funkobongrip/sprbms/hardware/can/canSlaveV05b.brd

## EAGLE design hardware/can/canSlaveV05b.brd (2016-02-18)

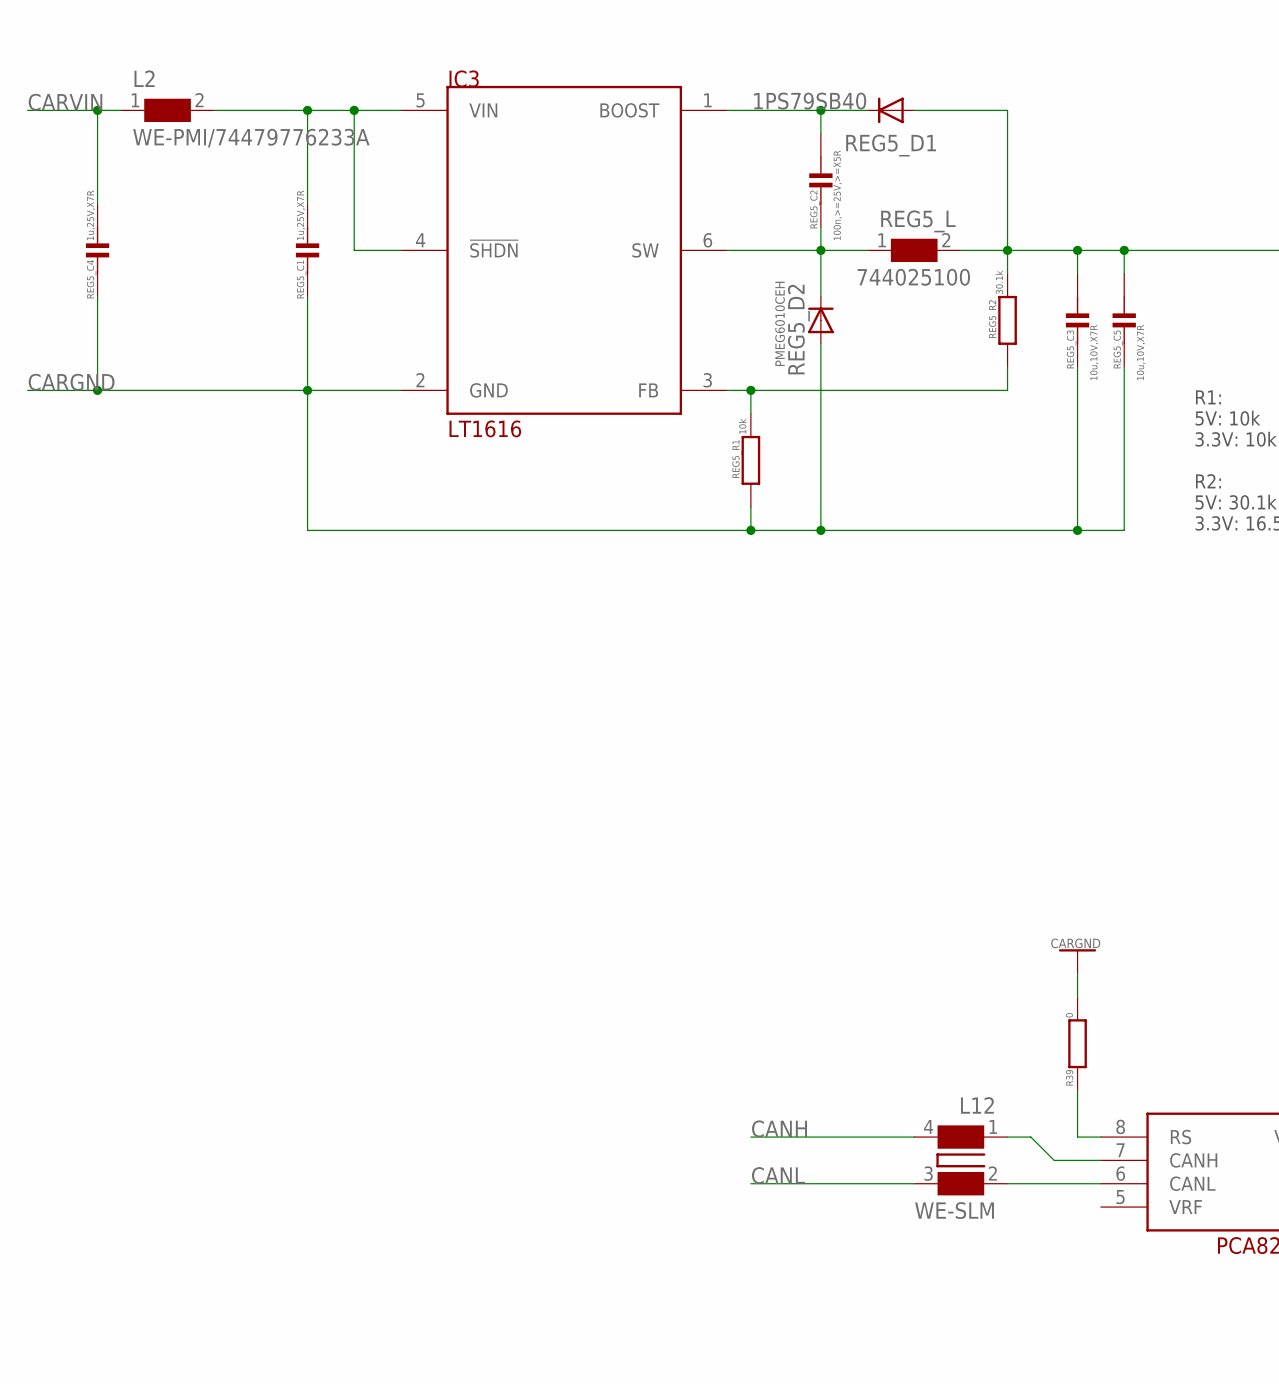
[picture p41: schematic canSlaveV05b.sch, sheet 1, part in row 1, column 1]

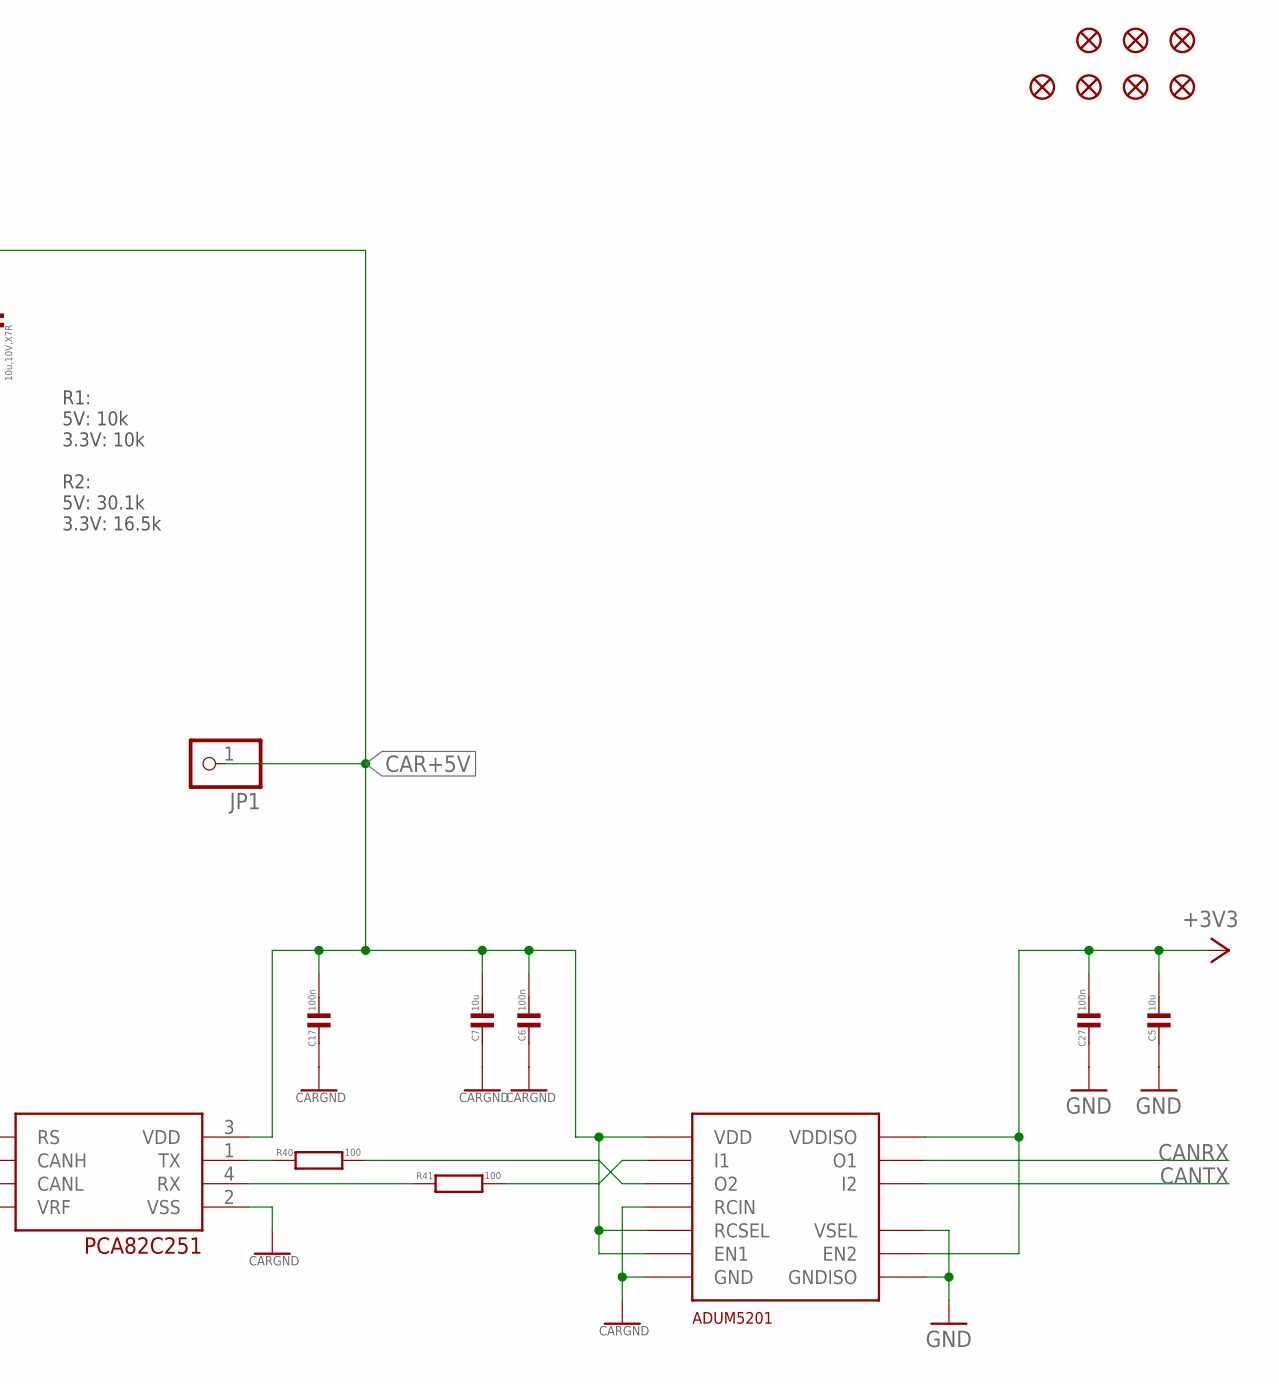
[picture p42: schematic canSlaveV05b.sch, sheet 1, part in row 1, column 2]

Parts:
C5, C7: 10u; C0603
C6, C17, C27: 100n; C0402
FID2, FID3, FID4, FID7, FID8, FID9, FID10: FIDUCIAL""; FIDUCIAL_1MM
IC3: LT1616; SOT23-6
IC5: PCA82C251; SO-8
JP1: PINHD-1X1; 1X01
L2: WE-PMI/74479776233A; WE-PMI_0806
L12: WE-SLM
R39: 0; R0402
R40, R41: 100; R0402
REG5_C1, REG5_C4: 1u,25V,X7R; C0805
REG5_C2: 100n,>=25V,>=X5R; C0402
REG5_C3, REG5_C5: 10u,10V,X7R; C0805
REG5_D1: 1PS79SB40; SOD523
REG5_D2: PMEG6010CEH; SOD123
REG5_L: 744025100; WE-TPC_2828
REG5_R1: 10k; R0402
REG5_R2: 30.1k; R0402
U$2: ADUM5201; SO16WB

Connections:
+3V3: C5.1, C27.1, U$2.P$10 (EN2), U$2.P$16 (VDDISO); also elsewhere on the board
BOOST1: IC3.1 (BOOST), REG5_C2.1, REG5_D1.C
CANH: L12.4; also elsewhere on the board
CANL: L12.3 (2); also elsewhere on the board
CANRX: U$2.P$14 (O1); also elsewhere on the board
CANTX: U$2.P$13 (I2); also elsewhere on the board
CAR+5V: C6.1, C7.1, C17.1, IC5.3 (VDD), JP1.1, REG5_C3.1, REG5_C5.1, REG5_D1.A, REG5_L.2, REG5_R2.2, U$2.P$1 (VDD), U$2.P$6 (RCSEL), U$2.P$7 (EN1)
CARGND: C6.2, C7.2, C17.2, IC3.2 (GND), IC5.2 (VSS), R39.2, REG5_C1.2, REG5_C3.2, REG5_C4.2, REG5_C5.2, REG5_D2.2 (A), REG5_R1.1, U$2.P$2 (GND), U$2.P$5 (RCIN), U$2.P$8 (GND); also elsewhere on the board
CARVIN: L2.1, REG5_C4.1; also elsewhere on the board
CARVINFILT: IC3.4 (!SHDN), IC3.5 (VIN), L2.2, REG5_C1.1
CAR_CANRX: R41.2, U$2.P$3 (I1)
CAR_CANRX_T: IC5.4 (RX), R41.1
CAR_CANTX: R40.2, U$2.P$4 (O2)
CAR_CANTX_T: IC5.1 (TX), R40.1
FB1: IC3.3 (FB), REG5_R1.2, REG5_R2.1
GND: C5.2, C27.2, U$2.P$9 (GNDISO), U$2.P$11 (VSEL), U$2.P$15 (GNDISO); also elsewhere on the board
unnamed: IC5.7 (CANH), L12.1 (3)
unnamed: IC5.6 (CANL), L12.2 (1)
RS1: IC5.8 (RS), R39.1
SW1: IC3.6 (SW), REG5_C2.2, REG5_D2.1 (C), REG5_L.1

Notes on the sheet:
R1: 5V: 10k 3.3V: 10k R2: 5V: 30.1k 3.3V: 16.5k

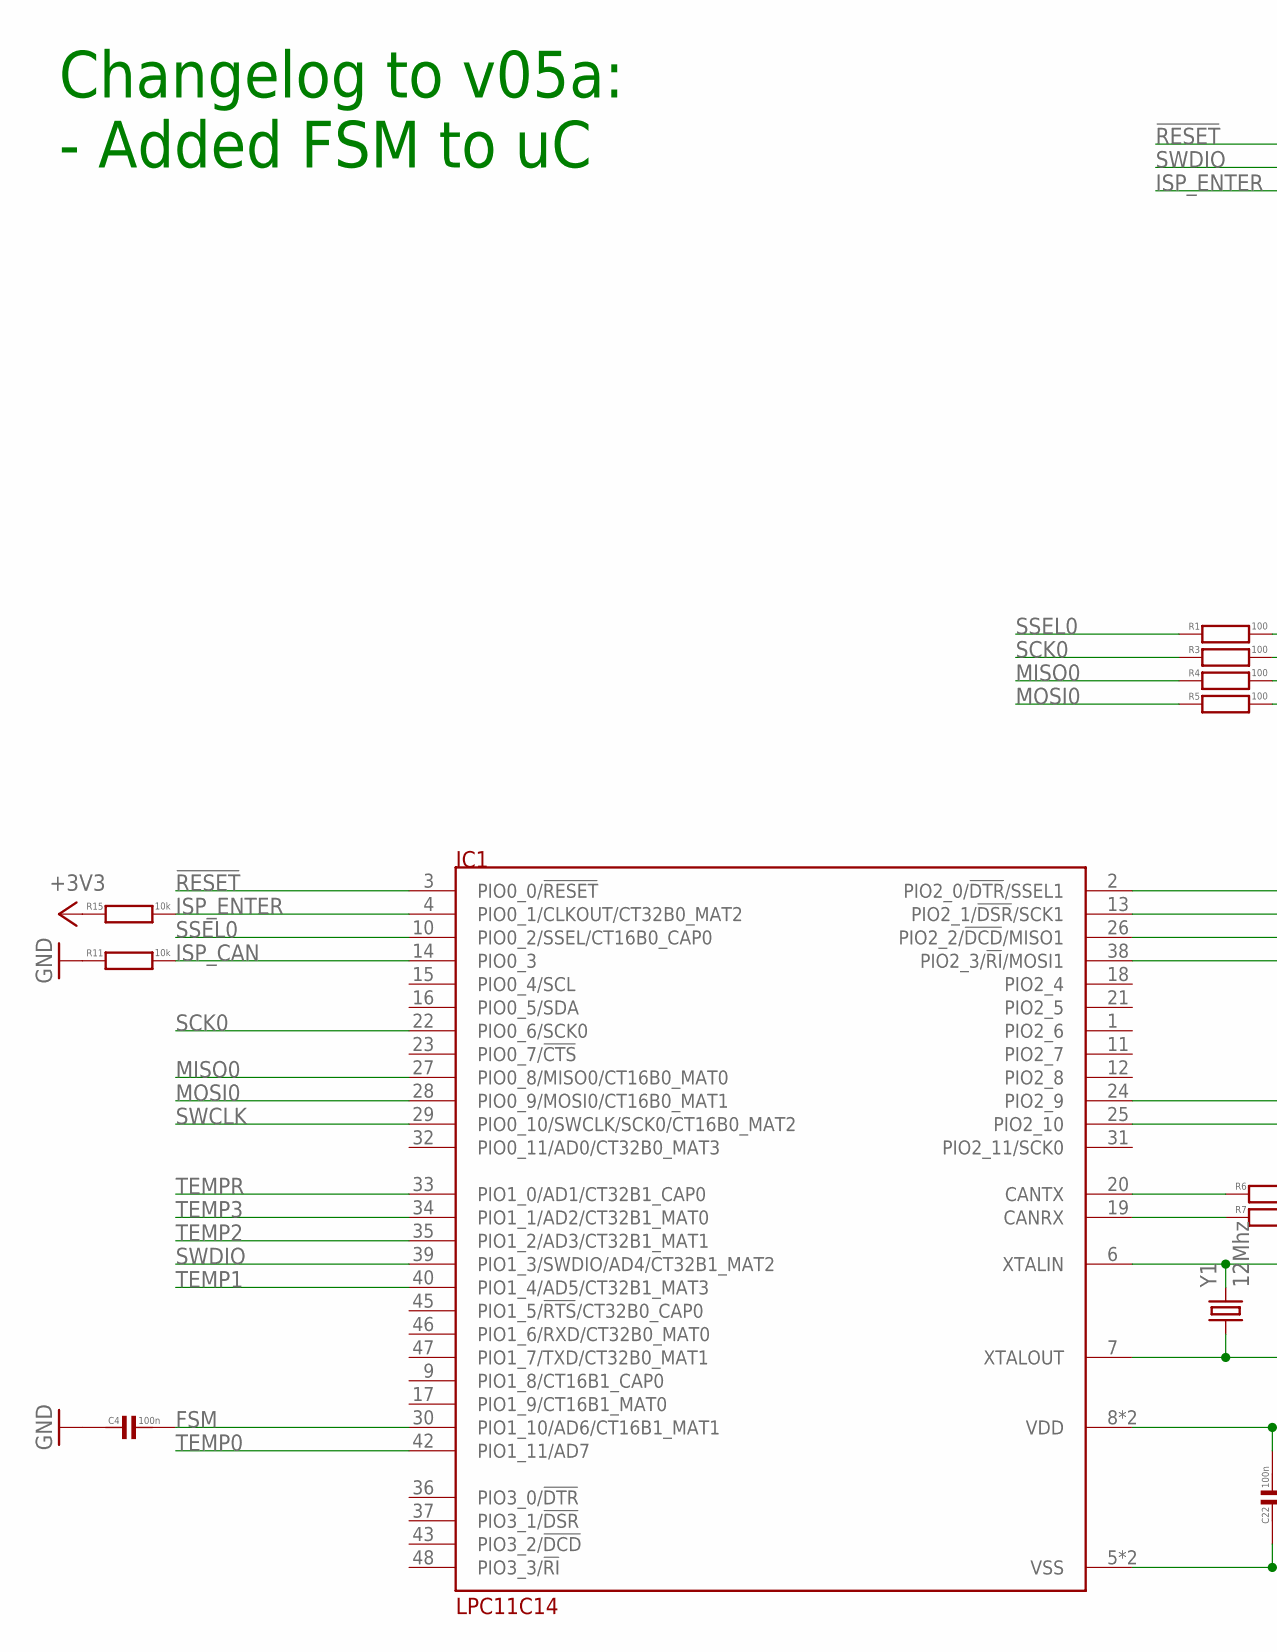
[picture p43: schematic canSlaveV05b.sch, sheet 2, part in row 1, column 1]

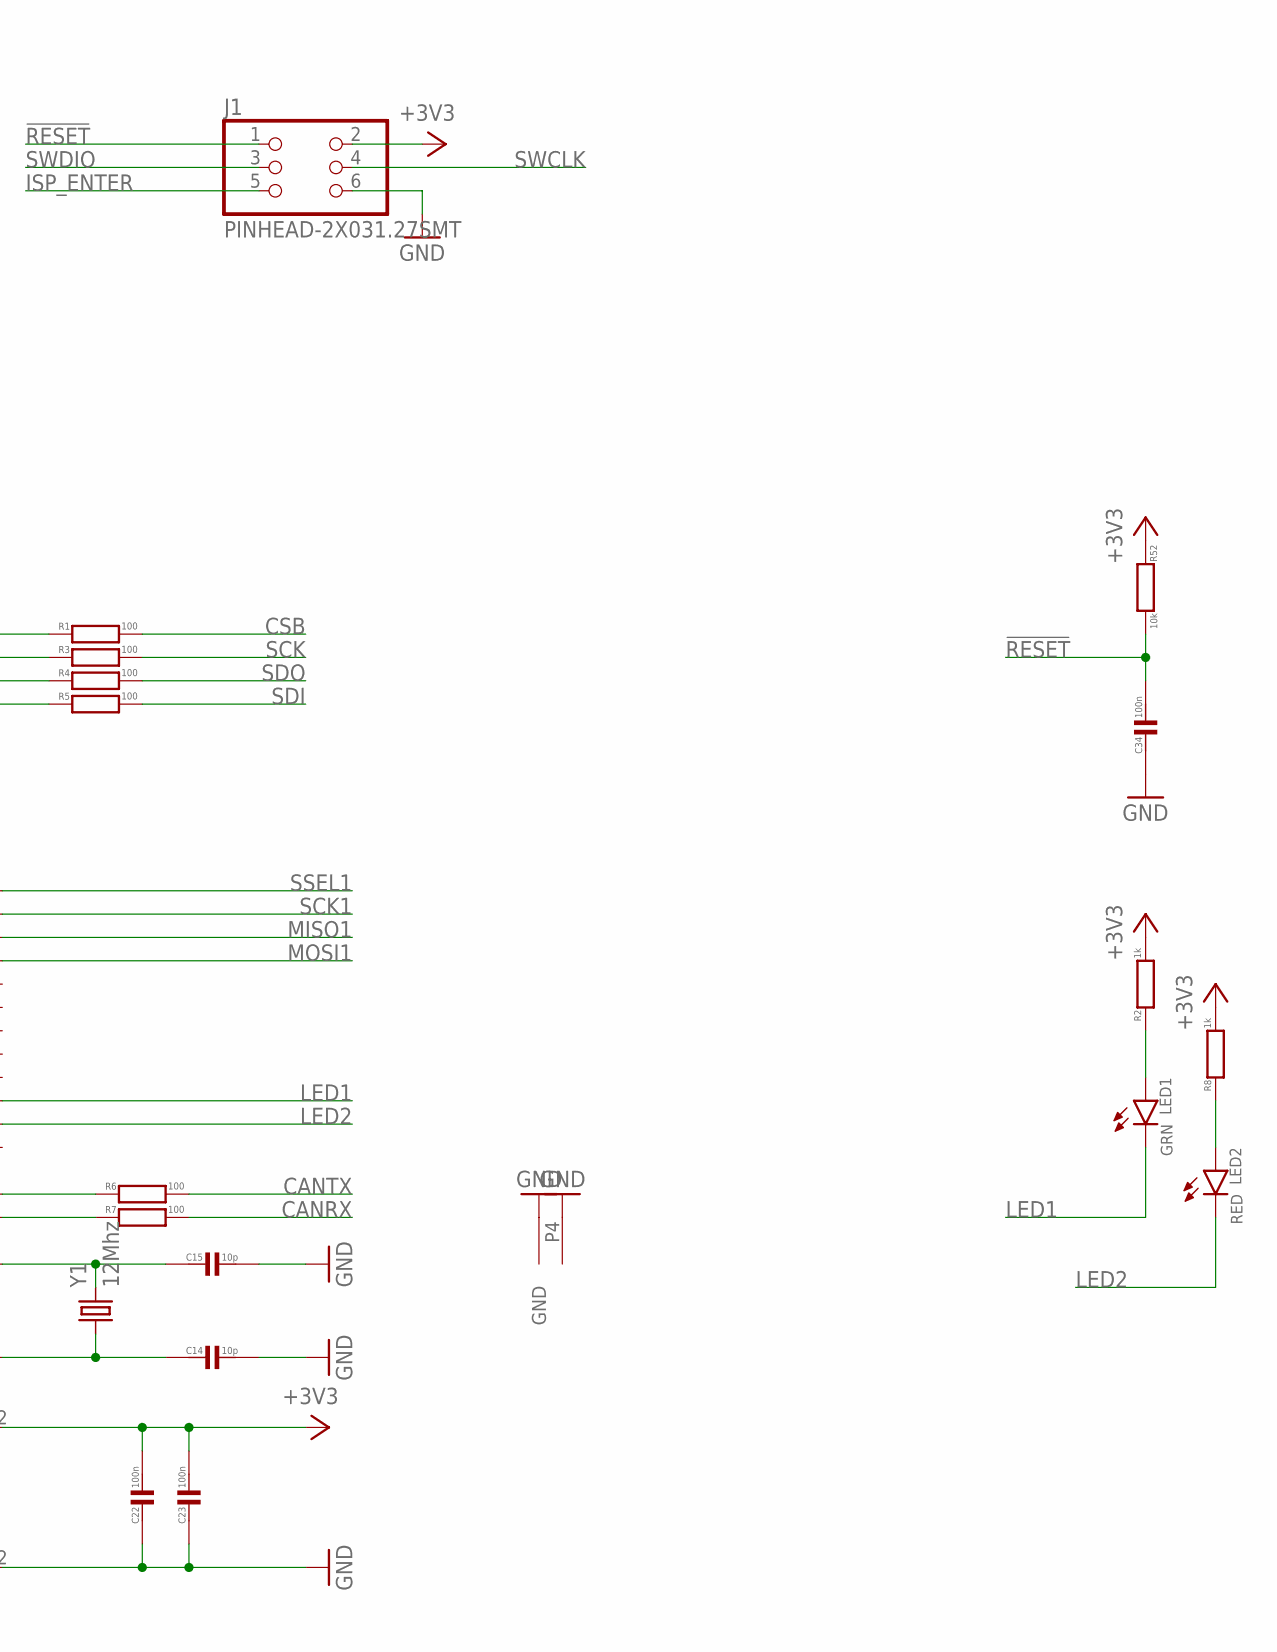
[picture p44: schematic canSlaveV05b.sch, sheet 2, part in row 1, column 2]

Parts:
C4, C22, C23, C34: 100n; C0402
C14, C15: 10p; C0402
IC1: LPC11C14; LQFP48
J1: PINHEAD-2X031.27SMT; 2X03_1.27MM_SMT
LED1: GRN; CHIPLED_0603
LED2: RED; CHIPLED_0603
R1, R3, R4, R5, R6, R7: 100; R0402
R2, R8: 1k; R0402
R11, R15, R52: 10k; R0402
Y1: 12Mhz; MT

Connections:
!RESET: C34.1, IC1.3 (PIO0_0/!RESET), J1.1, R52.2
+3V3: C22.1, C23.1, IC1.8 (VDD), IC1.44 (VDD), J1.2, R2.2, R8.2, R15.1, R52.1; also elsewhere on the board
CANRX: R7.2; also elsewhere on the board
CANRX_U_L: IC1.19 (CANRX), R7.1
CANTX: R6.2; also elsewhere on the board
CANTX_U_L: IC1.20 (CANTX), R6.1
CSB: R1.2; also elsewhere on the board
FSM: C4.1, IC1.30 (PIO1_10/AD6/CT16B1_MAT1); also elsewhere on the board
GND: C4.2, C14.1, C15.1, C22.2, C23.2, C34.2, IC1.5 (VSS), IC1.41 (VSS), J1.6, R11.1, Y1.P2 (GND), Y1.P4 (GND1); also elsewhere on the board
ISP_CAN: IC1.14 (PIO0_3), R11.2
ISP_ENTER: IC1.4 (PIO0_1/CLKOUT/CT32B0_MAT2), J1.5, R15.2
LED1: IC1.24 (PIO2_9), LED1.C
LED2: IC1.25 (PIO2_10), LED2.C
MISO0: IC1.27 (PIO0_8/MISO0/CT16B0_MAT0), R4.1
MISO1: IC1.26 (PIO2_2/!DCD!/MISO1)
MOSI0: IC1.28 (PIO0_9/MOSI0/CT16B0_MAT1), R5.1
MOSI1: IC1.38 (PIO2_3/!RI!/MOSI1)
unnamed: LED2.A, R8.1
unnamed: LED1.A, R2.1
SCK: R3.2; also elsewhere on the board
SCK0: IC1.22 (PIO0_6/SCK0), R3.1
SCK1: IC1.13 (PIO2_1/!DSR!/SCK1)
SDI: R5.2; also elsewhere on the board
SDO: R4.2; also elsewhere on the board
SSEL0: IC1.10 (PIO0_2/SSEL/CT16B0_CAP0), R1.1
SSEL1: IC1.2 (PIO2_0/!DTR!/SSEL1)
SWCLK: IC1.29 (PIO0_10/SWCLK/SCK0/CT16B0_MAT2), J1.4
SWDIO: IC1.39 (PIO1_3/SWDIO/AD4/CT32B1_MAT2), J1.3
TEMP0: IC1.42 (PIO1_11/AD7); also elsewhere on the board
TEMP1: IC1.40 (PIO1_4/AD5/CT32B1_MAT3); also elsewhere on the board
TEMP2: IC1.35 (PIO1_2/AD3/CT32B1_MAT1); also elsewhere on the board
TEMP3: IC1.34 (PIO1_1/AD2/CT32B1_MAT0); also elsewhere on the board
TEMPR: IC1.33 (PIO1_0/AD1/CT32B1_CAP0); also elsewhere on the board
XTALIN: C15.2, IC1.6 (XTALIN), Y1.P3 (2)
XTALOUT: C14.2, IC1.7 (XTALOUT), Y1.P1 (1)

Notes on the sheet:
Changelog to v05a: - Added FSM to uC
