funkobongrip/sprbms/hardware/can/canSlaveV05b.brd

## EAGLE design hardware/can/canSlaveV05b.brd (continued)

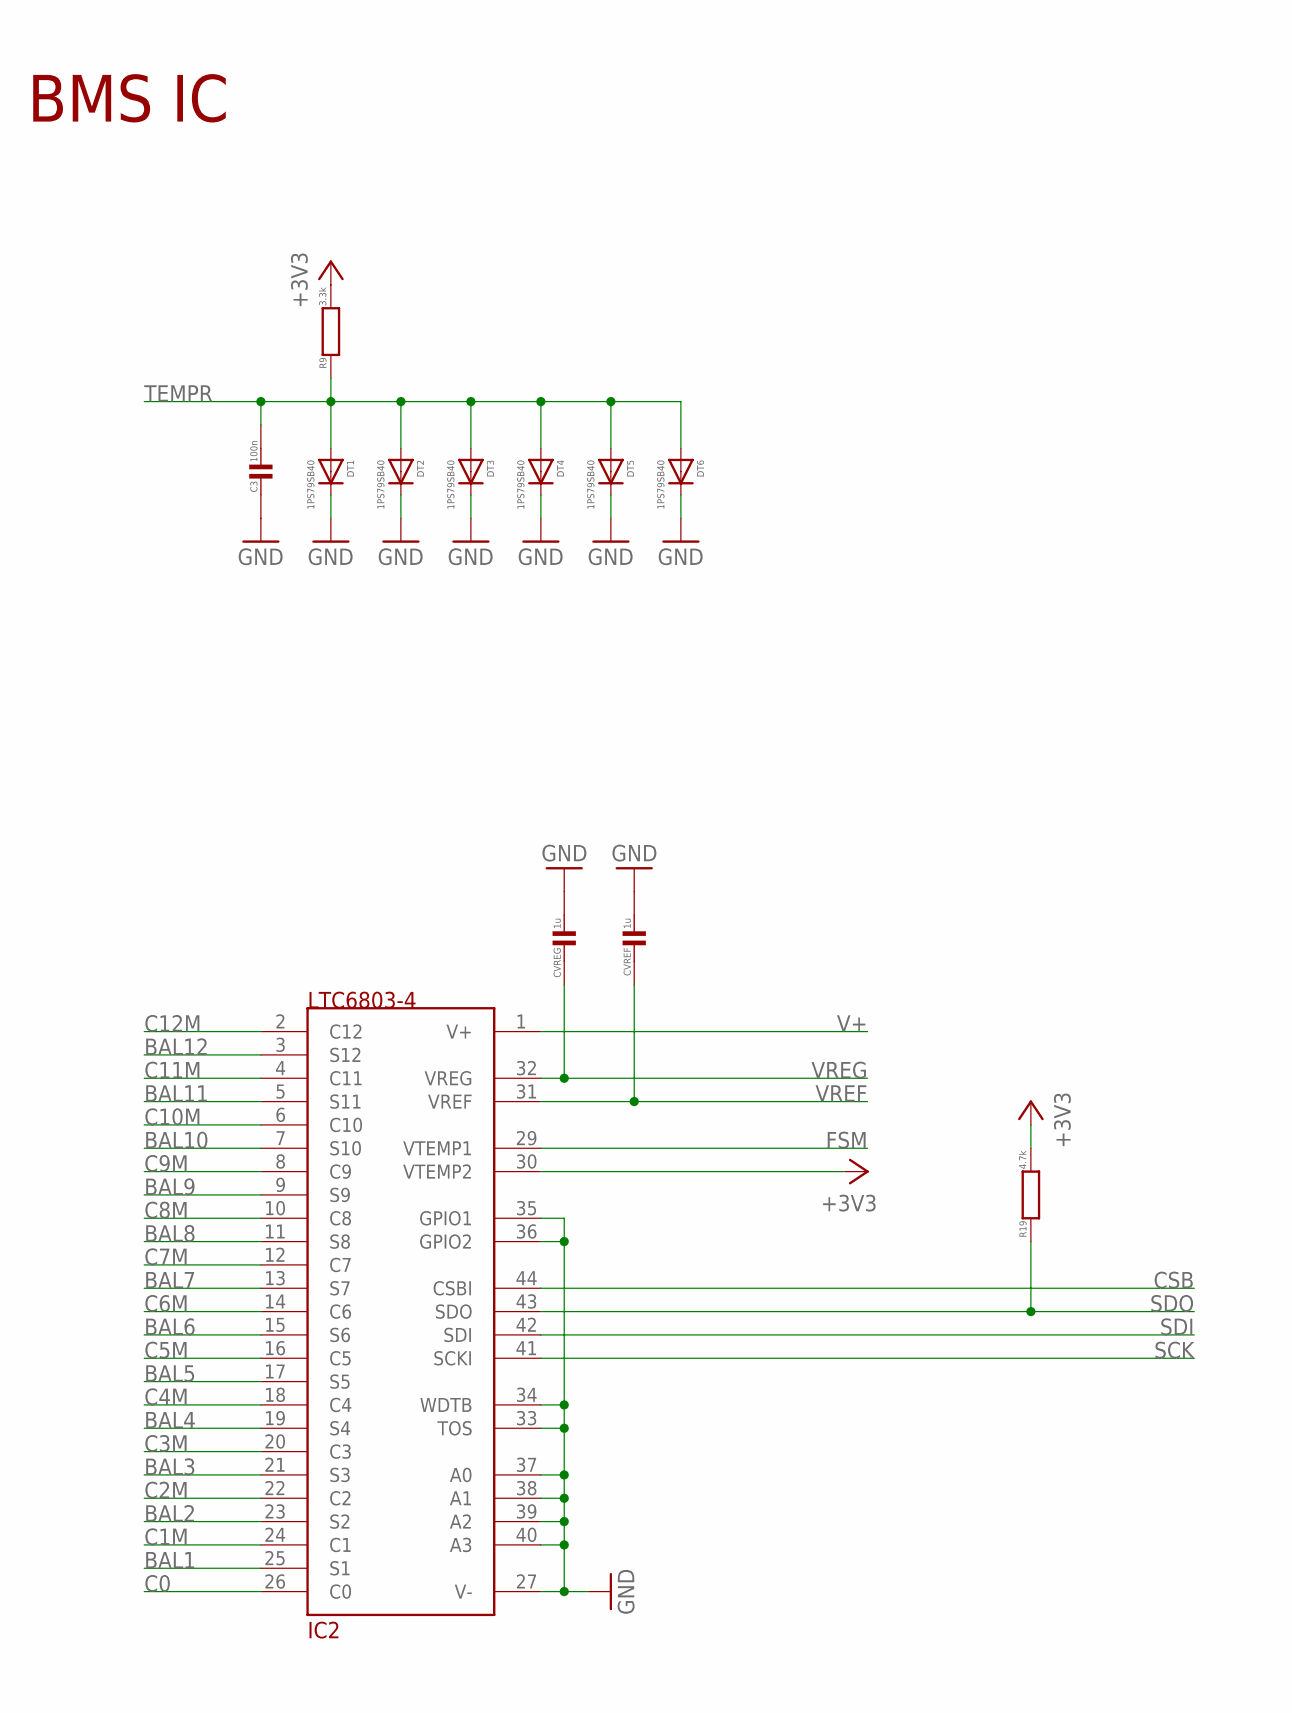
[picture p45: schematic canSlaveV05b.sch, sheet 3, part in row 1, column 1]

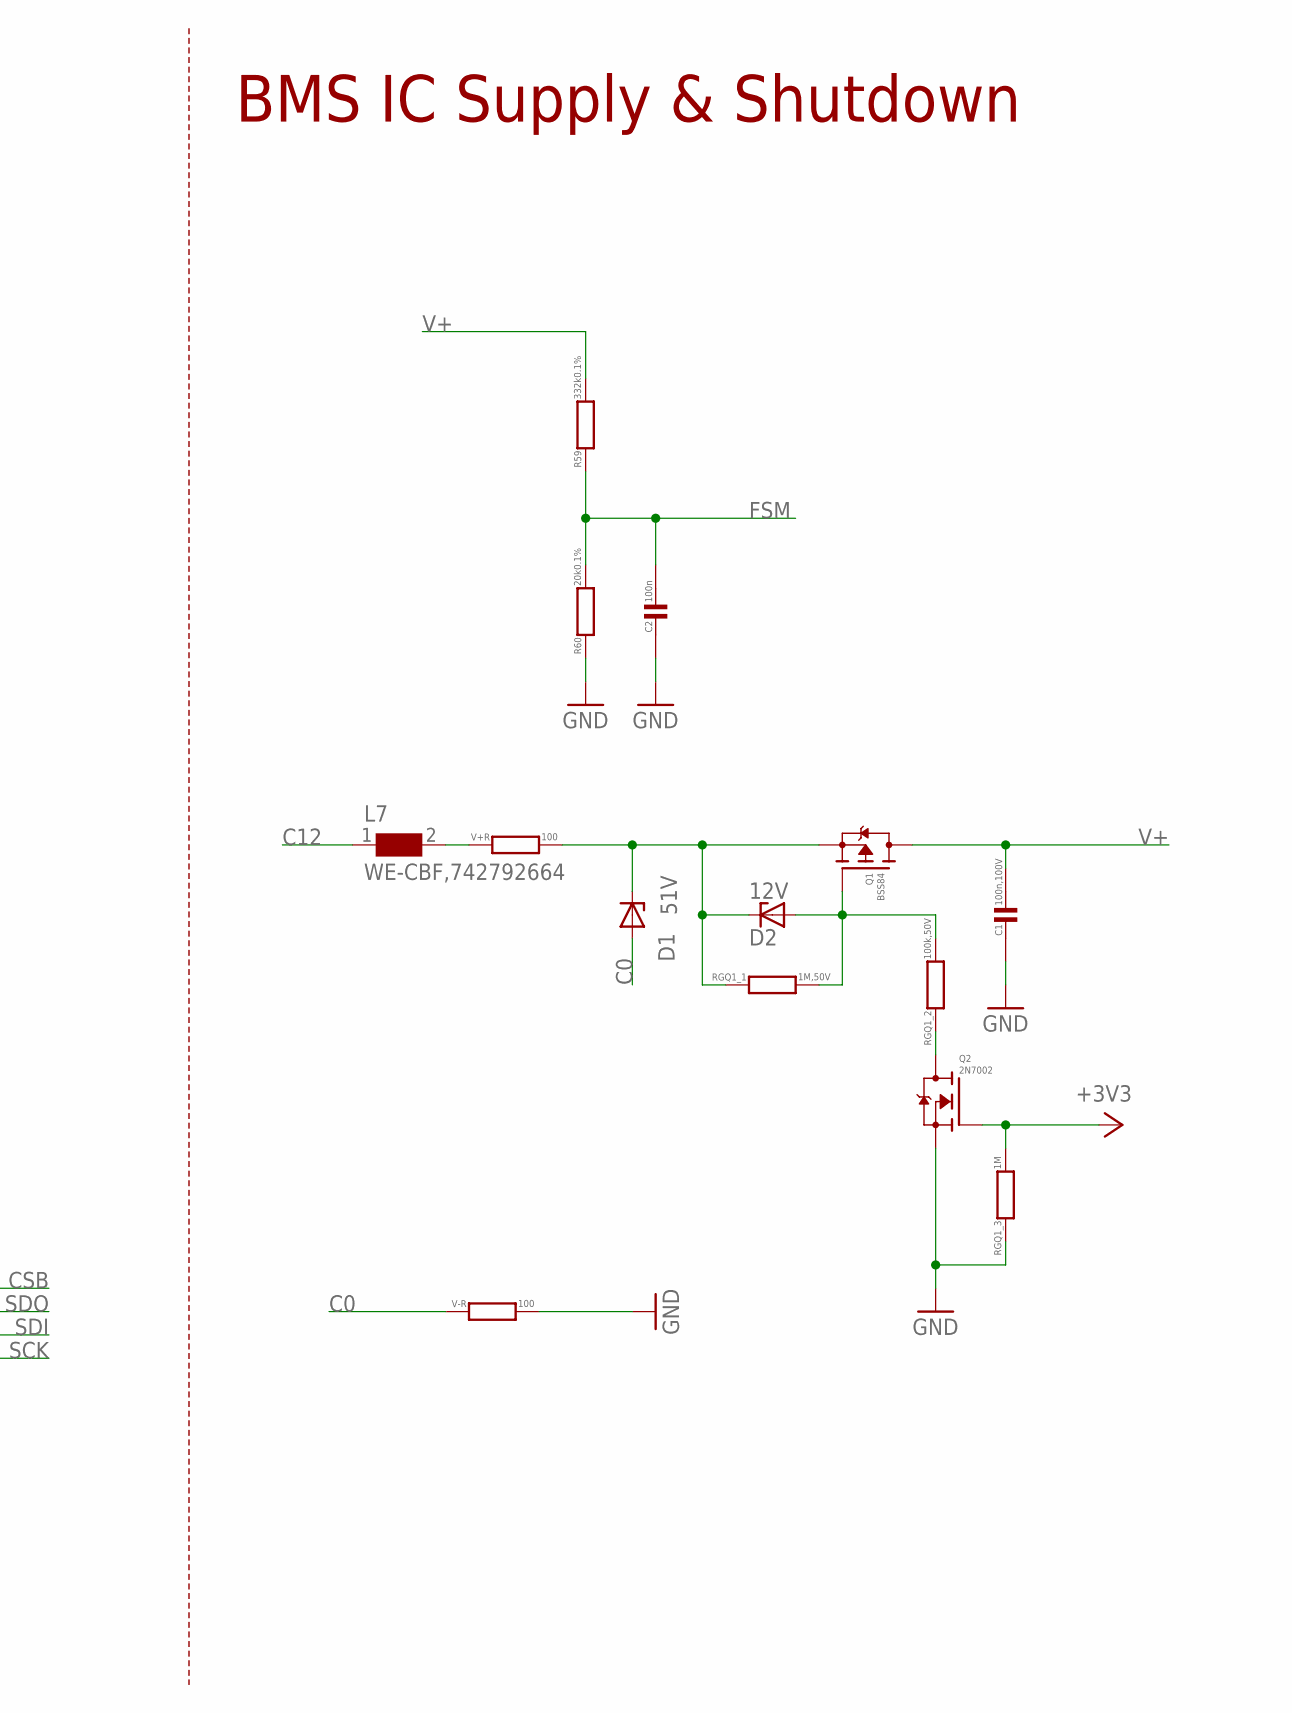
[picture p46: schematic canSlaveV05b.sch, sheet 3, part in row 1, column 2]

Parts:
C1: 100n,100V; C0603
C2, C3: 100n; C0402
CVREF: 1u; C0402
CVREG: 1u; C0402
D1: 51V; SOD323-L
D2: 12V; SOD323-L
DT1, DT2, DT3, DT4, DT5, DT6: 1PS79SB40; SOD523
IC2: LTC6803-4; 44SSOP
L7: WE-CBF,742792664; 0603
Q1: BSS84; SOT23
Q2: 2N7002; SOT23
R9: 3.3k; R0603
R19: 4.7k; R0402
R59: 332k0.1%; R0603
R60: 20k0.1%; R0402
RGQ1_1: 1M,50V; R0603
RGQ1_2: 100k,50V; R0603
RGQ1_3: 1M; R0402
V+R: 100; R0603
V-R: 100; R0603

Connections:
+3V3: IC2.30 (VTEMP2), Q2.1 (G), R9.2, R19.2, RGQ1_3.2; also elsewhere on the board
BAL1: IC2.25 (S1); also elsewhere on the board
BAL2: IC2.23 (S2); also elsewhere on the board
BAL3: IC2.21 (S3); also elsewhere on the board
BAL4: IC2.19 (S4); also elsewhere on the board
BAL5: IC2.17 (S5); also elsewhere on the board
BAL6: IC2.15 (S6); also elsewhere on the board
BAL7: IC2.13 (S7); also elsewhere on the board
BAL8: IC2.11 (S8); also elsewhere on the board
BAL9: IC2.9 (S9); also elsewhere on the board
BAL10: IC2.7 (S10); also elsewhere on the board
BAL11: IC2.5 (S11); also elsewhere on the board
BAL12: IC2.3 (S12); also elsewhere on the board
C0: D1.A, IC2.26 (C0), V-R.1; also elsewhere on the board
C1M: IC2.24 (C1); also elsewhere on the board
C2M: IC2.22 (C2); also elsewhere on the board
C3M: IC2.20 (C3); also elsewhere on the board
C4M: IC2.18 (C4); also elsewhere on the board
C5M: IC2.16 (C5); also elsewhere on the board
C6M: IC2.14 (C6); also elsewhere on the board
C7M: IC2.12 (C7); also elsewhere on the board
C8M: IC2.10 (C8); also elsewhere on the board
C9M: IC2.8 (C9); also elsewhere on the board
C10M: IC2.6 (C10); also elsewhere on the board
C11M: IC2.4 (C11); also elsewhere on the board
C12: L7.1; also elsewhere on the board
C12M: IC2.2 (C12); also elsewhere on the board
CSB: IC2.44 (CSBI); also elsewhere on the board
FSM: C2.1, IC2.29 (VTEMP1), R59.1, R60.2; also elsewhere on the board
GND: C1.2, C2.2, C3.2, CVREF.1, CVREG.1, DT1.C, DT2.C, DT3.C, DT4.C, DT5.C, DT6.C, IC2.27 (V-), IC2.33 (TOS), IC2.34 (WDTB), IC2.35 (GPIO1), IC2.36 (GPIO2), IC2.37 (A0), IC2.38 (A1), IC2.39 (A2), IC2.40 (A3), Q2.2 (S), R60.1, RGQ1_3.1, V-R.2; also elsewhere on the board
unnamed: Q2.3 (D), RGQ1_2.1
unnamed: L7.2, V+R.1
Q1G: D2.A, Q1.1 (G), RGQ1_1.2, RGQ1_2.2
SCK: IC2.41 (SCKI); also elsewhere on the board
SDI: IC2.42 (SDI); also elsewhere on the board
SDO: IC2.43 (SDO), R19.1; also elsewhere on the board
TEMPR: C3.1, DT1.A, DT2.A, DT3.A, DT4.A, DT5.A, DT6.A, R9.1; also elsewhere on the board
V+: C1.1, IC2.1 (V+), Q1.3 (D), R59.2
V+S: D1.C, D2.C, Q1.2 (S), RGQ1_1.1, V+R.2
VREF: CVREF.2, IC2.31 (VREF)
VREG: CVREG.2, IC2.32 (VREG)

Notes on the sheet:
BMS IC
BMS IC Supply & Shutdown

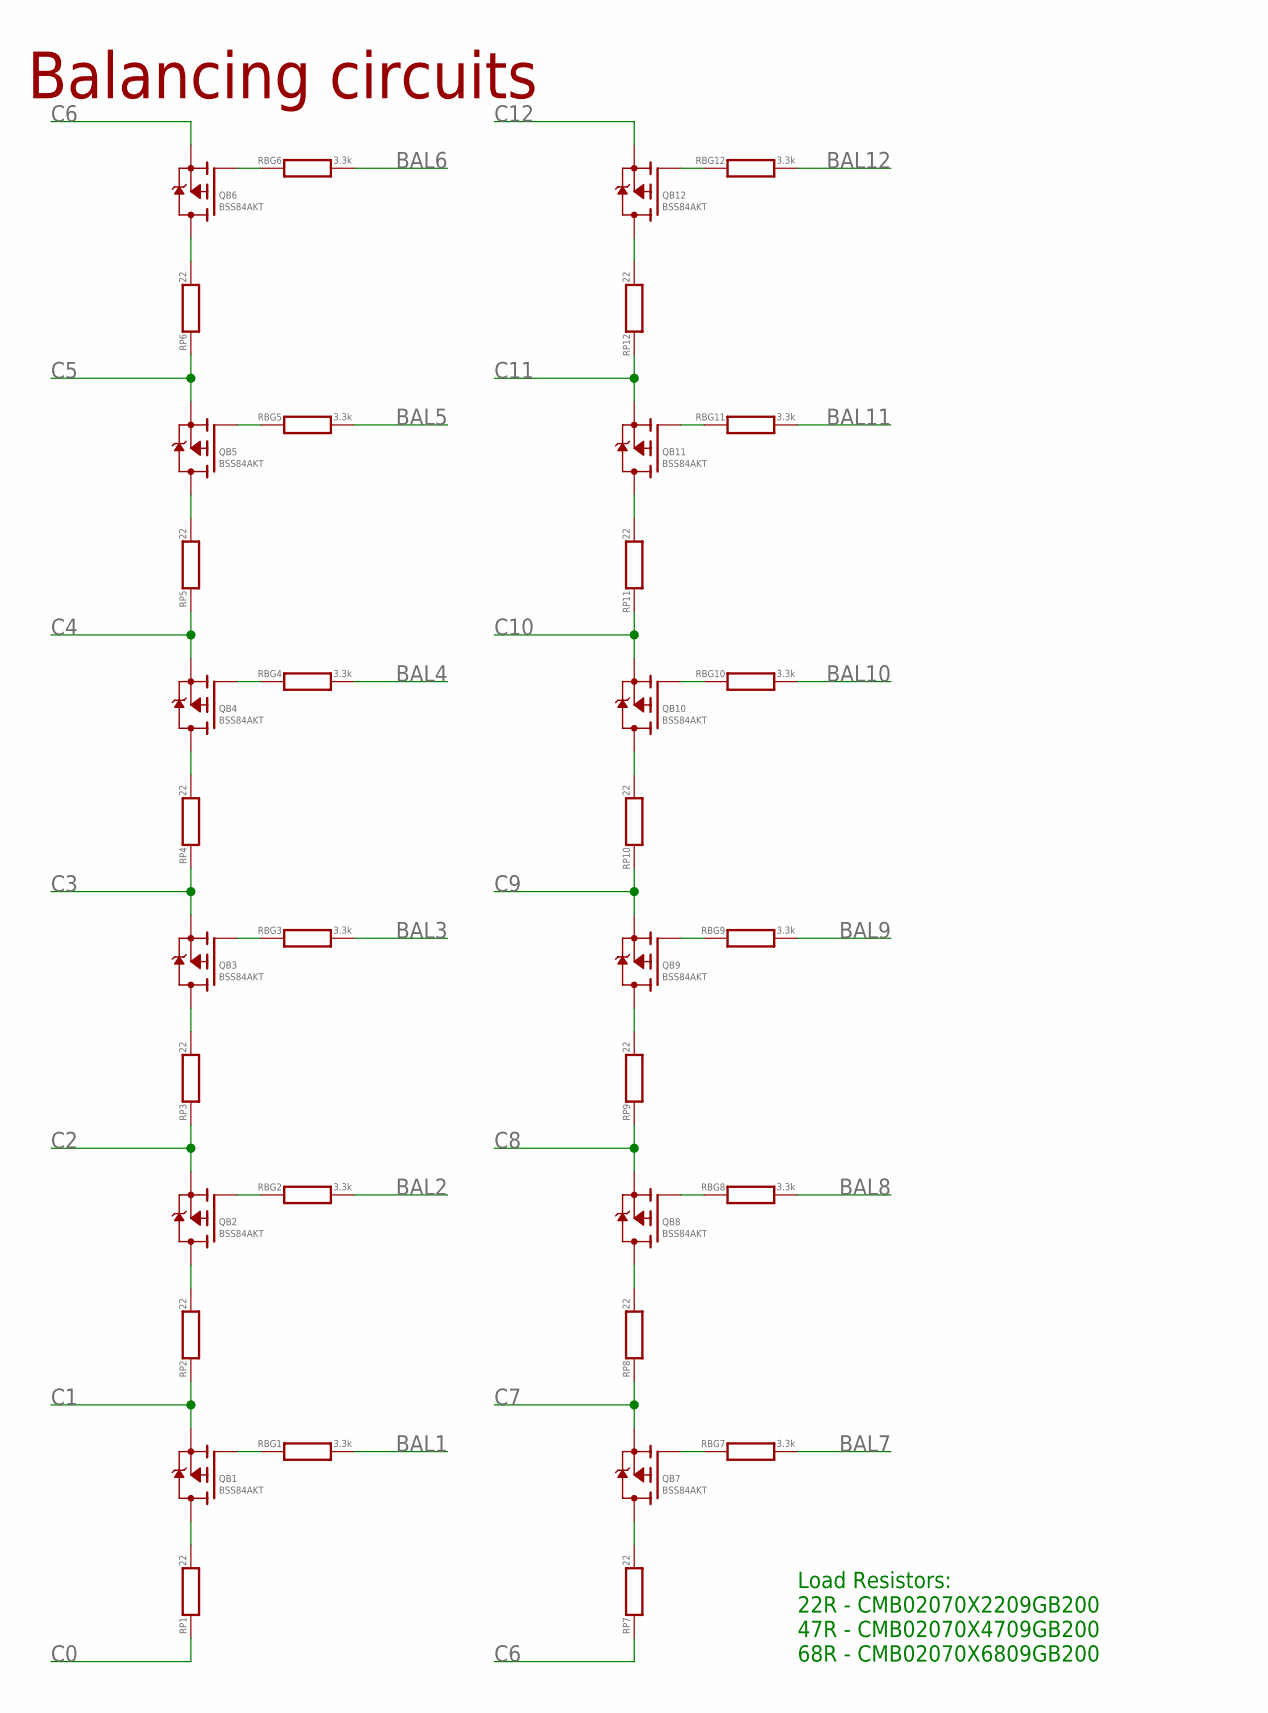
[picture p47: schematic canSlaveV05b.sch, sheet 4, part in row 1, column 1]

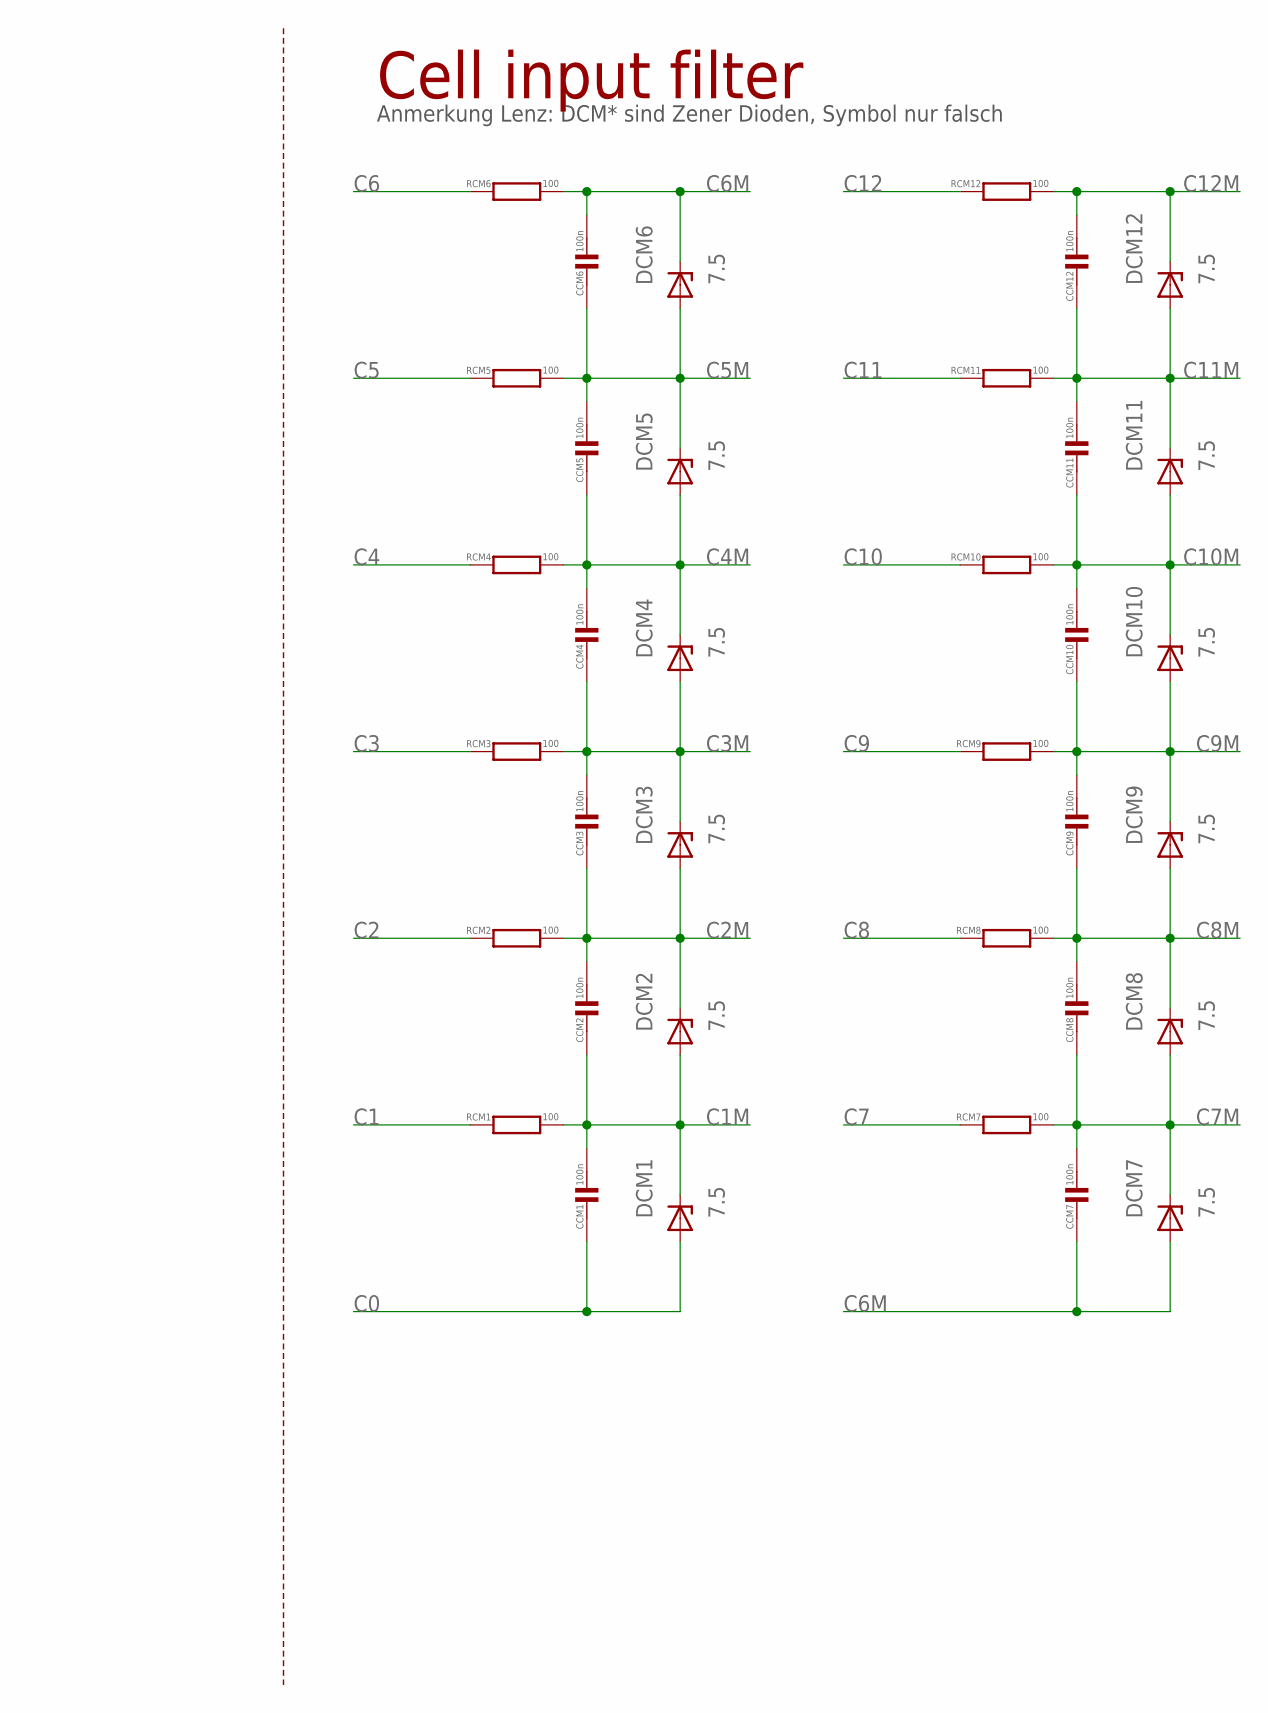
[picture p48: schematic canSlaveV05b.sch, sheet 4, part in row 1, column 2]

Parts:
CCM1, CCM2, CCM3, CCM4, CCM5, CCM6, CCM7, CCM8, CCM9, CCM10, CCM11, CCM12: 100n; C0402
DCM1, DCM2, DCM3, DCM4, DCM5, DCM6, DCM7, DCM8, DCM9, DCM10, DCM11, DCM12: 7.5; SOD523
QB1, QB2, QB3, QB4, QB5, QB6, QB7, QB8, QB9, QB10, QB11, QB12: BSS84AKT; SOT416
RBG1, RBG2, RBG3, RBG4, RBG5, RBG6, RBG7, RBG8, RBG9, RBG10, RBG11, RBG12: 3.3k; R0402
RCM1, RCM2, RCM3, RCM4, RCM5, RCM6, RCM7, RCM8, RCM9, RCM10, RCM11, RCM12: 100; R0402
RP1, RP2, RP3, RP4, RP5, RP6, RP7, RP8, RP9, RP10, RP11, RP12: 22; MINI_MELF-0207R

Connections:
BAL1: RBG1.2; also elsewhere on the board
BAL2: RBG2.2; also elsewhere on the board
BAL3: RBG3.2; also elsewhere on the board
BAL4: RBG4.2; also elsewhere on the board
BAL5: RBG5.2; also elsewhere on the board
BAL6: RBG6.2; also elsewhere on the board
BAL7: RBG7.2; also elsewhere on the board
BAL8: RBG8.2; also elsewhere on the board
BAL9: RBG9.2; also elsewhere on the board
BAL10: RBG10.2; also elsewhere on the board
BAL11: RBG11.2; also elsewhere on the board
BAL12: RBG12.2; also elsewhere on the board
C0: CCM1.2, DCM1.A, RP1.1; also elsewhere on the board
C1: QB1.2 (S), RCM1.1, RP2.1; also elsewhere on the board
C1M: CCM1.1, CCM2.2, DCM1.C, DCM2.A, RCM1.2; also elsewhere on the board
C2: QB2.2 (S), RCM2.1, RP3.1; also elsewhere on the board
C2M: CCM2.1, CCM3.2, DCM2.C, DCM3.A, RCM2.2; also elsewhere on the board
C3: QB3.2 (S), RCM3.1, RP4.1; also elsewhere on the board
C3M: CCM3.1, CCM4.2, DCM3.C, DCM4.A, RCM3.2; also elsewhere on the board
C4: QB4.2 (S), RCM4.1, RP5.1; also elsewhere on the board
C4M: CCM4.1, CCM5.2, DCM4.C, DCM5.A, RCM4.2; also elsewhere on the board
C5: QB5.2 (S), RCM5.1, RP6.1; also elsewhere on the board
C5M: CCM5.1, CCM6.2, DCM5.C, DCM6.A, RCM5.2; also elsewhere on the board
C6: QB6.2 (S), RCM6.1, RP7.1; also elsewhere on the board
C6M: CCM6.1, CCM7.2, DCM6.C, DCM7.A, RCM6.2; also elsewhere on the board
C7: QB7.2 (S), RCM7.1, RP8.1; also elsewhere on the board
C7M: CCM7.1, CCM8.2, DCM7.C, DCM8.A, RCM7.2; also elsewhere on the board
C8: QB8.2 (S), RCM8.1, RP9.1; also elsewhere on the board
C8M: CCM8.1, CCM9.2, DCM8.C, DCM9.A, RCM8.2; also elsewhere on the board
C9: QB9.2 (S), RCM9.1, RP10.1; also elsewhere on the board
C9M: CCM9.1, CCM10.2, DCM9.C, DCM10.A, RCM9.2; also elsewhere on the board
C10: QB10.2 (S), RCM10.1, RP11.1; also elsewhere on the board
C10M: CCM10.1, CCM11.2, DCM10.C, DCM11.A, RCM10.2; also elsewhere on the board
C11: QB11.2 (S), RCM11.1, RP12.1; also elsewhere on the board
C11M: CCM11.1, CCM12.2, DCM11.C, DCM12.A, RCM11.2; also elsewhere on the board
C12: QB12.2 (S), RCM12.1; also elsewhere on the board
C12M: CCM12.1, DCM12.C, RCM12.2; also elsewhere on the board
CR1: QB1.3 (D), RP1.2
CR2: QB2.3 (D), RP2.2
CR3: QB3.3 (D), RP3.2
CR4: QB4.3 (D), RP4.2
CR5: QB5.3 (D), RP5.2
CR6: QB6.3 (D), RP6.2
CR7: QB7.3 (D), RP7.2
CR8: QB8.3 (D), RP8.2
CR9: QB9.3 (D), RP9.2
CR10: QB10.3 (D), RP10.2
CR11: QB11.3 (D), RP11.2
CR12: QB12.3 (D), RP12.2
QBG1: QB1.1 (G), RBG1.1
QBG2: QB2.1 (G), RBG2.1
QBG3: QB3.1 (G), RBG3.1
QBG4: QB4.1 (G), RBG4.1
QBG5: QB5.1 (G), RBG5.1
QBG6: QB6.1 (G), RBG6.1
QBG7: QB7.1 (G), RBG7.1
QBG8: QB8.1 (G), RBG8.1
QBG9: QB9.1 (G), RBG9.1
QBG10: QB10.1 (G), RBG10.1
QBG11: QB11.1 (G), RBG11.1
QBG12: QB12.1 (G), RBG12.1

Notes on the sheet:
Balancing circuits
Cell input filter
Anmerkung Lenz: DCM* sind Zener Dioden, Symbol nur falsch
Load Resistors: 22R - CMB02070X2209GB200 47R - CMB02070X4709GB200 68R - CMB02070X6809GB200

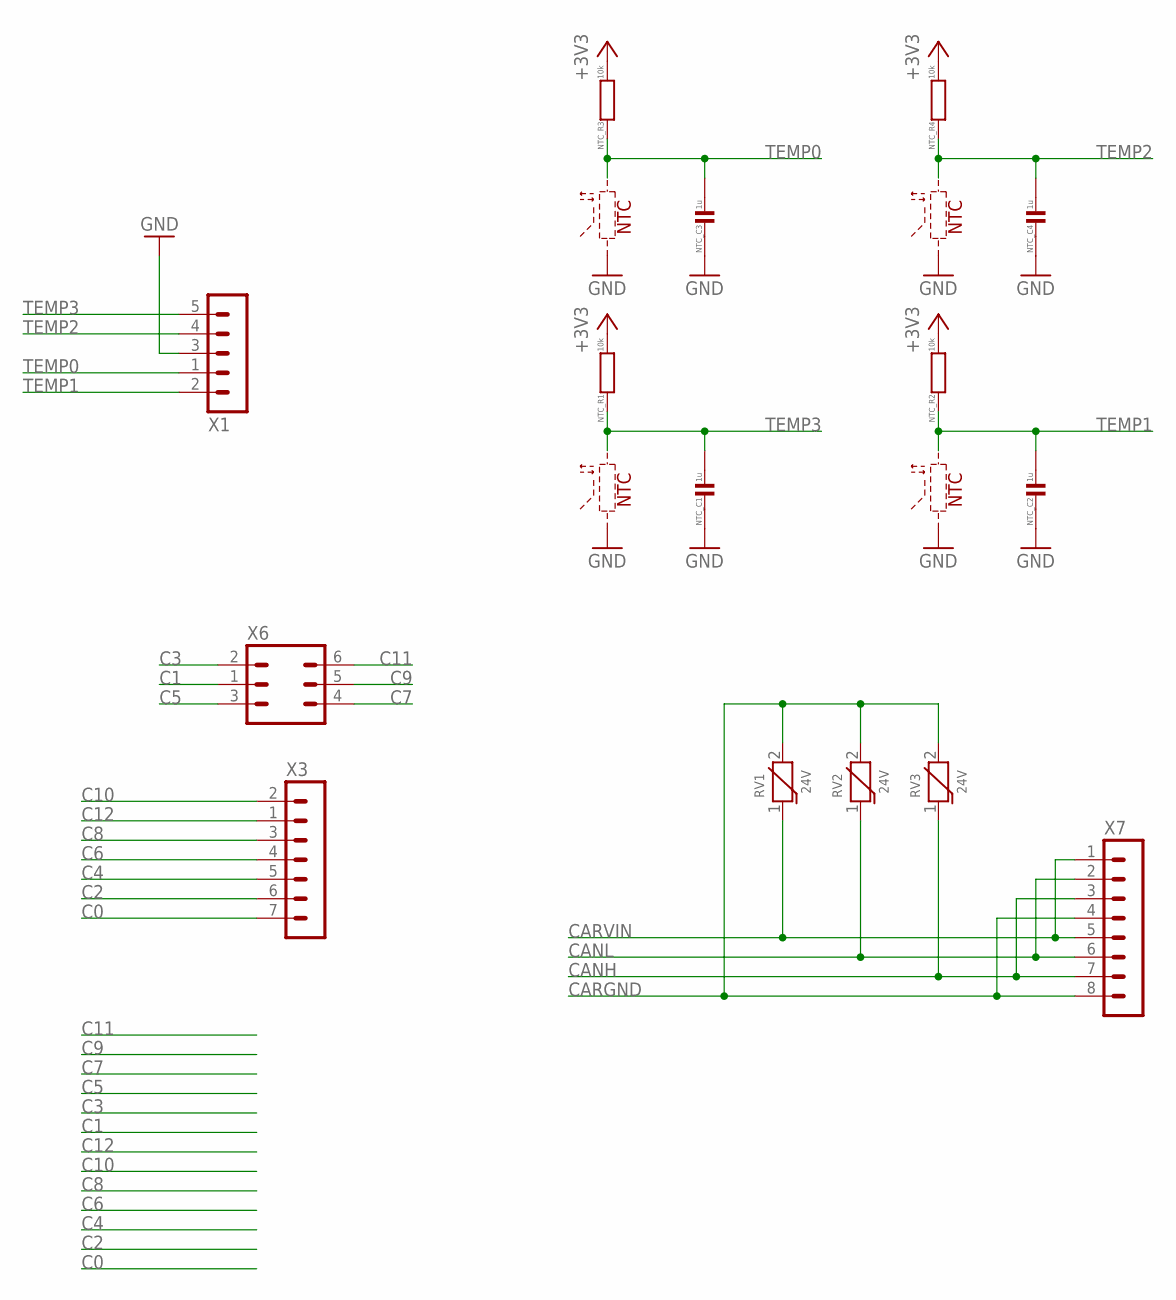
[picture p49: schematic canSlaveV05b.sch, sheet 5]

Parts:
NTC_C1, NTC_C2, NTC_C3, NTC_C4: 1u; C0402
NTC_R1, NTC_R2, NTC_R3, NTC_R4: 10k; R0402
RV1: 24V; R0805
RV2, RV3: 24V; R0603
X1: HEADER_POS5_43650-0509; 43650-0509
X3: HEADER_POS7_43650-0709; 43650-0709
X6: HEADER_POS6_43650-0609; 43650-0609
X7: HEADER_POS8_43045-0800; 43045-0800

Connections:
+3V3: NTC_R1.2, NTC_R2.2, NTC_R3.2, NTC_R4.2; also elsewhere on the board
C0: X3.7; also elsewhere on the board
C1: X6.1 (2); also elsewhere on the board
C2: X3.6; also elsewhere on the board
C3: X6.2 (1); also elsewhere on the board
C4: X3.5; also elsewhere on the board
C5: X6.3; also elsewhere on the board
C6: X3.4; also elsewhere on the board
C7: X6.4; also elsewhere on the board
C8: X3.3; also elsewhere on the board
C9: X6.5; also elsewhere on the board
C10: X3.2 (1); also elsewhere on the board
C11: X6.6; also elsewhere on the board
C12: X3.1 (2); also elsewhere on the board
CANH: RV3.1, X7.3, X7.7; also elsewhere on the board
CANL: RV2.1, X7.2, X7.6; also elsewhere on the board
CARGND: RV1.2, RV2.2, RV3.2, X7.4, X7.8; also elsewhere on the board
CARVIN: RV1.1, X7.1, X7.5; also elsewhere on the board
GND: NTC_C1.2, NTC_C2.2, NTC_C3.2, NTC_C4.2, X1.3; also elsewhere on the board
TEMP0: NTC_C3.1, NTC_R3.1, X1.1 (2); also elsewhere on the board
TEMP1: NTC_C2.1, NTC_R2.1, X1.2 (1); also elsewhere on the board
TEMP2: NTC_C4.1, NTC_R4.1, X1.4; also elsewhere on the board
TEMP3: NTC_C1.1, NTC_R1.1, X1.5; also elsewhere on the board

Notes on the sheet:
NTC

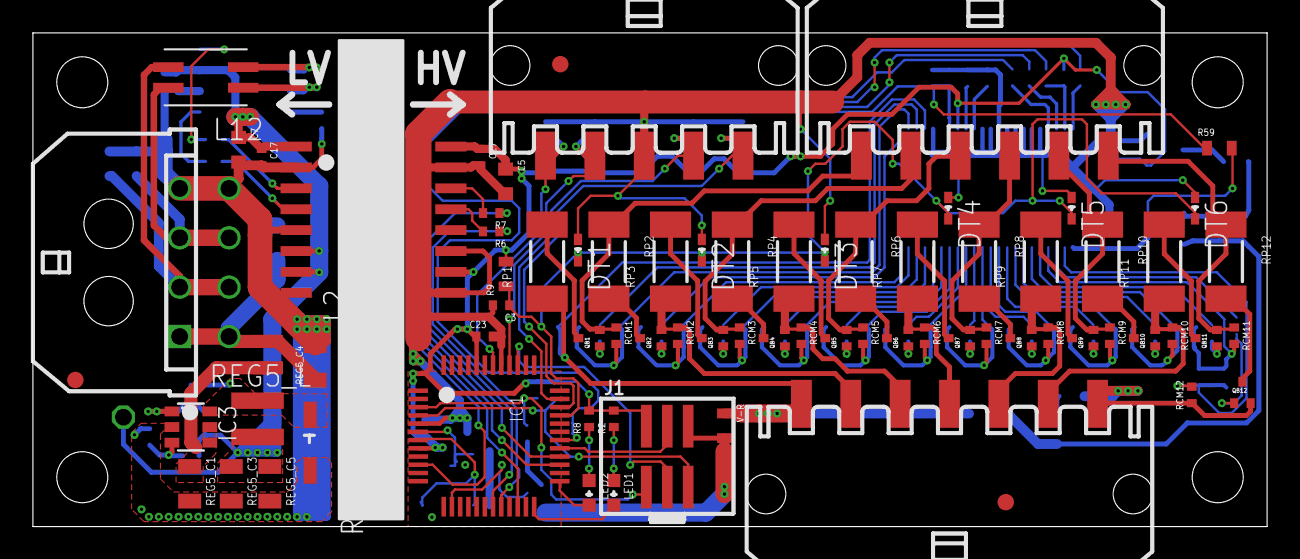
[picture p50: board canSlaveV05b.brd from above]

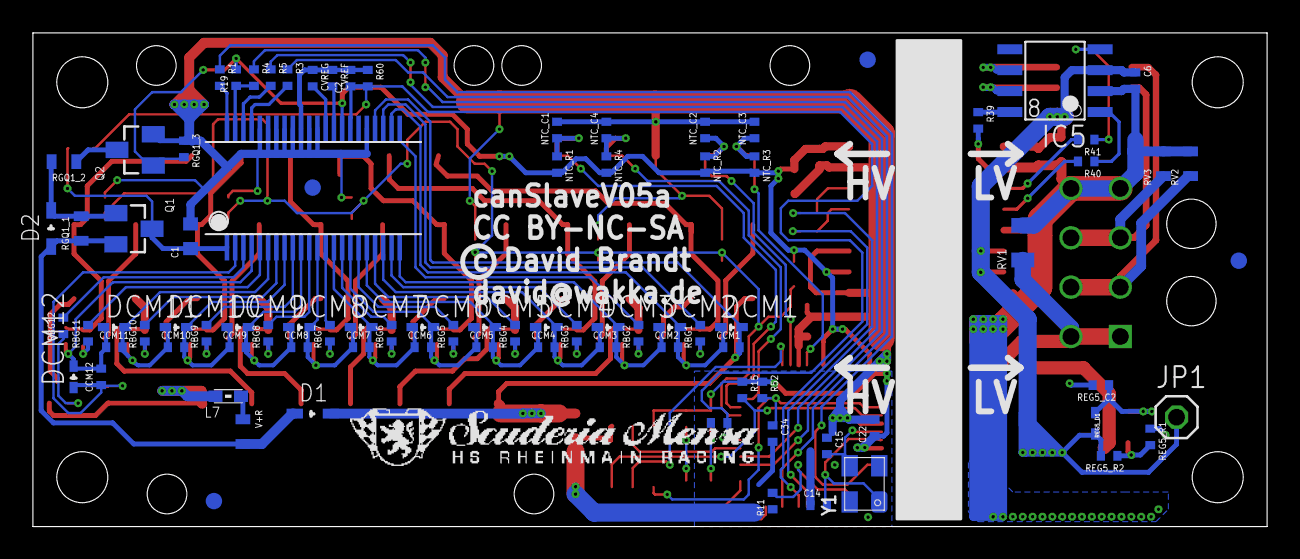
[picture p51: board canSlaveV05b.brd from below]

Board: 2 copper layers, 75.0 x 30.0 mm, 167 parts (90 on the bottom side), 115 nets.

Other parts of the board:
U$3: SMLOGOS_BSILK
