funkobongrip/sprbms/hardware/can/canSlaveV05 Abm.brd

## EAGLE design hardware/can/canSlaveV05 Abm.brd (2016-02-18)

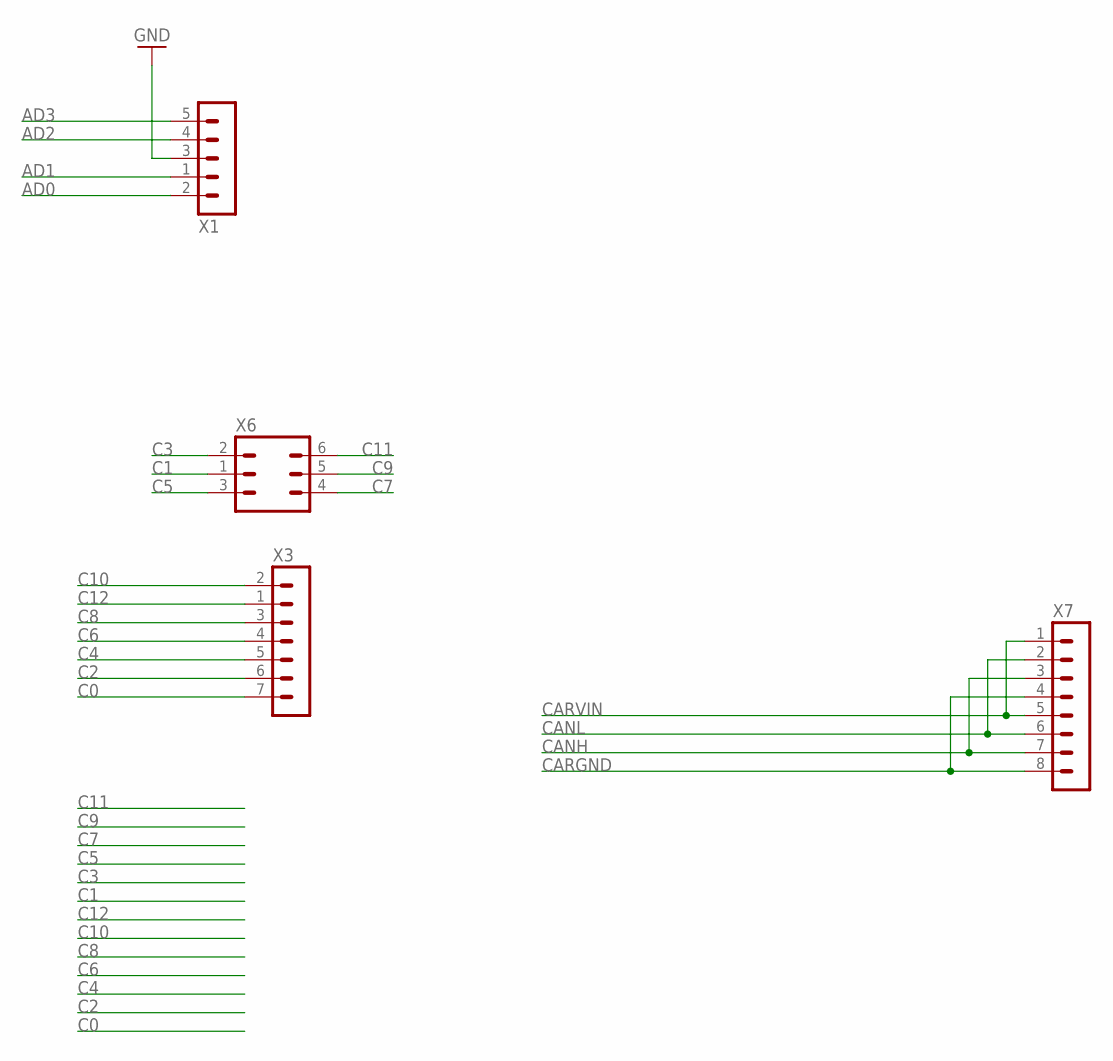
[picture p54: schematic canSlaveV05 Abm.sch]

Parts:
X1: HEADER_POS5_43650-0509; 43650-0509
X3: HEADER_POS7_43650-0709; 43650-0709
X6: HEADER_POS6_43650-0609; 43650-0609
X7: HEADER_POS8_43045-0800; 43045-0800

Connections:
AD0: X1.2 (1)
AD1: X1.1 (2)
AD2: X1.4
AD3: X1.5
C0: X3.7
C1: X6.1 (2)
C2: X3.6
C3: X6.2 (1)
C4: X3.5
C5: X6.3
C6: X3.4
C7: X6.4
C8: X3.3
C9: X6.5
C10: X3.2 (1)
C11: X6.6
C12: X3.1 (2)
CANH: X7.3, X7.7
CANL: X7.2, X7.6
CARGND: X7.4, X7.8
CARVIN: X7.1, X7.5
GND: X1.3

Board: 4 copper layers, 4 parts (0 on the bottom side), 4 nets, no tracks yet.
