funkobongrip/sprbms/hardware/can/canSlaveV05_testboard.brd

## EAGLE design hardware/can/canSlaveV05_testboard.brd (2016-02-18)

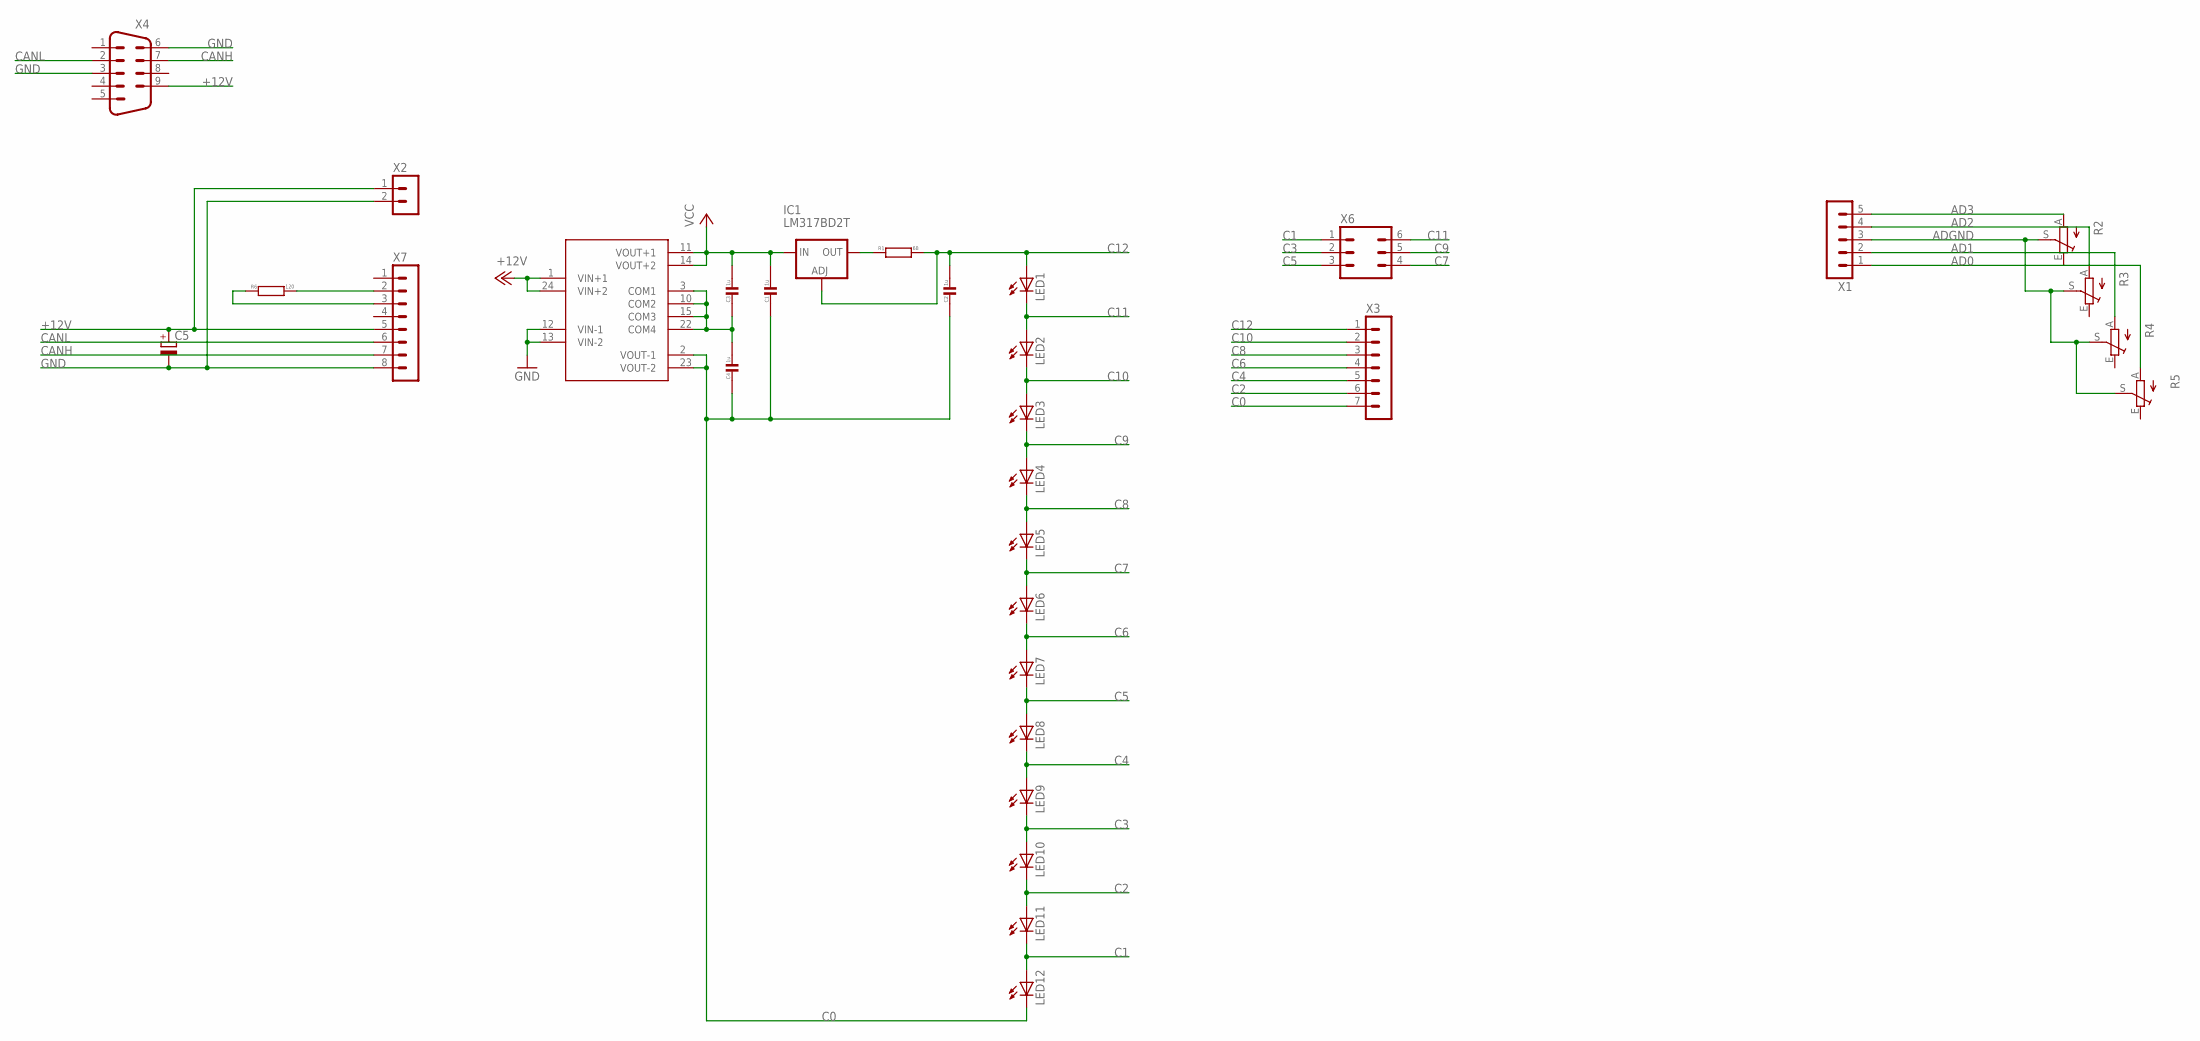
[picture p55: schematic canSlaveV05_testboard.sch]

Parts:
C1, C2, C3, C4: 1u; C1206
C5: CPOL-EUE10-20; EB20D
IC1: LM317BD2T; D2PACK
LED1, LED2, LED3, LED4, LED5, LED6, LED7, LED8, LED9, LED10, LED11, LED12: LEDSMT1206; 1206
R1: 68; R1206
R2, R3, R4, R5: TRIM_EU-CIP20C-6MM; CIP20C-6MM
R6: 120; R1206
U$1: JCB0312D24; JCB03
X1: HEADER_POS5_43650-0515; 43650-0515
X2: HEADER_POS2_43650-0215; 43650-0215
X3: HEADER_POS7_43650-0715; 43650-0715
X4: M09HP
X6: HEADER_POS6_43650-0615; 43650-0615
X7: HEADER_POS8_43045-0812; 43045-0812

Connections:
+12V: C5.+, U$1.1 (VIN+1), U$1.24 (VIN+2), X2.1, X4.9, X7.5
AD0: R5.A, X1.1
AD1: R4.A, X1.2
AD2: R3.A, X1.4
AD3: R2.A, X1.5
ADGND: R2.S, R3.S, R4.S, R5.S, X1.3
C0: C1.2, C2.2, C4.2, LED12.C, U$1.2 (VOUT-1), U$1.23 (VOUT-2), X3.7
C1: LED11.C, LED12.A, X6.1
C2: LED10.C, LED11.A, X3.6
C3: LED9.C, LED10.A, X6.2
C4: LED8.C, LED9.A, X3.5
C5: LED7.C, LED8.A, X6.3
C6: LED6.C, LED7.A, X3.4
C7: LED5.C, LED6.A, X6.4
C8: LED4.C, LED5.A, X3.3
C9: LED3.C, LED4.A, X6.5
C10: LED2.C, LED3.A, X3.2
C11: LED1.C, LED2.A, X6.6
C12: C2.1, IC1.1 (ADJ), LED1.A, R1.2, X3.1
CANH: X4.7, X7.7
CANL: X4.2, X7.6
CANR1: R6.1, X7.3
CANR2: R6.2, X7.2
COMM: C3.2, C4.1, U$1.3 (COM1), U$1.10 (COM2), U$1.15 (COM3), U$1.22 (COM4)
GND: C5.-, U$1.12 (VIN-1), U$1.13 (VIN-2), X2.2, X4.3, X4.6, X7.8
LM317O: IC1.2 (OUT), R1.1
VCC: C1.1, C3.1, IC1.3 (IN), U$1.11 (VOUT+1), U$1.14 (VOUT+2)

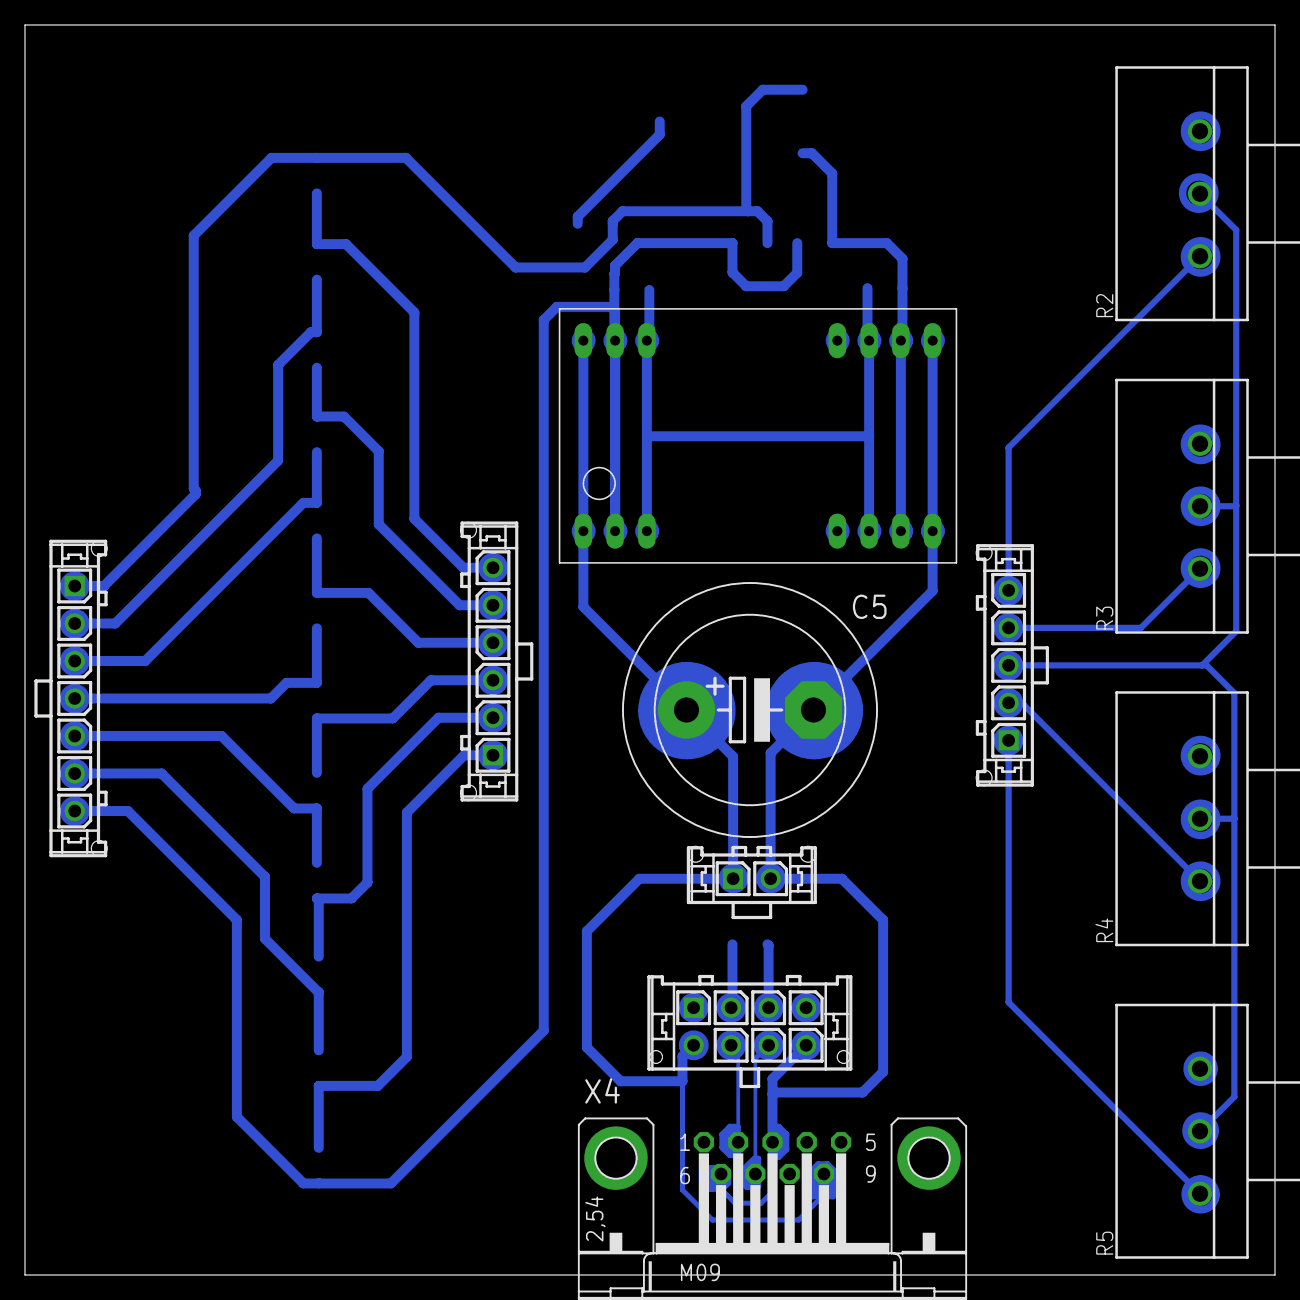
[picture p56: board canSlaveV05_testboard.brd from above]

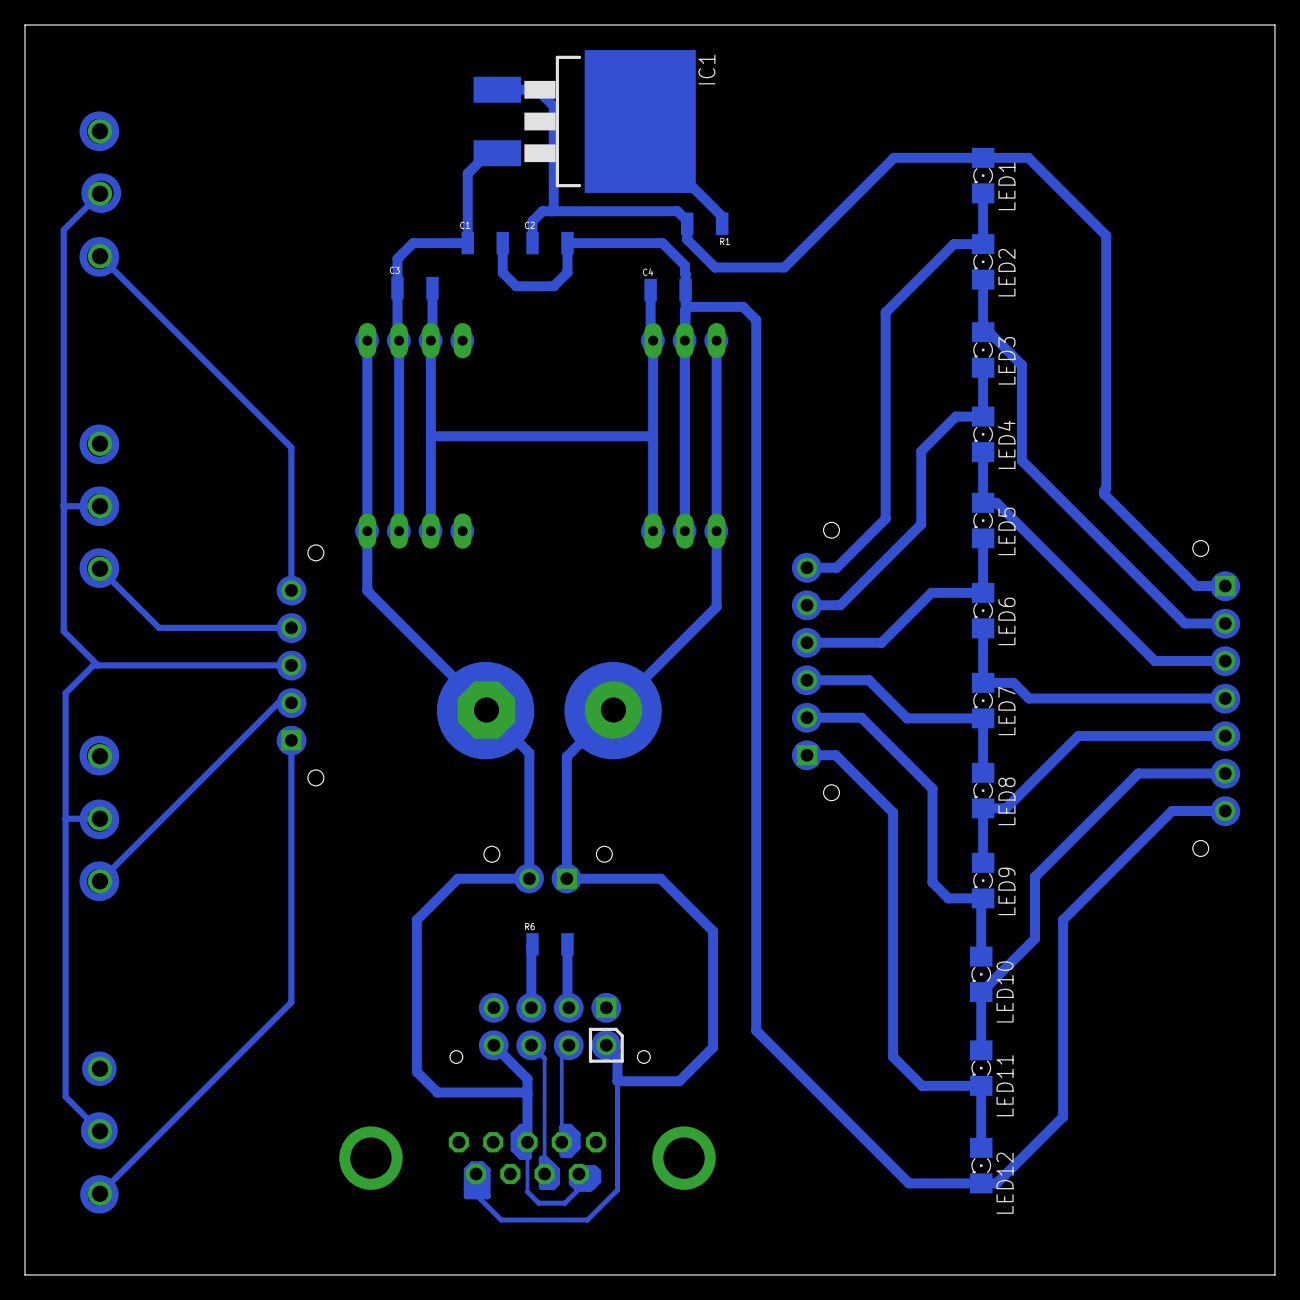
[picture p57: board canSlaveV05_testboard.brd from below]

Board: 2 copper layers, 100.0 x 100.0 mm, 31 parts (19 on the bottom side), 27 nets.
