funkobongrip/sprbms/hardware/spi/master/masterV05a.brd

## EAGLE design hardware/spi/master/masterV05a.brd (2013-05-31)

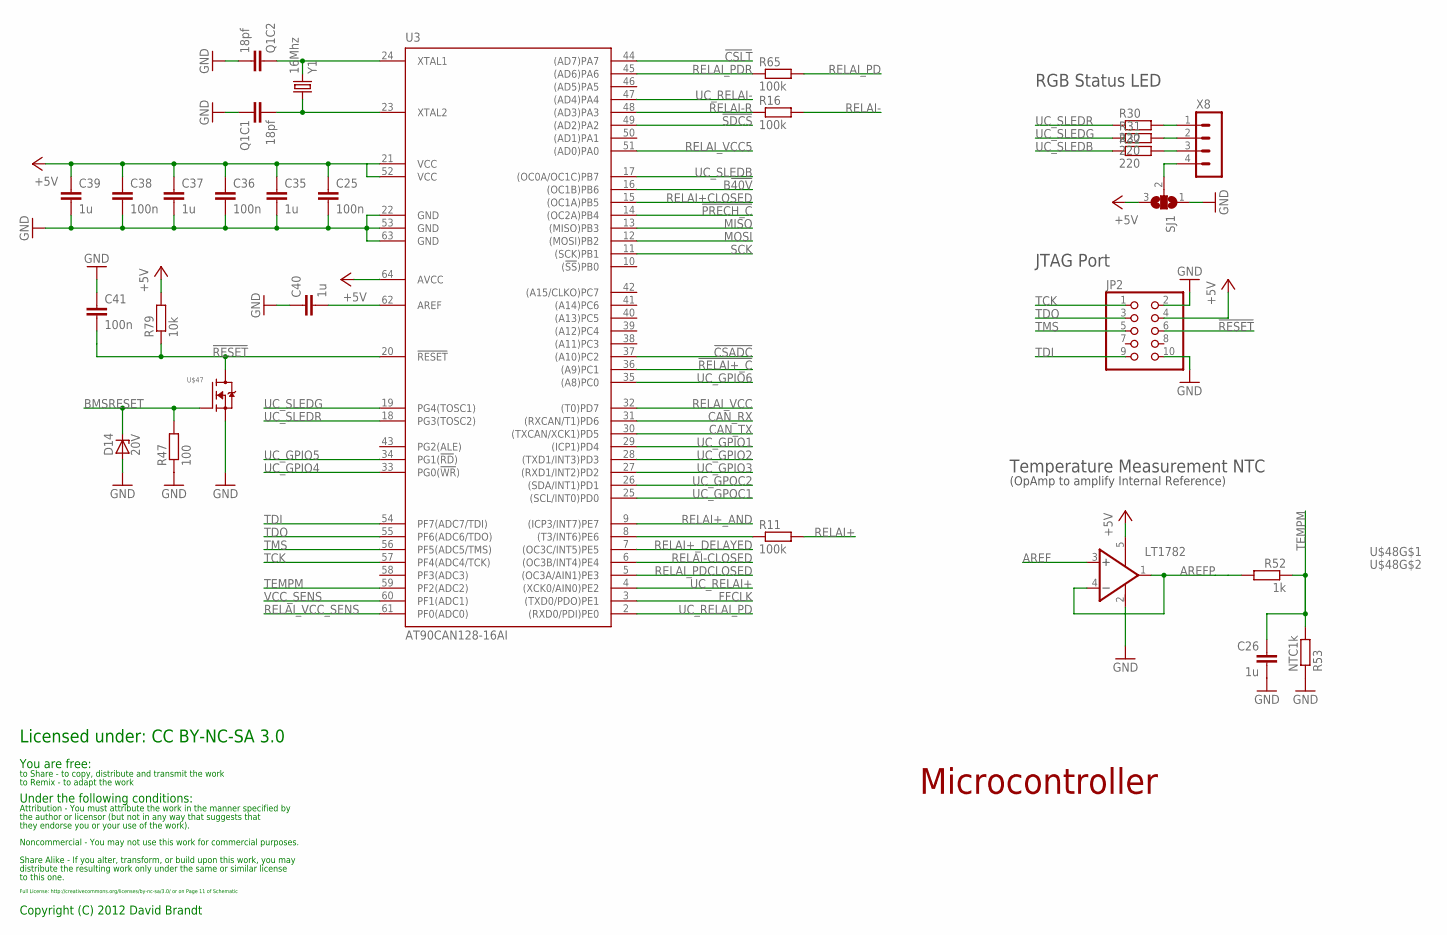
[picture p58: schematic masterV05a.sch, sheet 1]

Parts:
C25, C36, C38, C41: 100n; C0603K
C26: 1u; C0603
C35, C37, C39, C40: 1u; C0603K
D14: 20V; SOD123
JP2: PINHD-2X5; 2X05
Q1C1, Q1C2: 18pf; C0603K
R11, R16, R65: 100k; R0603
R30, R31, R32: 220; R0805
R47: 100; R0603
R52: 1k; R0603
R53: NTC1k; R0603
R79: 10k; R0603
SJ1: SJ2W; SJ_2
U3: AT90CAN128-16AI; TQFP64-0.8MM
U$47: 2N7002; SOT23
U$48: LT1782; SOT23-5
X8: HEADER_POS4_43045-0412; 43045-0412
Y1: 16Mhz; CX-53G

Connections:
!CSADC: U3.37 ((A10)PC2); also elsewhere on the board
!CSLT: U3.44 ((AD7)PA7); also elsewhere on the board
!PRECH_C: U3.14 ((OC2A)PB4); also elsewhere on the board
!RELAI+_C: U3.36 ((A9)PC1); also elsewhere on the board
!RESET: C41.2, JP2.6, R79.1, U3.20 (!RESET), U$47.3 (D)
!SDCS: U3.49 ((AD2)PA2); also elsewhere on the board
+5V: C25.1, C35.1, C36.1, C37.1, C38.1, C39.1, JP2.4, R79.2, SJ1.3, U3.21 (VCC), U3.52 (VCC), U3.64 (AVCC), U$48.5 (V+); also elsewhere on the board
AREF: C40.2, U3.62 (AREF), U$48.3 (+IN)
AREFP: R52.2, U$48.1 (OUT), U$48.4 (-IN)
B!40V: U3.16 ((OC1B)PB6); also elsewhere on the board
BMSRESET: D14.C, R47.2, U$47.1 (G); also elsewhere on the board
CAN_RX: U3.31 ((RXCAN/T1)PD6); also elsewhere on the board
CAN_TX: U3.30 ((TXCAN/XCK1)PD5); also elsewhere on the board
FFCLK: U3.3 ((TXD0/PDO)PE1); also elsewhere on the board
GND: C25.2, C26.2, C35.2, C36.2, C37.2, C38.2, C39.2, C40.1, C41.1, D14.A, JP2.2, JP2.10, Q1C1.1, Q1C2.2, R47.1, R53.1, SJ1.1, U3.22 (GND), U3.53 (GND), U3.63 (GND), U$47.2 (S), U$48.2 (V-); also elsewhere on the board
MISO: U3.13 ((MISO)PB3); also elsewhere on the board
MOSI: U3.12 ((MOSI)PB2); also elsewhere on the board
OSC1: Q1C2.1, U3.24 (XTAL1), Y1.P$2 (2)
OSC2: Q1C1.2, U3.23 (XTAL2), Y1.P$1 (1)
RELAI+: R11.2; also elsewhere on the board
RELAI+CLOSED: U3.15 ((OC1A)PB5); also elsewhere on the board
RELAI+S: R11.1, U3.8 ((T3/INT6)PE6)
RELAI+_AND: U3.9 ((ICP3/INT7)PE7); also elsewhere on the board
RELAI+_DELAYED: U3.7 ((OC3C/INT5)PE5); also elsewhere on the board
RELAI-: R16.2; also elsewhere on the board
RELAI-CLOSED: U3.6 ((OC3B/INT4)PE4); also elsewhere on the board
RELAI-R: R16.1, U3.48 ((AD3)PA3)
RELAI_PD: R65.2; also elsewhere on the board
RELAI_PDCLOSED: U3.5 ((OC3A/AIN1)PE3); also elsewhere on the board
RELAI_PDR: R65.1, U3.45 ((AD6)PA6)
RELAI_VCC: U3.32 ((T0)PD7)
RELAI_VCC5: U3.51 ((AD0)PA0); also elsewhere on the board
RELAI_VCC_SENS: U3.61 (PF0(ADC0)); also elsewhere on the board
SCK: U3.11 ((SCK)PB1); also elsewhere on the board
SLEDB: R32.2, X8.3
SLEDG: R31.2, X8.2
SLEDPOW: SJ1.2, X8.4
SLEDR: R30.2, X8.1
TCK: JP2.1, U3.57 (PF4(ADC4/TCK))
TDI: JP2.9, U3.54 (PF7(ADC7/TDI))
TDO: JP2.3, U3.55 (PF6(ADC6/TDO))
TEMPM: C26.1, R52.1, R53.2, U3.59 (PF2(ADC2))
TMS: JP2.5, U3.56 (PF5(ADC5/TMS))
UC_GPIO1: U3.29 ((ICP1)PD4); also elsewhere on the board
UC_GPIO2: U3.28 ((TXD1/INT3)PD3); also elsewhere on the board
UC_GPIO3: U3.27 ((RXD1/INT2)PD2); also elsewhere on the board
UC_GPIO4: U3.33 (PG0(!WR!)); also elsewhere on the board
UC_GPIO5: U3.34 (PG1(!RD!)); also elsewhere on the board
UC_GPIO6: U3.35 ((A8)PC0); also elsewhere on the board
UC_GPOC1: U3.25 ((SCL/INT0)PD0); also elsewhere on the board
UC_GPOC2: U3.26 ((SDA/INT1)PD1); also elsewhere on the board
UC_RELAI+: U3.4 ((XCK0/AIN0)PE2); also elsewhere on the board
UC_RELAI-: U3.47 ((AD4)PA4); also elsewhere on the board
UC_RELAI_PD: U3.2 ((RXD0/PDI)PE0); also elsewhere on the board
UC_SLEDB: R32.1, U3.17 ((OC0A/OC1C)PB7)
UC_SLEDG: R31.1, U3.19 (PG4(TOSC1))
UC_SLEDR: R30.1, U3.18 (PG3(TOSC2))
VCC_SENS: U3.60 (PF1(ADC1)); also elsewhere on the board

Notes on the sheet:
Microcontroller
Licensed under: CC BY-NC-SA 3.0
You are free:
to Share - to copy, distribute and transmit the work
to Remix - to adapt the work
Under the following conditions:
the author or licensor (but not in any way that suggests that
Attribution - You must attribute the work in the manner specified by
they endorse you or your use of the work).
Noncommercial - You may not use this work for commercial purposes.
Share Alike - If you alter, transform, or build upon this work, you may
distribute the resulting work only under the same or similar license
to this one.
Full License: http://creativecommons.org/licenses/by-nc-sa/3.0/ or on Page 11 of Schematic
Copyright (C) 2012 David Brandt
Temperature Measurement NTC
(OpAmp to amplify Internal Reference)
JTAG Port
RGB Status LED

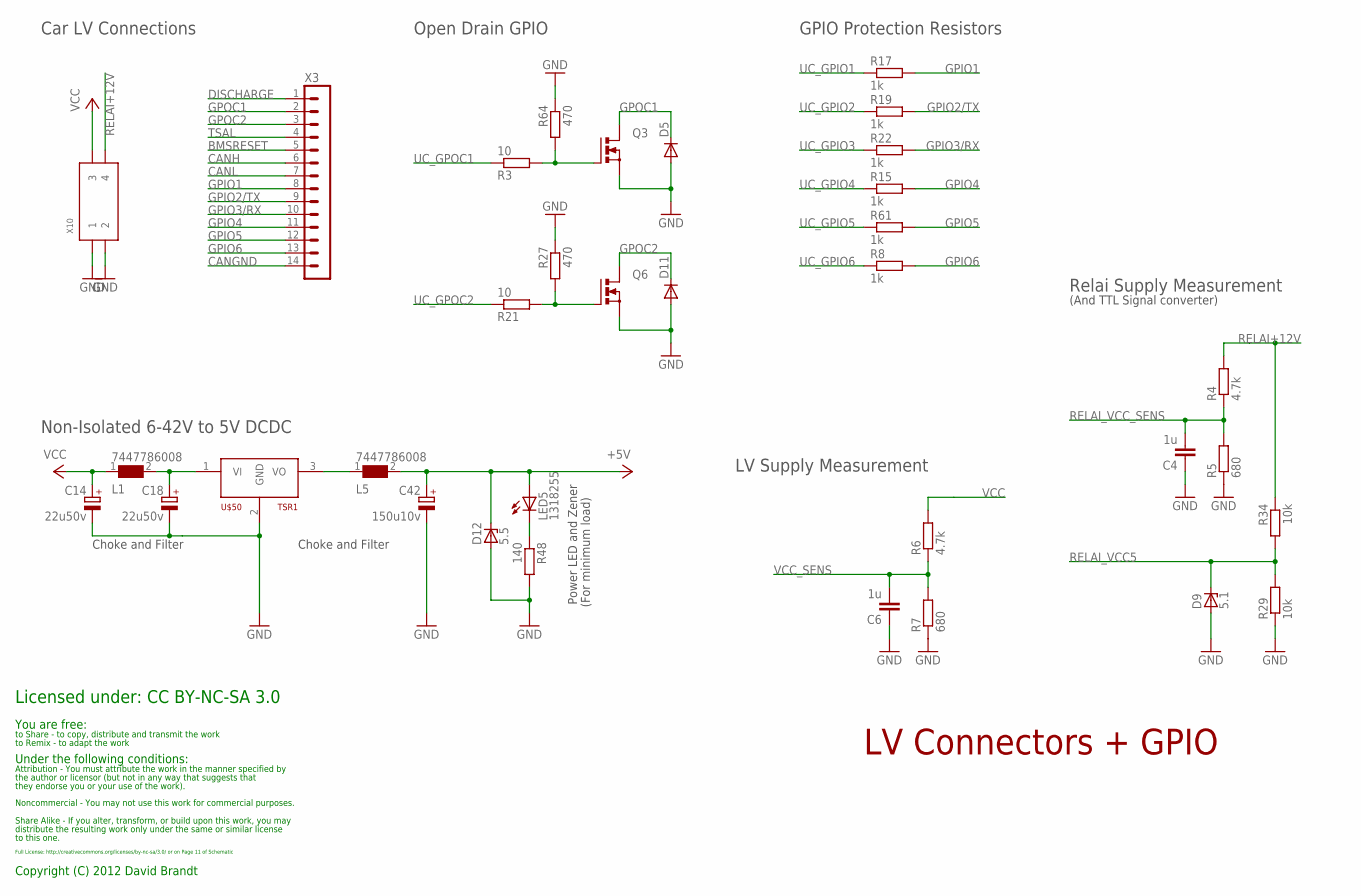
[picture p59: schematic masterV05a.sch, sheet 2]

Parts:
C4, C6: 1u; C0603
C14, C18: 22u50v; PANASONIC_D
C42: 150u10v; PANASONIC_D
D5, D11: DIODE-SMB; SMB
D9: 5.1; SOD323-W
D12: 5.5; SOD323-W
L1, L5: 7447786008; WE-PD_6033/6050_PLASTIC_BASE
LED5: 1318255; CHIPLED_1206
Q3, Q6: N-MOSFET-SO8S; SO-08
R3, R21: 10; R0603
R4, R6: 4.7k; R0603
R5, R7: 680; R0603
R8, R15, R17, R19, R22, R61: 1k; R0603
R27, R64: 470; R0603
R29, R34: 10k; R0603
R48: 140; R1206
U$50: TSR1
X3: HEADER_POS14_43045-1412; 43045-1412
X10: MINI-FIT-JR-045566; 5566-04

Connections:
+5V: C42.+, D12.C, L5.2, LED5.A; also elsewhere on the board
+5VL: L5.1, U$50.3 (VO)
BMSRESET: X3.5; also elsewhere on the board
CANGND: X3.14; also elsewhere on the board
CANH: X3.6; also elsewhere on the board
CANL: X3.7; also elsewhere on the board
DISCHARGE: X3.1; also elsewhere on the board
GND: C4.1, C6.1, C14.-, C18.-, C42.-, D5.A, D9.A, D11.A, D12.A, Q3.1 (S), Q3.2 (S), Q3.3 (S), Q6.1 (S), Q6.2 (S), Q6.3 (S), R5.1, R7.1, R27.1, R29.1, R48.2, R64.1, U$50.2 (GND), X10.P1 (1), X10.P2 (2); also elsewhere on the board
GPIO1: R17.2, X3.8
GPIO2/TX: R19.2, X3.9
GPIO3/RX: R22.2, X3.10
GPIO4: R15.2, X3.11
GPIO5: R61.2, X3.12
GPIO6: R8.2, X3.13
GPOC1: D5.C, Q3.5 (D), Q3.6 (D), Q3.7 (D), Q3.8 (D), X3.2
GPOC2: D11.C, Q6.5 (D), Q6.6 (D), Q6.7 (D), Q6.8 (D), X3.3
PLEDC5: LED5.C, R48.1
RELAI+12V: R4.2, R34.1, X10.P4 (4); also elsewhere on the board
RELAIPDG1: Q3.4 (G), R3.2, R64.2
RELAIPDG2: Q6.4 (G), R21.2, R27.2
RELAI_VCC5: D9.C, R29.2, R34.2; also elsewhere on the board
RELAI_VCC_SENS: C4.2, R4.1, R5.2; also elsewhere on the board
TSAL: X3.4; also elsewhere on the board
UC_GPIO1: R17.1; also elsewhere on the board
UC_GPIO2: R19.1; also elsewhere on the board
UC_GPIO3: R22.1; also elsewhere on the board
UC_GPIO4: R15.1; also elsewhere on the board
UC_GPIO5: R61.1; also elsewhere on the board
UC_GPIO6: R8.1; also elsewhere on the board
UC_GPOC1: R3.1; also elsewhere on the board
UC_GPOC2: R21.1; also elsewhere on the board
VCC: C14.+, L1.1, R6.2, X10.P3 (3)
VCC2: C18.+, L1.2, U$50.1 (VI)
VCC_SENS: C6.2, R6.1, R7.2; also elsewhere on the board

Notes on the sheet:
Non-Isolated 6-42V to 5V DCDC
LV Connectors + GPIO
Licensed under: CC BY-NC-SA 3.0
You are free:
to Share - to copy, distribute and transmit the work
to Remix - to adapt the work
Under the following conditions:
the author or licensor (but not in any way that suggests that
Attribution - You must attribute the work in the manner specified by
they endorse you or your use of the work).
Noncommercial - You may not use this work for commercial purposes.
Share Alike - If you alter, transform, or build upon this work, you may
distribute the resulting work only under the same or similar license
to this one.
Full License: http://creativecommons.org/licenses/by-nc-sa/3.0/ or on Page 11 of Schematic
Copyright (C) 2012 David Brandt
Choke and Filter
Power LED and Zener
(For minimum load)
Car LV Connections
Open Drain GPIO
GPIO Protection Resistors
LV Supply Measurement
Relai Supply Measurement
(And TTL Signal converter)

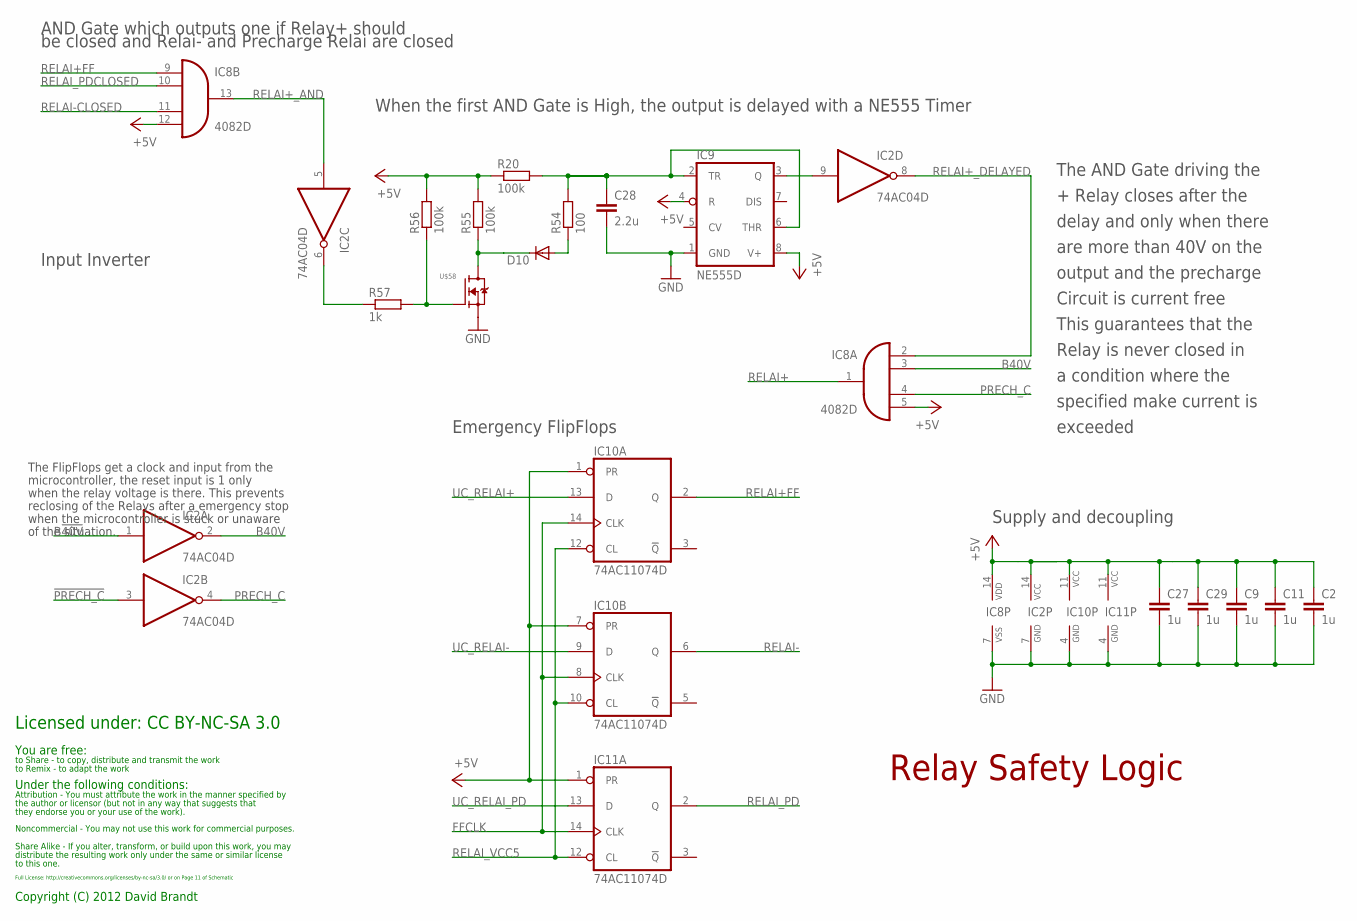
[picture p60: schematic masterV05a.sch, sheet 3]

Parts:
C2, C9, C11, C27, C29: 1u; C0603
C28: 2.2u; C1206K
D10: DIODE-SOD323-W; SOD323-W
IC2: 74AC04D; SO14
IC8: 4082D; SO14
IC9: NE555D; SO08
IC10, IC11: 74AC11074D; SO14
R20, R55, R56: 100k; R0603
R54: 100; R0603
R57: 1k; R0603
U$58: 2N7002; SOT23

Connections:
!ANDOUT2: D10.C, R55.1, U$58.3 (D)
!PRECH_C: IC2.3 (I); also elsewhere on the board
!RELAI+_C: IC2.6 (O), R57.1; also elsewhere on the board
!RELAI+_CC: IC2.9 (I), IC9.3 (Q)
+5V: C2.1, C9.1, C11.1, C27.1, C29.1, IC2.14 (VCC), IC8.5 (I3), IC8.12 (I3), IC8.14 (VDD), IC9.4 (R), IC9.8 (V+), IC10.1 (PR), IC10.7 (PR), IC10.11 (VCC), IC11.1 (PR), IC11.11 (VCC), R20.1, R55.2, R56.2; also elsewhere on the board
ANDOUTD: D10.A, R54.1
B40V: IC2.2 (O), IC8.3 (I1)
B!40V: IC2.1 (I); also elsewhere on the board
FFCLK: IC10.8 (CLK), IC10.14 (CLK), IC11.14 (CLK); also elsewhere on the board
GND: C2.2, C9.2, C11.2, C27.2, C28.2, C29.2, IC2.7 (GND), IC8.7 (VSS), IC9.1 (GND), IC10.4 (GND), IC11.4 (GND), U$58.2 (S); also elsewhere on the board
NE555_TR: C28.1, IC9.2 (TR), IC9.6 (THR), R20.2, R54.2
PRECH_C: IC2.4 (O), IC8.4 (I2)
RELAI+: IC8.1 (O); also elsewhere on the board
RELAI+FF: IC8.9 (I0), IC10.2 (Q)
RELAI+_AND: IC2.5 (I), IC8.13 (O); also elsewhere on the board
RELAI+_CG: R56.1, R57.2, U$58.1 (G)
RELAI+_DELAYED: IC2.8 (O), IC8.2 (I0); also elsewhere on the board
RELAI-: IC10.6 (Q); also elsewhere on the board
RELAI-CLOSED: IC8.11 (I2); also elsewhere on the board
RELAI_PD: IC11.2 (Q); also elsewhere on the board
RELAI_PDCLOSED: IC8.10 (I1); also elsewhere on the board
RELAI_VCC5: IC10.10 (CL), IC10.12 (CL), IC11.12 (CL); also elsewhere on the board
UC_RELAI+: IC10.13 (D); also elsewhere on the board
UC_RELAI-: IC10.9 (D); also elsewhere on the board
UC_RELAI_PD: IC11.13 (D); also elsewhere on the board

Notes on the sheet:
AND Gate which outputs one if Relay+ should
Relay Safety Logic
Licensed under: CC BY-NC-SA 3.0
You are free:
to Share - to copy, distribute and transmit the work
to Remix - to adapt the work
Under the following conditions:
the author or licensor (but not in any way that suggests that
Attribution - You must attribute the work in the manner specified by
they endorse you or your use of the work).
Noncommercial - You may not use this work for commercial purposes.
Share Alike - If you alter, transform, or build upon this work, you may
distribute the resulting work only under the same or similar license
to this one.
Full License: http://creativecommons.org/licenses/by-nc-sa/3.0/ or on Page 11 of Schematic
Copyright (C) 2012 David Brandt
be closed and Relai- and Precharge Relai are closed
When the first AND Gate is High, the output is delayed with a NE555 Timer
The AND Gate driving the
+ Relay closes after the
delay and only when there
are more than 40V on the
output and the precharge
Circuit is current free
This guarantees that the
Relay is never closed in
a condition where the
specified make current is
exceeded
Input Inverter
Supply and decoupling
Emergency FlipFlops
The FlipFlops get a clock and input from the
microcontroller, the reset input is 1 only
when the relay voltage is there. This prevents
reclosing of the Relays after a emergency stop
when the microcontroller is stuck or unaware
of the situation.

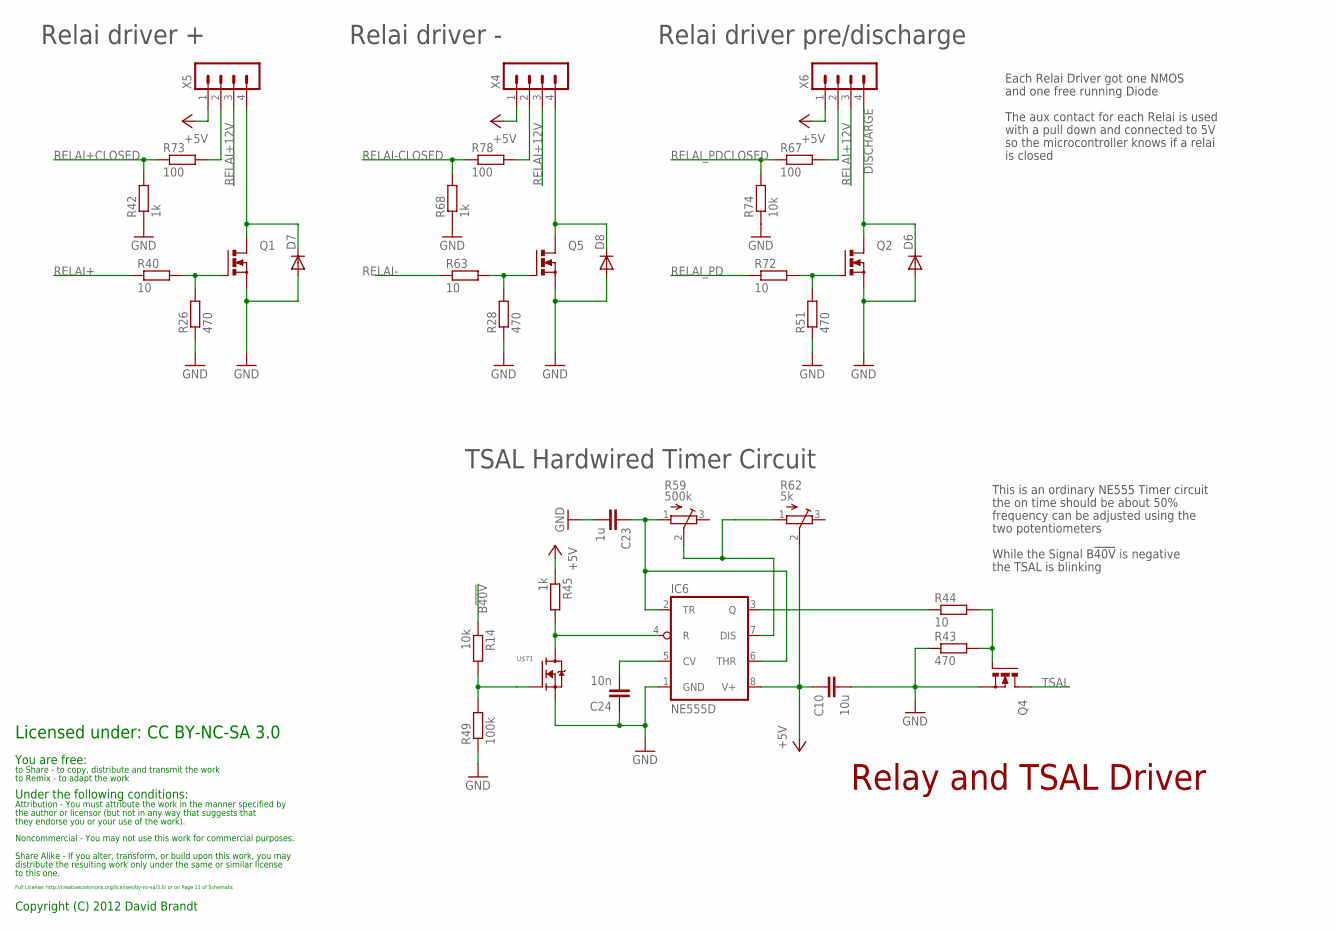
[picture p61: schematic masterV05a.sch, sheet 4]

Parts:
C10: 10u; C1206K
C23: 1u; C0805K
C24: 10n; C0603
D6, D7, D8: DIODE-SMB; SMB
IC6: NE555D; SO08
Q1, Q2, Q4, Q5: N-MOSFET-SO8S; SO-08
R14, R74: 10k; R0603
R26, R28, R43, R51: 470; R0603
R40, R44, R63, R72: 10; R0603
R42, R45, R68: 1k; R0603
R49: 100k; R0603
R59: 500k; 3223W
R62: 5k; 3223W
R67, R73, R78: 100; R0603
U$71: 2N7002; SOT23
X4, X5, X6: HEADER_POS4_43045-0412; 43045-0412

Connections:
+5V: C10.1, IC6.8 (V+), R45.1, R62.2 (S), X4.1, X5.1, X6.1; also elsewhere on the board
B!40V: R14.1; also elsewhere on the board
DISCHARGE: D6.C, Q2.5 (D), Q2.6 (D), Q2.7 (D), Q2.8 (D), X6.4; also elsewhere on the board
GND: C10.2, C23.2, C24.1, D6.A, D7.A, D8.A, IC6.1 (GND), Q1.1 (S), Q1.2 (S), Q1.3 (S), Q2.1 (S), Q2.2 (S), Q2.3 (S), Q4.1 (S), Q4.2 (S), Q4.3 (S), Q5.1 (S), Q5.2 (S), Q5.3 (S), R26.1, R28.1, R42.1, R43.1, R49.1, R51.1, R68.1, R74.1, U$71.2 (S); also elsewhere on the board
RELAI+: R40.1; also elsewhere on the board
RELAI+12V: X4.3, X5.3, X6.3; also elsewhere on the board
RELAI+CLOSED: R42.2, R73.1; also elsewhere on the board
RELAI+G: Q1.4 (G), R26.2, R40.2
RELAI+GND: D7.C, Q1.5 (D), Q1.6 (D), Q1.7 (D), Q1.8 (D), X5.4
RELAI+_CLOSED_AP: R73.2, X5.2
RELAI-: R63.1; also elsewhere on the board
RELAI-CLOSED: R68.2, R78.1; also elsewhere on the board
RELAI-G: Q5.4 (G), R28.2, R63.2
RELAI-GND: D8.C, Q5.5 (D), Q5.6 (D), Q5.7 (D), Q5.8 (D), X4.4
RELAI-_CLOSED_AP: R78.2, X4.2
RELAIPDG: Q2.4 (G), R51.2, R72.2
RELAIPD_CLOSED_AP: R67.2, X6.2
RELAI_PD: R72.1; also elsewhere on the board
RELAI_PDCLOSED: R67.1, R74.2; also elsewhere on the board
TSAL: Q4.5 (D), Q4.6 (D), Q4.7 (D), Q4.8 (D); also elsewhere on the board
TSAL!R: IC6.4 (R), R45.2, U$71.3 (D)
TSALCV: C24.2, IC6.5 (CV)
TSALDIS: IC6.7 (DIS), R59.2 (S), R62.1 (A)
TSALG: Q4.4 (G), R43.2, R44.2
TSALGOUT: R14.2, R49.2, U$71.1 (G)
TSALPR: C23.1, IC6.2 (TR), IC6.6 (THR), R59.1 (A)
TSALQ: IC6.3 (Q), R44.1

Notes on the sheet:
Each Relai Driver got one NMOS
Relay and TSAL Driver
Licensed under: CC BY-NC-SA 3.0
You are free:
to Share - to copy, distribute and transmit the work
to Remix - to adapt the work
Under the following conditions:
the author or licensor (but not in any way that suggests that
Attribution - You must attribute the work in the manner specified by
they endorse you or your use of the work).
Noncommercial - You may not use this work for commercial purposes.
Share Alike - If you alter, transform, or build upon this work, you may
distribute the resulting work only under the same or similar license
to this one.
Full License: http://creativecommons.org/licenses/by-nc-sa/3.0/ or on Page 11 of Schematic
Copyright (C) 2012 David Brandt
Relai driver +
Relai driver -
Relai driver pre/discharge
and one free running Diode
The aux contact for each Relai is used
with a pull down and connected to 5V
so the microcontroller knows if a relai
is closed
TSAL Hardwired Timer Circuit
This is an ordinary NE555 Timer circuit
the on time should be about 50%
frequency can be adjusted using the
two potentiometers
While the Signal B!40V! is negative
the TSAL is blinking

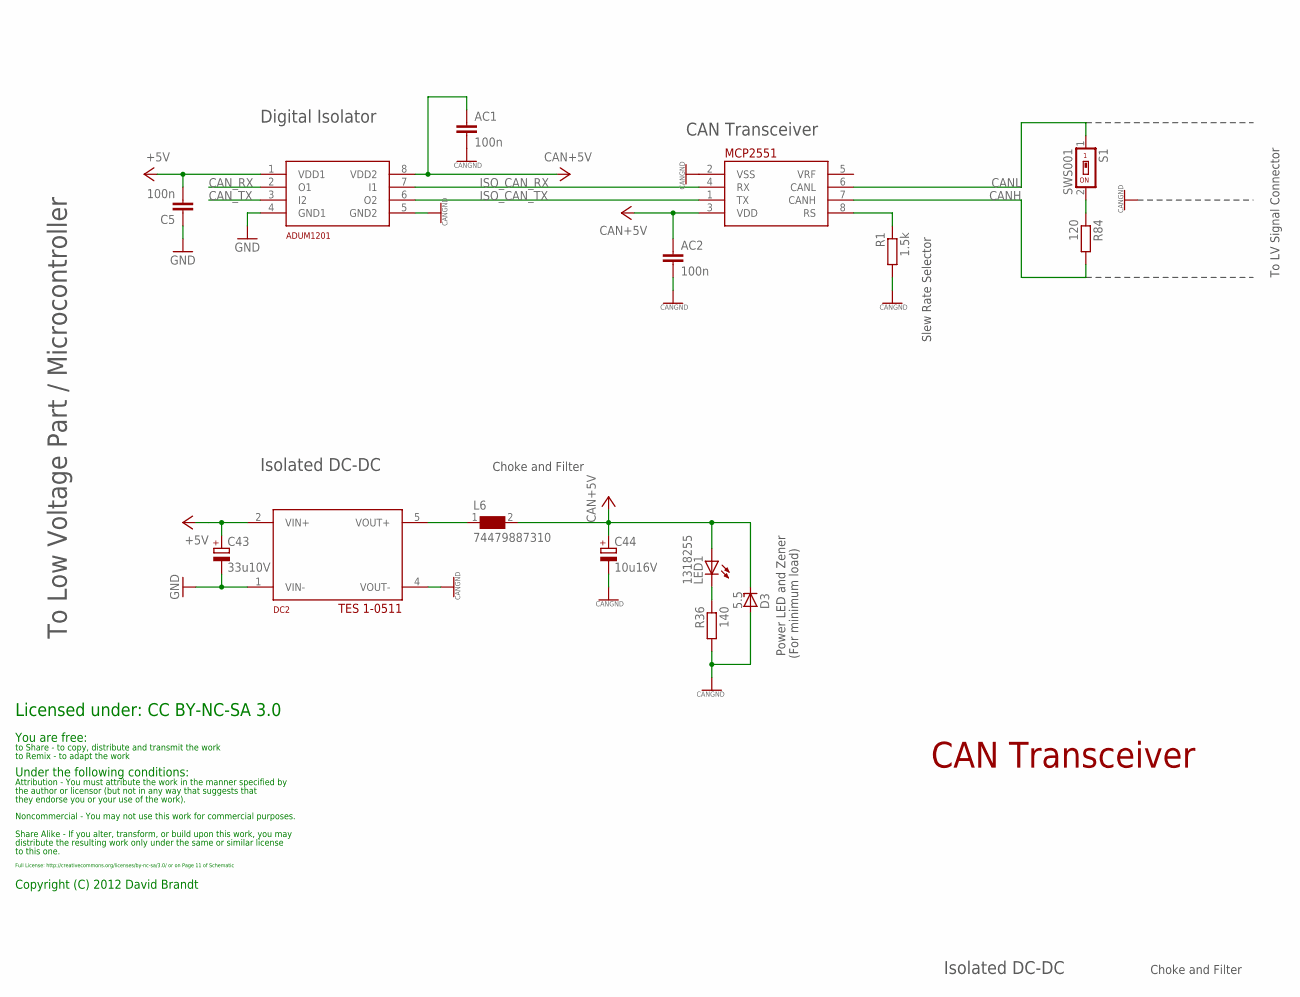
[picture p62: schematic masterV05a.sch, sheet 5]

Parts:
AC1, AC2: 100n; C0603K
C5: 100n; C0603K
C43: 33u10V; PANASONIC_C
C44: 10u16V; PANASONIC_B
D3: 5.5; SOD323-W
DC2: TES 1-0511; ISF
L6: 74479887310; WE-PMI_1008
LED1: 1318255; CHIPLED_1206
R1: 1.5k; R0603
R36: 140; R1206
R84: 120; M1206
S1: SWS001; SMS-001
U$17: MCP2551; SO-8
U$20: ADUM1201; SO-8

Connections:
+5V: C5.2, C43.+, DC2.2 (VIN+), U$20.1 (VDD1); also elsewhere on the board
C1RS: R1.1, U$17.8 (RS)
CAN+5V: AC1.1, AC2.1, C44.+, D3.C, L6.2, LED1.A, U$17.3 (VDD), U$20.8 (VDD2)
CAN+5VL: DC2.5 (VOUT+), L6.1
CANGND: AC1.2, AC2.2, C44.-, D3.A, DC2.4 (VOUT-), R1.2, R36.2, U$17.2 (VSS), U$20.5 (GND2); also elsewhere on the board
CANH: R84.2, U$17.7 (CANH); also elsewhere on the board
CANL: S1.1, U$17.6 (CANL); also elsewhere on the board
CANM: R84.1, S1.2
CAN_RX: U$20.2 (O1); also elsewhere on the board
CAN_TX: U$20.3 (I2); also elsewhere on the board
GND: C5.1, C43.-, DC2.1 (VIN-), U$20.4 (GND1); also elsewhere on the board
ISO_CAN_RX: U$17.4 (RX), U$20.7 (I1)
ISO_CAN_TX: U$17.1 (TX), U$20.6 (O2)
PLEDC1: LED1.C, R36.1

Notes on the sheet:
CAN Transceiver
Isolated DC-DC
Choke and Filter
Power LED and Zener
(For minimum load)
Digital Isolator
Slew Rate Selector
To LV Signal Connector
Licensed under: CC BY-NC-SA 3.0
You are free:
to Share - to copy, distribute and transmit the work
to Remix - to adapt the work
Under the following conditions:
the author or licensor (but not in any way that suggests that
Attribution - You must attribute the work in the manner specified by
they endorse you or your use of the work).
Noncommercial - You may not use this work for commercial purposes.
Share Alike - If you alter, transform, or build upon this work, you may
distribute the resulting work only under the same or similar license
to this one.
Full License: http://creativecommons.org/licenses/by-nc-sa/3.0/ or on Page 11 of Schematic
Copyright (C) 2012 David Brandt
To Low Voltage Part / Microcontroller
