funkobongrip/sprbms/hardware/spi/master/masterV05a.brd

## EAGLE design hardware/spi/master/masterV05a.brd (continued)

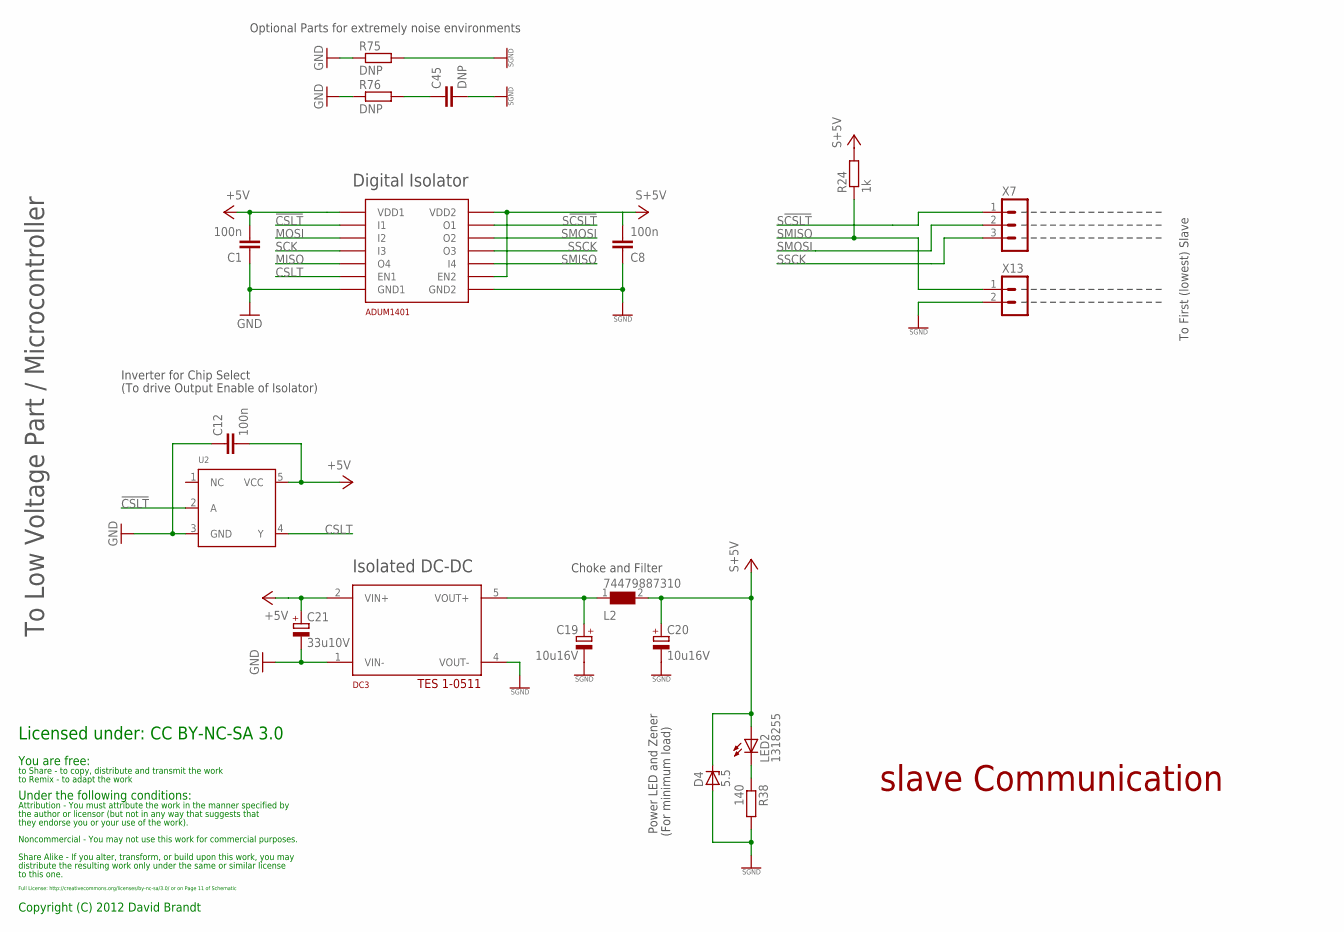
[picture p63: schematic masterV05a.sch, sheet 6]

Parts:
C1, C8, C12: 100n; C0603K
C19, C20: 10u16V; PANASONIC_B
C21: 33u10V; PANASONIC_C
C45: DNP; C2220K
D4: 5.5; SOD323-W
DC3: TES 1-0511; ISF
L2: 74479887310; WE-PMI_1008
LED2: 1318255; CHIPLED_1206
R24: 1k; R0603
R38: 140; R1206
R75: DNP; R2512
R76: DNP; R1206
U2: 74LVC1G04; SOT23-5
U$9: ADUM1401; SO16WB
X7: HEADER_POS3_43650-0315; 43650-0315
X13: HEADER_POS2_43650-0215; 43650-0215

Connections:
!CSLT: U2.2 (A), U$9.P$3 (I1); also elsewhere on the board
+5V: C1.2, C12.2, C21.+, DC3.2 (VIN+), U2.5 (VCC), U$9.P$1 (VDD1); also elsewhere on the board
CSLT: U2.4 (Y), U$9.P$7 (EN1)
GND: C1.1, C12.1, C21.-, DC3.1 (VIN-), R75.1, R76.1, U2.3 (GND), U$9.P$2 (GND1), U$9.P$8 (GND1); also elsewhere on the board
MISO: U$9.P$6 (O4); also elsewhere on the board
MOSI: U$9.P$4 (I2); also elsewhere on the board
PLEDC2: LED2.C, R38.1
S!CSLT: U$9.P$14 (O1), X7.1
S+5V: C8.2, C20.+, D4.C, L2.2, LED2.A, R24.2, U$9.P$10 (EN2), U$9.P$16 (VDD2)
S+5VL: C19.+, DC3.5 (VOUT+), L2.1
SCK: U$9.P$5 (I3); also elsewhere on the board
SGND: C8.1, C19.-, C20.-, C45.2, D4.A, DC3.4 (VOUT-), R38.2, R75.2, U$9.P$9 (GND2), U$9.P$15 (GND2), X13.2
SGNDGND: C45.1, R76.2
SMISO: R24.1, U$9.P$11 (I4), X13.1
SMOSI: U$9.P$13 (O2), X7.2
SSCK: U$9.P$12 (O3), X7.3

Notes on the sheet:
Isolated DC-DC
Choke and Filter
slave Communication
Licensed under: CC BY-NC-SA 3.0
You are free:
to Share - to copy, distribute and transmit the work
to Remix - to adapt the work
Under the following conditions:
the author or licensor (but not in any way that suggests that
Attribution - You must attribute the work in the manner specified by
they endorse you or your use of the work).
Noncommercial - You may not use this work for commercial purposes.
Share Alike - If you alter, transform, or build upon this work, you may
distribute the resulting work only under the same or similar license
to this one.
Full License: http://creativecommons.org/licenses/by-nc-sa/3.0/ or on Page 11 of Schematic
Copyright (C) 2012 David Brandt
To Low Voltage Part / Microcontroller
Inverter for Chip Select
(To drive Output Enable of Isolator)
Power LED and Zener
(For minimum load)
Optional Parts for extremely noise environments
Digital Isolator
To First (lowest) Slave

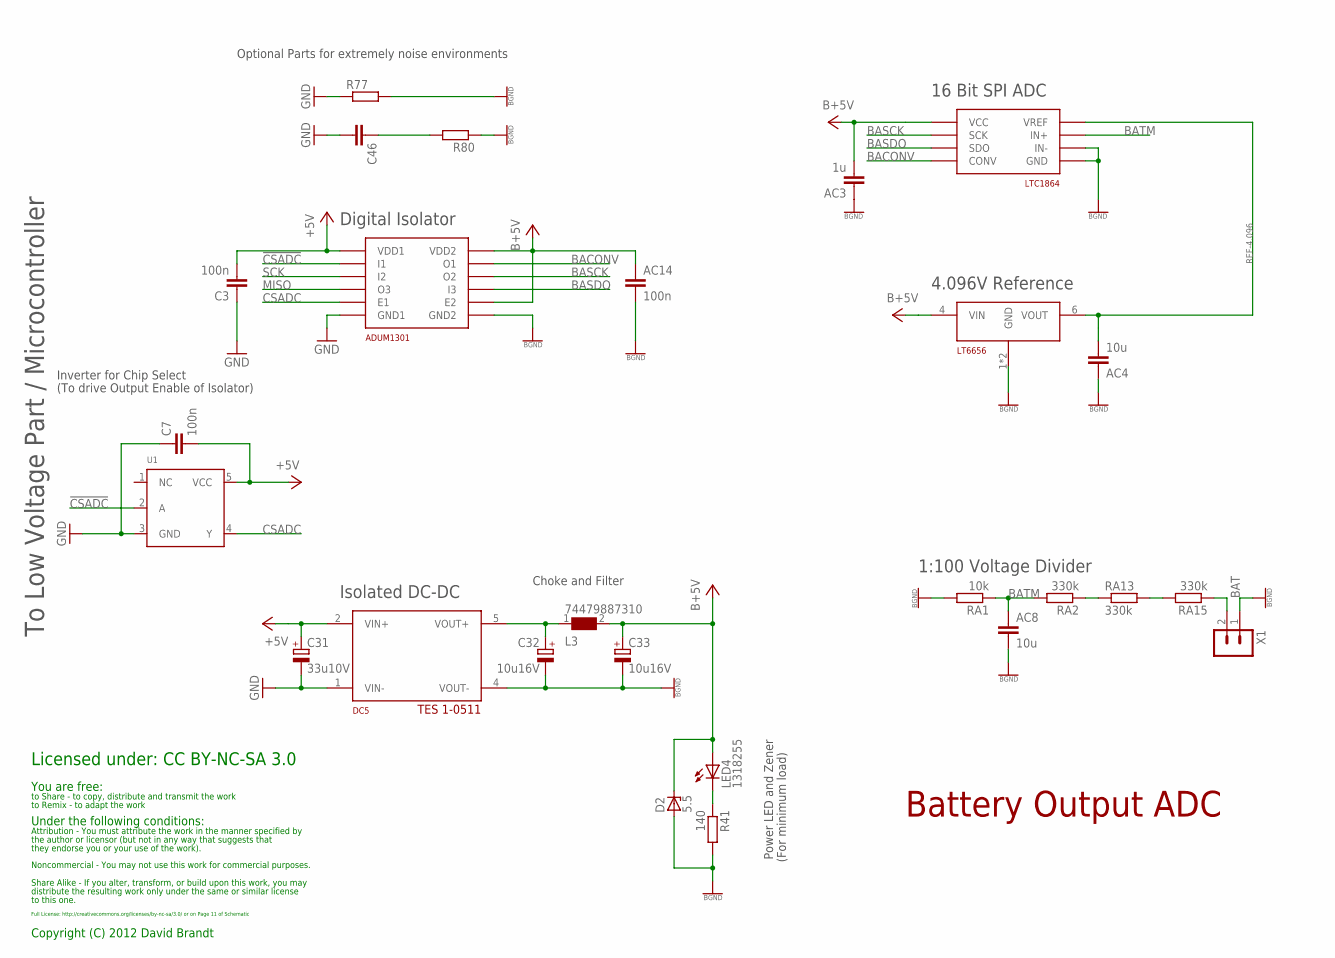
[picture p64: schematic masterV05a.sch, sheet 7]

Parts:
AC3: 1u; C1206K
AC4, AC8: 10u; C1206K
AC14: 100n; C0603K
C3, C7: 100n; C0603K
C31: 33u10V; PANASONIC_C
C32, C33: 10u16V; PANASONIC_B
C46: C-EUC2220K; C2220K
D2: 5.5; SOD323-W
DC5: TES 1-0511; ISF
L3: 74479887310; WE-PMI_1008
LED4: 1318255; CHIPLED_1206
R41: 140; R1206
R77: R-EU_R2512; R2512
R80: R-EU_R1206; R1206
RA1: 10k; M1206
RA2, RA13, RA15: 330k; M1206
U1: 74LVC1G04; SOT23-5
U$11: ADUM1301; SO16WB
U$14: LT6656; SOT23-6
U$16: LTC1864; MS8
X1: HEADER_POS2_43650-0215; 43650-0215

Connections:
!CSADC: U1.2 (A), U$11.P$3 (I1); also elsewhere on the board
+5V: C3.2, C7.2, C31.+, DC5.2 (VIN+), U1.5 (VCC), U$11.P$1 (VDD1); also elsewhere on the board
B+5V: AC3.2, AC14.1, C33.+, D2.C, L3.2, LED4.A, U$11.P$10 (E2), U$11.P$16 (VDD2), U$14.4 (VIN), U$16.P$8 (VCC); also elsewhere on the board
B+5VL: C32.+, DC5.5 (VOUT+), L3.1
BACONV: U$11.P$14 (O1), U$16.P$5 (CONV)
BASCK: U$11.P$13 (O2), U$16.P$7 (SCK)
BASDO: U$11.P$12 (I3), U$16.P$6 (SDO)
BAT: RA15.1, X1.2; also elsewhere on the board
BATM: AC8.1, RA1.1, RA2.2, U$16.P$2 (IN+); also elsewhere on the board
BATM1: RA2.1, RA13.1
BATM3: RA13.2, RA15.2
BGND: AC3.1, AC4.1, AC8.2, AC14.2, C32.-, C33.-, D2.A, DC5.4 (VOUT-), R41.2, R77.2, R80.1, RA1.2, U$11.P$9 (GND2), U$11.P$15 (GND2), U$14.1 (GND), U$14.2 (GND), U$16.P$3 (IN-), U$16.P$4 (GND), X1.1; also elsewhere on the board
CSADC: U1.4 (Y), U$11.P$7 (E1)
GND: C3.1, C7.1, C31.-, C46.2, DC5.1 (VIN-), R77.1, U1.3 (GND), U$11.P$2 (GND1), U$11.P$8 (GND1); also elsewhere on the board
MISO: U$11.P$5 (O3); also elsewhere on the board
PLEDC4: LED4.C, R41.1
REF-4.096: AC4.2, U$14.6 (VOUT), U$16.P$1 (VREF)
SCK: U$11.P$4 (I2); also elsewhere on the board
SGNDGND1: C46.1, R80.2

Notes on the sheet:
Battery Output ADC
Licensed under: CC BY-NC-SA 3.0
You are free:
to Share - to copy, distribute and transmit the work
to Remix - to adapt the work
Under the following conditions:
the author or licensor (but not in any way that suggests that
Attribution - You must attribute the work in the manner specified by
they endorse you or your use of the work).
Noncommercial - You may not use this work for commercial purposes.
Share Alike - If you alter, transform, or build upon this work, you may
distribute the resulting work only under the same or similar license
to this one.
Full License: http://creativecommons.org/licenses/by-nc-sa/3.0/ or on Page 11 of Schematic
Copyright (C) 2012 David Brandt
Isolated DC-DC
Inverter for Chip Select
(To drive Output Enable of Isolator)
Optional Parts for extremely noise environments
Digital Isolator
Choke and Filter
Power LED and Zener
(For minimum load)
16 Bit SPI ADC
4.096V Reference
To Low Voltage Part / Microcontroller
1:100 Voltage Divider

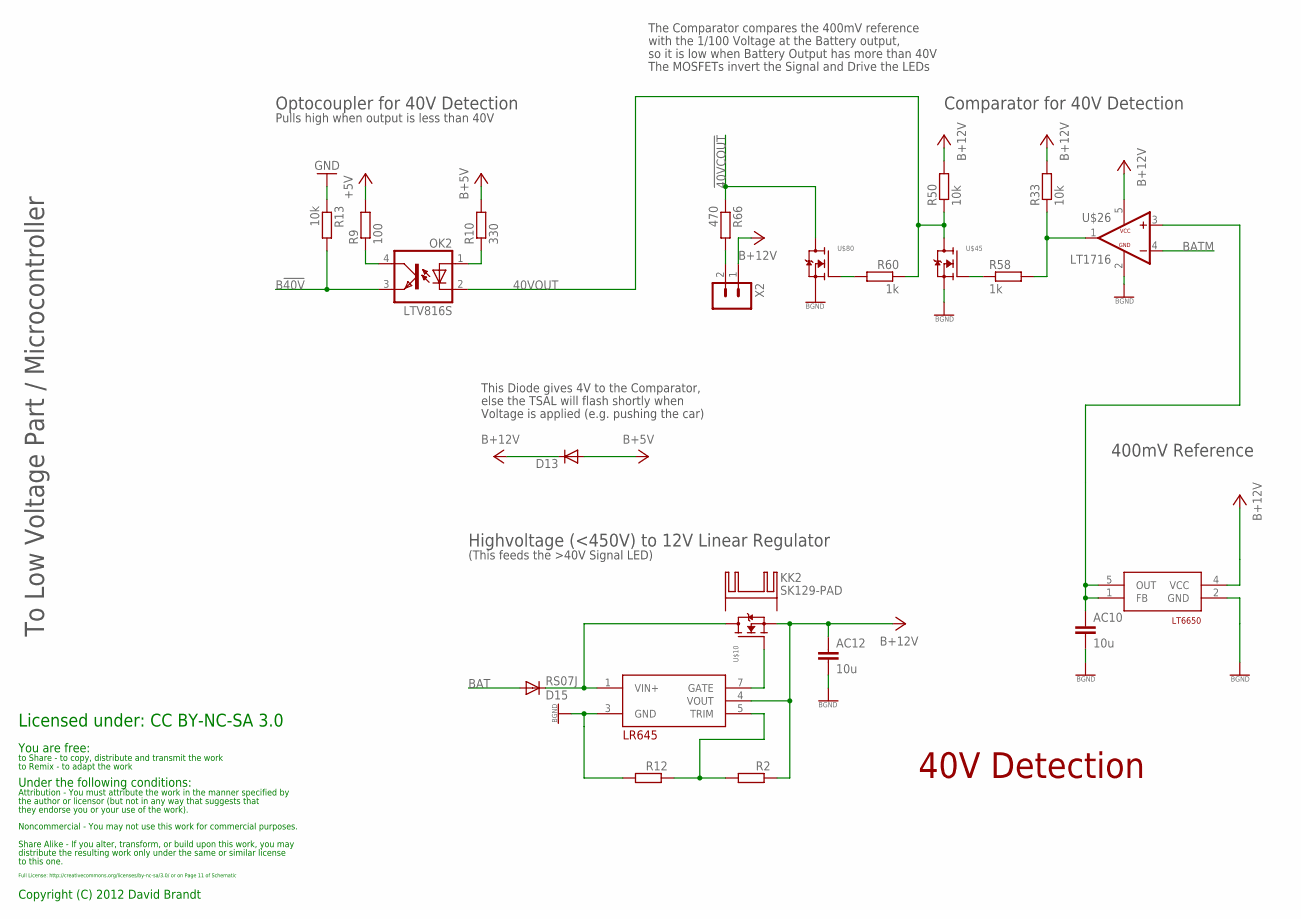
[picture p65: schematic masterV05a.sch, sheet 8]

Parts:
AC10, AC12: 10u; C1206K
D13: DIODE-SOD323-W; SOD323-W
D15: RS07J; DO-219AB
KK2: SK129-PAD; SK129
OK2: LTV816S; SMD4
R2, R12: R-EU_R0805; R0805
R9: 100; R0603
R10: 330; R0603
R13, R33, R50: 10k; R0603
R58, R60: 1k; R0603
R66: 470; R1206
U$6: LR645; SO-8
U$10: DN2540TO220; TO220V
U$26: LT1716; SOT23-5
U$28: LT6650; SOT23-5
U$45, U$80: 2N7002; SOT23
X2: HEADER_POS2_43650-0215; 43650-0215

Connections:
40VOUT: OK2.2 (C), R50.1, R60.1, U$45.3 (D)
!40VCOUT: R66.1, U$80.3 (D)
!40VCOUTW: R33.1, R58.2, U$26.1 (OUT)
+5V: R9.2; also elsewhere on the board
AVREF400MV: AC10.1, U$26.3 (+IN), U$28.1 (FB), U$28.5 (OUT)
B!40V: OK2.3 (EMIT), R13.2; also elsewhere on the board
B!40VE: OK2.4 (COL), R9.1
B+5V: D13.A, R10.2; also elsewhere on the board
B+12V: AC12.1, D13.C, R2.1, R33.2, R50.2, U$6.4 (VOUT), U$10.3 (S), U$26.5 (+5V), U$28.4 (VCC), X2.1
BAT: D15.A; also elsewhere on the board
BATD: D15.C, U$6.1 (VIN+), U$10.2 (D)
BATM: U$26.4 (-IN); also elsewhere on the board
BGND: AC10.2, AC12.2, R12.2, U$6.3 (GND), U$26.2 (GND), U$28.2 (GND), U$45.2 (S), U$80.2 (S); also elsewhere on the board
GND: R13.1; also elsewhere on the board
LR645_G: U$6.7 (GATE), U$10.1 (G)
LR645_TRIM: R2.2, R12.1, U$6.5 (TRIM)
unnamed: R58.1, U$45.1 (G)
unnamed: R60.2, U$80.1 (G)
unnamed: R66.2, X2.2
OK2A: OK2.1 (A), R10.1

Notes on the sheet:
Optocoupler for 40V Detection
40V Detection
Licensed under: CC BY-NC-SA 3.0
You are free:
to Share - to copy, distribute and transmit the work
to Remix - to adapt the work
Under the following conditions:
the author or licensor (but not in any way that suggests that
Attribution - You must attribute the work in the manner specified by
they endorse you or your use of the work).
Noncommercial - You may not use this work for commercial purposes.
Share Alike - If you alter, transform, or build upon this work, you may
distribute the resulting work only under the same or similar license
to this one.
Full License: http://creativecommons.org/licenses/by-nc-sa/3.0/ or on Page 11 of Schematic
Copyright (C) 2012 David Brandt
To Low Voltage Part / Microcontroller
This Diode gives 4V to the Comparator,
else the TSAL will flash shortly when
Voltage is applied (e.g. pushing the car)
Highvoltage (<450V) to 12V Linear Regulator
(This feeds the >40V Signal LED)
Comparator for 40V Detection
400mV Reference
The Comparator compares the 400mV reference
with the 1/100 Voltage at the Battery output,
so it is low when Battery Output has more than 40V
The MOSFETs invert the Signal and Drive the LEDs
Pulls high when output is less than 40V

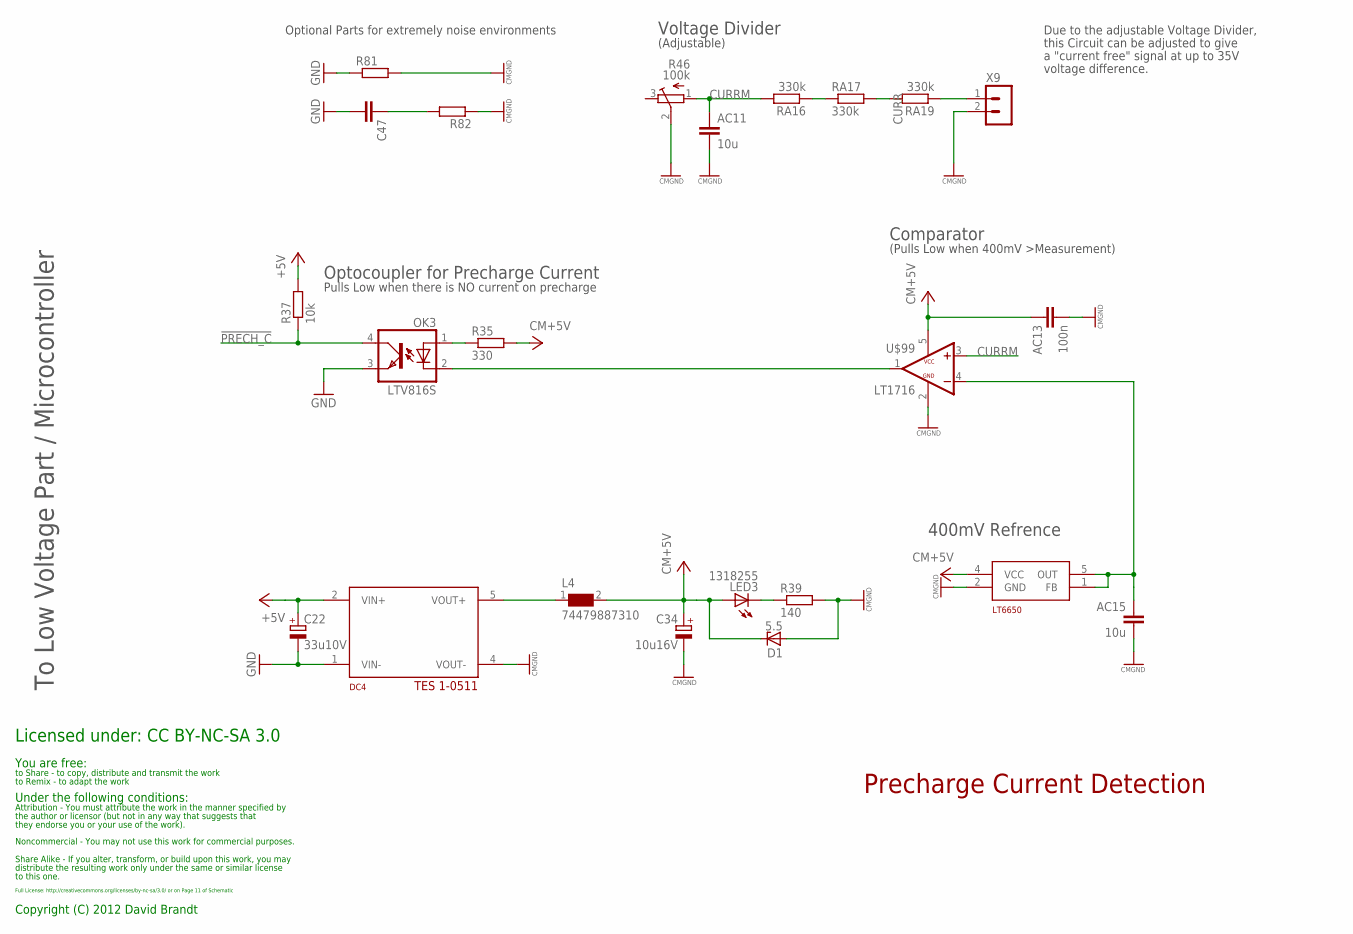
[picture p66: schematic masterV05a.sch, sheet 9]

Parts:
AC11, AC15: 10u; C1206K
AC13: 100n; C0603K
C22: 33u10V; PANASONIC_C
C34: 10u16V; PANASONIC_B
C47: C-EUC2220K; C2220K
D1: 5.5; SOD323-W
DC4: TES 1-0511; ISF
L4: 74479887310; WE-PMI_1008
LED3: 1318255; CHIPLED_1206
OK3: LTV816S; SMD4
R35: 330; R0603
R37: 10k; R0603
R39: 140; R1206
R46: 100k; 3223W
R81: R-EU_R2512; R2512
R82: R-EU_R1206; R1206
RA16, RA17, RA19: 330k; M1206
U$99: LT1716; SOT23-5
U$101: LT6650; SOT23-5
X9: HEADER_POS2_43650-0215; 43650-0215

Connections:
!PRECH_C: OK3.4 (COL), R37.1; also elsewhere on the board
+5V: C22.+, DC4.2 (VIN+), R37.2; also elsewhere on the board
AVREF3: AC15.1, U$99.4 (-IN), U$101.1 (FB), U$101.5 (OUT)
CM+5V: AC13.1, C34.+, D1.C, L4.2, LED3.A, R35.2, U$99.5 (+5V), U$101.4 (VCC)
CM+5VL: DC4.5 (VOUT+), L4.1
CMGND: AC11.2, AC13.2, AC15.2, C34.-, D1.A, DC4.4 (VOUT-), R39.2, R46.2 (S), R81.2, R82.1, U$99.2 (GND), U$101.2 (GND), X9.2
CURR: RA19.1, X9.1
CURRM: AC11.1, R46.1 (A), RA16.2, U$99.3 (+IN)
CURRM4: RA16.1, RA17.1
CURRM7: RA17.2, RA19.2
GND: C22.-, C47.2, DC4.1 (VIN-), OK3.3 (EMIT), R81.1; also elsewhere on the board
OPTOLED: OK3.1 (A), R35.1
PLEDC3: LED3.C, R39.1
PRECHARGEOPTO: OK3.2 (C), U$99.1 (OUT)
SGNDGND2: C47.1, R82.2

Notes on the sheet:
Precharge Current Detection
Licensed under: CC BY-NC-SA 3.0
You are free:
to Share - to copy, distribute and transmit the work
to Remix - to adapt the work
Under the following conditions:
the author or licensor (but not in any way that suggests that
Attribution - You must attribute the work in the manner specified by
they endorse you or your use of the work).
Noncommercial - You may not use this work for commercial purposes.
Share Alike - If you alter, transform, or build upon this work, you may
distribute the resulting work only under the same or similar license
to this one.
Full License: http://creativecommons.org/licenses/by-nc-sa/3.0/ or on Page 11 of Schematic
Copyright (C) 2012 David Brandt
Optional Parts for extremely noise environments
Optocoupler for Precharge Current
Pulls Low when there is NO current on precharge
400mV Refrence
Comparator
(Pulls Low when 400mV >Measurement)
Voltage Divider
(Adjustable)
To Low Voltage Part / Microcontroller
Due to the adjustable Voltage Divider,
this Circuit can be adjusted to give
a "current free" signal at up to 35V
voltage difference.

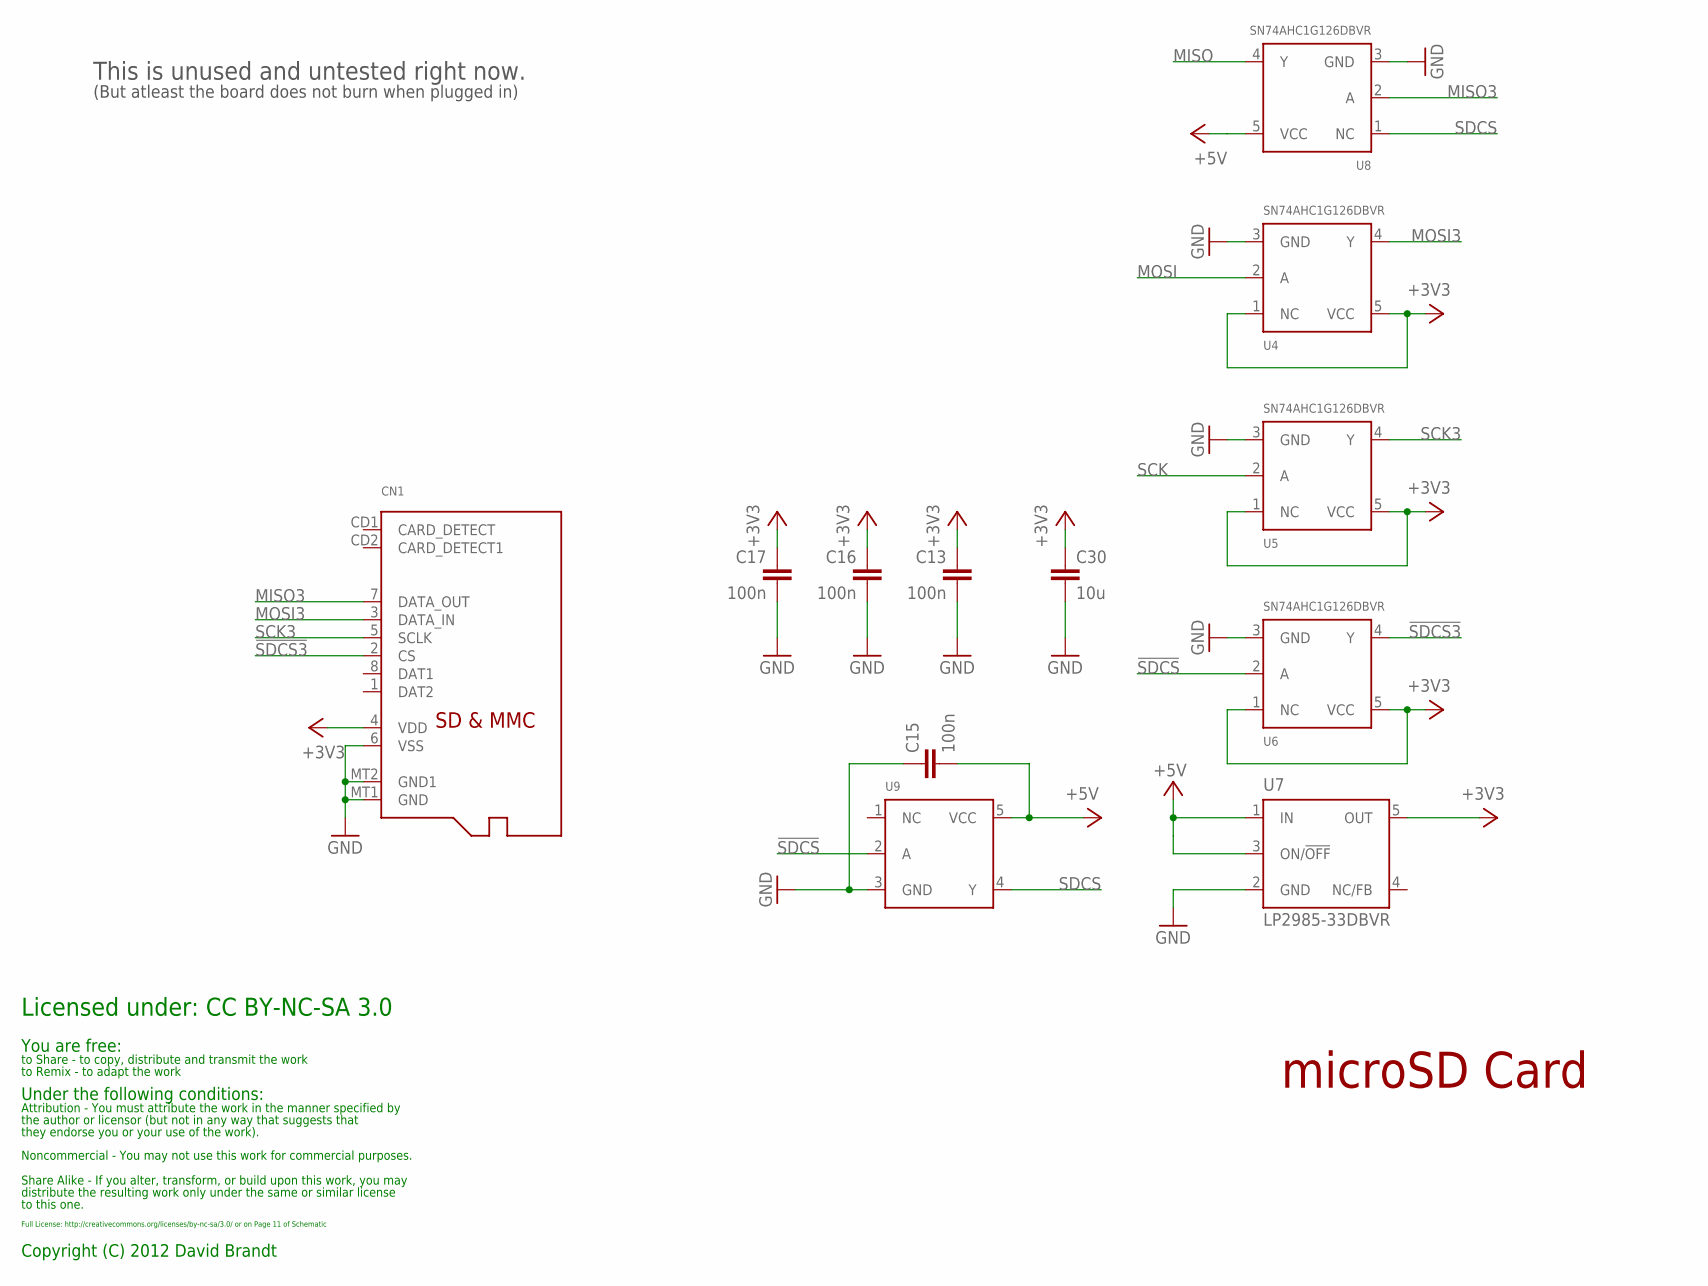
[picture p67: schematic masterV05a.sch, sheet 10]

Parts:
C13, C16, C17: 100n; C0603
C15: 100n; C0603K
C30: 10u; C1206
CN1: MICROSD
U4, U5, U6, U8: SN74AHC1G126DBVR; SOT23-5
U7: LP2985-33DBVR; SOT23-DBV
U9: 74LVC1G04; SOT23-5

Connections:
!SDCS: U6.2 (A), U9.2 (A); also elsewhere on the board
!SDCS3: CN1.2 (CS), U6.4 (Y)
+3V3: C13.1, C16.1, C17.1, C30.1, CN1.4 (VDD), U4.1 (NC), U4.5 (VCC), U5.1 (NC), U5.5 (VCC), U6.1 (NC), U6.5 (VCC), U7.5 (OUT)
+5V: C15.2, U7.1 (IN), U7.3 (ON/!OFF), U8.5 (VCC), U9.5 (VCC); also elsewhere on the board
GND: C13.2, C15.1, C16.2, C17.2, C30.2, CN1.6 (VSS), CN1.MT1 (GND), CN1.MT2 (GND1), U4.3 (GND), U5.3 (GND), U6.3 (GND), U7.2 (GND), U8.3 (GND), U9.3 (GND); also elsewhere on the board
MISO: U8.4 (Y); also elsewhere on the board
MISO3: CN1.7 (DATA_OUT), U8.2 (A)
MOSI: U4.2 (A); also elsewhere on the board
MOSI3: CN1.3 (DATA_IN), U4.4 (Y)
SCK: U5.2 (A); also elsewhere on the board
SCK3: CN1.5 (SCLK), U5.4 (Y)
SDCS: U8.1 (NC), U9.4 (Y)

Notes on the sheet:
This is unused and untested right now.
microSD Card
Licensed under: CC BY-NC-SA 3.0
You are free:
to Share - to copy, distribute and transmit the work
to Remix - to adapt the work
Under the following conditions:
the author or licensor (but not in any way that suggests that
Attribution - You must attribute the work in the manner specified by
they endorse you or your use of the work).
Noncommercial - You may not use this work for commercial purposes.
Share Alike - If you alter, transform, or build upon this work, you may
distribute the resulting work only under the same or similar license
to this one.
Full License: http://creativecommons.org/licenses/by-nc-sa/3.0/ or on Page 11 of Schematic
Copyright (C) 2012 David Brandt
(But atleast the board does not burn when plugged in)


Notes on the sheet:
Creative Commons Legal Code
Attribution-NonCommercial-ShareAlike 3.0 Unported
CREATIVE COMMONS CORPORATION IS NOT A LAW FIRM AND DOES NOT PROVIDE
LEGAL SERVICES. DISTRIBUTION OF THIS LICENSE DOES NOT CREATE AN
ATTORNEY-CLIENT RELATIONSHIP. CREATIVE COMMONS PROVIDES THIS
INFORMATION ON AN "AS-IS" BASIS. CREATIVE COMMONS MAKES NO WARRANTIES
REGARDING THE INFORMATION PROVIDED, AND DISCLAIMS LIABILITY FOR
DAMAGES RESULTING FROM ITS USE.
License
THE WORK (AS DEFINED BELOW) IS PROVIDED UNDER THE TERMS OF THIS CREATIVE
COMMONS PUBLIC LICENSE ("CCPL" OR "LICENSE"). THE WORK IS PROTECTED BY
COPYRIGHT AND/OR OTHER APPLICABLE LAW. ANY USE OF THE WORK OTHER THAN AS
AUTHORIZED UNDER THIS LICENSE OR COPYRIGHT LAW IS PROHIBITED.
BY EXERCISING ANY RIGHTS TO THE WORK PROVIDED HERE, YOU ACCEPT AND AGREE
TO BE BOUND BY THE TERMS OF THIS LICENSE. TO THE EXTENT THIS LICENSE MAY
BE CONSIDERED TO BE A CONTRACT, THE LICENSOR GRANTS YOU THE RIGHTS
CONTAINED HERE IN CONSIDERATION OF YOUR ACCEPTANCE OF SUCH TERMS AND
CONDITIONS.
1. Definitions
a. "Adaptation" means a work based upon the Work, or upon the Work and
other pre-existing works, such as a translation, adaptation,
derivative work, arrangement of music or other alterations of a
literary or artistic work, or phonogram or performance and includes
cinematographic adaptations or any other form in which the Work may be
recast, transformed, or adapted including in any form recognizably
derived from the original, except that a work that constitutes a
Collection will not be considered an Adaptation for the purpose of
this License. For the avoidance of doubt, where the Work is a musical
work, performance or phonogram, the synchronization of the Work in
timed-relation with a moving image ("synching") will be considered an
Adaptation for the purpose of this License.
b. "Collection" means a collection of literary or artistic works, such as
encyclopedias and anthologies, or performances, phonograms or
broadcasts, or other works or subject matter other than works listed
in Section 1(g) below, which, by reason of the selection and
arrangement of their contents, constitute intellectual creations, in
which the Work is included in its entirety in unmodified form along
with one or more other contributions, each constituting separate and
independent works in themselves, which together are assembled into a
collective whole. A work that constitutes a Collection will not be
considered an Adaptation (as defined above) for the purposes of this
License.
c. "Distribute" means to make available to the public the original and
copies of the Work or Adaptation, as appropriate, through sale or
other transfer of ownership.
d. "License Elements" means the following high-level license attributes
as selected by Licensor and indicated in the title of this License:
Attribution, Noncommercial, ShareAlike.
e. "Licensor" means the individual, individuals, entity or entities that
offer(s) the Work under the terms of this License.
f. "Original Author" means, in the case of a literary or artistic work,
the individual, individuals, entity or entities who created the Work
or if no individual or entity can be identified, the publisher; and in
addition (i) in the case of a performance the actors, singers,
musicians, dancers, and other persons who act, sing, deliver, declaim,
play in, interpret or otherwise perform literary or artistic works or
expressions of folklore; (ii) in the case of a phonogram the producer
being the person or legal entity who first fixes the sounds of a
performance or other sounds; and, (iii) in the case of broadcasts, the
organization that transmits the broadcast.
g. "Work" means the literary and/or artistic work offered under the terms
of this License including without limitation any production in the
literary, scientific and artistic domain, whatever may be the mode or
form of its expression including digital form, such as a book,
pamphlet and other writing; a lecture, address, sermon or other work
of the same nature; a dramatic or dramatico-musical work; a
choreographic work or entertainment in dumb show; a musical
composition with or without words; a cinematographic work to which are
assimilated works expressed by a process analogous to cinematography;
a work of drawing, painting, architecture, sculpture, engraving or
lithography; a photographic work to which are assimilated works
expressed by a process analogous to photography; a work of applied
art; an illustration, map, plan, sketch or three-dimensional work
relative to geography, topography, architecture or science; a
performance; a broadcast; a phonogram; a compilation of data to the
extent it is protected as a copyrightable work; or a work performed by
a variety or circus performer to the extent it is not otherwise
considered a literary or artistic work.
h. "You" means an individual or entity exercising rights under this
License who has not previously violated the terms of this License with
respect to the Work, or who has received express permission from the
Licensor to exercise rights under this License despite a previous
violation.
i. "Publicly Perform" means to perform public recitations of the Work and
to communicate to the public those public recitations, by any means or
process, including by wire or wireless means or public digital
performances; to make available to the public Works in such a way that
members of the public may access these Works from a place and at a
place individually chosen by them; to perform the Work to the public
by any means or process and the communication to the public of the
performances of the Work, including by public digital performance; to
broadcast and rebroadcast the Work by any means including signs,
sounds or images.
j. "Reproduce" means to make copies of the Work by any means including
without limitation by sound or visual recordings and the right of
fixation and reproducing fixations of the Work, including storage of a
protected performance or phonogram in digital form or other electronic
medium.
2. Fair Dealing Rights. Nothing in this License is intended to reduce,
limit, or restrict any uses free from copyright or rights arising from
limitations or exceptions that are provided for in connection with the
copyright protection under copyright law or other applicable laws.
3. License Grant. Subject to the terms and conditions of this License,
Licensor hereby grants You a worldwide, royalty-free, non-exclusive,
perpetual (for the duration of the applicable copyright) license to
exercise the rights in the Work as stated below:
a. to Reproduce the Work, to incorporate the Work into one or more
Collections, and to Reproduce the Work as incorporated in the
Collections;
b. to create and Reproduce Adaptations provided that any such Adaptation,
including any translation in any medium, takes reasonable steps to
clearly label, demarcate or otherwise identify that changes were made
to the original Work. For example, a translation could be marked "The
original work was translated from English to Spanish," or a
modification could indicate "The original work has been modified.";
c. to Distribute and Publicly Perform the Work including as incorporated
in Collections; and,
d. to Distribute and Publicly Perform Adaptations.
The above rights may be exercised in all media and formats whether now
known or hereafter devised. The above rights include the right to make
such modifications as are technically necessary to exercise the rights in
other media and formats. Subject to Section 8(f), all rights not expressly
granted by Licensor are hereby reserved, including but not limited to the
rights described in Section 4(e).
4. Restrictions. The license granted in Section 3 above is expressly made
subject to and limited by the following restrictions:
a. You may Distribute or Publicly Perform the Work only under the terms
of this License. You must include a copy of, or the Uniform Resource
Identifier (URI) for, this License with every copy of the Work You
Distribute or Publicly Perform. You may not offer or impose any terms
on the Work that restrict the terms of this License or the ability of
the recipient of the Work to exercise the rights granted to that
recipient under the terms of the License. You may not sublicense the
Work. You must keep intact all notices that refer to this License and
to the disclaimer of warranties with every copy of the Work You
Distribute or Publicly Perform. When You Distribute or Publicly
Perform the Work, You may not impose any effective technological
measures on the Work that restrict the ability of a recipient of the
Work from You to exercise the rights granted to that recipient under
the terms of the License. This Section 4(a) applies to the Work as
incorporated in a Collection, but this does not require the Collection
apart from the Work itself to be made subject to the terms of this
License. If You create a Collection, upon notice from any Licensor You
must, to the extent practicable, remove from the Collection any credit
as required by Section 4(d), as requested. If You create an
Adaptation, upon notice from any Licensor You must, to the extent
practicable, remove from the Adaptation any credit as required by
Section 4(d), as requested.
b. You may Distribute or Publicly Perform an Adaptation only under: (i)
the terms of this License; (ii) a later version of this License with
the same License Elements as this License; (iii) a Creative Commons
jurisdiction license (either this or a later license version) that
contains the same License Elements as this License (e.g.,
Attribution-NonCommercial-ShareAlike 3.0 US) ("Applicable License").
You must include a copy of, or the URI, for Applicable License with
every copy of each Adaptation You Distribute or Publicly Perform. You
may not offer or impose any terms on the Adaptation that restrict the
terms of the Applicable License or the ability of the recipient of the
Adaptation to exercise the rights granted to that recipient under the
terms of the Applicable License. You must keep intact all notices that
refer to the Applicable License and to the disclaimer of warranties
with every copy of the Work as included in the Adaptation You
Perform the Adaptation, You may not impose any effective technological
measures on the Adaptation that restrict the ability of a recipient of
the Adaptation from You to exercise the rights granted to that
recipient under the terms of the Applicable License. This Section 4(b)
applies to the Adaptation as incorporated in a Collection, but this
does not require the Collection apart from the Adaptation itself to be
made subject to the terms of the Applicable License.
c. You may not exercise any of the rights granted to You in Section 3
above in any manner that is primarily intended for or directed toward
commercial advantage or private monetary compensation. The exchange of
the Work for other copyrighted works by means of digital file-sharing
or otherwise shall not be considered to be intended for or directed
toward commercial advantage or private monetary compensation, provided
there is no payment of any monetary compensation in con-nection with
the exchange of copyrighted works.
d. If You Distribute, or Publicly Perform the Work or any Adaptations or
Collections, You must, unless a request has been made pursuant to
Section 4(a), keep intact all copyright notices for the Work and
provide, reasonable to the medium or means You are utilizing: (i) the
name of the Original Author (or pseudonym, if applicable) if supplied,
and/or if the Original Author and/or Licensor designate another party
or parties (e.g., a sponsor institute, publishing entity, journal) for
attribution ("Attribution Parties") in Licensor's copyright notice,
terms of service or by other reasonable means, the name of such party
or parties; (ii) the title of the Work if supplied; (iii) to the
extent reasonably practicable, the URI, if any, that Licensor
specifies to be associated with the Work, unless such URI does not
refer to the copyright notice or licensing information for the Work;
and, (iv) consistent with Section 3(b), in the case of an Adaptation,
a credit identifying the use of the Work in the Adaptation (e.g.,
"French translation of the Work by Original Author," or "Screenplay
based on original Work by Original Author"). The credit required by
this Section 4(d) may be implemented in any reasonable manner;
provided, however, that in the case of a Adaptation or Collection, at
a minimum such credit will appear, if a credit for all contributing
authors of the Adaptation or Collection appears, then as part of these
credits and in a manner at least as prominent as the credits for the
other contributing authors. For the avoidance of doubt, You may only

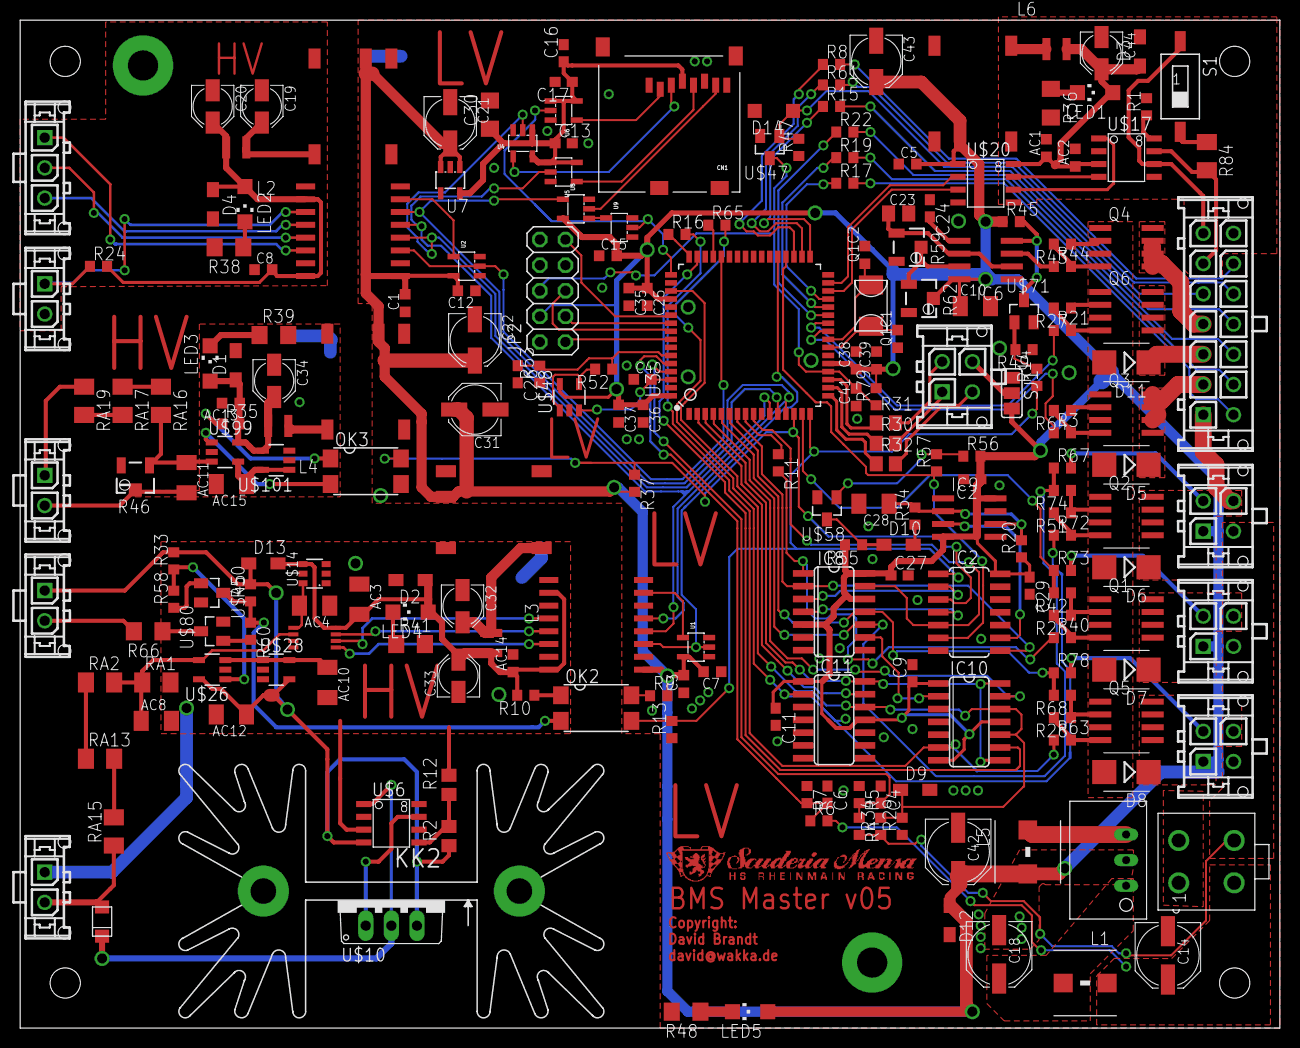
[picture p68: board masterV05a.brd from above]

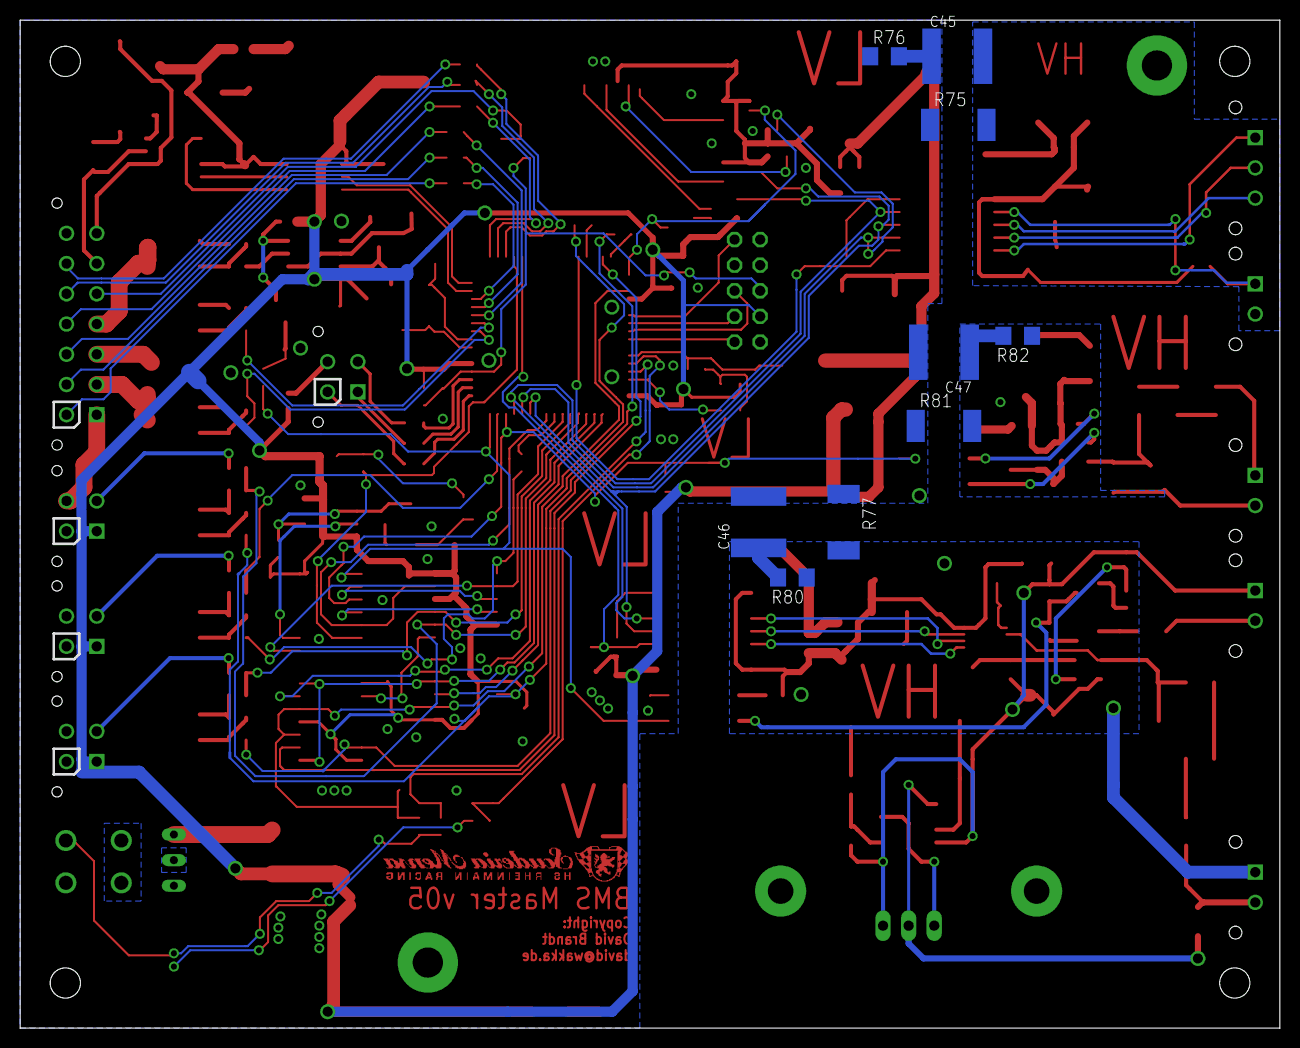
[picture p69: board masterV05a.brd from below]

Board: 2 copper layers, 125.0 x 100.0 mm, 234 parts (9 on the bottom side), 162 nets.

Other parts of the board:
U$1000: SMLOGOS
