funkobongrip/sprbms/hardware/can/canSlaveV03_4s.brd

## EAGLE design hardware/can/canSlaveV03_4s.brd (2016-02-18)

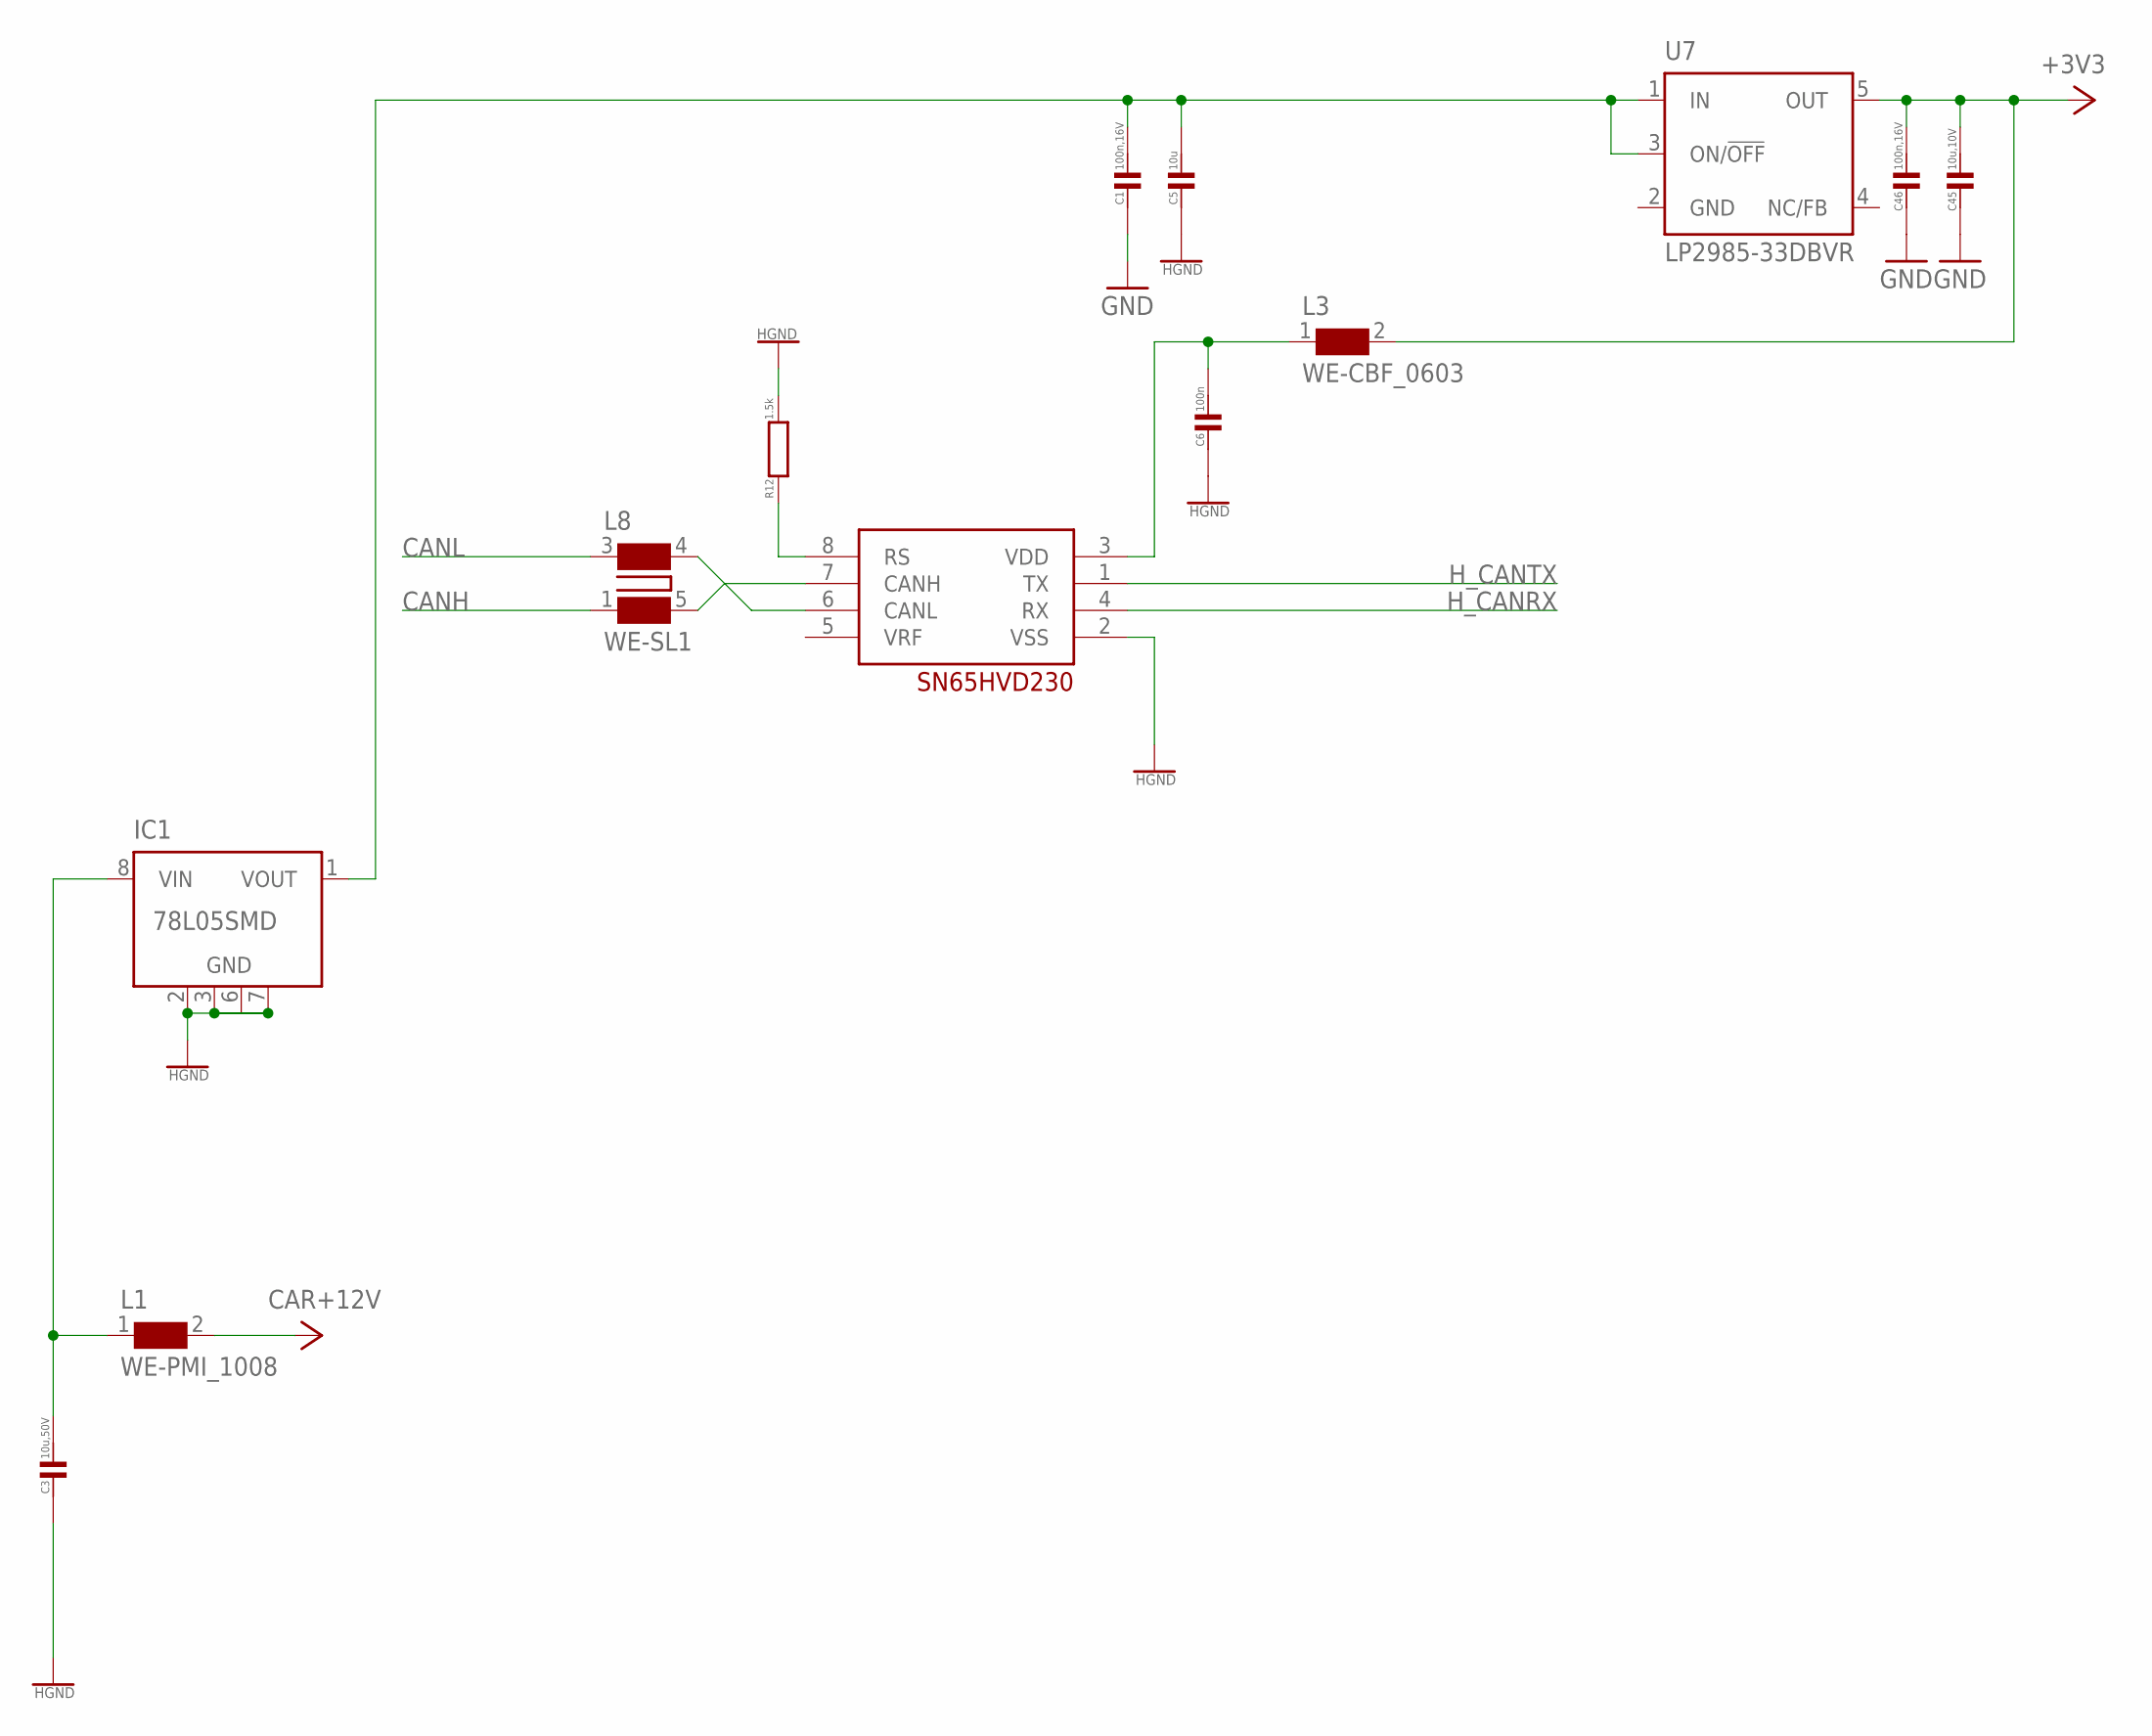
[picture p70: schematic canSlaveV03_4s.sch, sheet 1]

Parts:
C1, C46: 100n,16V; C0603
C3: 10u,50V; C1206
C5: 10u; C0603
C6: 100n; C0603
C45: 10u,10V; C0603
IC1: 78L05SMD; SO08
IC4: SN65HVD230; SO-8
L1: WE-PMI_1008
L3: WE-CBF_0603; 0603
L8: WE-SL1
R12: 1.5k; R0603
U7: LP2985-33DBVR; SOT23-DBV

Connections:
CANH: L8.1; also elsewhere on the board
CANL: L8.3; also elsewhere on the board
CAR+5V: C1.1, C5.1, IC1.1 (VOUT), U7.1 (IN), U7.3 (ON/!OFF)
CAR+5V_H: C6.1, IC4.3 (VDD), L3.1
CAR+12V: L1.2; also elsewhere on the board
CAR+12VFILT: C3.1, IC1.8 (VIN), L1.1
H+3V3: C45.1, C46.1, L3.2, U7.5 (OUT); also elsewhere on the board
HCANHL: IC4.7 (CANH), L8.5 (2)
HCANLL: IC4.6 (CANL), L8.4
HGND: C1.2, C3.2, C5.2, C6.2, C45.2, C46.2, IC1.2 (GND), IC1.3 (GND), IC1.6 (GND), IC1.7 (GND), IC4.2 (VSS), R12.2, U7.2 (GND); also elsewhere on the board
H_CANRX: IC4.4 (RX); also elsewhere on the board
H_CANTX: IC4.1 (TX); also elsewhere on the board
RS: IC4.8 (RS), R12.1

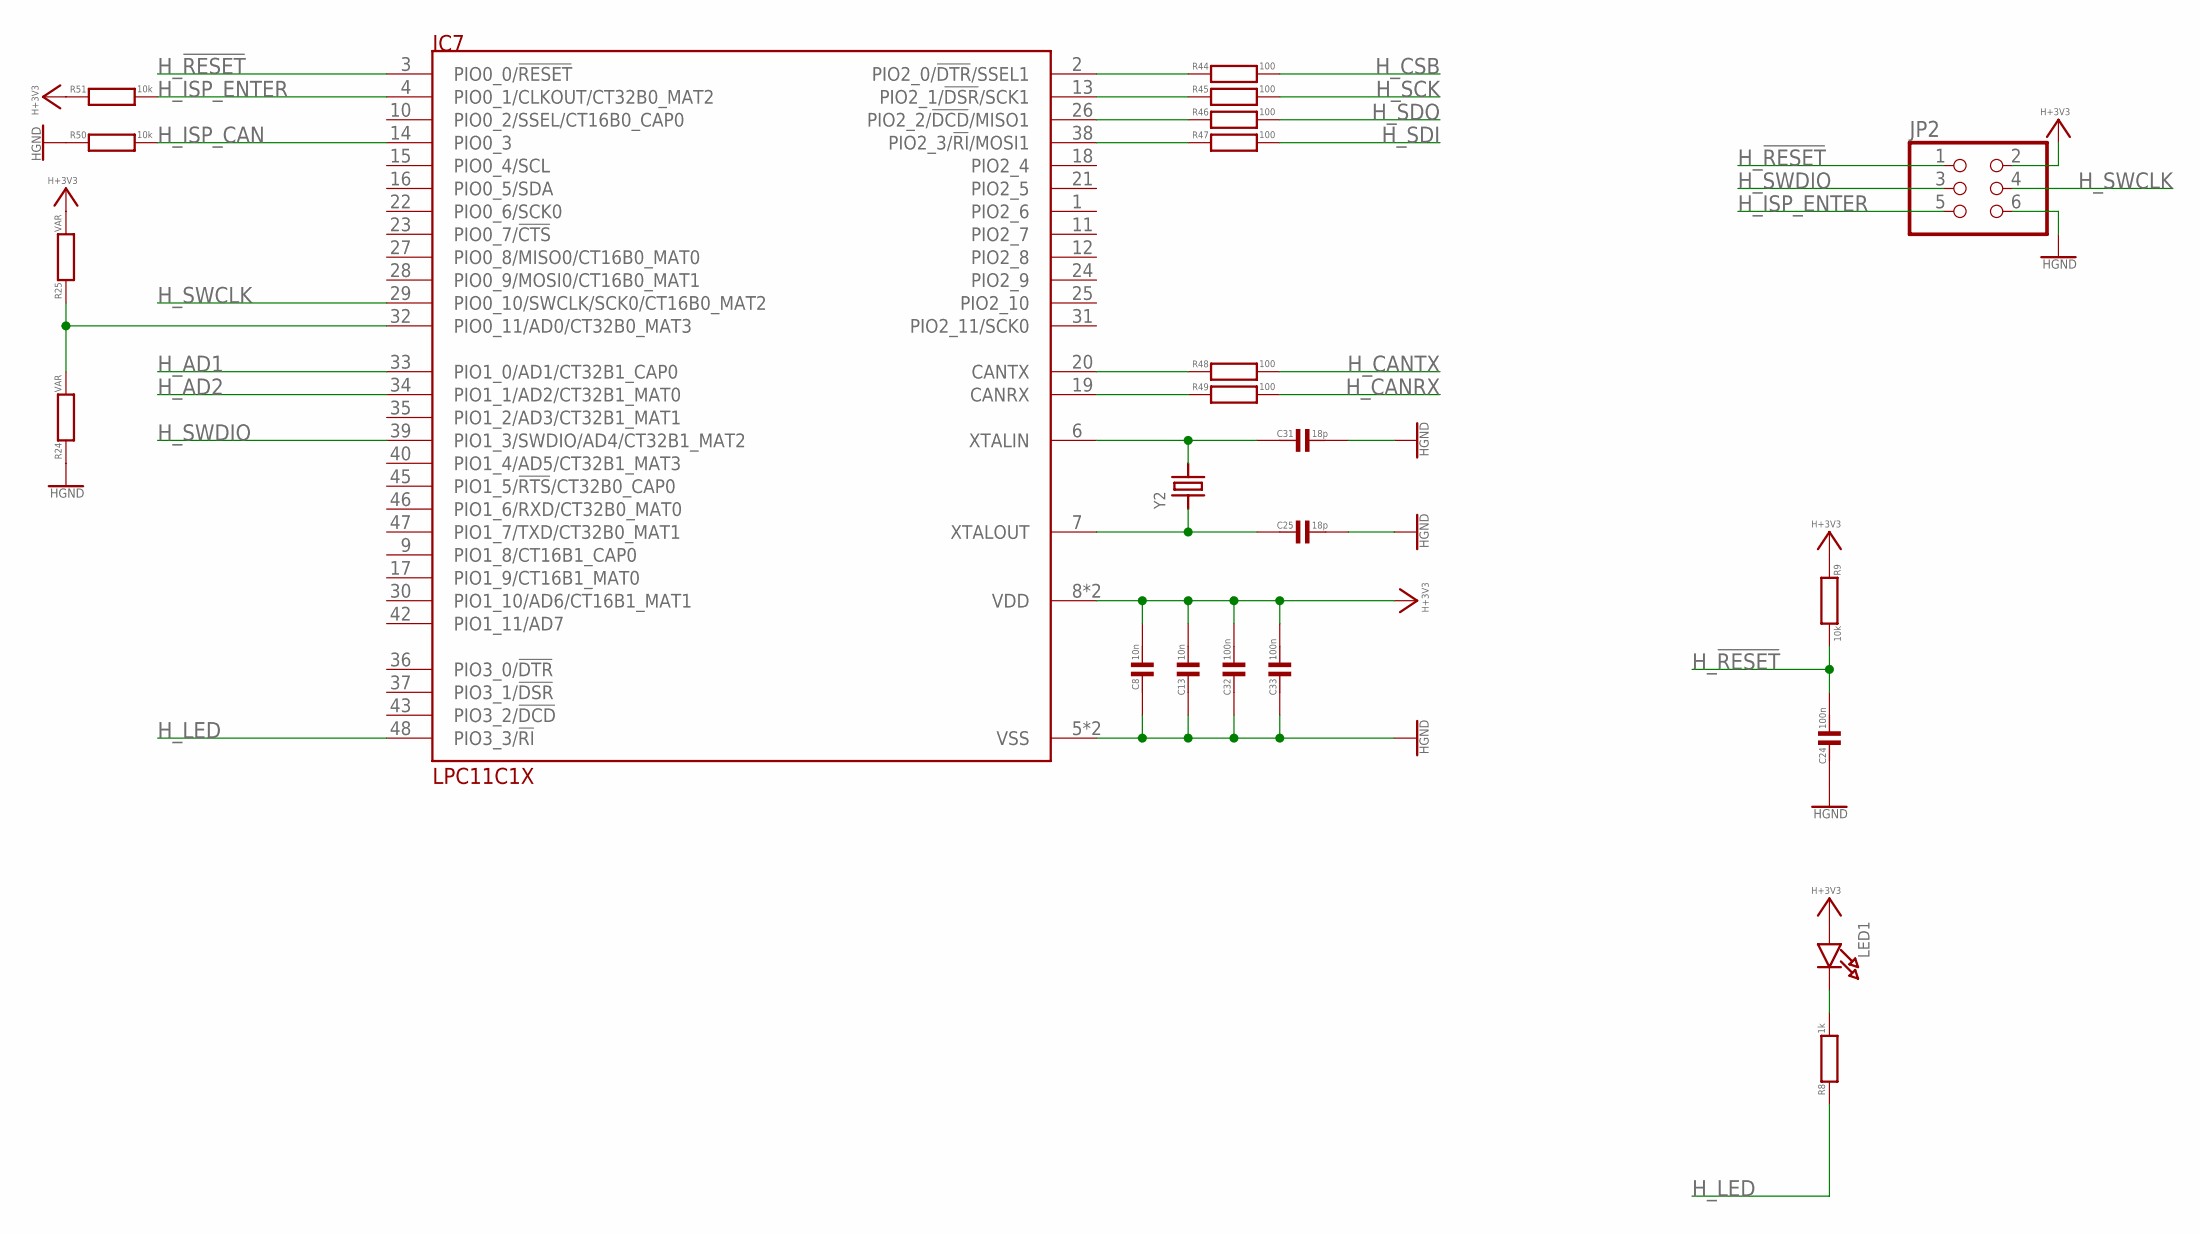
[picture p71: schematic canSlaveV03_4s.sch, sheet 2]

Parts:
C8, C13: 10n; C0603
C24, C32, C33: 100n; C0603
C25, C31: 18p; C0603
IC7: LPC11C1X; LQFP48
JP2: HEADER-2X31.27; 2X03_1.27MM_SMT
LED1: LED0603; CHIPLED_0603
R8: 1k; R0603
R9, R50, R51: 10k; R0603
R24, R25: VAR; R0603
R44, R45, R46, R47, R48, R49: 100; R0603
Y2: CRYSTALTHIN; CRYSTAL_3.2X2.5

Connections:
CANRX_U_H: IC7.19 (CANRX), R49.1
CANTX_U_H: IC7.20 (CANTX), R48.1
H+3V3: C8.1, C13.1, C32.1, C33.1, IC7.8 (VDD), IC7.44 (VDD), JP2.2, LED1.A, R9.1, R25.2, R51.1; also elsewhere on the board
HGND: C8.2, C13.2, C24.2, C25.1, C31.1, C32.2, C33.2, IC7.5 (VSS), IC7.41 (VSS), JP2.6, R24.1, R50.1; also elsewhere on the board
H_!RESET: C24.1, IC7.3 (PIO0_0/!RESET), JP2.1, R9.2
H_AD1: IC7.33 (PIO1_0/AD1/CT32B1_CAP0); also elsewhere on the board
H_AD2: IC7.34 (PIO1_1/AD2/CT32B1_MAT0)
H_ADR: IC7.32 (PIO0_11/AD0/CT32B0_MAT3), R24.2, R25.1
H_CANRX: R49.2; also elsewhere on the board
H_CANTX: R48.2; also elsewhere on the board
H_CSB: R44.2; also elsewhere on the board
H_ISP_CAN: IC7.14 (PIO0_3), R50.2
H_ISP_ENTER: IC7.4 (PIO0_1/CLKOUT/CT32B0_MAT2), JP2.5, R51.2
H_LED: IC7.48 (PIO3_3/!RI), R8.1
H_MISO: IC7.26 (PIO2_2/!DCD!/MISO1), R46.1
H_MOSI: IC7.38 (PIO2_3/!RI!/MOSI1), R47.1
H_SCK: R45.2; also elsewhere on the board
H_SCK1: IC7.13 (PIO2_1/!DSR!/SCK1), R45.1
H_SDI: R47.2; also elsewhere on the board
H_SDO: R46.2; also elsewhere on the board
H_SSEL: IC7.2 (PIO2_0/!DTR!/SSEL1), R44.1
H_SWCLK: IC7.29 (PIO0_10/SWCLK/SCK0/CT16B0_MAT2), JP2.4
H_SWDIO: IC7.39 (PIO1_3/SWDIO/AD4/CT32B1_MAT2), JP2.3
LED1C1: LED1.C, R8.2
XTALIN1: C31.2, IC7.6 (XTALIN), Y2.2
XTALOUT1: C25.2, IC7.7 (XTALOUT), Y2.1

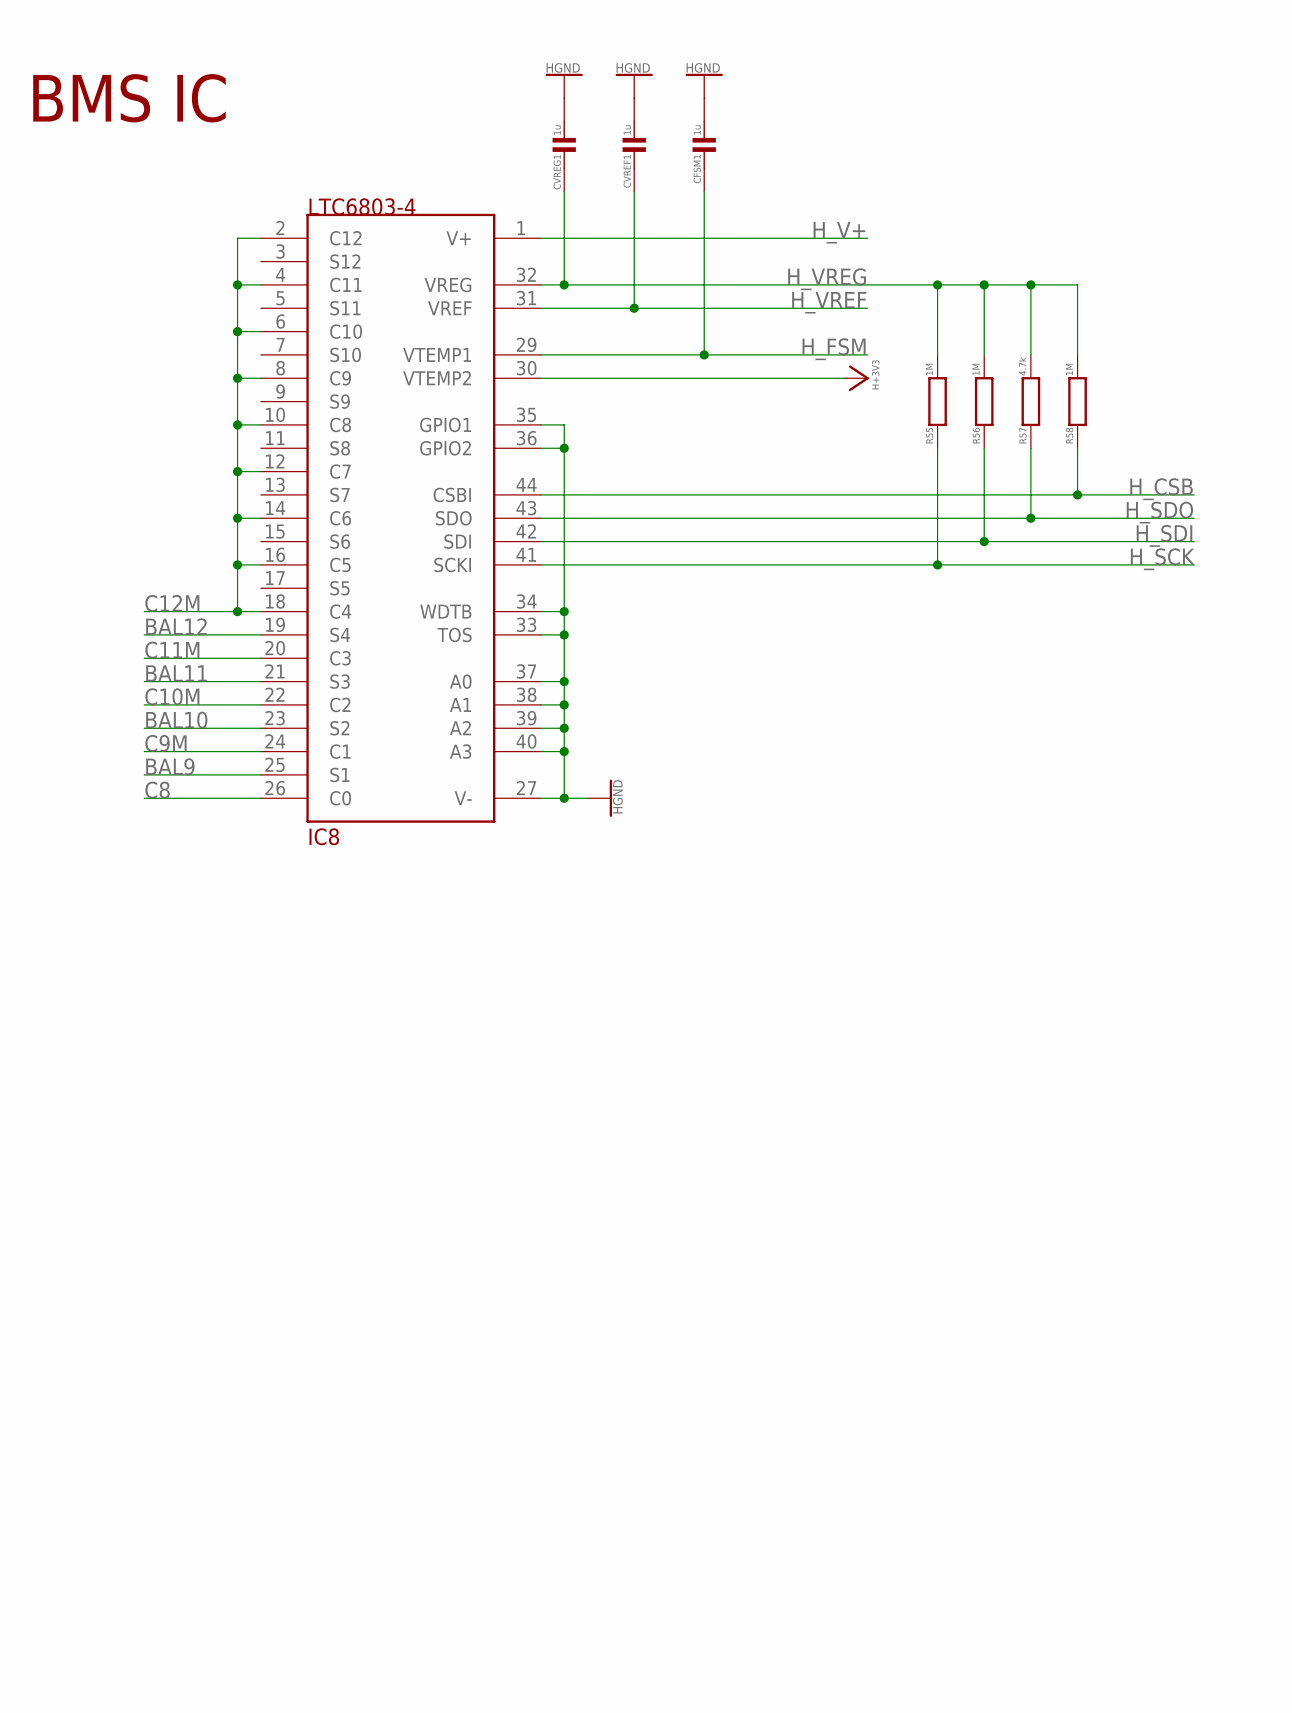
[picture p72: schematic canSlaveV03_4s.sch, sheet 3, part in row 1, column 1]

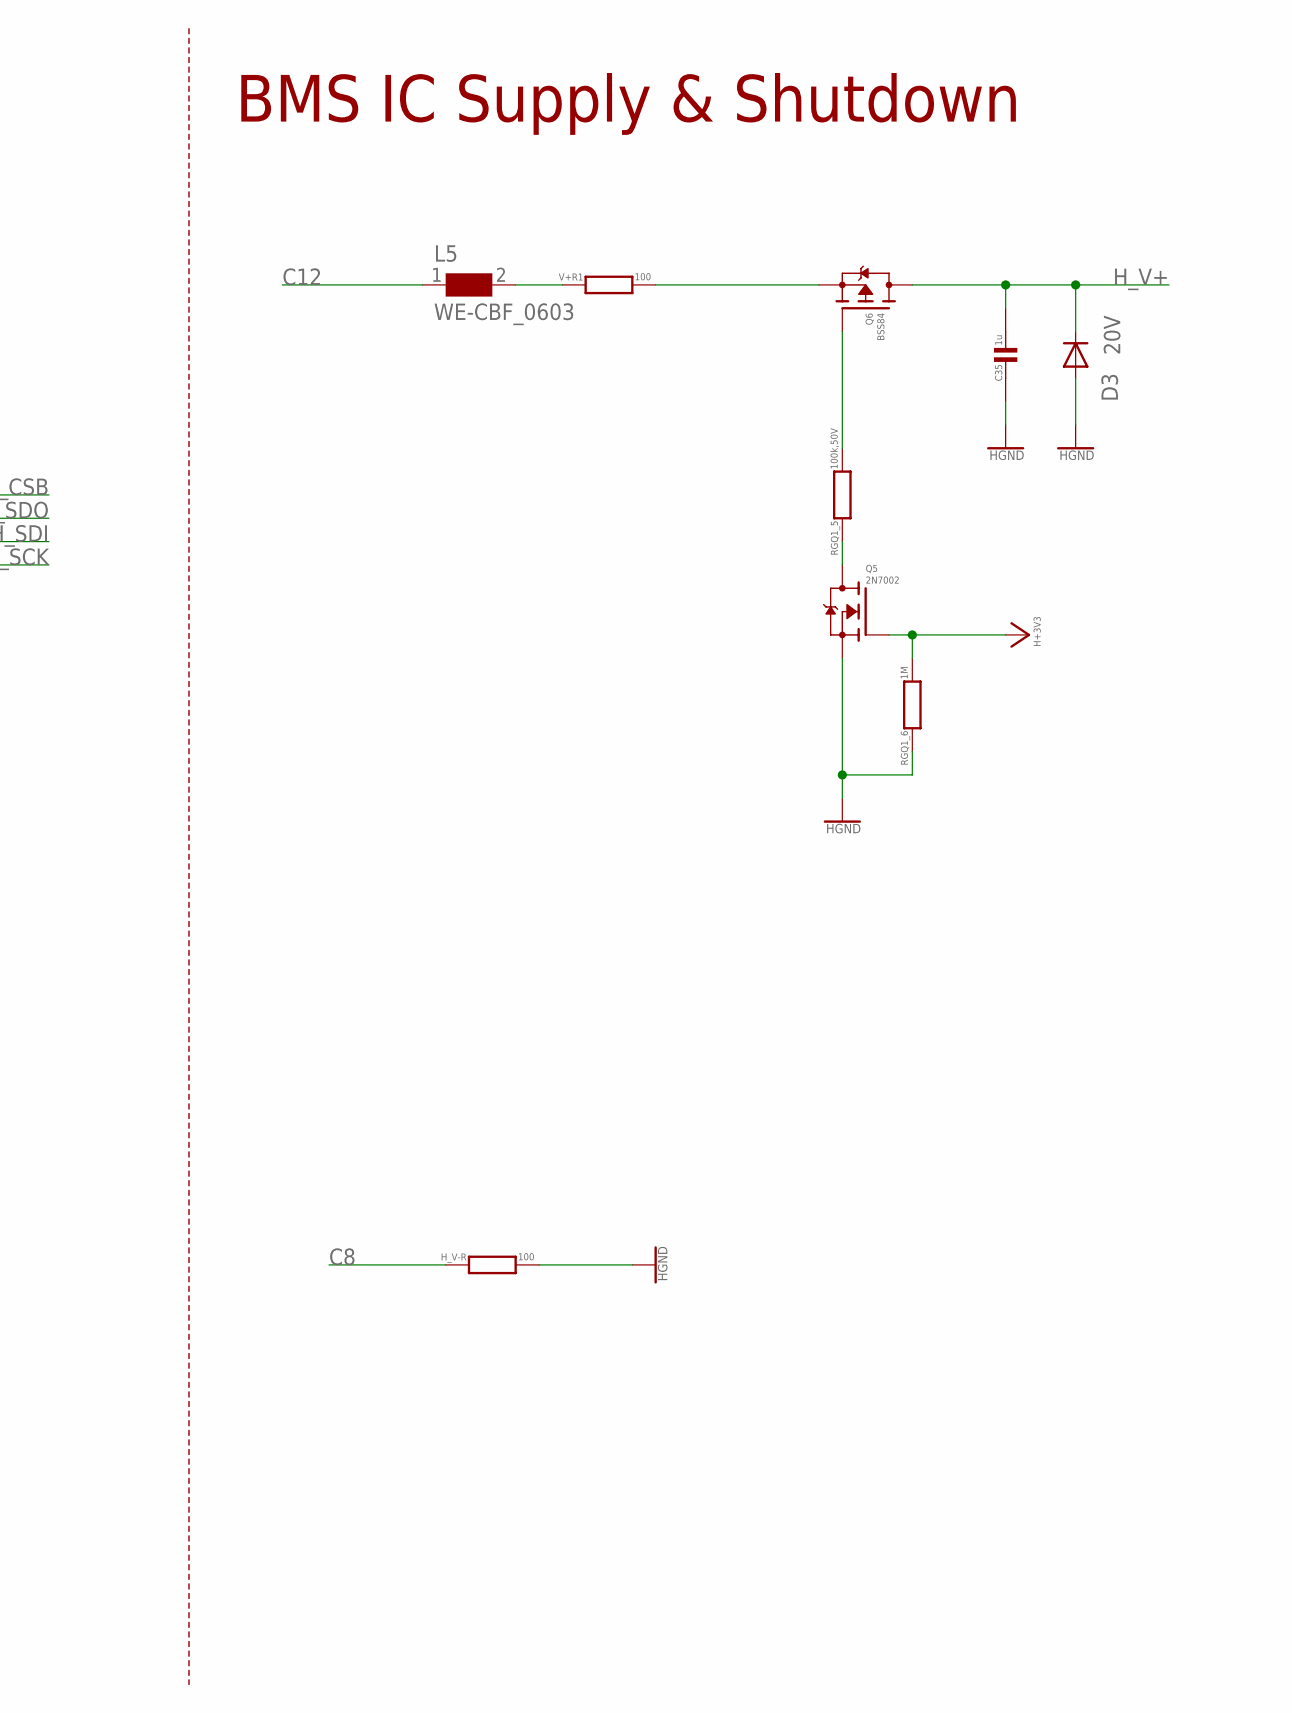
[picture p73: schematic canSlaveV03_4s.sch, sheet 3, part in row 1, column 2]

Parts:
C35: 1u; C0603
CFSM1: 1u; C0603
CVREF1: 1u; C0603
CVREG1: 1u; C0603
D3: 20V; SOD323-R
H_V-R: 100; R0603
IC8: LTC6803-4; 44SSOP
L5: WE-CBF_0603; 0603
Q5: 2N7002; SOT23
Q6: BSS84; SOT23
R55, R56, R58: 1M; R0603
R57: 4.7k; R0603
RGQ1_5: 100k,50V; R0603
RGQ1_6: 1M; R0603
V+R1: 100; R0603

Connections:
BAL9: IC8.25 (S1); also elsewhere on the board
BAL10: IC8.23 (S2); also elsewhere on the board
BAL11: IC8.21 (S3); also elsewhere on the board
BAL12: IC8.19 (S4); also elsewhere on the board
C8: H_V-R.1, IC8.26 (C0); also elsewhere on the board
C9M: IC8.24 (C1); also elsewhere on the board
C10M: IC8.22 (C2); also elsewhere on the board
C11M: IC8.20 (C3); also elsewhere on the board
C12: L5.1; also elsewhere on the board
C12M: IC8.2 (C12), IC8.4 (C11), IC8.6 (C10), IC8.8 (C9), IC8.10 (C8), IC8.12 (C7), IC8.14 (C6), IC8.16 (C5), IC8.18 (C4); also elsewhere on the board
H+3V3: IC8.30 (VTEMP2), Q5.1 (G), RGQ1_6.2; also elsewhere on the board
HGND: C35.2, CFSM1.1, CVREF1.1, CVREG1.1, D3.A, H_V-R.2, IC8.27 (V-), IC8.33 (TOS), IC8.34 (WDTB), IC8.35 (GPIO1), IC8.36 (GPIO2), IC8.37 (A0), IC8.38 (A1), IC8.39 (A2), IC8.40 (A3), Q5.2 (S), RGQ1_6.1; also elsewhere on the board
H_CSB: IC8.44 (CSBI), R58.1; also elsewhere on the board
H_FSM: CFSM1.2, IC8.29 (VTEMP1); also elsewhere on the board
H_SCK: IC8.41 (SCKI), R55.1; also elsewhere on the board
H_SDI: IC8.42 (SDI), R56.1; also elsewhere on the board
H_SDO: IC8.43 (SDO), R57.1; also elsewhere on the board
H_V+: C35.1, D3.C, IC8.1 (V+), Q6.3 (D); also elsewhere on the board
H_VREF: CVREF1.2, IC8.31 (VREF)
H_VREG: CVREG1.2, IC8.32 (VREG), R55.2, R56.2, R57.2, R58.2
unnamed: Q5.3 (D), RGQ1_5.1
unnamed: L5.2, V+R1.1
Q1G1: Q6.1 (G), RGQ1_5.2
V+S1: Q6.2 (S), V+R1.2

Notes on the sheet:
BMS IC
BMS IC Supply & Shutdown

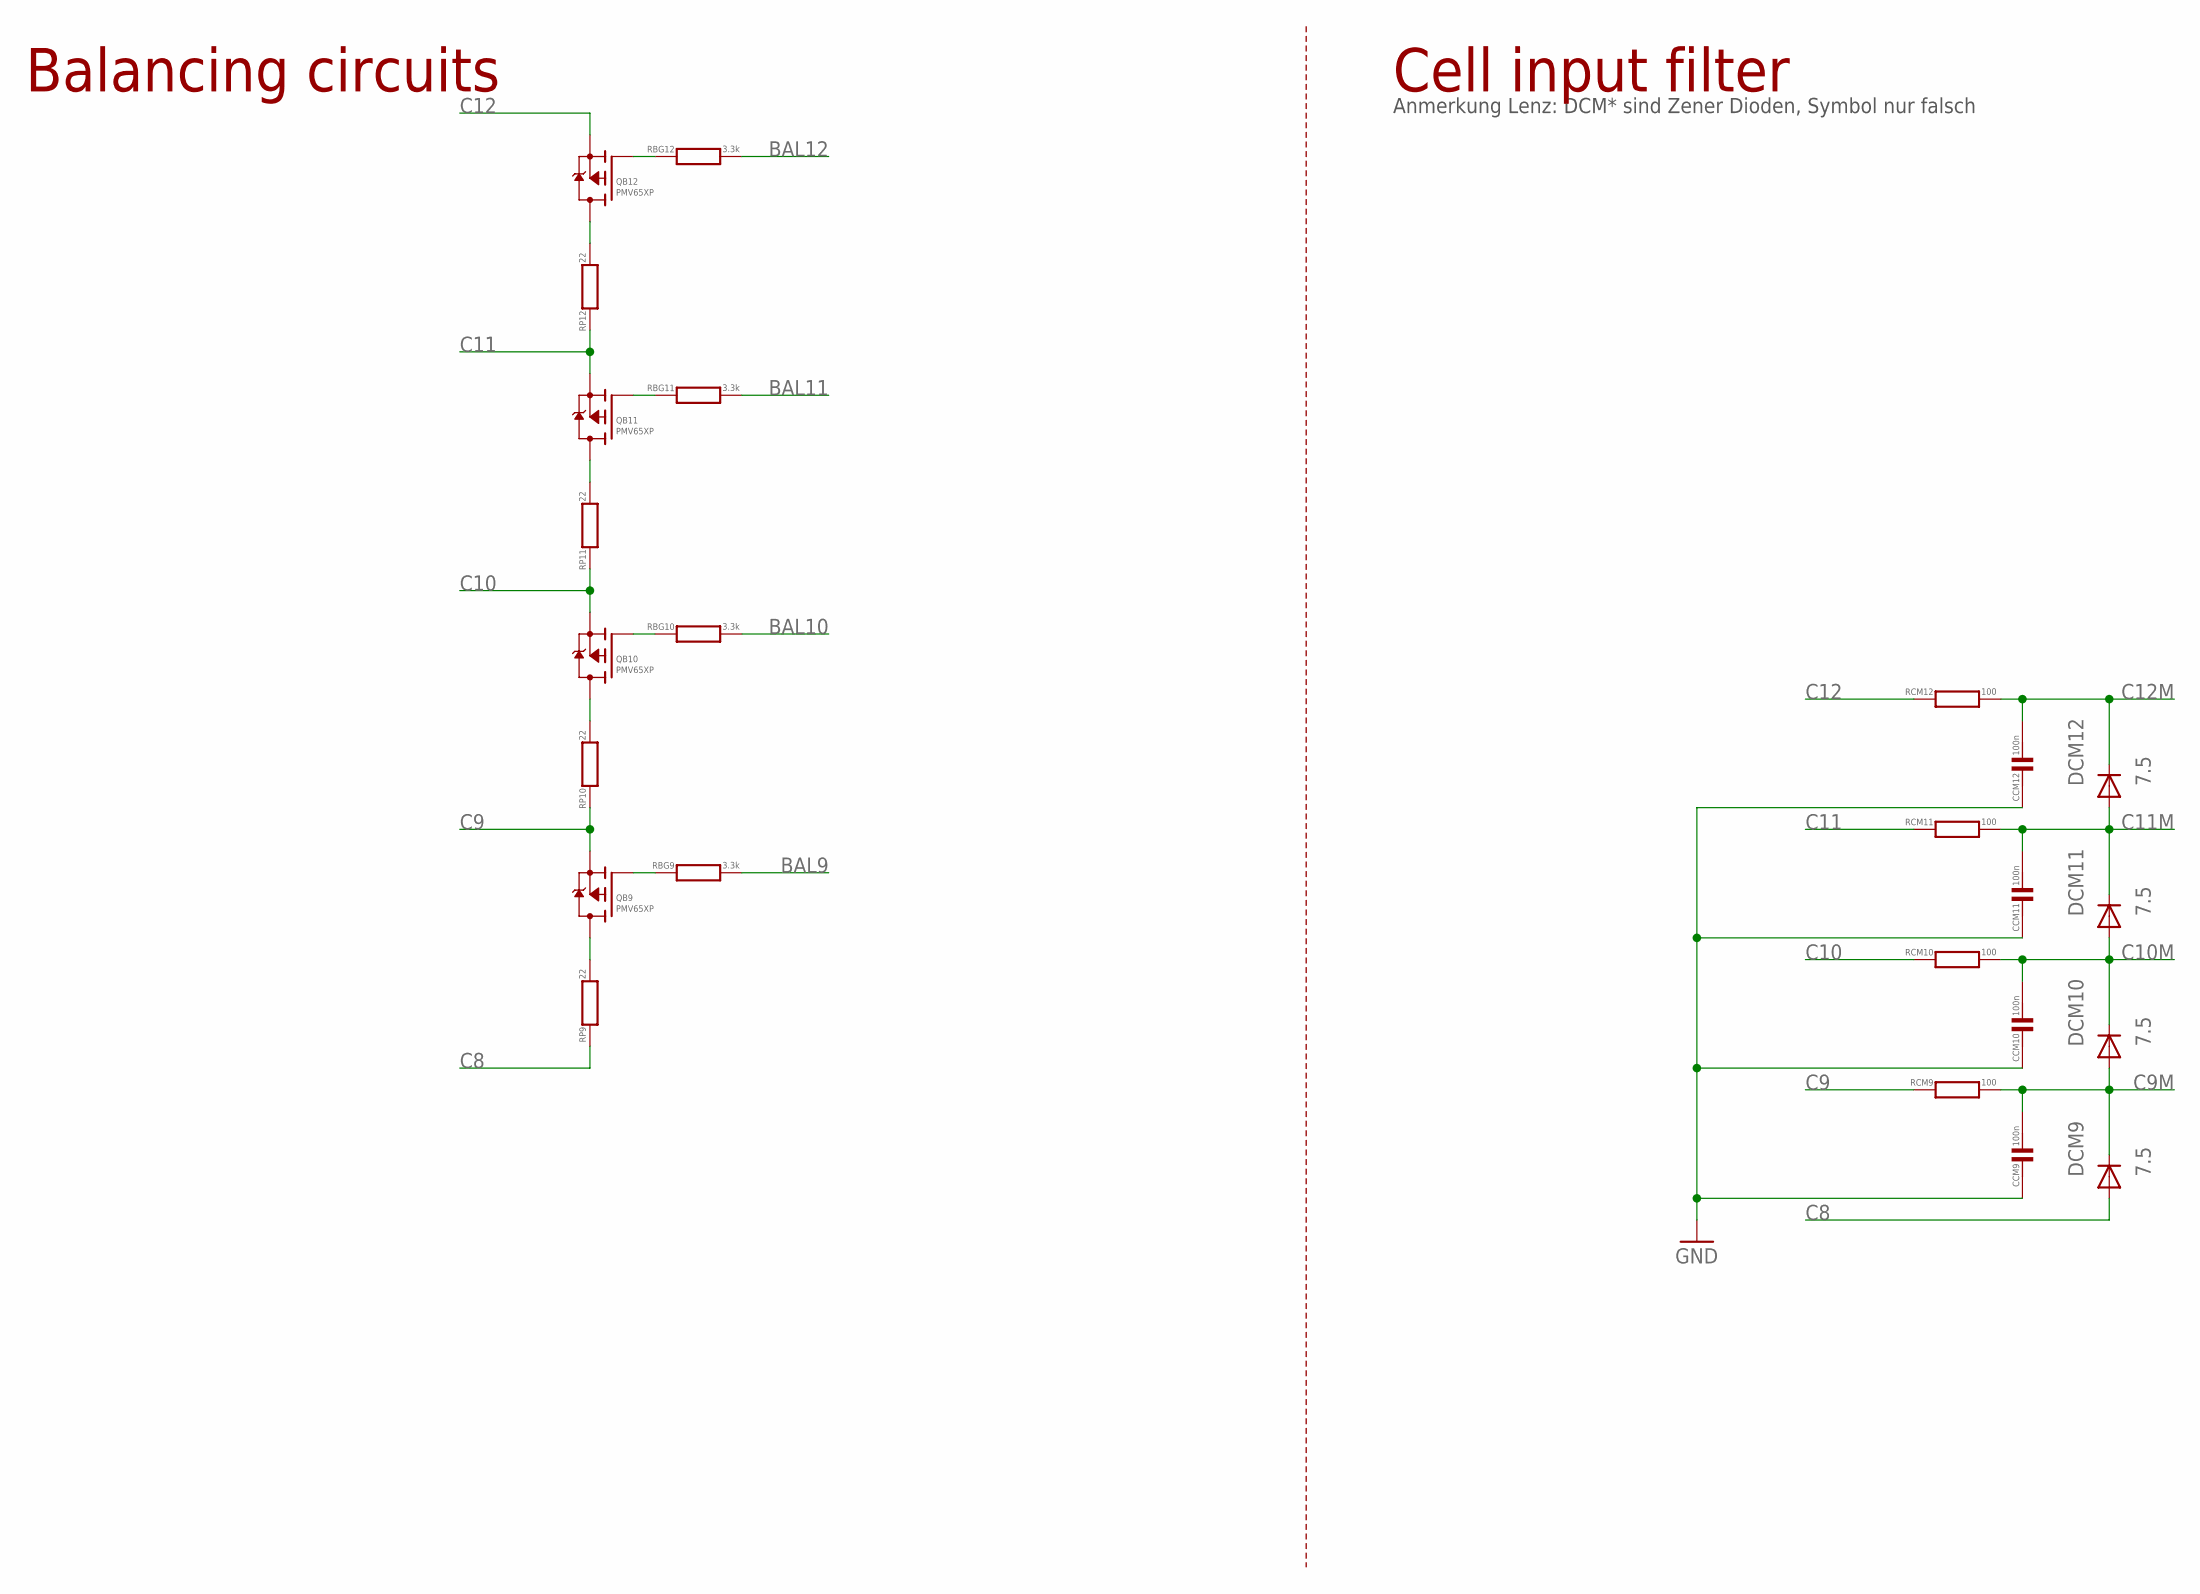
[picture p74: schematic canSlaveV03_4s.sch, sheet 4]

Parts:
CCM9, CCM10, CCM11, CCM12: 100n; C0603
DCM9, DCM10, DCM11, DCM12: 7.5; SOD323-R
QB9, QB10, QB11, QB12: PMV65XP; SOT23
RBG9, RBG10, RBG11, RBG12: 3.3k; R0603
RCM9, RCM10, RCM11, RCM12: 100; R0603
RP9, RP10, RP11, RP12: 22; R2512

Connections:
BAL9: RBG9.2; also elsewhere on the board
BAL10: RBG10.2; also elsewhere on the board
BAL11: RBG11.2; also elsewhere on the board
BAL12: RBG12.2; also elsewhere on the board
C8: DCM9.A, RP9.1; also elsewhere on the board
C9: QB9.2 (S), RCM9.1, RP10.1; also elsewhere on the board
C9M: CCM9.1, DCM9.C, DCM10.A, RCM9.2; also elsewhere on the board
C10: QB10.2 (S), RCM10.1, RP11.1; also elsewhere on the board
C10M: CCM10.1, DCM10.C, DCM11.A, RCM10.2; also elsewhere on the board
C11: QB11.2 (S), RCM11.1, RP12.1; also elsewhere on the board
C11M: CCM11.1, DCM11.C, DCM12.A, RCM11.2; also elsewhere on the board
C12: QB12.2 (S), RCM12.1; also elsewhere on the board
C12M: CCM12.1, DCM12.C, RCM12.2; also elsewhere on the board
CR9: QB9.3 (D), RP9.2
CR10: QB10.3 (D), RP10.2
CR11: QB11.3 (D), RP11.2
CR12: QB12.3 (D), RP12.2
HGND: CCM9.2, CCM10.2, CCM11.2, CCM12.2; also elsewhere on the board
QBG9: QB9.1 (G), RBG9.1
QBG10: QB10.1 (G), RBG10.1
QBG11: QB11.1 (G), RBG11.1
QBG12: QB12.1 (G), RBG12.1

Notes on the sheet:
Balancing circuits
Cell input filter
Anmerkung Lenz: DCM* sind Zener Dioden, Symbol nur falsch

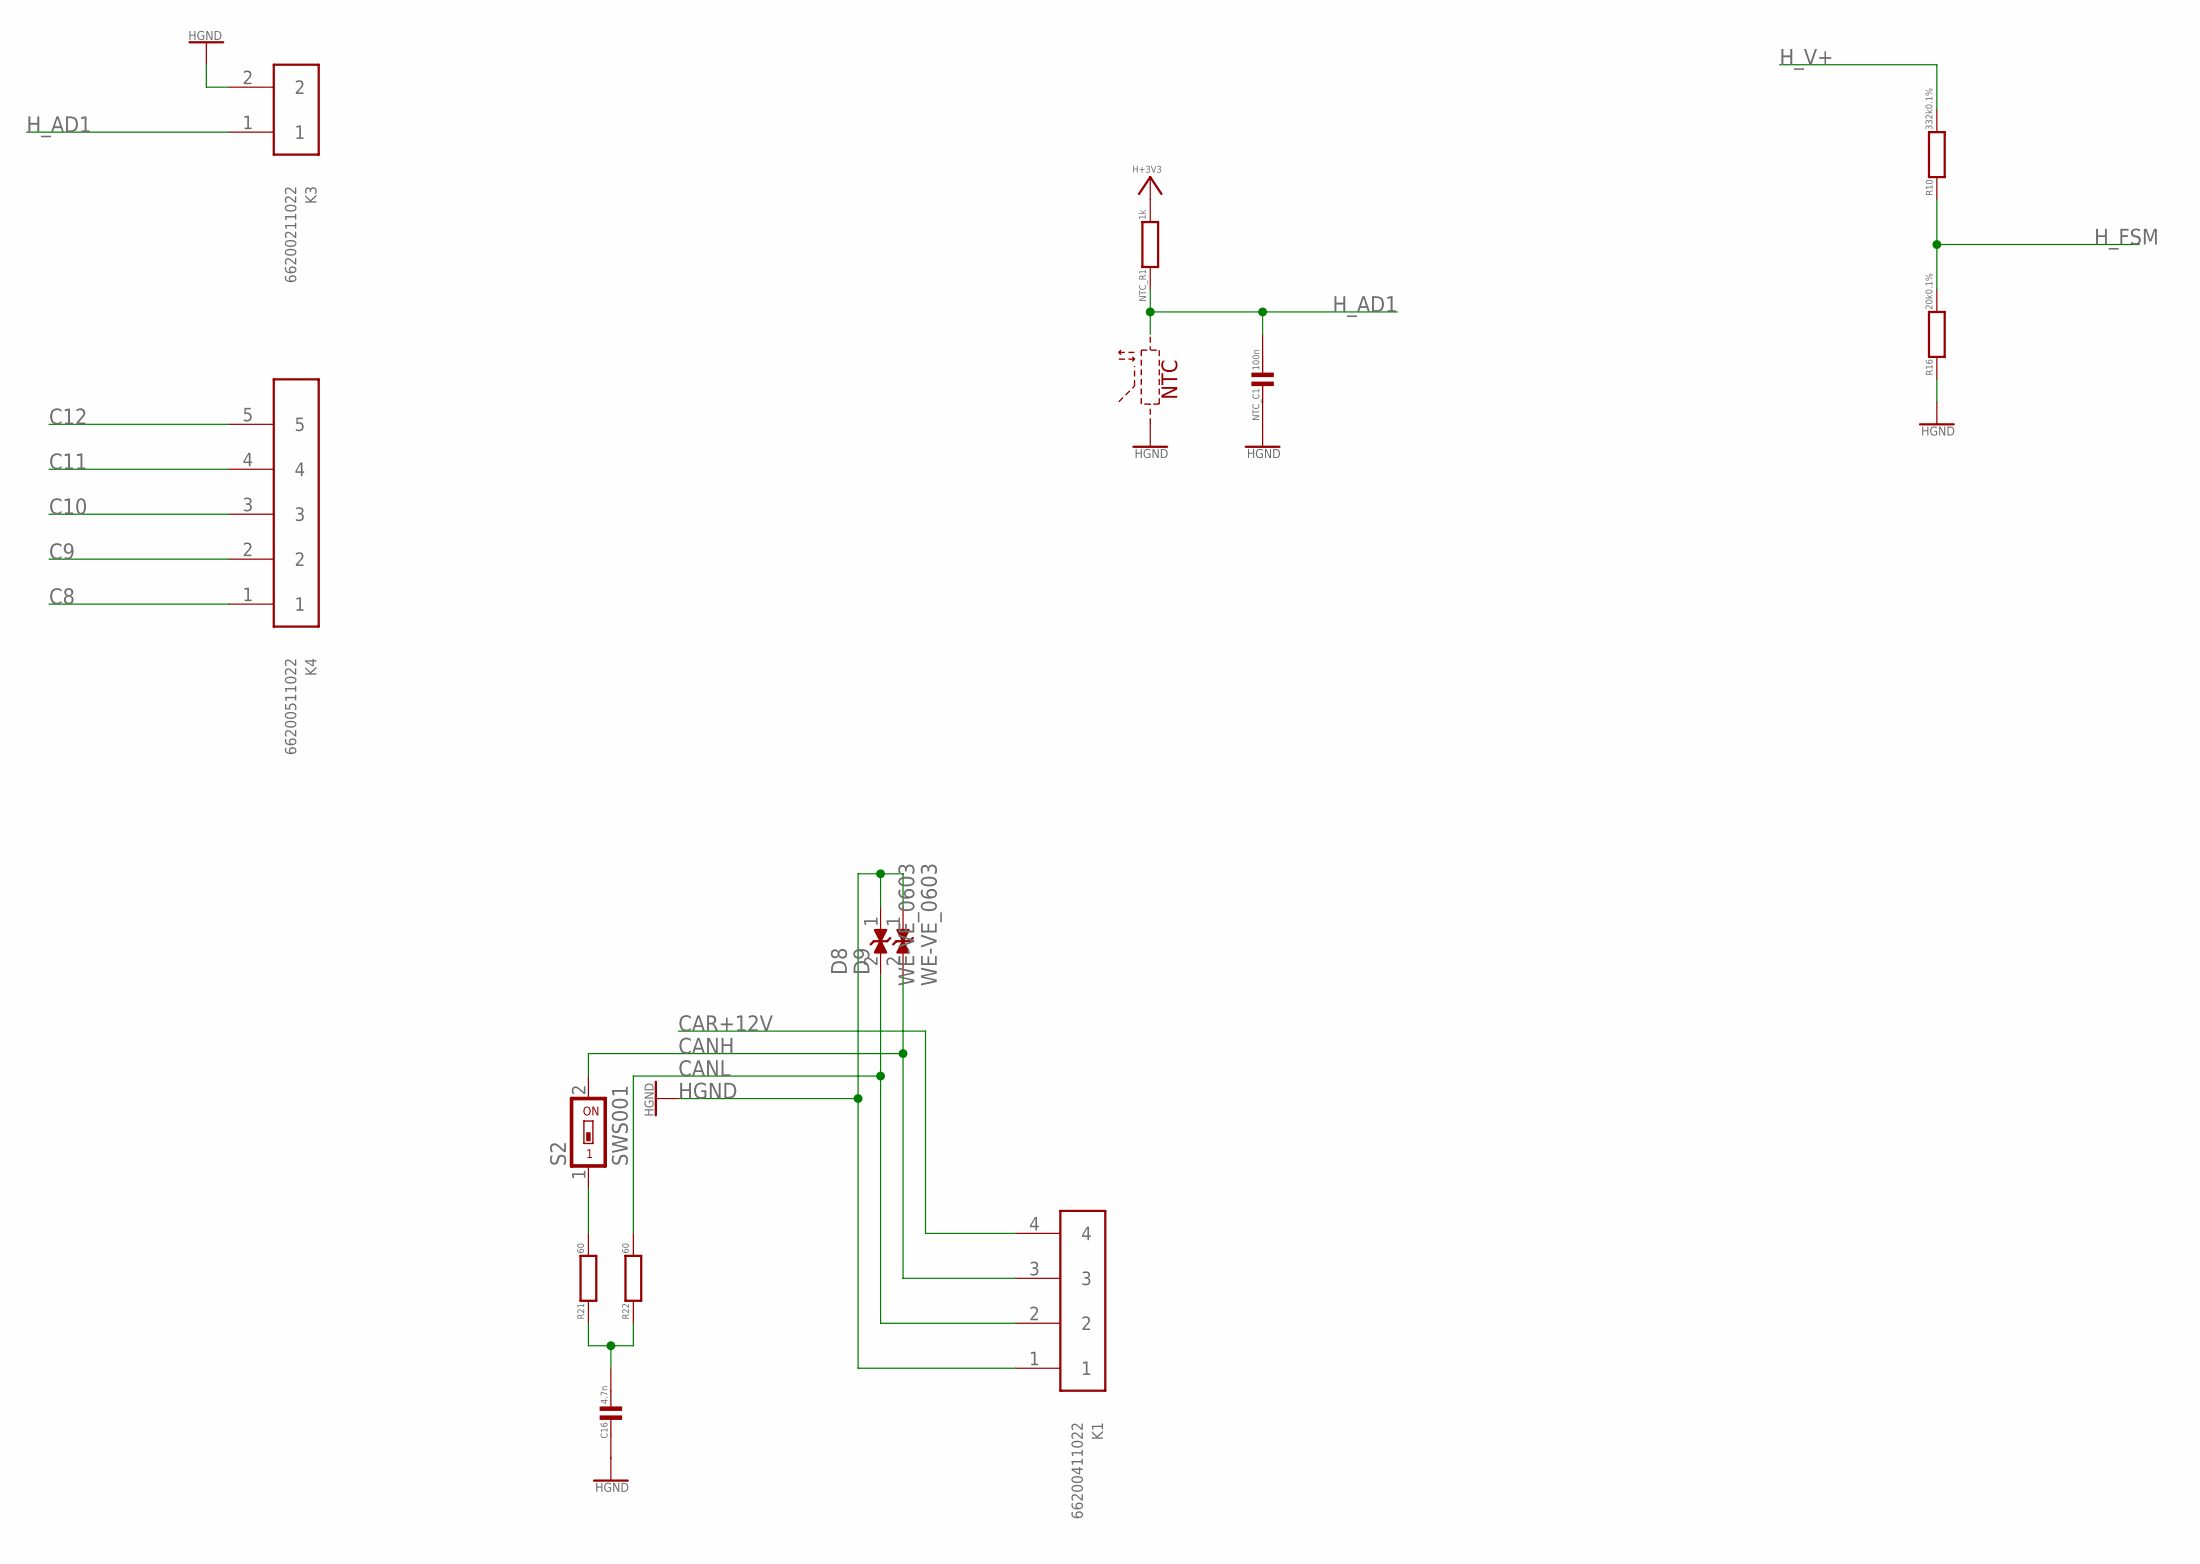
[picture p75: schematic canSlaveV03_4s.sch, sheet 5]

Parts:
C16: 4.7n; C0603
D8, D9: WE-VE_0603; WESURGE_0603
K1: 66200411022
K3: 66200211022
K4: 66200511022
NTC_C1: 100n; C0603
NTC_R1: 1k; R0603
R10: 332k0.1%; R0603
R16: 20k0.1%; R0603
R21, R22: 60; R0603
S2: SWS001; SMS-001

Connections:
C8: K4.1; also elsewhere on the board
C9: K4.2; also elsewhere on the board
C10: K4.3; also elsewhere on the board
C11: K4.4; also elsewhere on the board
C12: K4.5; also elsewhere on the board
CANH: D9.2, K1.3, S2.2; also elsewhere on the board
CANJ: R21.2, S2.1
CANL: D8.2, K1.2, R22.2; also elsewhere on the board
CANT: C16.1, R21.1, R22.1
CAR+12V: K1.4; also elsewhere on the board
H+3V3: NTC_R1.2; also elsewhere on the board
HGND: C16.2, D8.1, D9.1, K1.1, K3.2, NTC_C1.2, R16.1; also elsewhere on the board
H_AD1: K3.1, NTC_C1.1, NTC_R1.1; also elsewhere on the board
H_FSM: R10.1, R16.2; also elsewhere on the board
H_V+: R10.2; also elsewhere on the board

Notes on the sheet:
NTC

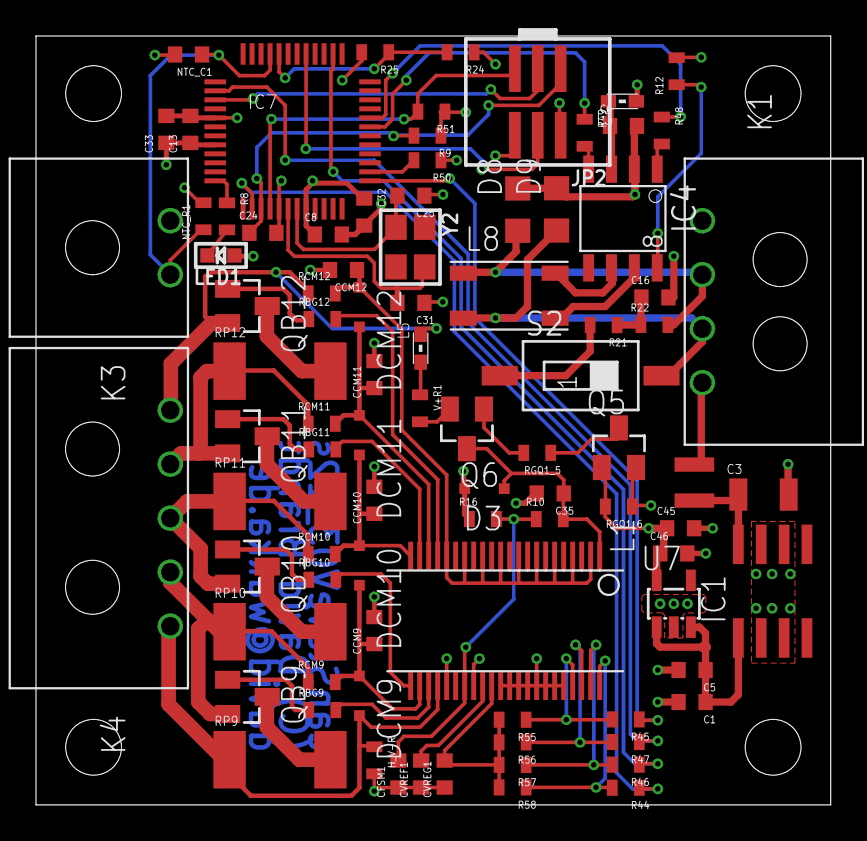
[picture p76: board canSlaveV03_4s.brd from above]

Board: 4 copper layers, 44.2 x 42.7 mm, 90 parts (0 on the bottom side), 65 nets.
