funkobongrip/sprbms/hardware/spi/master/master_carconnector.brd

## EAGLE design hardware/spi/master/master_carconnector.brd (2013-05-31)

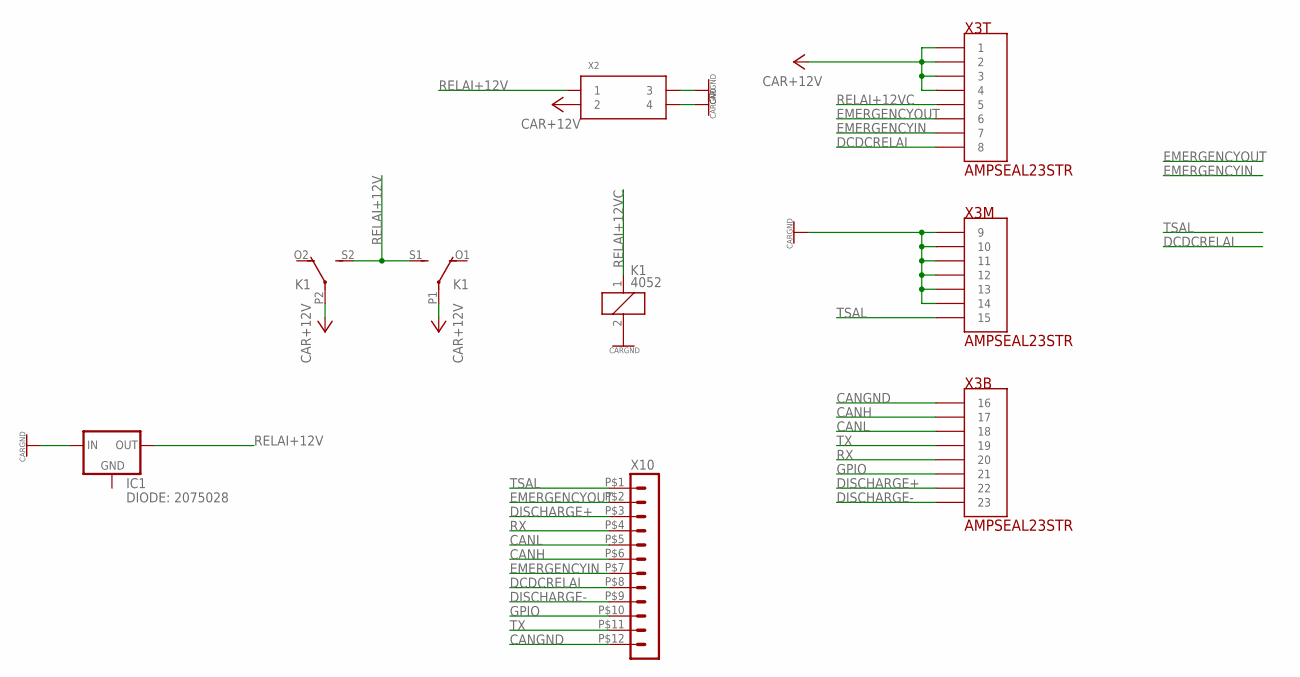
[picture p77: schematic master_carconnector.sch]

Parts:
IC1: DIODE: 2075028; TO252
K1: 4052; F4052
X2: MINI-FIT-JR-045566; 5566-04
X3: AMPSEAL23STR; AMPSEAL23-STR
X10: HEADER_POS12_43045-1212; 43045-1212

Connections:
CANGND: X3.P$16 (16), X10.P$12 (12)
CANH: X3.P$17 (17), X10.P$6 (6)
CANL: X3.P$18 (18), X10.P$5 (5)
CAR+12V: K1.P1, K1.P2, X2.P2 (2), X3.P$1 (1), X3.P$2 (2), X3.P$3 (3), X3.P$4 (4)
CARGND: IC1.2 (IN), K1.2, X2.P3 (3), X2.P4 (4), X3.P$9 (9), X3.P$10 (10), X3.P$11 (11), X3.P$12 (12), X3.P$13 (13), X3.P$14 (14)
DCDCRELAI: X3.P$8 (8), X10.P$8 (8)
DISCHARGE+: X3.P$22 (22), X10.P$3 (3)
DISCHARGE-: X3.P$23 (23), X10.P$9 (9)
EMERGENCYIN: X3.P$7 (7), X10.P$7 (7)
EMERGENCYOUT: X3.P$6 (6), X10.P$2 (2)
GPIO: X3.P$21 (21), X10.P$10 (10)
RELAI+12V: IC1.3 (OUT), K1.S1 (S), K1.S2 (S), X2.P1 (1)
RELAI+12VC: K1.1, X3.P$5 (5)
RX: X3.P$20 (20), X10.P$4 (4)
TSAL: X3.P$15 (15), X10.P$1 (1)
TX: X3.P$19 (19), X10.P$11 (11)

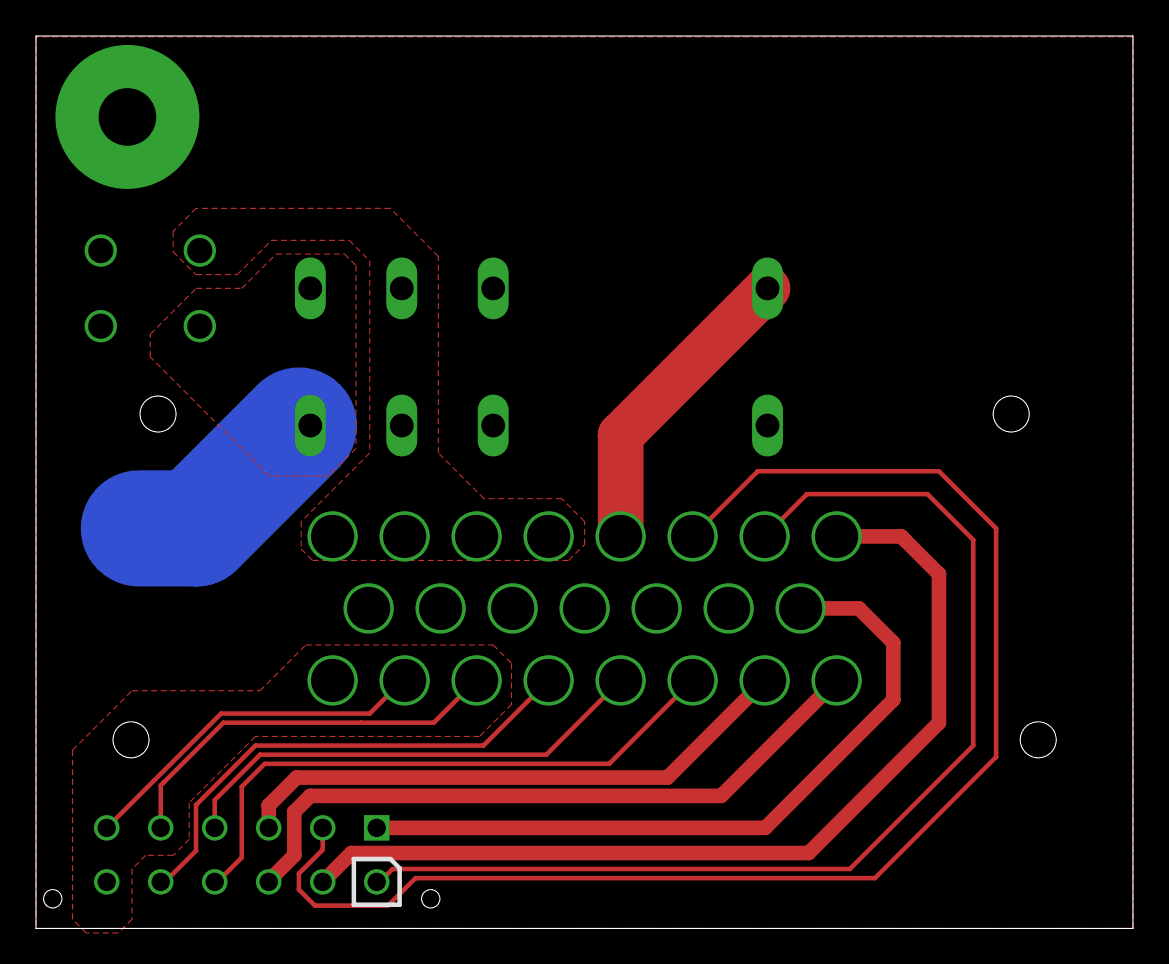
[picture p78: board master_carconnector.brd from above]

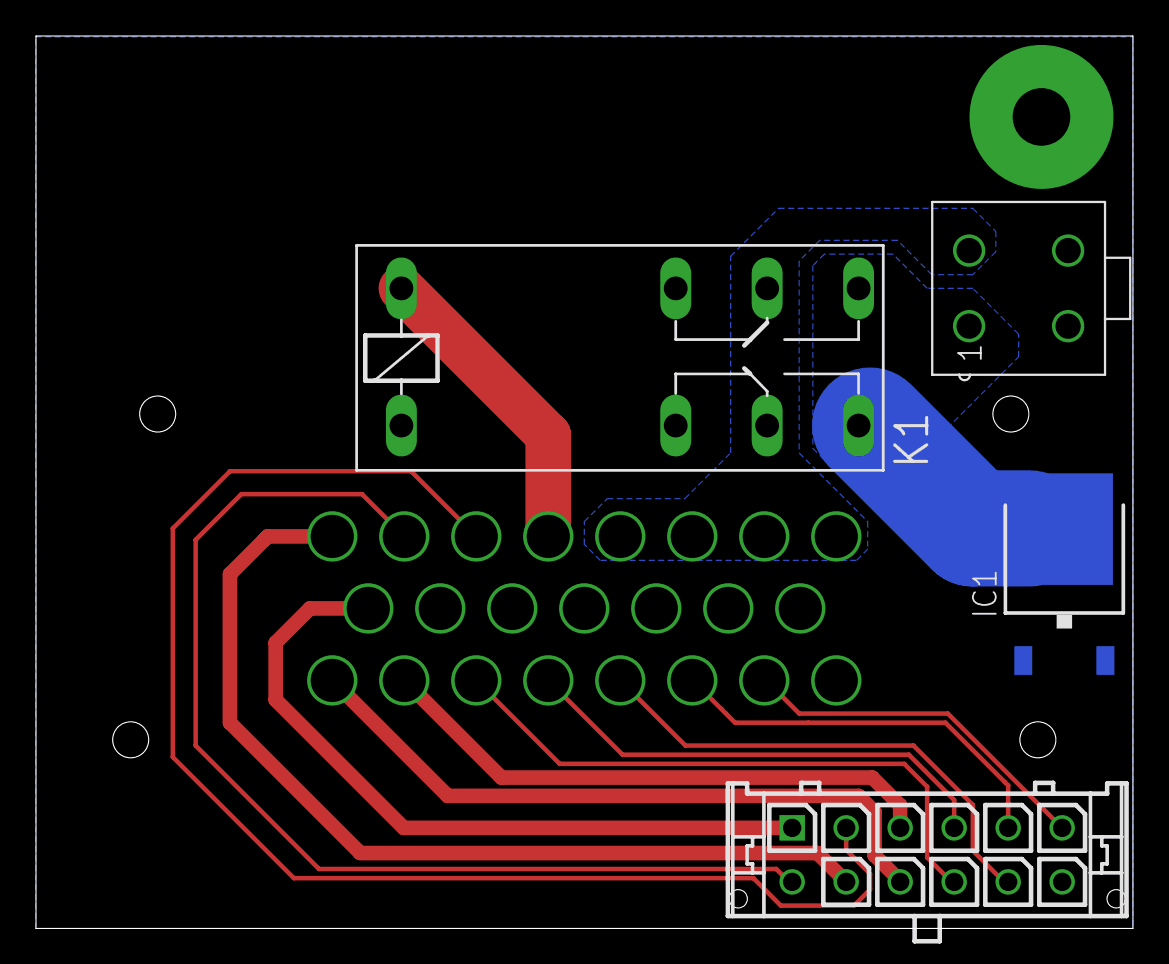
[picture p79: board master_carconnector.brd from below]

Board: 2 copper layers, 60.9 x 49.6 mm, 5 parts (4 on the bottom side), 16 nets.
