funkobongrip/sprbms/hardware/nextgen_master/bms_master_V01.brd

## EAGLE design hardware/nextgen_master/bms_master_V01.brd (2016-02-18)

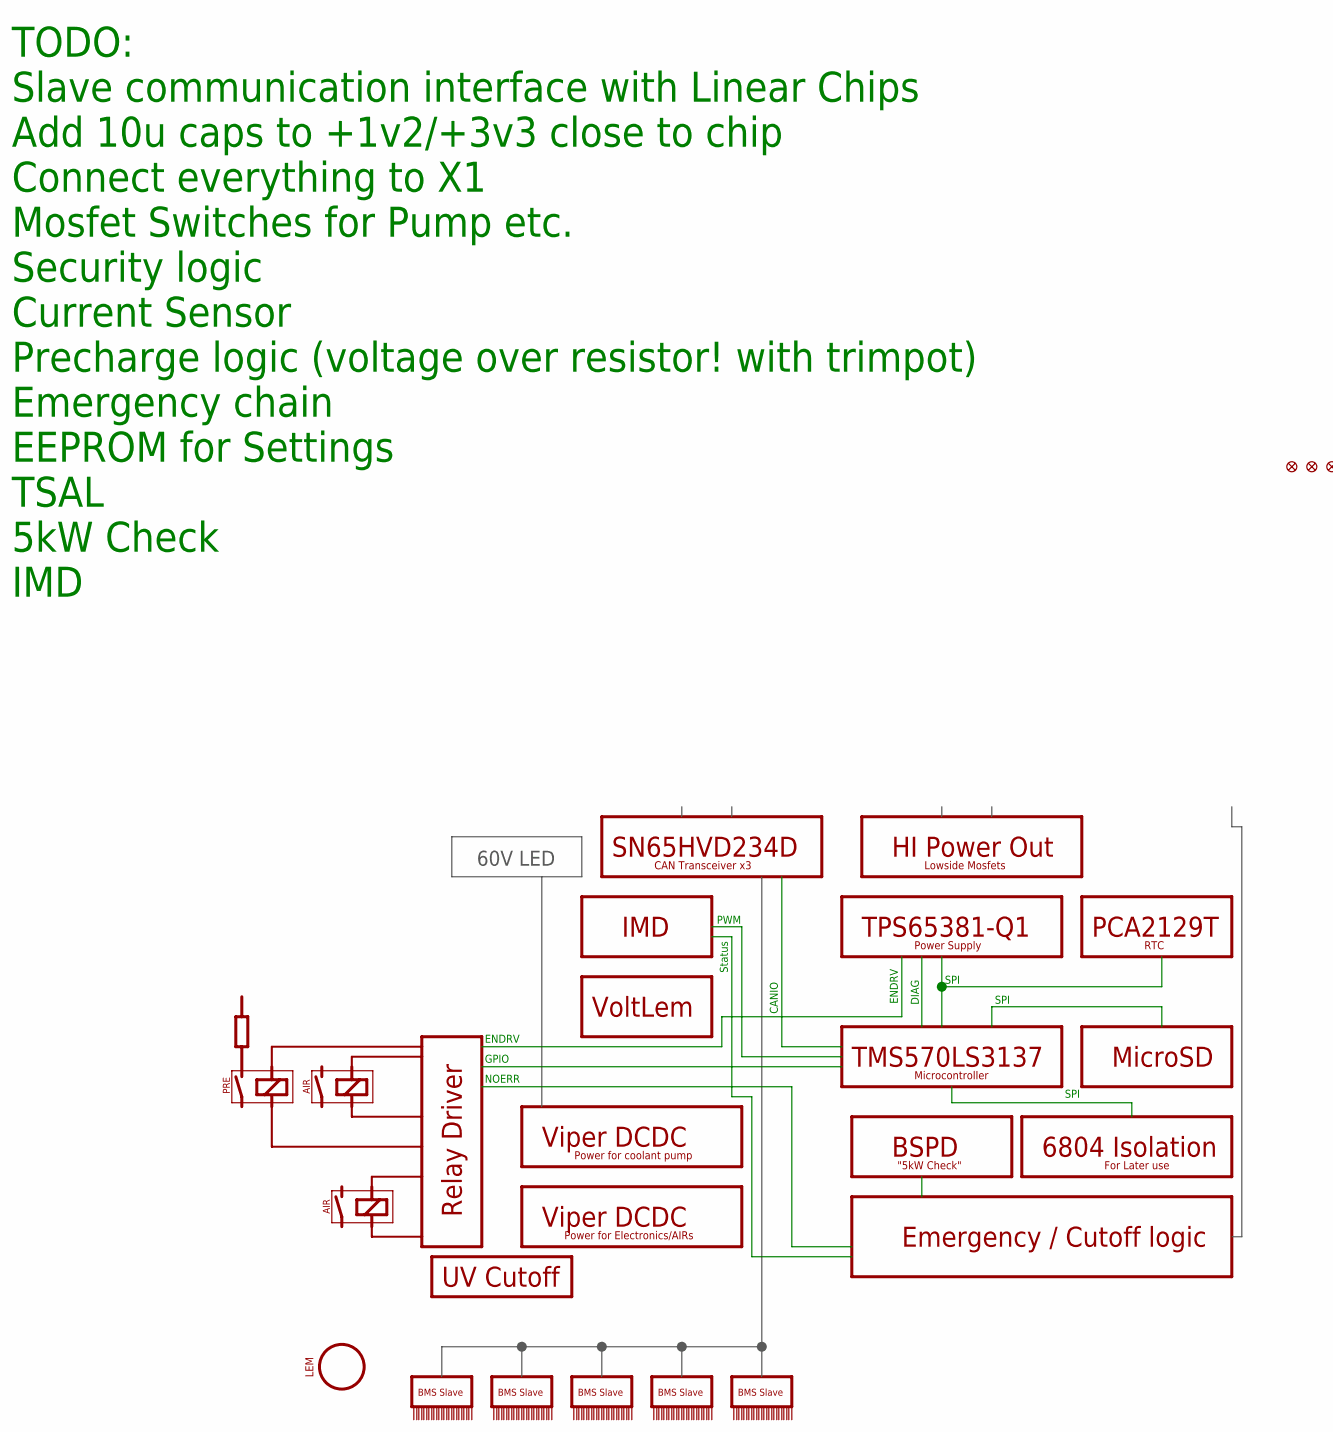
[picture p80: schematic bms_master_V01.sch, sheet 1, part in row 1, column 1]

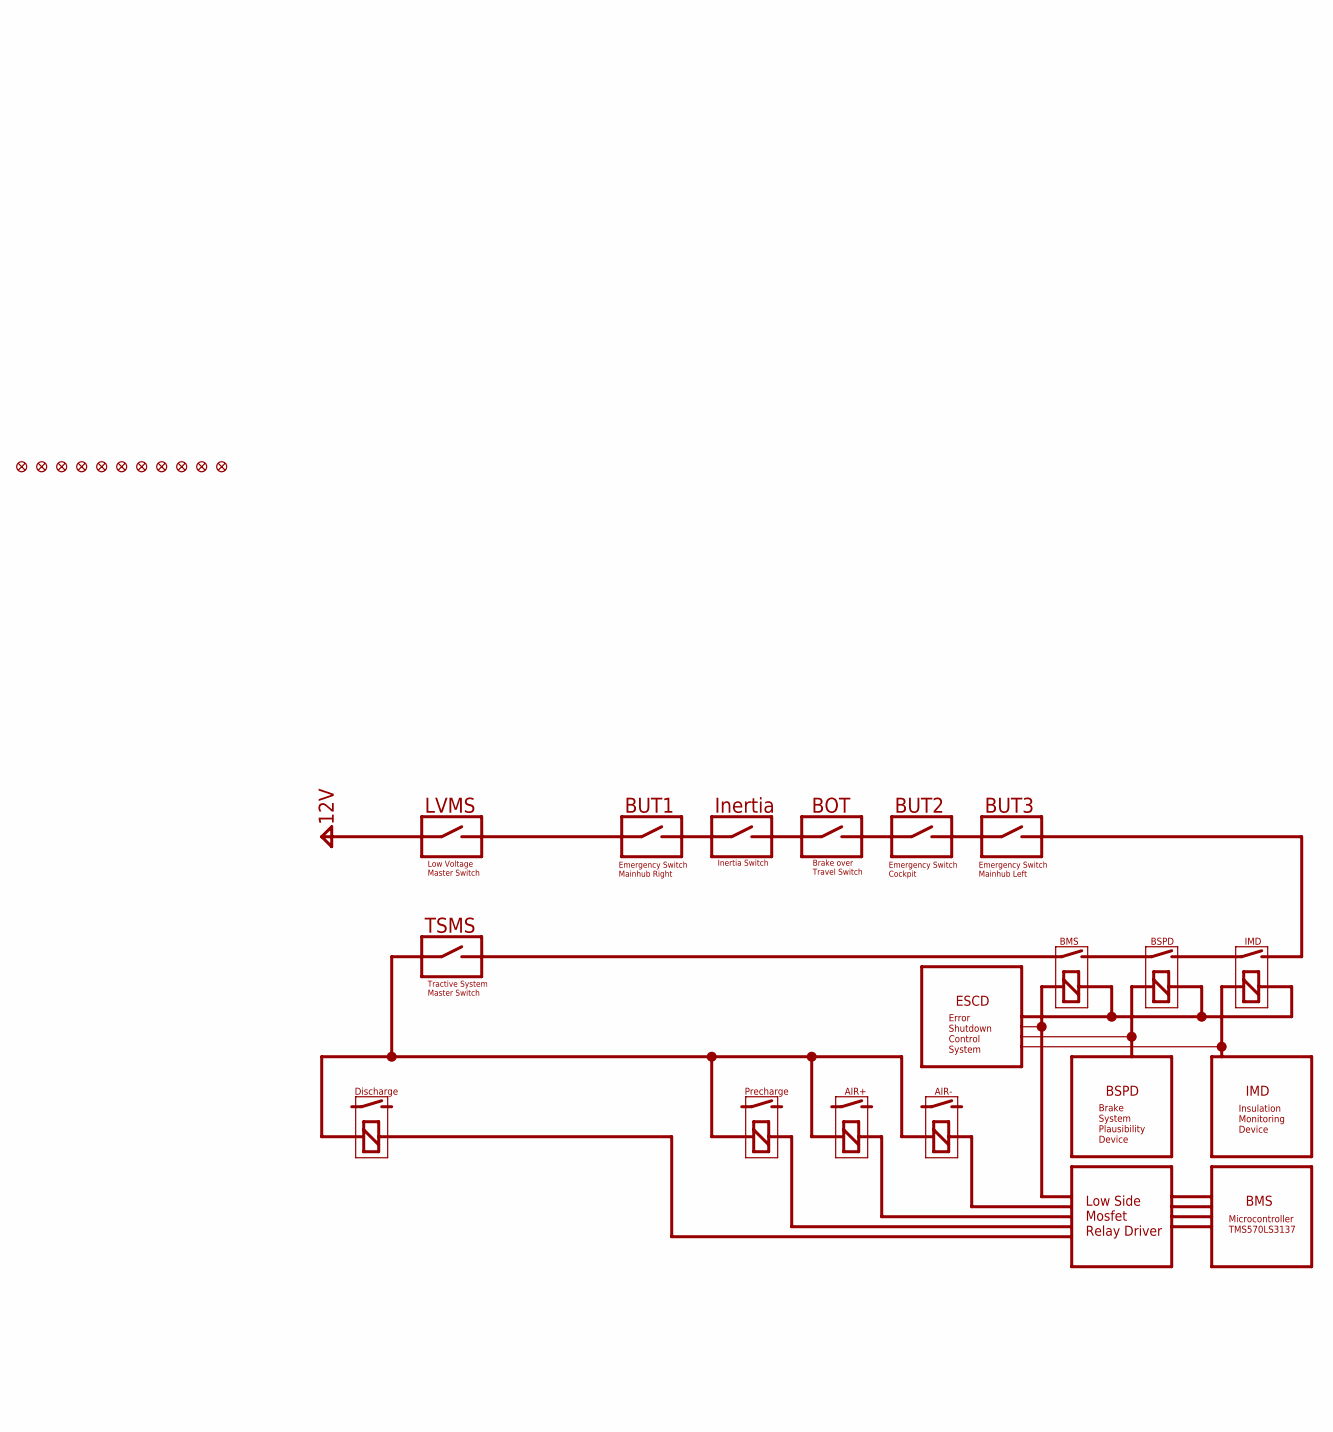
[picture p81: schematic bms_master_V01.sch, sheet 1, part in row 1, column 2]

Parts:
FID1, FID2, FID3, FID4, FID5, FID6, FID7, FID8, FID9, FID10, FID11: FIDUCIAL""; FIDUCIAL_1MM

Notes on the sheet:
TODO: Slave communication interface with Linear Chips Add 10u caps to +1v2/+3v3 close to chip Connect everything to X1 Mosfet Switches for Pump etc. Security logic Current Sensor Precharge logic (voltage over resistor! with trimpot) Emergency chain EEPROM for Settings TSAL 5kW Check IMD
TMS570LS3137
TPS65381-Q1
Power Supply
Microcontroller
PCA2129T
RTC
SPI
DIAG
MicroSD
SN65HVD234D
CAN Transceiver x3
CANIO
BMS Slave
6804 Isolation
For Later use
AIR
PRE
Relay Driver
GPIO
ENDRV
BSPD
LEM
NOERR
Viper DCDC
Power for coolant pump
Power for Electronics/AIRs
VoltLem
UV Cutoff
HI Power Out
Lowside Mosfets
Emergency / Cutoff logic
IMD
PWM
Status
60V LED
"5kW Check"
LVMS
Inertia
BOT
Low Voltage Master Switch
Inertia Switch
Brake over Travel Switch
BUT2
Emergency Switch Cockpit
BUT1
Emergency Switch Mainhub Right
BUT3
Emergency Switch Mainhub Left
TSMS
Tractive System Master Switch
BMS
12V
AIR+
AIR-
Precharge
Discharge
Low Side Mosfet Relay Driver
Microcontroller TMS570LS3137
Insulation Monitoring Device
Brake System Plausibility Device
ESCD
Error Shutdown Control System

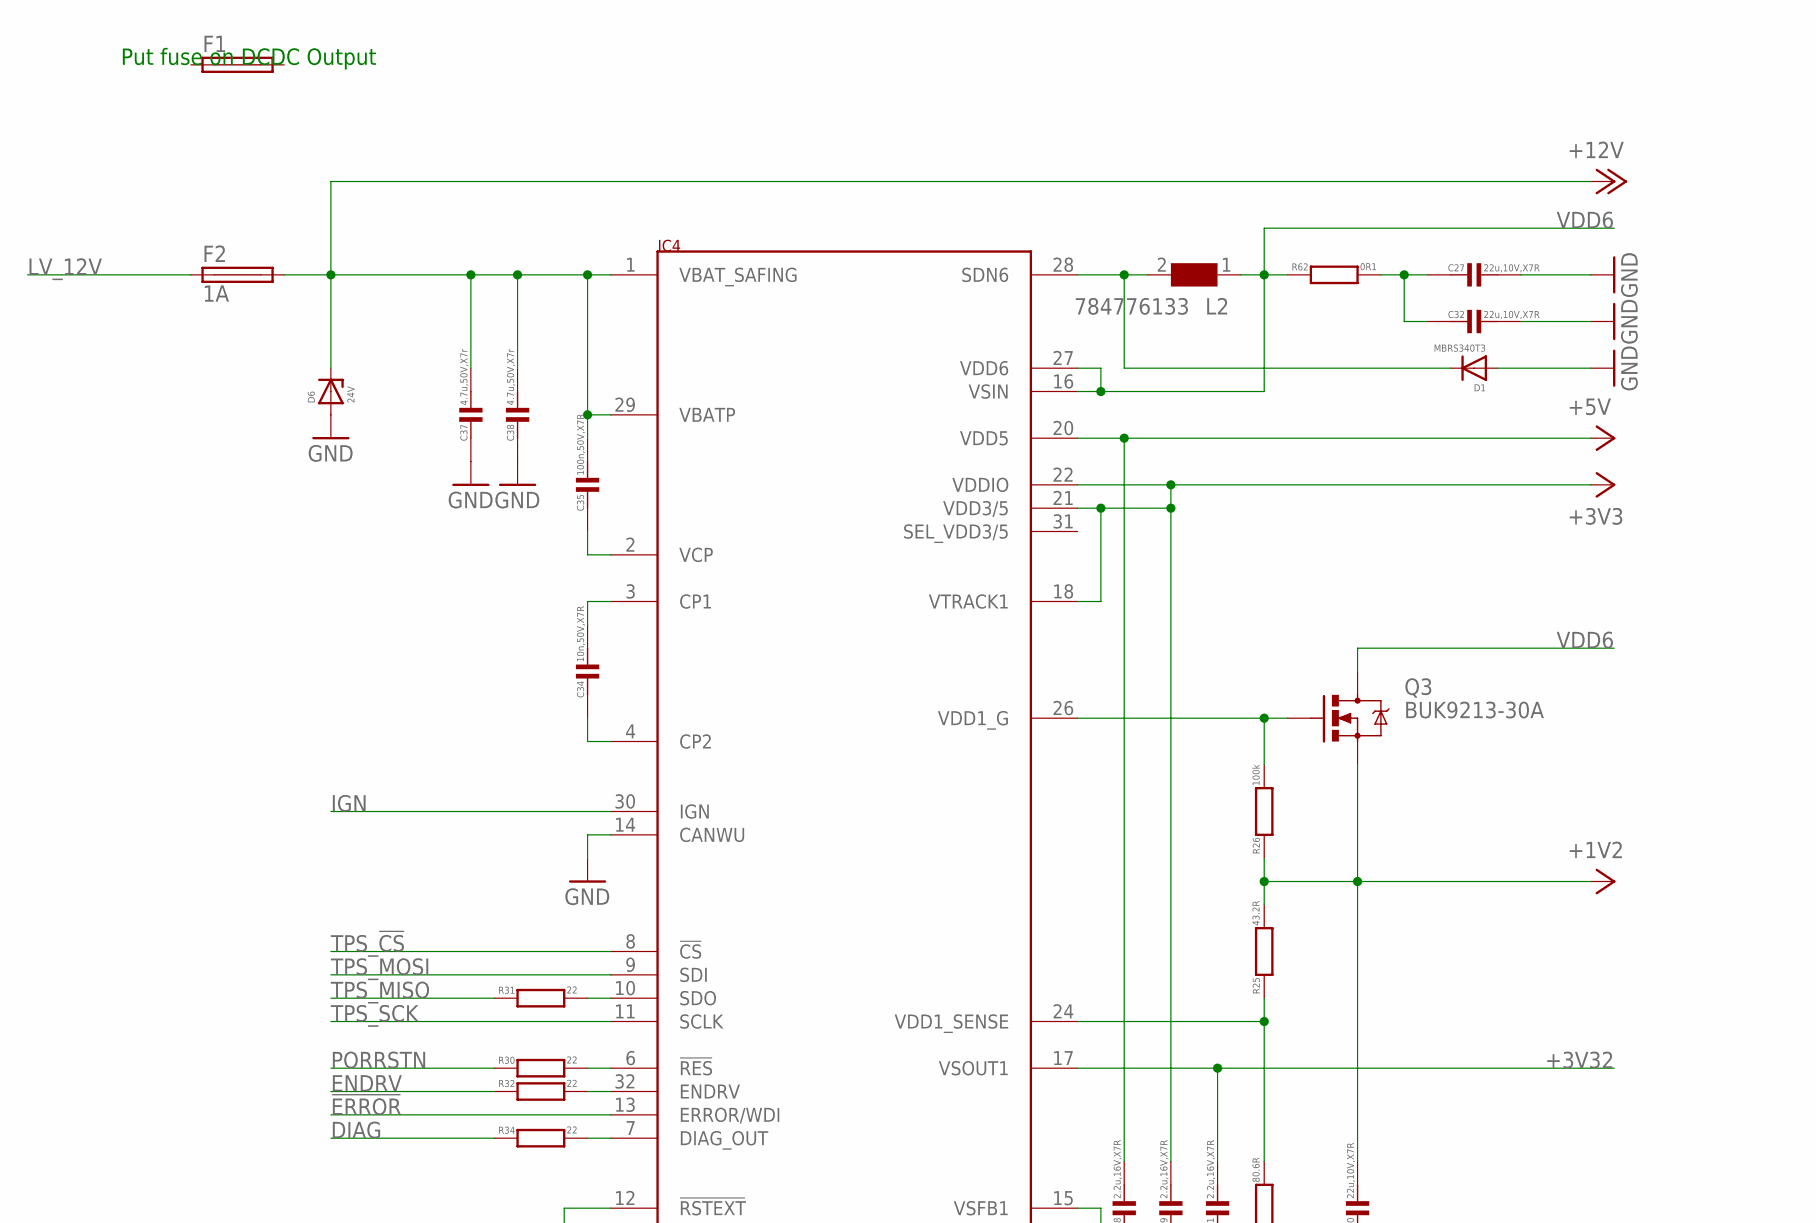
[picture p82: schematic bms_master_V01.sch, sheet 2, part in row 1, column 1]

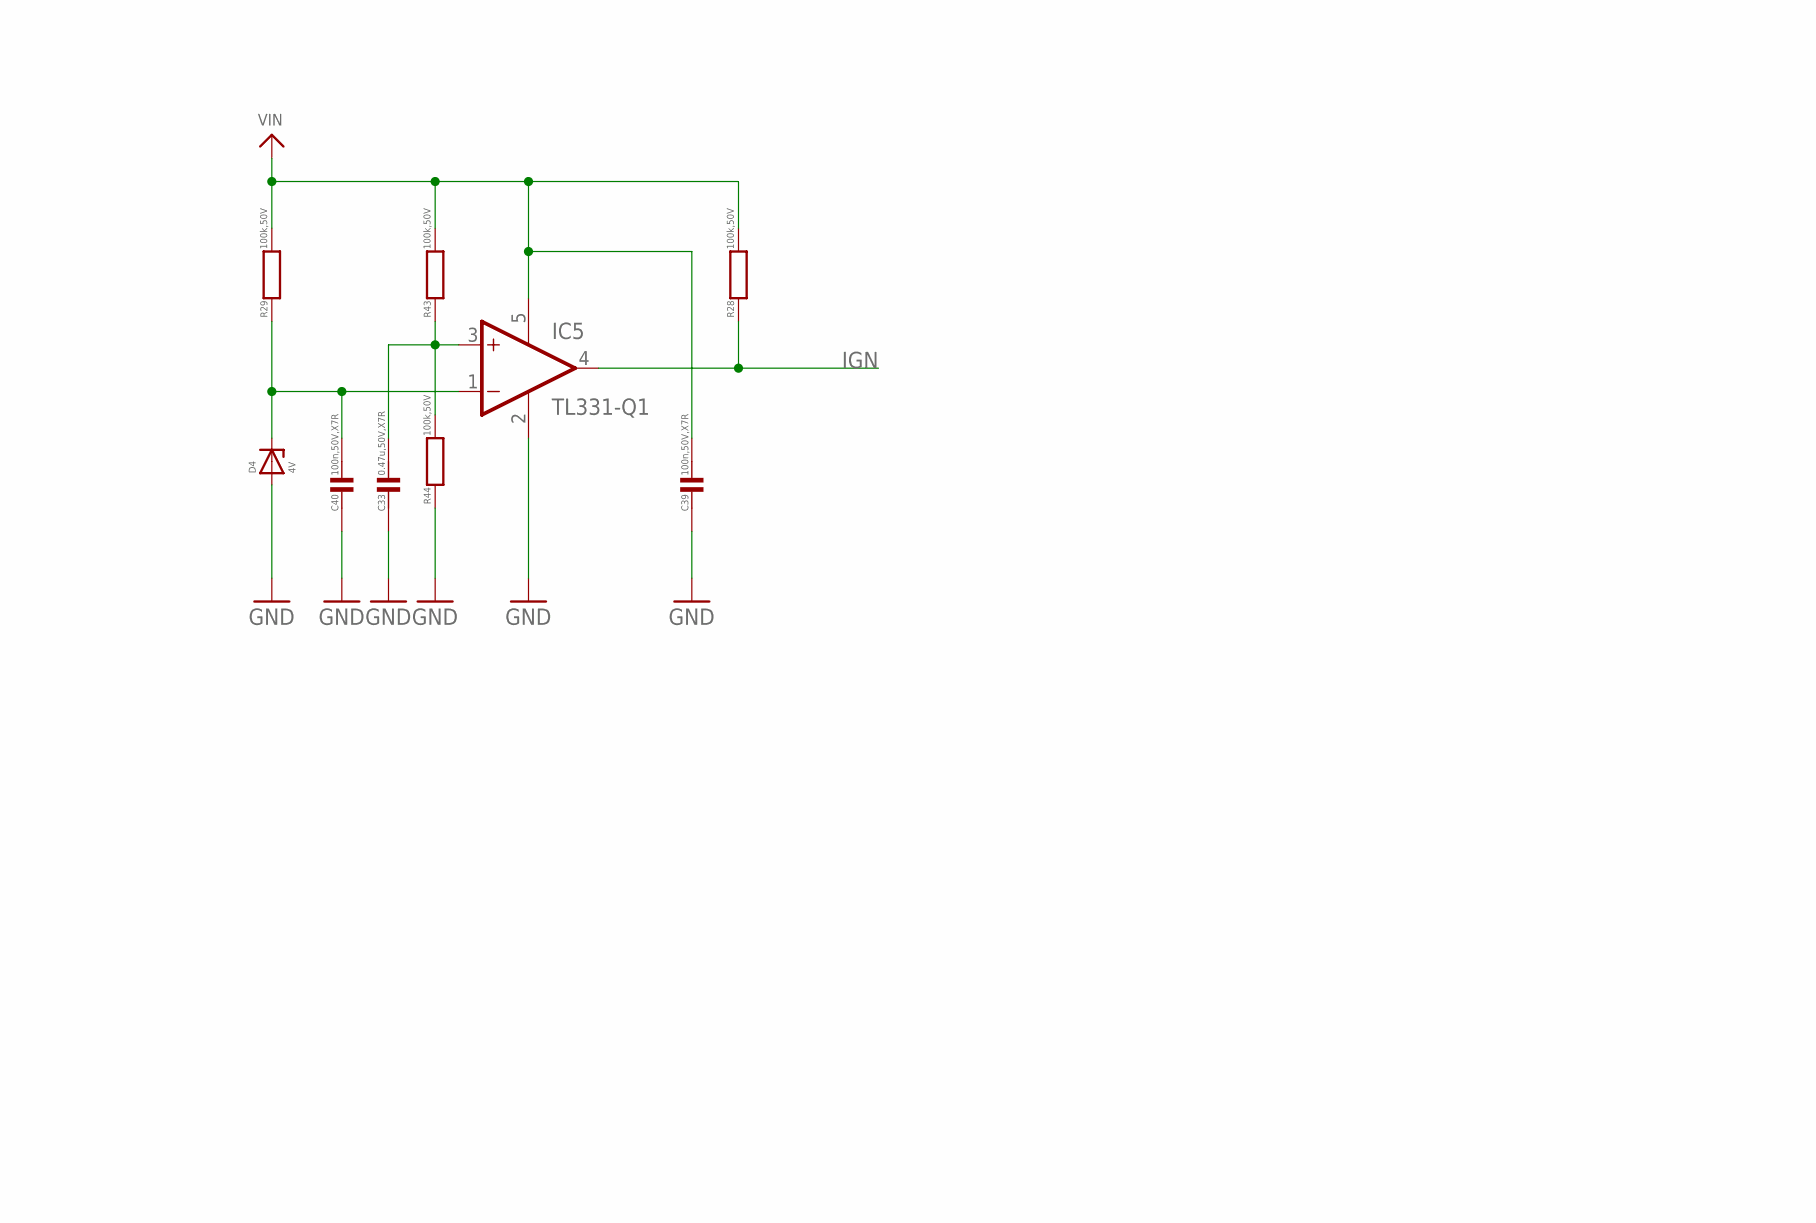
[picture p83: schematic bms_master_V01.sch, sheet 2, part in row 1, column 2]

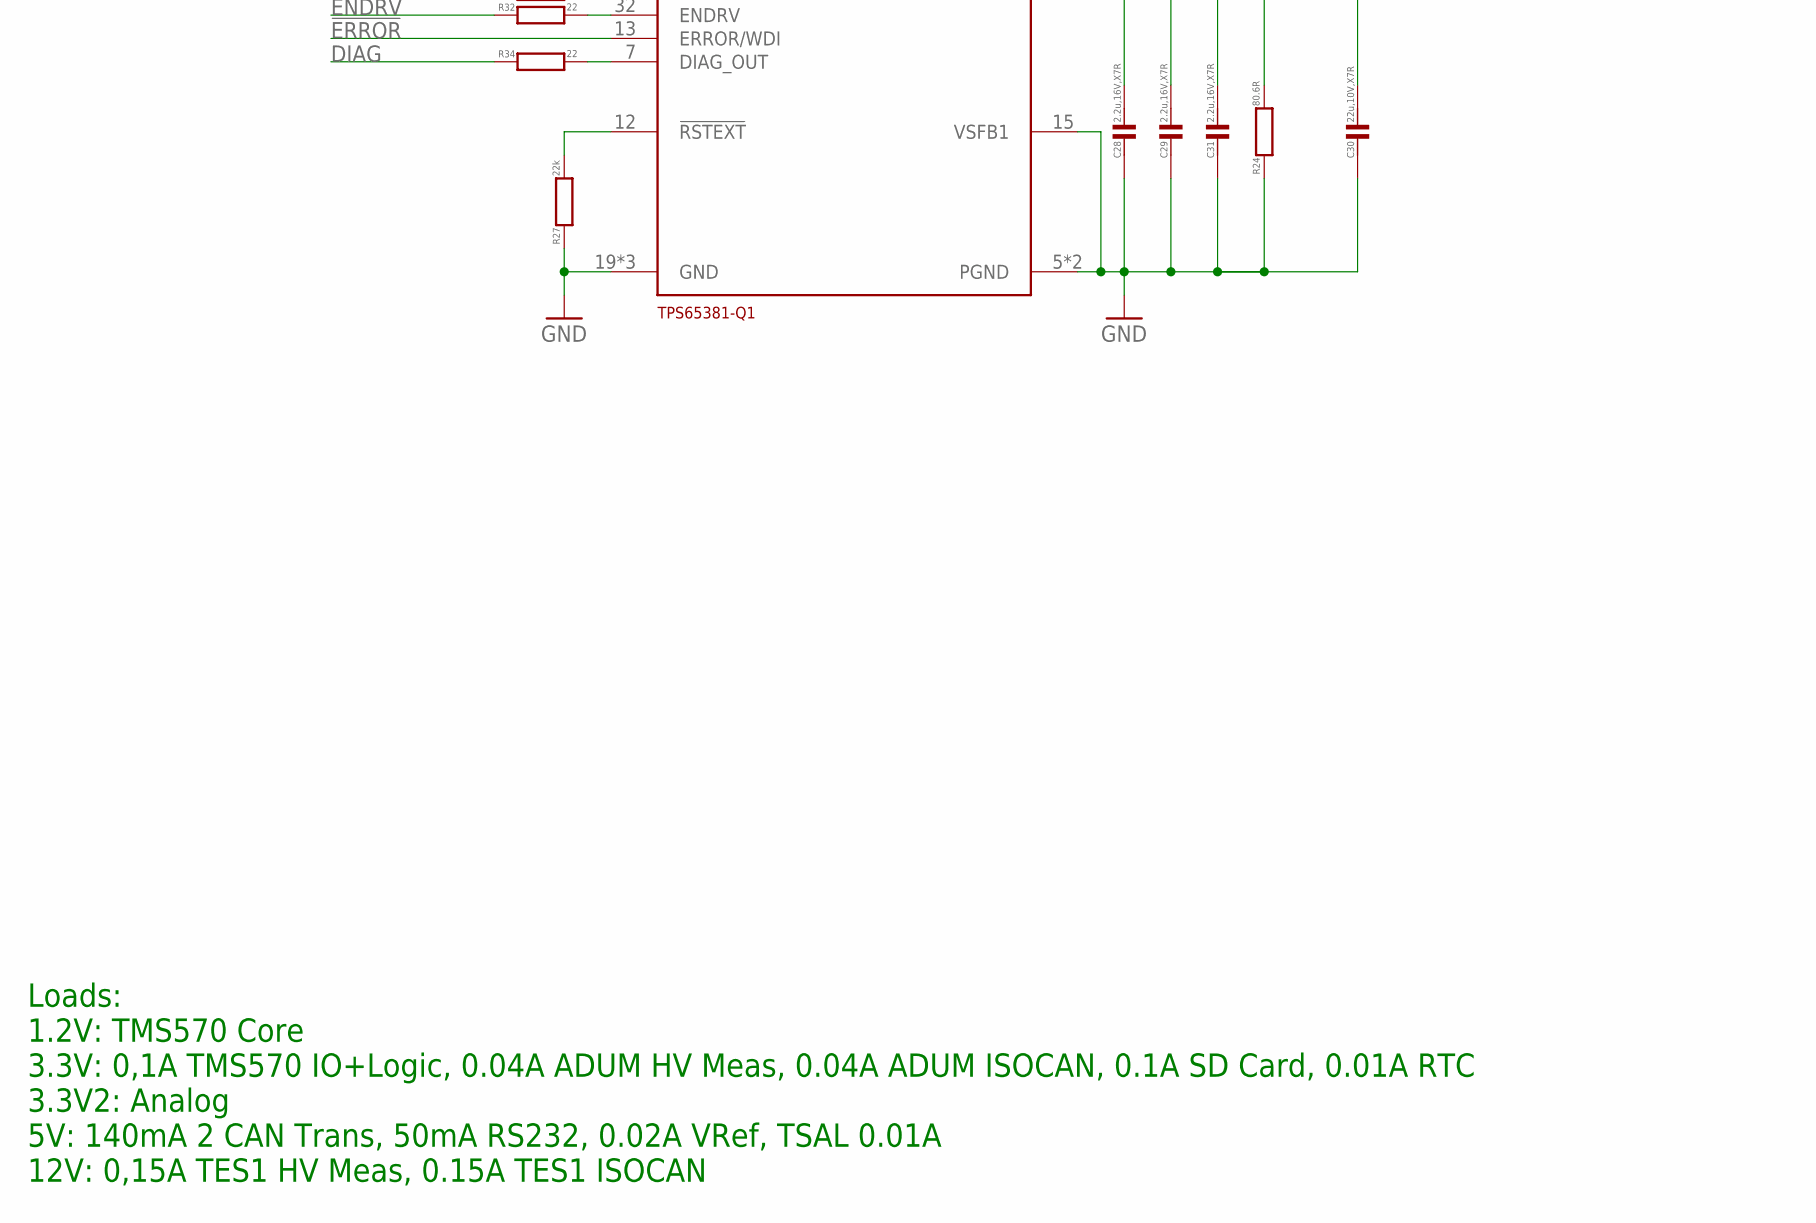
[picture p84: schematic bms_master_V01.sch, sheet 2, part in row 2, column 1]

Parts:
C27, C30, C32: 22u,10V,X7R; C1206
C28, C29, C31: 2.2u,16V,X7R; C0603
C33: 0.47u,50V,X7R; C0603
C34: 10n,50V,X7R; C0603
C35, C39, C40: 100n,50V,X7R; C0603
C37, C38: 4.7u,50V,X7r; C1210
D1: MBRS340T3; SMC
D4: 4V; SOD323-L
D6: 24V; SMB
F1: FUSE-LFMINIHOLDER; LITTLEFUSE_17867640001
F2: 1A; LITTLEFUSE_17867640001
IC4: TPS65381-Q1; DAP-R-PDSO-G32
IC5: TL331-Q1; DBV-R-PDSO-G5
L2: 784776133; WE-PD2_1054
Q3: BUK9213-30A; DPAK
R24: 80.6R; R0603
R25: 43.2R; R0603
R26: 100k; R0402
R27: 22k; R0402
R28, R29, R43, R44: 100k,50V; R0603
R30, R31, R32, R34: 22; R0402
R62: 0R1; R1206

Connections:
8VREF: C40.1, D4.C, IC5.1 (-IN), R29.1
!ERROR: IC4.13 (ERROR/WDI); also elsewhere on the board
+1V2: C30.1, Q3.3 (S), R25.2, R26.1; also elsewhere on the board
+3V3: C29.1, IC4.18 (VTRACK1), IC4.21 (VDD3/5), IC4.22 (VDDIO); also elsewhere on the board
+3V32: C31.1, IC4.17 (VSOUT1); also elsewhere on the board
+5V: C28.1, IC4.20 (VDD5); also elsewhere on the board
+12V: C35.1, C37.1, C38.1, D6.C, F2.2, IC4.1 (VBAT_SAFING), IC4.29 (VBATP); also elsewhere on the board
CP1: C34.1, IC4.3 (CP1)
CP2: C34.2, IC4.4 (CP2)
DIAG: R34.1; also elsewhere on the board
DIAG_OUT: IC4.7 (DIAG_OUT), R34.2
ENDRV: R32.1; also elsewhere on the board
ENDRVOUT: IC4.32 (ENDRV), R32.2
GND: C27.1, C28.2, C29.2, C30.2, C31.2, C32.1, C33.2, C37.2, C38.2, C39.2, C40.2, D1.A, D4.A, D6.A, IC4.5 (PGND), IC4.14 (CANWU), IC4.15 (VSFB1), IC4.19 (GND), IC4.23 (GND), IC4.25 (PGND), IC4.P (GND), IC5.2 (GND), R24.1, R27.1, R44.1; also elsewhere on the board
IGN: IC4.30 (IGN), IC5.4 (OUT), R28.1
LV_12V: F2.1; also elsewhere on the board
unnamed: C33.1, IC5.3 (+IN), R43.1, R44.2
unnamed: C27.2, C32.2, R62.2
unnamed: D1.C, IC4.28 (SDN6), L2.2
PORRSTN: R30.1; also elsewhere on the board
PORRSTOUT: IC4.6 (!RES), R30.2
RSTEXT: IC4.12 (!RSTEXT), R27.2
SDO: IC4.10 (SDO), R31.2
TPS_!CS: IC4.8 (!CS); also elsewhere on the board
TPS_MISO: R31.1; also elsewhere on the board
TPS_MOSI: IC4.9 (SDI); also elsewhere on the board
TPS_SCK: IC4.11 (SCLK); also elsewhere on the board
VCP: C35.2, IC4.2 (VCP)
VDD1_G: IC4.26 (VDD1_G), Q3.1 (G), R26.2
VDD1_SENSE: IC4.24 (VDD1_SENSE), R24.2, R25.1
VDD6: IC4.16 (VSIN), IC4.27 (VDD6), L2.1, Q3.4 (D), R62.1
VIN: C39.1, IC5.5 (V+), R28.2, R29.2, R43.2; also elsewhere on the board

Notes on the sheet:
Put fuse on DCDC Output
Loads: 1.2V: TMS570 Core 3.3V: 0,1A TMS570 IO+Logic, 0.04A ADUM HV Meas, 0.04A ADUM ISOCAN, 0.1A SD Card, 0.01A RTC 3.3V2: Analog 5V: 140mA 2 CAN Trans, 50mA RS232, 0.02A VRef, TSAL 0.01A 12V: 0,15A TES1 HV Meas, 0.15A TES1 ISOCAN
SPI, !ERROR!, DIAG, RST to uC, ENDRV to Security
1.2V, 3.3V, 5V, 12V
