funkobongrip/sprbms/hardware/nextgen_master/bms_master_V01.brd

## EAGLE design hardware/nextgen_master/bms_master_V01.brd (continued)

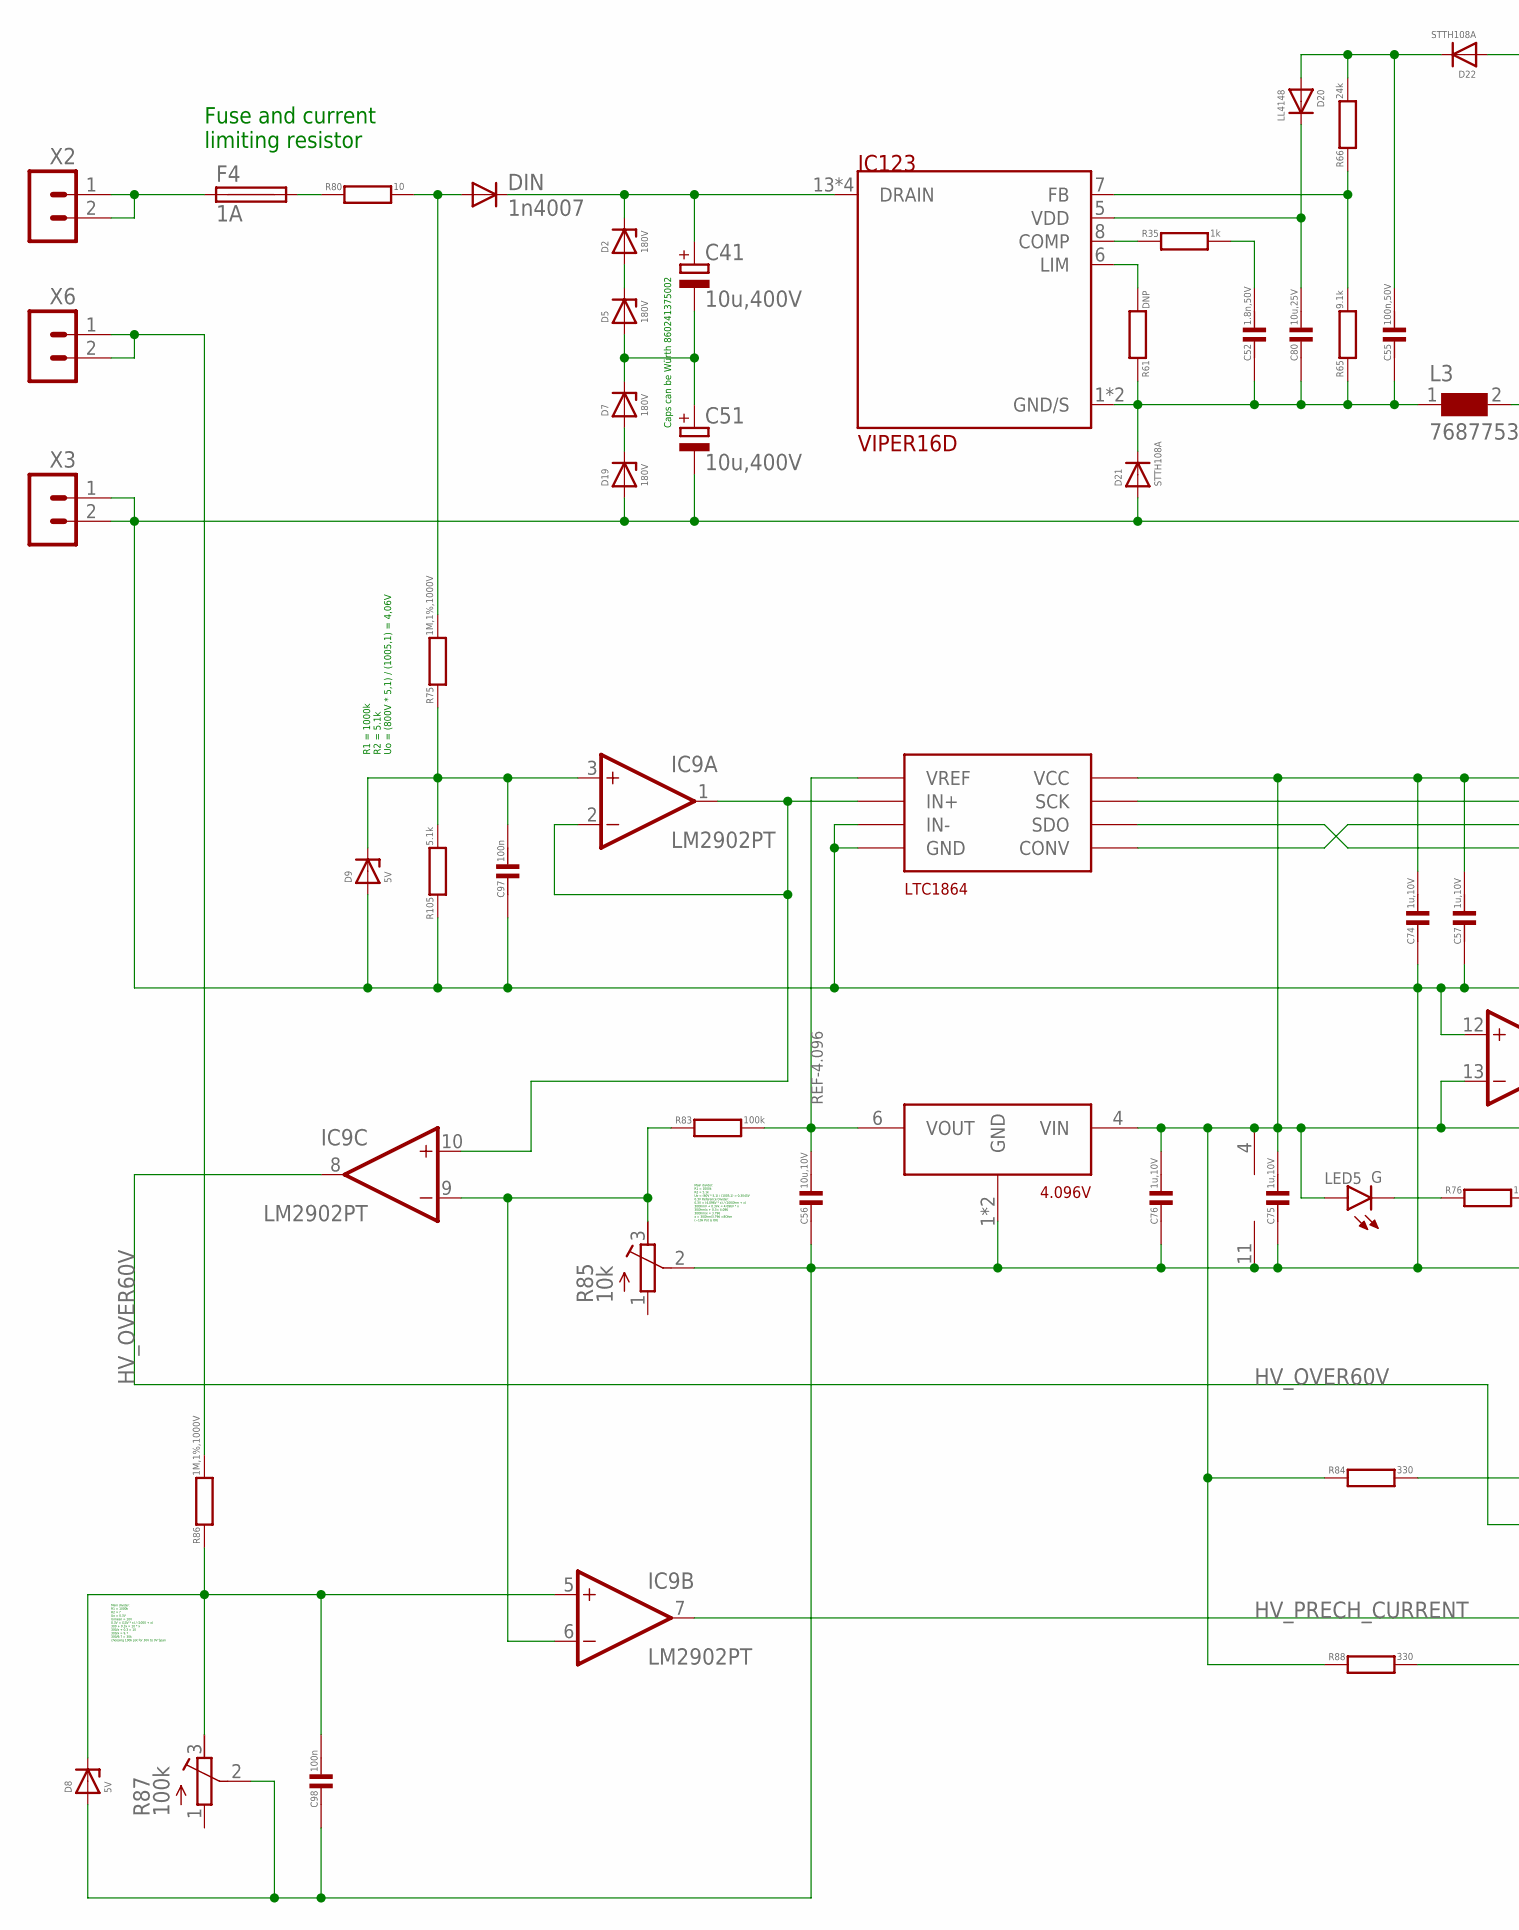
[picture p85: schematic bms_master_V01.sch, sheet 3, part in row 1, column 1]

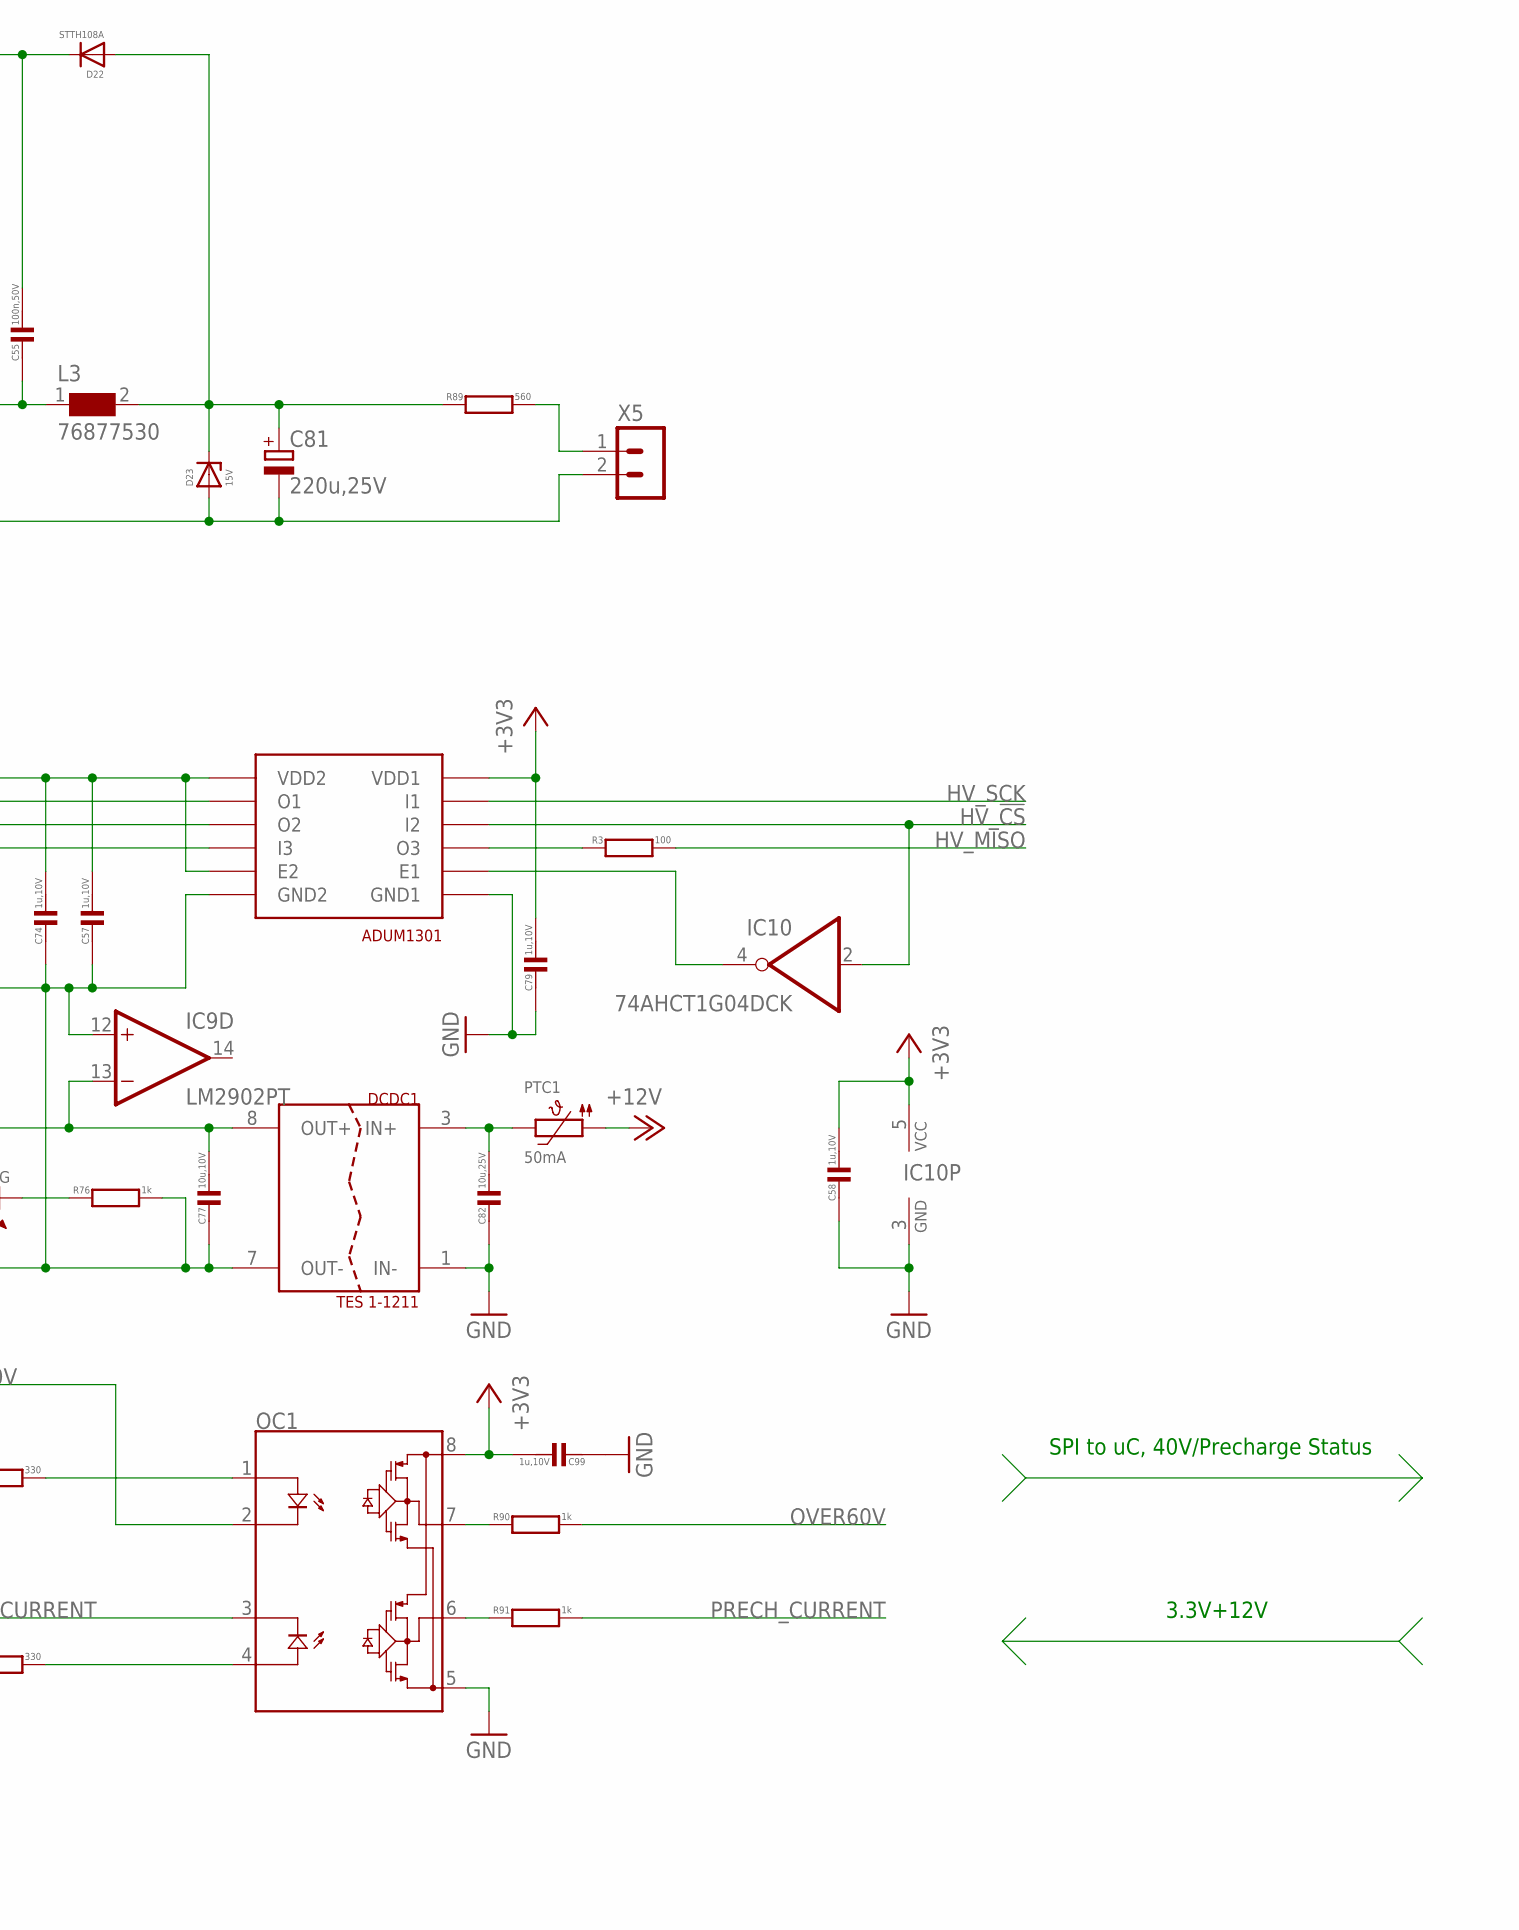
[picture p86: schematic bms_master_V01.sch, sheet 3, part in row 1, column 2]

Parts:
C41, C51: 10u,400V; E5-10,5
C52: 1.8n,50V; C0603
C55: 100n,50V; C0603
C56, C77: 10u,10V; C0603
C57, C58, C74, C75, C76, C79, C99: 1u,10V; C0402
C80, C82: 10u,25V; C1210
C81: 220u,25V; E3,5-8
C97, C98: 100n; C0603
D2, D5, D7, D19: 180V; DO-214AC
D8, D9: 5V; SOD323-L
D20: LL4148; MINIMELF
D21, D22: STTH108A; DO-214AC
D23: 15V; DO-214AC
DCDC1: TES 1-1211; DCDC_SMD_TES1
DIN: 1n4007; DO-214AC
F4: 1A; LF485
IC9: LM2902PT; SSOP14
IC10: 74AHCT1G04DCK; SC70-5
IC123: VIPER16D; SO16
L3: 76877530; WE-PD2_7850
LED5: G; CHIPLED_0603
OC1: ACPL-K7X; SO-8-STRETCHED
PTC1: 50mA; PTC1210
R3: 100; R0402
R35: 1k; R0603
R61: DNP; R0603
R65: 9.1k; R0603
R66: 24k; R0603
R75, R86: 1M,1%,1000V; R2512
R76, R90, R91: 1k; R0402
R80: 10; R1206
R83: 100k; R0402
R84, R88: 330; R0402
R85: 10k; RTRIM3224W
R87: 100k; RTRIM3224W
R89: 560; R1206
R105: 5.1k; R1206
U$3: 4.096V; SOT23-6
U$20: LTC1864; MS8
U$22: ADUM1301; SO16WB
X2, X3, X5, X6: HEADER_POS2_43650-0212; 43650-0212

Connections:
+3V3: C58.1, C79.1, C99.1, IC10.5 (VCC), OC1.8, U$22.P$1 (VDD1); also elsewhere on the board
+12V: PTC1.P$1 (1); also elsewhere on the board
CHV_5V: C57.1, C74.1, C75.1, C76.1, C77.1, DCDC1.8 (OUT+), IC9.4 (V+), IC9.13 (-IN), LED5.A, R84.1, R88.1, U$3.4 (VIN), U$20.P$8 (VCC), U$22.P$10 (E2), U$22.P$16 (VDD2)
CHV_+: F4.1, X2.1, X2.2
CHV_+_FUSED: F4.2, R80.1
CHV_+_FUSEDR: DIN.A, R75.2, R80.2
CHV_CONV: U$20.P$5 (CONV), U$22.P$13 (O2)
CHV_GND: C51.-, C56.2, C57.2, C74.2, C75.2, C76.2, C77.2, C81.-, C97.2, C98.2, D8.A, D9.A, D19.A, D21.A, D23.A, DCDC1.7 (OUT-), IC9.11 (V-), IC9.12 (+IN), R76.2, R85.2 (S), R87.2 (S), R105.1, U$3.1 (GND), U$3.2 (GND), U$20.P$3 (IN-), U$20.P$4 (GND), U$22.P$9 (GND2), U$22.P$15 (GND2), X3.1, X3.2, X5.2
CHV_LEDC: LED5.C, R76.1
CHV_M: C97.1, D9.C, IC9.3 (+IN), R75.1, R105.2
CHV_M1: C98.1, D8.C, IC9.5 (+IN), R86.1, R87.3 (E)
CHV_MOP: IC9.1 (OUT), IC9.2 (-IN), IC9.10 (+IN), U$20.P$2 (IN+)
CHV_SCK: U$20.P$7 (SCK), U$22.P$14 (O1)
CHV_SDO: U$20.P$6 (SDO), U$22.P$12 (I3)
CLV_12V_TES1_FUSED: C82.1, DCDC1.3 (IN+), PTC1.P$2 (2)
GND: C58.2, C79.2, C82.2, C99.2, DCDC1.1 (IN-), IC10.3 (GND), OC1.5, U$22.P$2 (GND1), U$22.P$8 (GND1); also elsewhere on the board
HV_!CS: IC10.2 (I), U$22.P$4 (I2); also elsewhere on the board
HV_MISO: R3.2; also elsewhere on the board
HV_OVER60V: IC9.8 (OUT), OC1.2
HV_PRECH_CURRENT: IC9.7 (OUT), OC1.3
HV_SCK: U$22.P$3 (I1); also elsewhere on the board
unnamed: IC10.4 (O), U$22.P$7 (E1)
unnamed: R3.1, U$22.P$5 (O3)
unnamed: R86.2, X6.1, X6.2
unnamed: OC1.1, R84.2
unnamed: OC1.4, R88.2
OVER60V: R90.2; also elsewhere on the board
PRECH_CURRENT: R91.2; also elsewhere on the board
R!OVER40V: OC1.7, R90.1
R!PRECH_CURRENT: OC1.6, R91.1
REF0.3W: IC9.6 (-IN), IC9.9 (-IN), R83.1, R85.3 (E)
REF-4.096: C56.1, R83.2, U$3.6 (VOUT), U$20.P$1 (VREF)
VP+3/4: D7.A, D19.C
VP_12V: C81.+, D22.A, D23.C, L3.2, R89.1
VP_12VINT: C55.1, D20.A, D22.C, R66.2
VP_+: C41.+, D2.C, DIN.C, IC123.13 (DRAIN), IC123.14 (DRAIN), IC123.15 (DRAIN), IC123.16 (DRAIN)
VP_+1/3: D2.A, D5.C
VP_+/2: C41.-, C51.+, D5.A, D7.C
VP_COMP: IC123.8 (COMP), R35.1
VP_COMPM: C52.1, R35.2
VP_FB: IC123.7 (FB), R65.2, R66.1
VP_LED: R89.2, X5.1
VP_LIM: IC123.6 (LIM), R61.2
VP_S: C52.2, C55.2, C80.2, D21.C, IC123.1 (GND/S), IC123.2 (GND/S), L3.1, R61.1, R65.1
VP_VDD: C80.1, D20.C, IC123.5 (VDD)

Notes on the sheet:
Fuse and current limiting resistor
Caps can be Würth 860241375002
R1 = 1000k R2 = 5.1k Uo = (800V * 5,1) / (1005,1) = 4,06V
SPI to uC, 40V/Precharge Status
3.3V+12V
Main divider: R1 = 1000k R2 = 5.1k Uo = (60V * 5,1) / (1005,1) = 0.3045V 0.3V Reference Divider: 0.3V = (4.096V * x) / (100Ohm + x) 30OhmV + 0.3Vx = 4.096V * x 30Ohm/x + 0.3= 4.096 30Ohm/x = 3.796 x = 30Ohm/3.796 =8Ohm (~10k Pot is OK)
Main divider: R1 = 1000k R2 = ? Uo = 0.3V Uimean = 10V 0.3V = (10V * x) / (1000 + x) 300 + 0.3x = 10 * x 300/x + 0.3 = 10 300/x = 9.7 300/9.7 = 30k choosing 100k pot for 30V to 0V Span

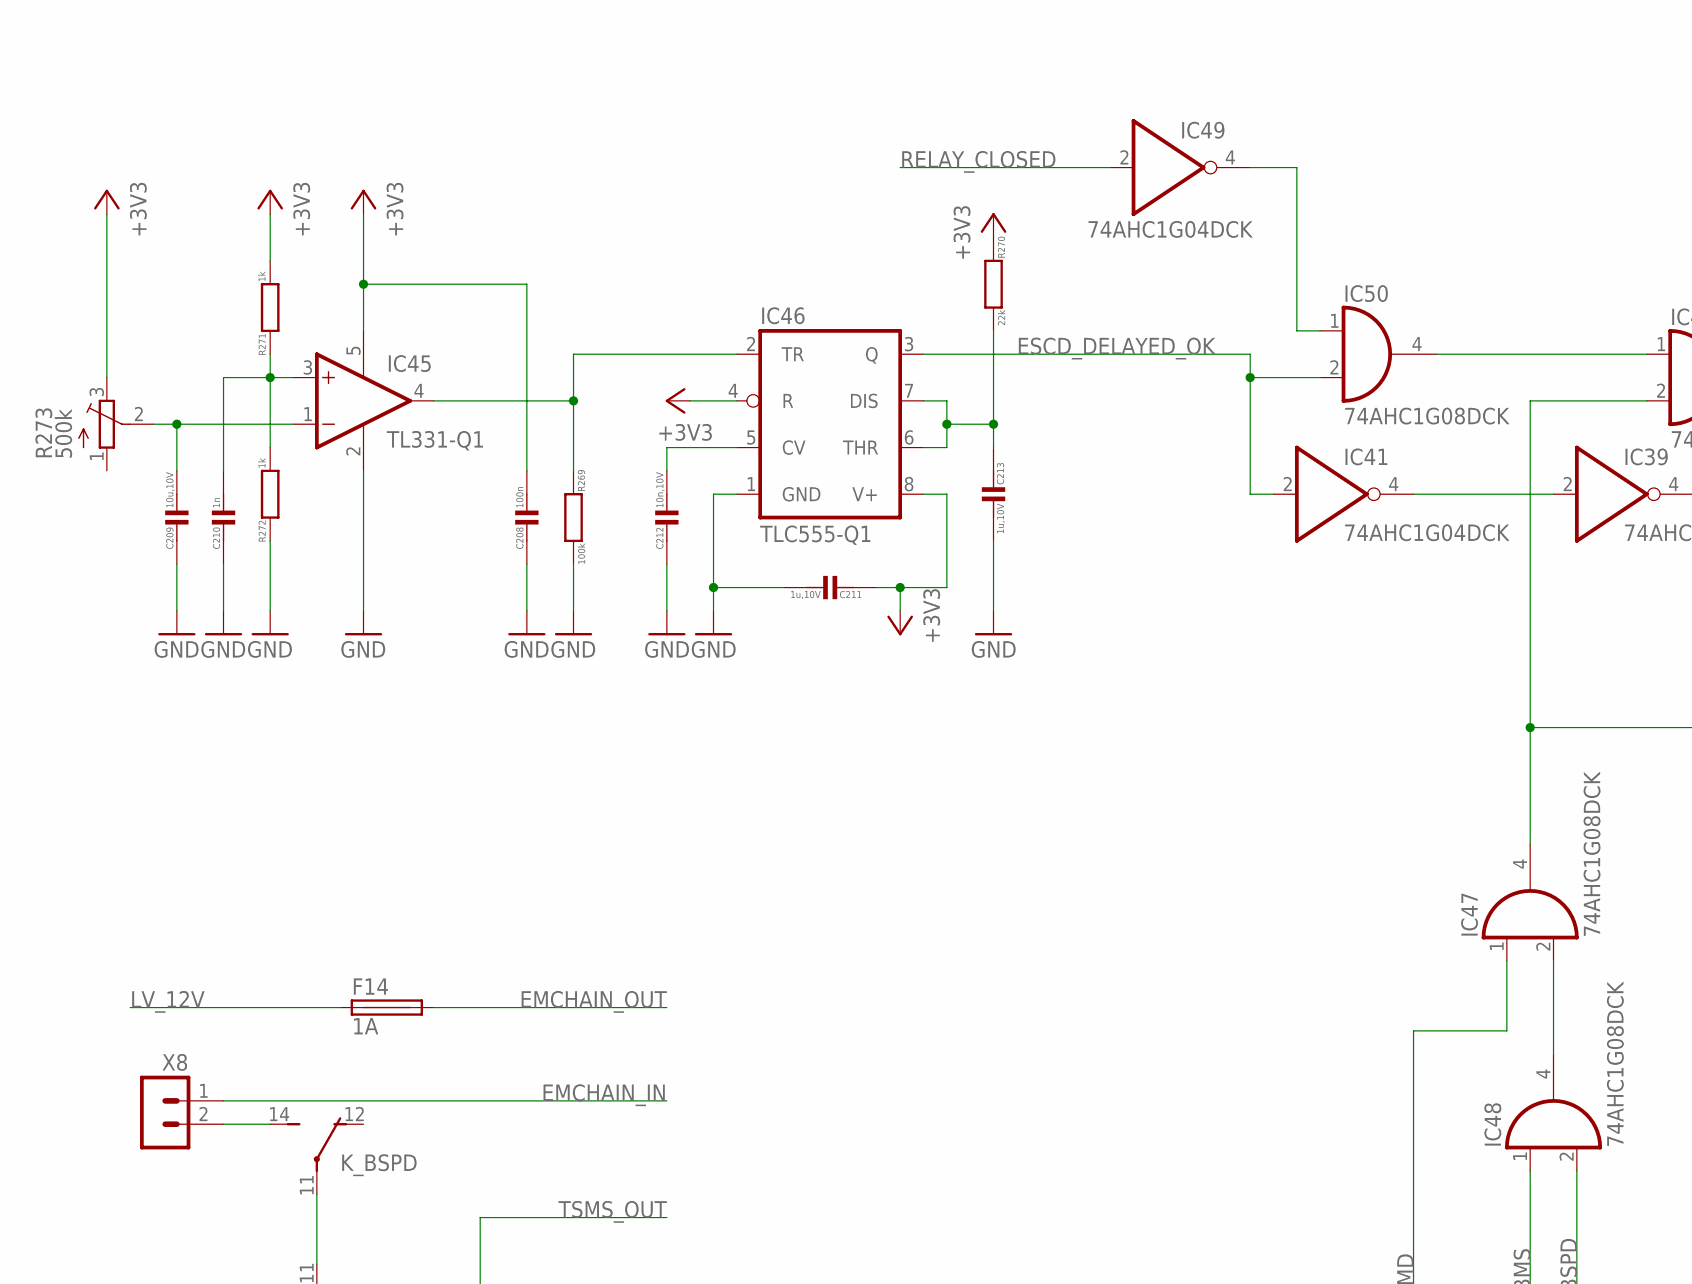
[picture p87: schematic bms_master_V01.sch, sheet 4, part in row 1, column 1]

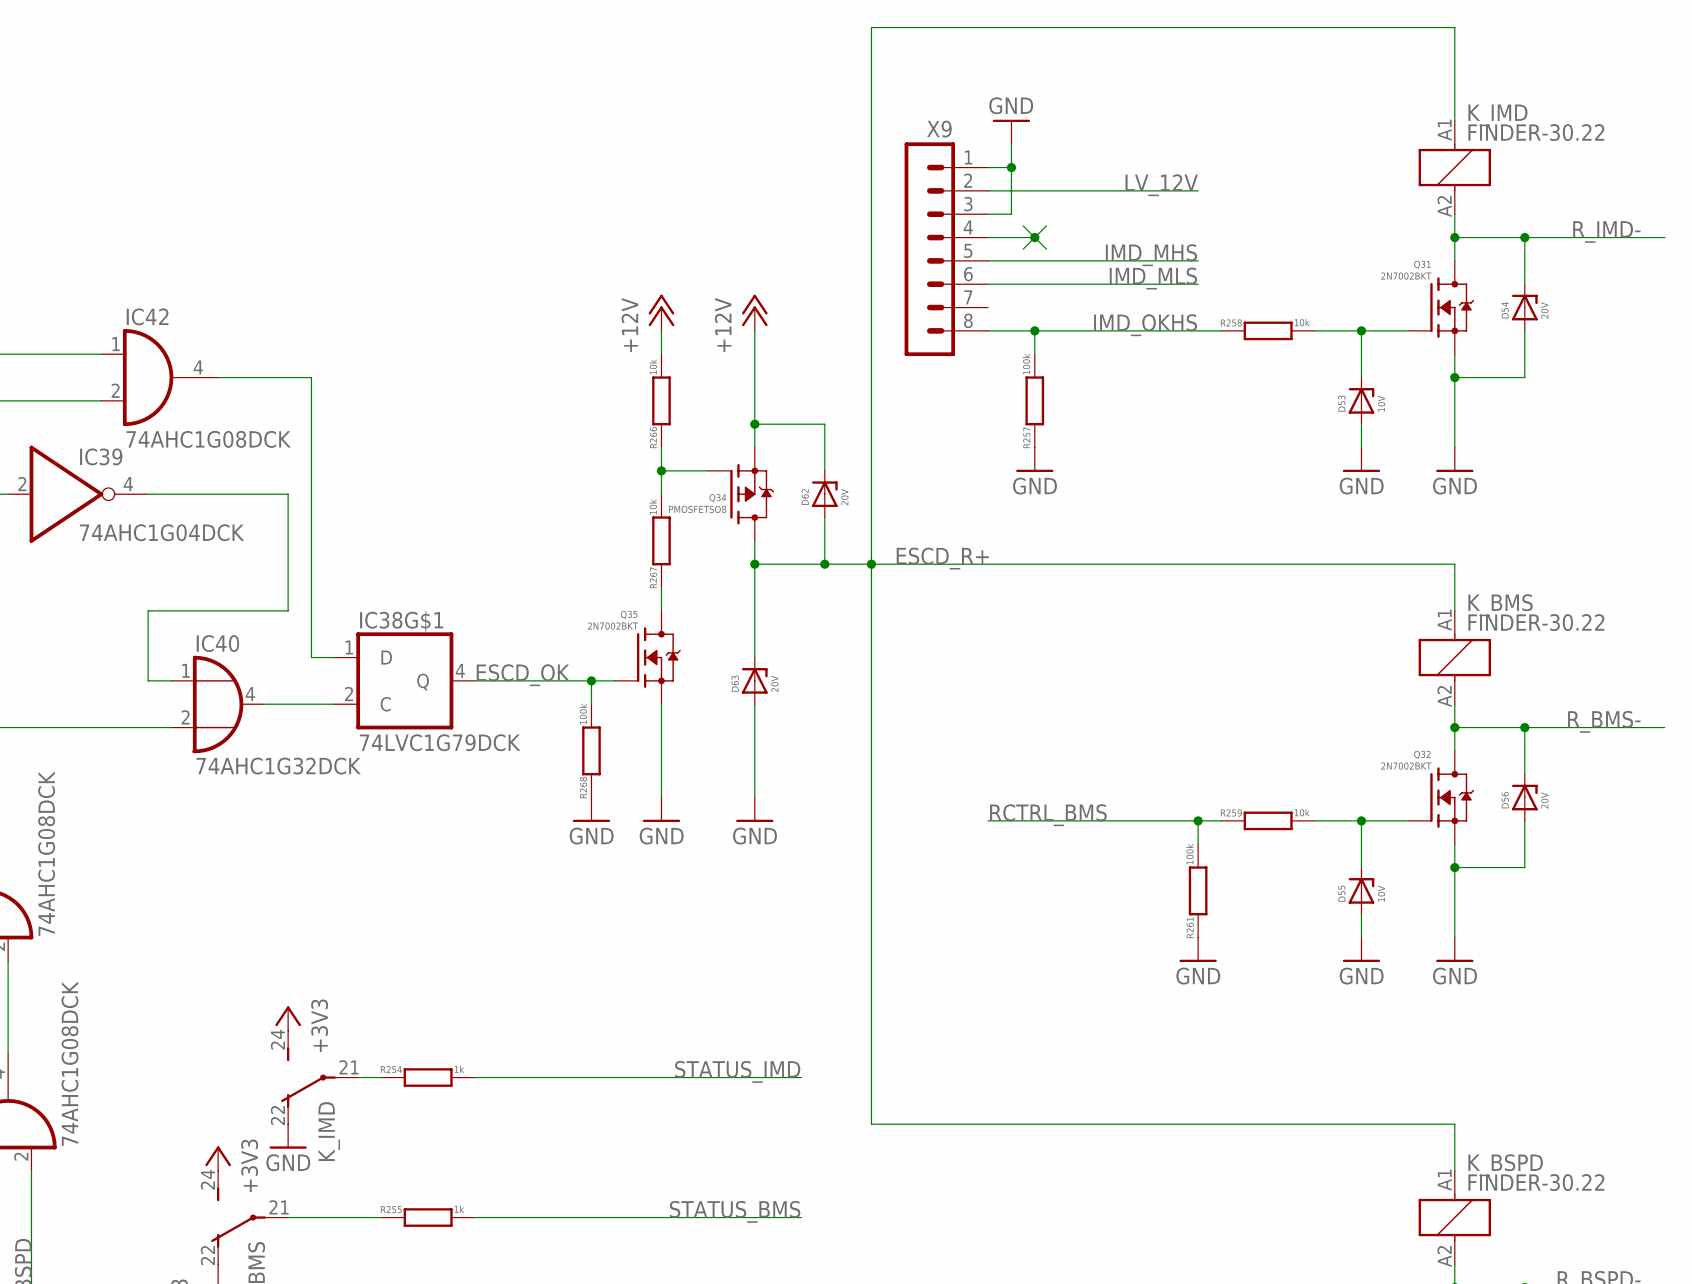
[picture p88: schematic bms_master_V01.sch, sheet 4, part in row 1, column 2]

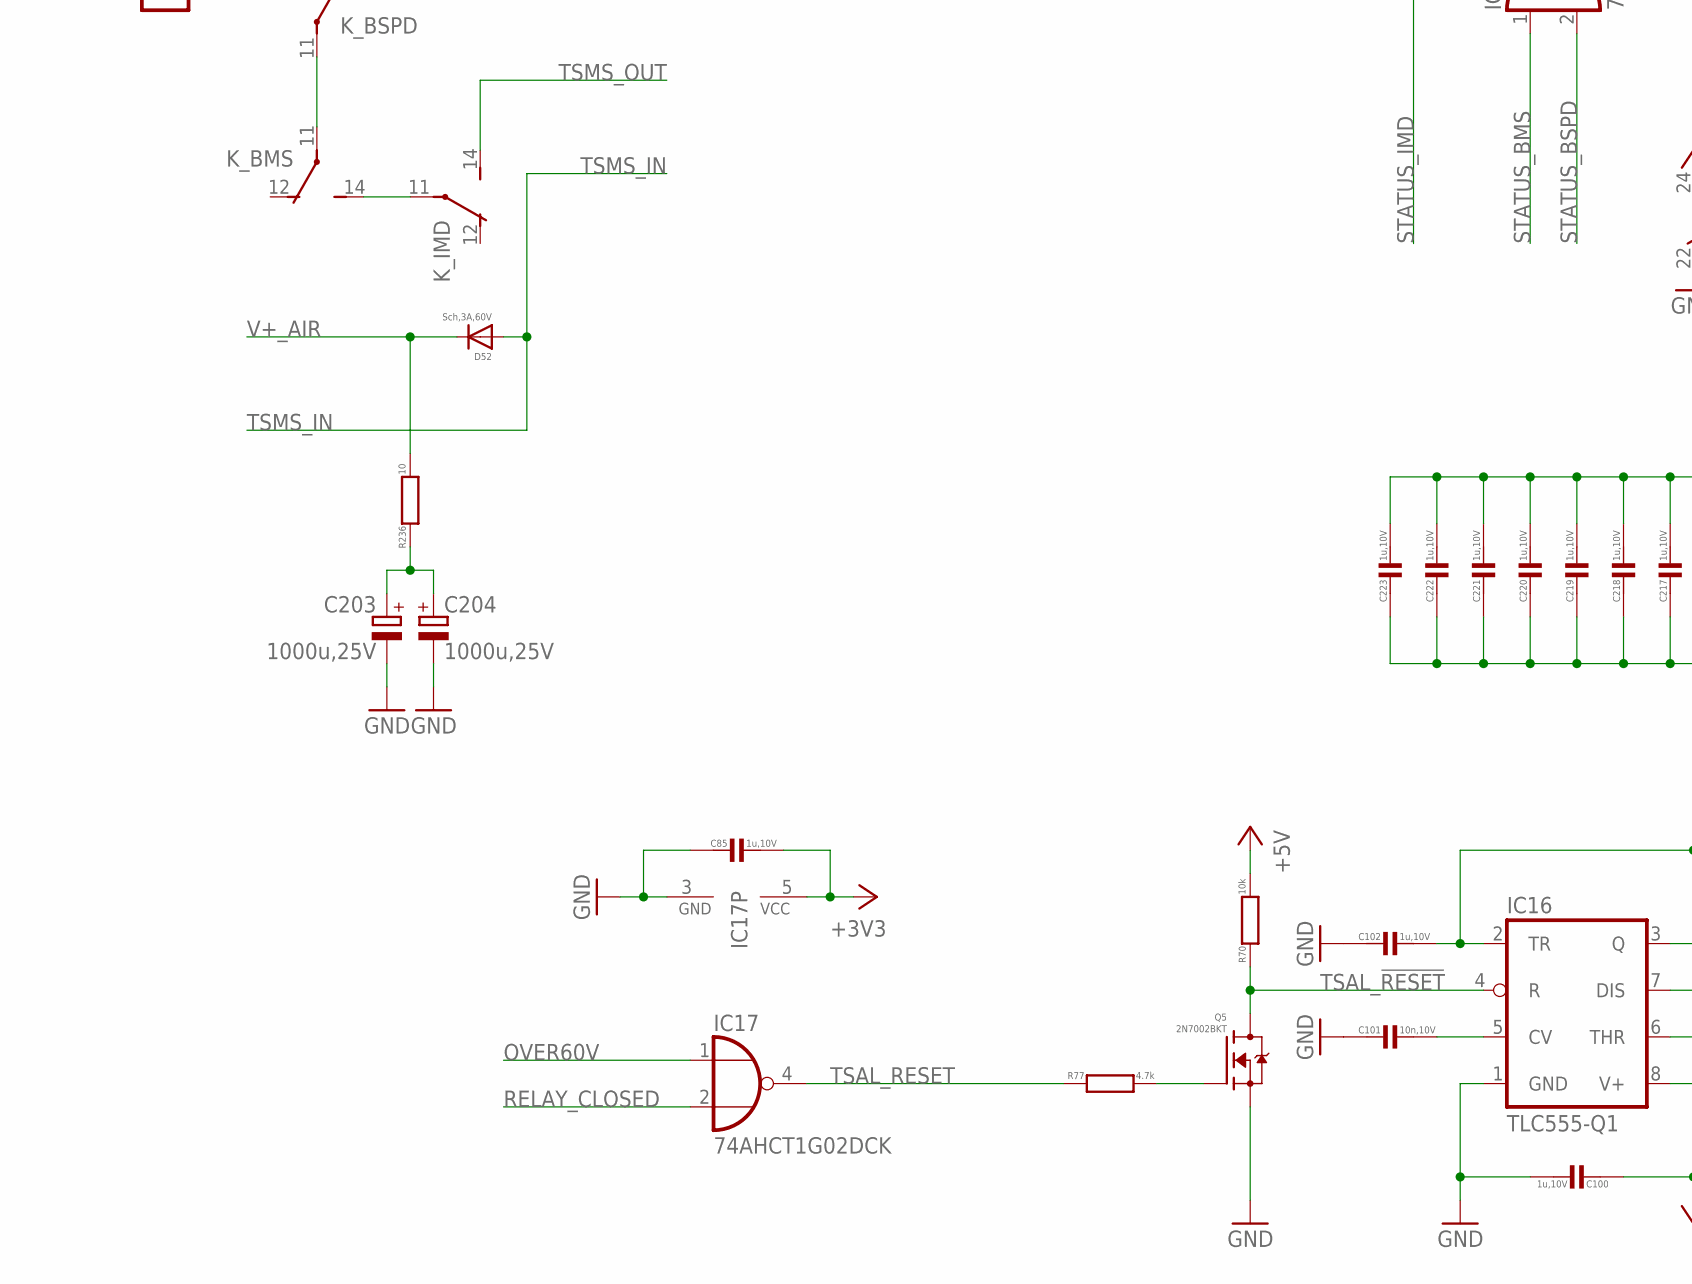
[picture p89: schematic bms_master_V01.sch, sheet 4, part in row 2, column 1]

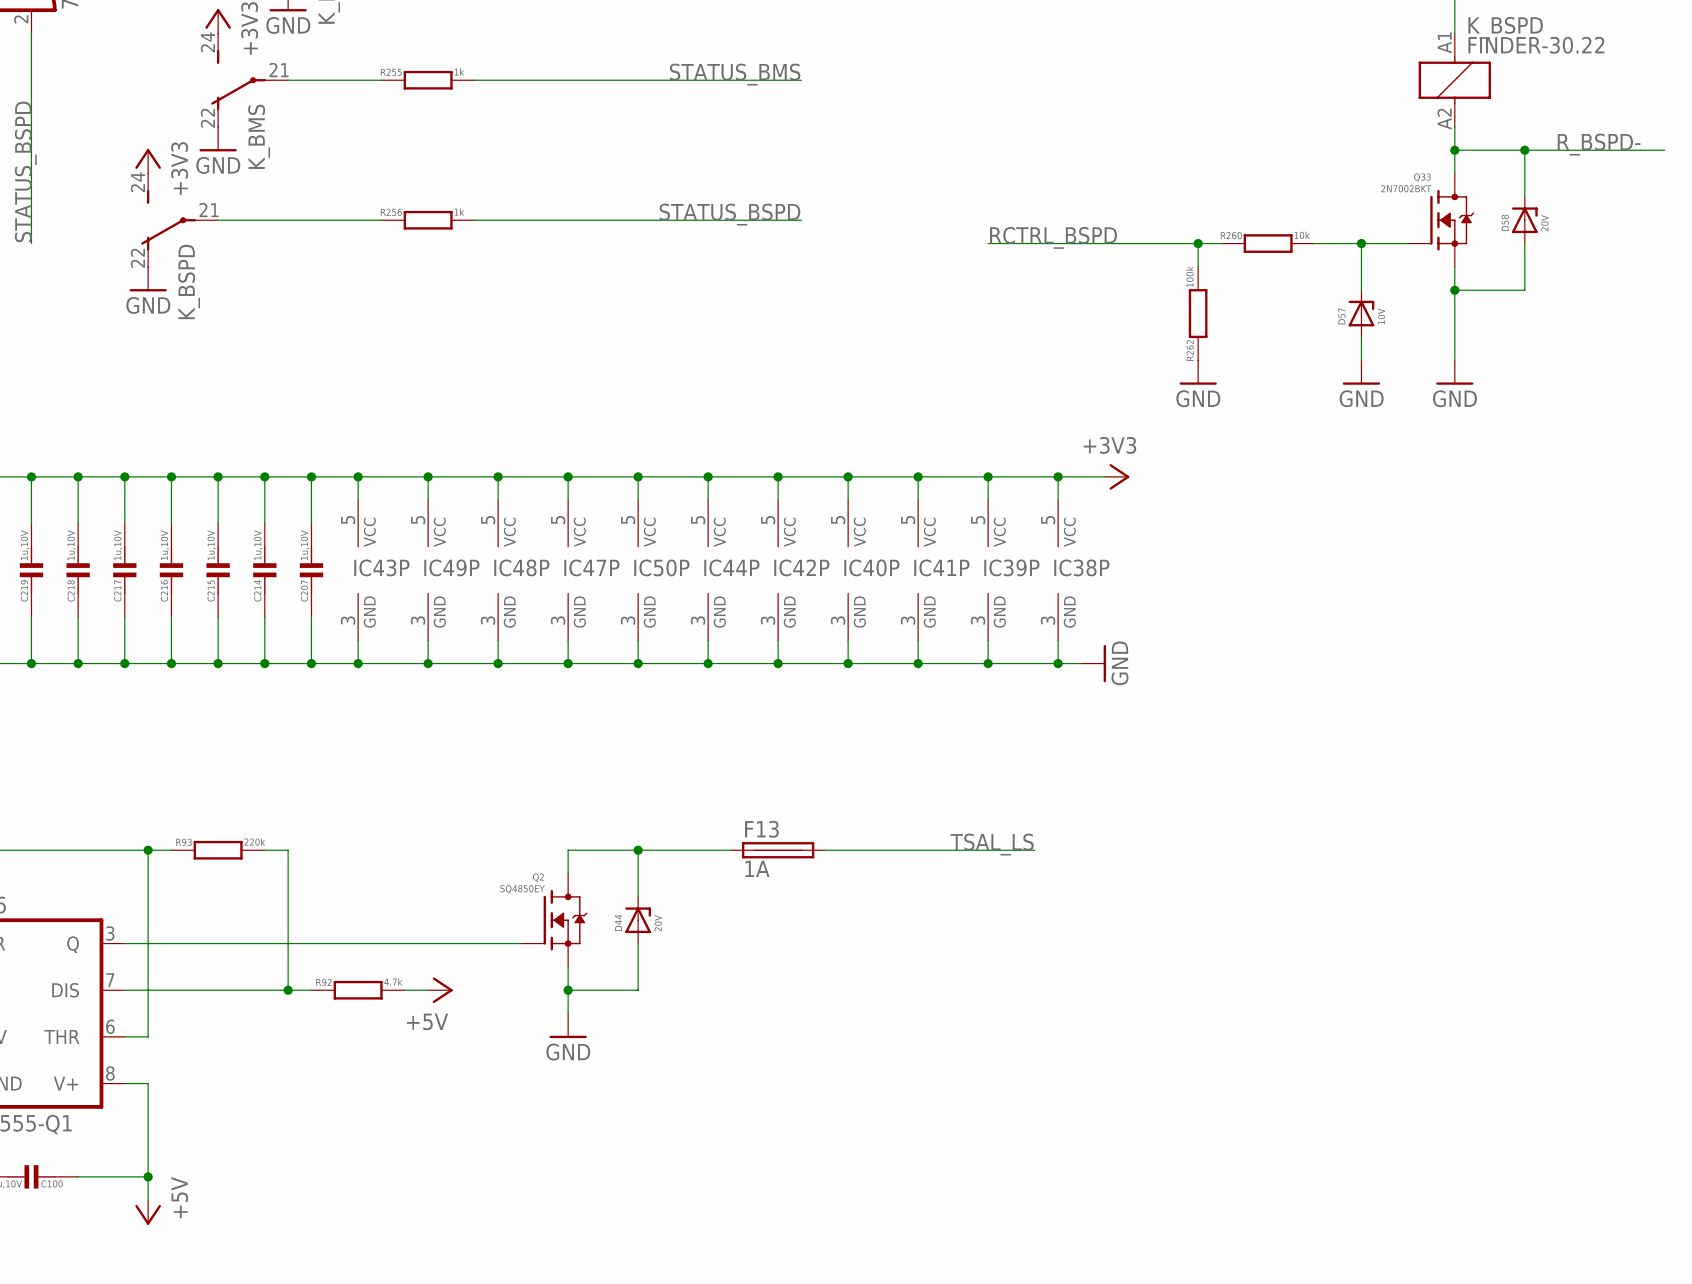
[picture p90: schematic bms_master_V01.sch, sheet 4, part in row 2, column 2]

Parts:
C85, C100, C102, C207, C211, C213, C214, C215, C216, C217, C218, C219, C220, C221, C222, C223: 1u,10V; C0402
C101, C212: 10n,10V; C0402
C203, C204: 1000u,25V; E5-13
C208: 100n; C0402
C209: 10u,10V; C0603
C210: 1n; C0402
D44, D54, D56, D58, D62, D63: 20V; DO-214AC
D52: Sch,3A,60V; DO-214AC
D53, D55, D57: 10V; SOD323-L
F13, F14: 1A; LITTLEFUSE_17867640001
IC16, IC46: TLC555-Q1; SO08
IC17: 74AHCT1G02DCK; SC70-5
IC38: 74LVC1G79DCK; SC70-5
IC39, IC41, IC49: 74AHC1G04DCK; SC70-5
IC40, IC43: 74AHC1G32DCK; SC70-5
IC42, IC47, IC48, IC50: 74AHC1G08DCK; SC70-5
IC44: 74AHC1G02DCK; SC70-5
IC45: TL331-Q1; DBV-R-PDSO-G5
K_BMS: FINDER-30.22
K_BSPD: FINDER-30.22
K_IMD: FINDER-30.22
Q2: SQ4850EY; SO-8
Q5, Q31, Q32, Q33, Q35: 2N7002BKT; SOT416
Q34: PMOSFETSO8; SO-8
R70, R258, R259, R260, R266, R267: 10k; R0402
R77, R92: 4.7k; R0402
R93: 220k; R0402
R236: 10; R1206
R254, R255, R256, R271, R272: 1k; R0402
R257, R261, R262, R268, R269: 100k; R0402
R270: 22k; R0402
R273: 500k; 3223W
X8: HEADER_POS2_43650-0212; 43650-0212
X9: HEADER_POS8_43650-0812; 43650-0812

Connections:
8VREF1: C209.1, IC45.1 (-IN), R273.2 (S)
+3V3: C85.1, C207.1, C208.1, C211.2, C214.1, C215.1, C216.1, C217.1, C218.1, C219.1, C220.1, C221.1, C222.1, C223.1, IC17.5 (VCC), IC38.5 (VCC), IC39.5 (VCC), IC40.5 (VCC), IC41.5 (VCC), IC42.5 (VCC), IC43.5 (VCC), IC44.5 (VCC), IC45.5 (V+), IC46.4 (R), IC46.8 (V+), IC47.5 (VCC), IC48.5 (VCC), IC49.5 (VCC), IC50.5 (VCC), K_BMS.24 (S), K_BSPD.24 (S), K_IMD.24 (S), R270.1, R271.2, R273.3 (E); also elsewhere on the board
+12V: D62.C, Q34.1 (S), Q34.2 (S), Q34.3 (S), R266.2; also elsewhere on the board
CAR+5V: C100.2, IC16.8 (V+), R70.2, R92.2
EMCHAIN_IN: X8.1
EMCHAIN_OUT: F14.2
ESCD_DELAYED_OK: IC41.2 (I), IC46.3 (Q), IC50.2 (I1)
ESCD_OK: IC38.4 (Q), Q35.1 (G), R268.2
ESCD_R+: D62.A, D63.C, K_BMS.A1 (1), K_BSPD.A1 (1), K_IMD.A1 (1), Q34.5 (D), Q34.6 (D), Q34.7 (D), Q34.8 (D)
GND: C85.2, C100.1, C101.2, C102.2, C203.-, C204.-, C207.2, C208.2, C209.2, C210.2, C211.1, C212.2, C213.1, C214.2, C215.2, C216.2, C217.2, C218.2, C219.2, C220.2, C221.2, C222.2, C223.2, D44.A, D53.A, D54.A, D55.A, D56.A, D57.A, D58.A, D63.A, IC16.1 (GND), IC17.3 (GND), IC38.3 (GND), IC39.3 (GND), IC40.3 (GND), IC41.3 (GND), IC42.3 (GND), IC43.3 (GND), IC44.3 (GND), IC45.2 (GND), IC46.1 (GND), IC47.3 (GND), IC48.3 (GND), IC49.3 (GND), IC50.3 (GND), K_BMS.22 (O), K_BSPD.22 (O), K_IMD.22 (O), Q2.1 (S), Q2.2 (S), Q2.3 (S), Q5.2 (S), Q31.2 (S), Q32.2 (S), Q33.2 (S), Q35.2 (S), R257.1, R261.1, R262.1, R268.1, R269.2, R272.1, X9.1, X9.3; also elsewhere on the board
IMD_MHS: X9.5
IMD_MLS: X9.6
IMD_OKHS: R257.2, R258.1, X9.8
LV_12V: F14.1, X9.2; also elsewhere on the board
unnamed: IC16.3 (Q), Q2.4 (G)
unnamed: K_BSPD.14 (S), X8.2
unnamed: K_BMS.11, K_BSPD.11
unnamed: K_BMS.14 (S), K_IMD.11
unnamed: C203.+, C204.+, R236.1
unnamed: K_BSPD.21, R256.1
unnamed: K_BMS.21, R255.1
unnamed: K_IMD.21, R254.1
unnamed: D53.C, Q31.1 (G), R258.2
unnamed: D55.C, Q32.1 (G), R259.2
unnamed: D57.C, Q33.1 (G), R260.2
unnamed: Q34.4 (G), R266.1, R267.2
unnamed: Q35.3 (D), R267.1
unnamed: IC38.2 (C), IC40.4 (O)
unnamed: IC39.4 (O), IC40.1 (I0)
unnamed: IC39.2 (I), IC41.4 (O)
unnamed: IC38.1 (D), IC42.4 (O)
unnamed: IC40.2 (I1), IC42.2 (I1), IC47.4 (O)
unnamed: IC47.2 (I1), IC48.4 (O)
unnamed: C210.1, IC45.3 (+IN), R271.1, R272.2
unnamed: IC45.4 (OUT), IC46.2 (TR), R269.1
unnamed: C213.2, IC46.6 (THR), IC46.7 (DIS), R270.2
unnamed: IC42.1 (I0), IC50.4 (O)
unnamed: IC49.4 (O), IC50.1 (I0)
OVER60V: IC17.1 (I0); also elsewhere on the board
RCTRL_BMS: R259.1, R261.2
RCTRL_BSPD: R260.1, R262.2
RELAY_CLOSED: IC17.2 (I1), IC49.2 (I); also elsewhere on the board
R_BMS-: D56.C, K_BMS.A2 (2), Q32.3 (D)
R_BSPD-: D58.C, K_BSPD.A2 (2), Q33.3 (D)
R_IMD-: D54.C, K_IMD.A2 (2), Q31.3 (D)
STATUS_BMS: IC48.1 (I0), R255.2; also elsewhere on the board
STATUS_BSPD: IC48.2 (I1), R256.2; also elsewhere on the board
STATUS_IMD: IC47.1 (I0), R254.2; also elsewhere on the board
TSAL_!RESET: IC16.4 (R), Q5.3 (D), R70.1
TSAL_CV: C101.1, IC16.5 (CV)
TSAL_CV1: C212.1, IC46.5 (CV)
TSAL_DIS: IC16.7 (DIS), R92.1, R93.2
TSAL_DRAIN: D44.C, F13.1, Q2.5 (D), Q2.6 (D), Q2.7 (D), Q2.8 (D)
TSAL_ENG: Q5.1 (G), R77.2
TSAL_LS: F13.2
TSAL_RESET: IC17.4 (O), R77.1
TSAL_TR: C102.1, IC16.2 (TR), IC16.6 (THR), R93.1
TSMS_IN: D52.A
TSMS_OUT: K_IMD.14 (S)
V+_AIR: D52.C, R236.2
