funkobongrip/sprbms/hardware/nextgen_master/bms_master_V01.brd

## EAGLE design hardware/nextgen_master/bms_master_V01.brd (continued)

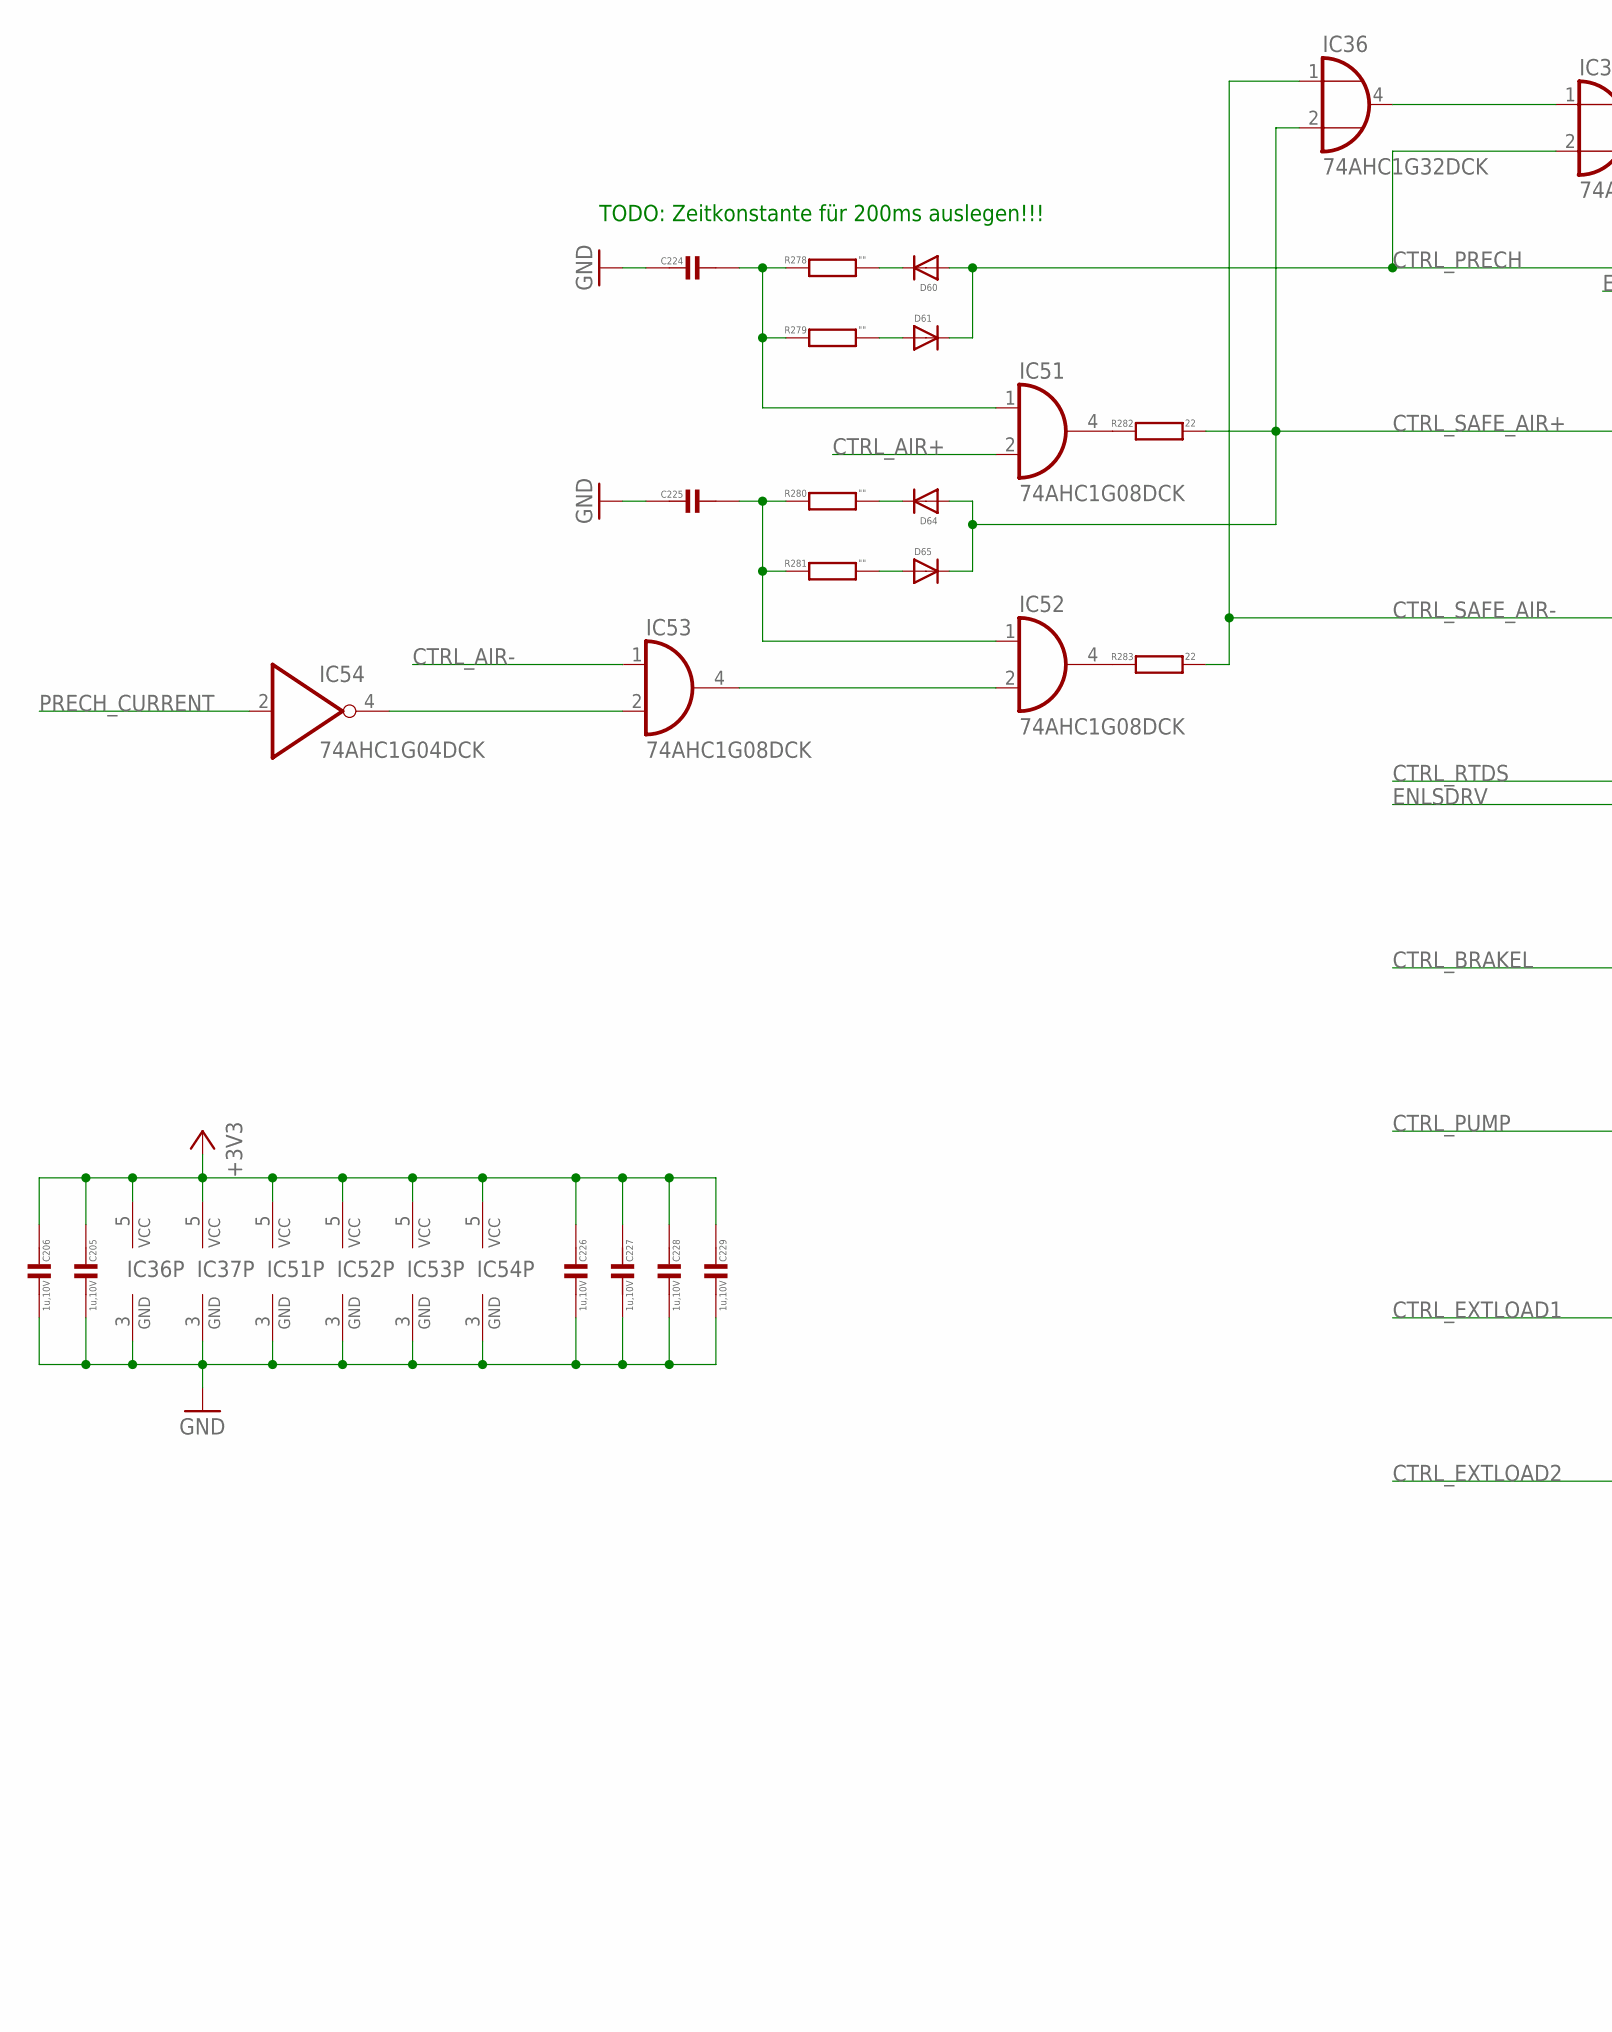
[picture p91: schematic bms_master_V01.sch, sheet 5, part in row 1, column 1]

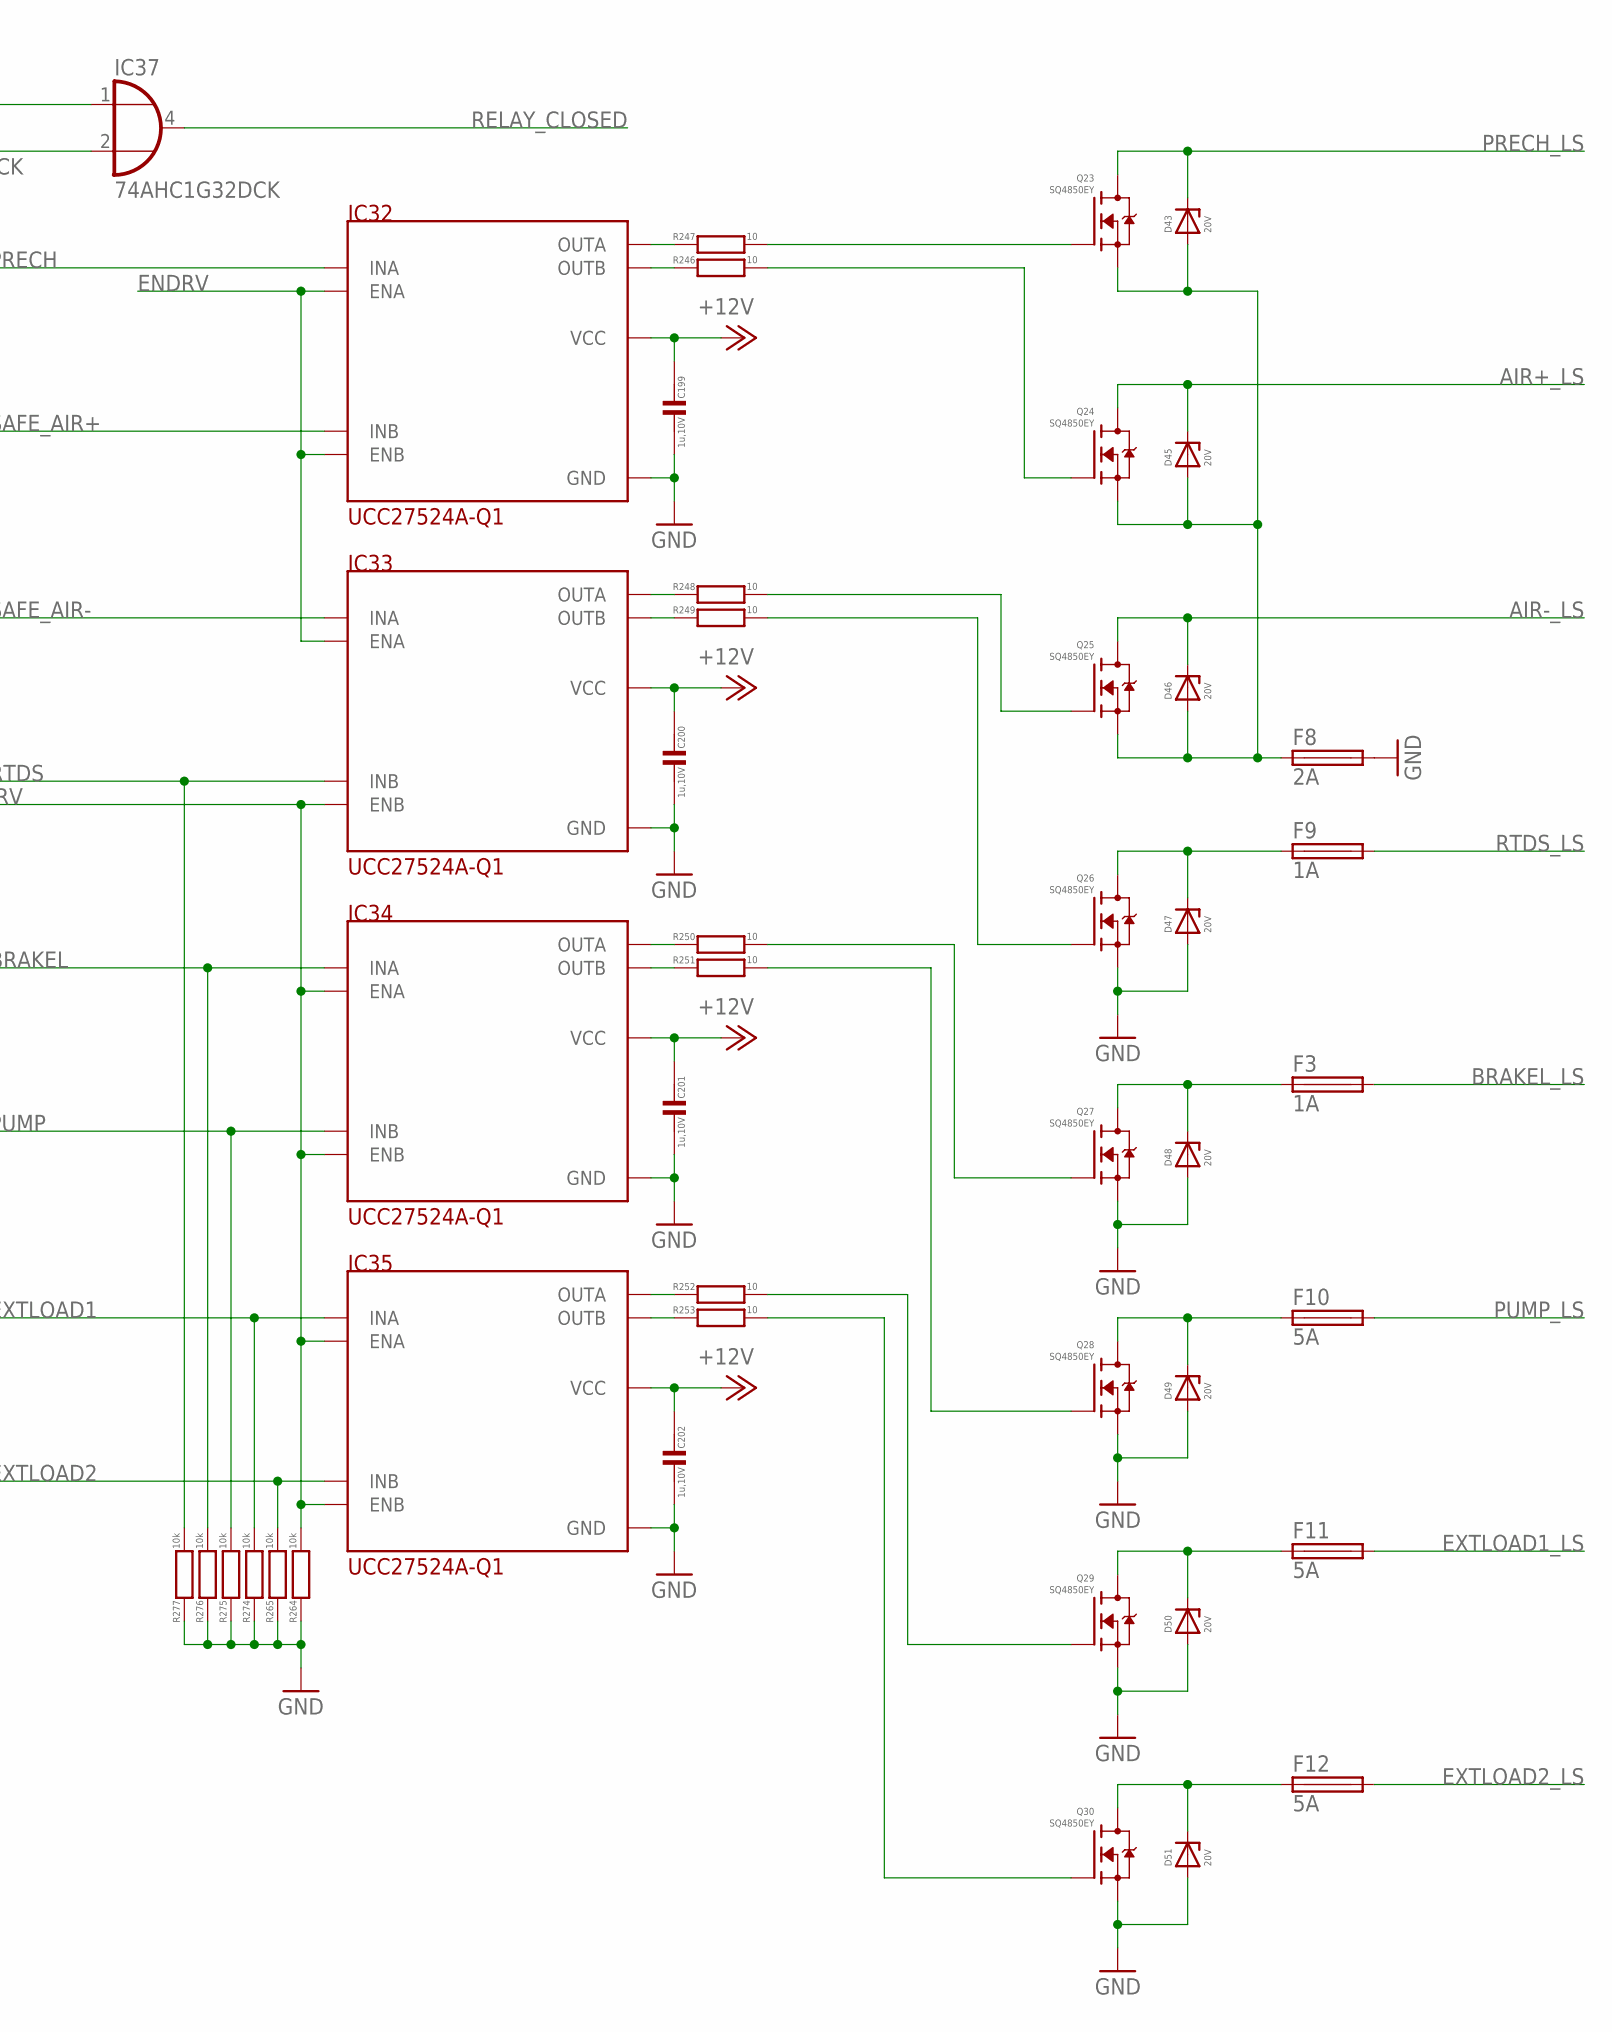
[picture p92: schematic bms_master_V01.sch, sheet 5, part in row 1, column 2]

Parts:
C199, C200, C201, C202, C205, C206, C226, C227, C228, C229: 1u,10V; C0402
C224, C225: C0402
D43, D45, D46, D47, D48, D49, D50, D51: 20V; DO-214AC
D60, D61, D64, D65: DIODE-SOD523; SOD523
F3, F9: 1A; LITTLEFUSE_17867640001
F8: 2A; LITTLEFUSE_17867640001
F10, F11, F12: 5A; LITTLEFUSE_17867640001
IC32, IC33, IC34, IC35: UCC27524A-Q1; SO08
IC36, IC37: 74AHC1G32DCK; SC70-5
IC51, IC52, IC53: 74AHC1G08DCK; SC70-5
IC54: 74AHC1G04DCK; SC70-5
Q23, Q24, Q25, Q26, Q27, Q28, Q29, Q30: SQ4850EY; SO-8
R246, R247, R248, R249, R250, R251, R252, R253: 10; R1206
R264, R265, R274, R275, R276, R277: 10k; R1206
R278, R279, R280, R281: ""; R0402
R282, R283: 22; R0402

Connections:
+3V3: C205.2, C206.2, C226.2, C227.2, C228.2, C229.2, IC36.5 (VCC), IC37.5 (VCC), IC51.5 (VCC), IC52.5 (VCC), IC53.5 (VCC), IC54.5 (VCC); also elsewhere on the board
+12V: C199.2, C200.2, C201.2, C202.2, IC32.6 (VCC), IC33.6 (VCC), IC34.6 (VCC), IC35.6 (VCC); also elsewhere on the board
AIR+_LS: D45.C, Q24.5 (D), Q24.6 (D), Q24.7 (D), Q24.8 (D)
AIR-_LS: D46.C, Q25.5 (D), Q25.6 (D), Q25.7 (D), Q25.8 (D)
BRAKEL_LS: F3.2
CTRL_AIR+: IC51.2 (I1); also elsewhere on the board
CTRL_AIR-: IC53.1 (I0); also elsewhere on the board
CTRL_BRAKEL: IC34.2 (INA), R276.2; also elsewhere on the board
CTRL_EXTLOAD1: IC35.2 (INA), R274.2; also elsewhere on the board
CTRL_EXTLOAD2: IC35.4 (INB), R265.2; also elsewhere on the board
CTRL_PRECH: D60.A, D61.C, IC32.2 (INA), IC37.2 (I1); also elsewhere on the board
CTRL_PUMP: IC34.4 (INB), R275.2; also elsewhere on the board
CTRL_RTDS: IC33.4 (INB), R277.2; also elsewhere on the board
CTRL_SAFE_AIR+: D64.A, D65.C, IC32.4 (INB), IC36.2 (I1), R282.2; also elsewhere on the board
CTRL_SAFE_AIR-: IC33.2 (INA), IC36.1 (I0), R283.2; also elsewhere on the board
ENDRV: IC32.1 (ENA), IC32.8 (ENB), IC33.1 (ENA); also elsewhere on the board
ENLSDRV: IC33.8 (ENB), IC34.1 (ENA), IC34.8 (ENB), IC35.1 (ENA), IC35.8 (ENB), R264.2; also elsewhere on the board
EXTLOAD1_LS: F11.2
EXTLOAD2_LS: F12.2
GND: C199.1, C200.1, C201.1, C202.1, C205.1, C206.1, C224.2, C225.2, C226.1, C227.1, C228.1, C229.1, D47.A, D48.A, D49.A, D50.A, D51.A, F8.2, IC32.3 (GND), IC33.3 (GND), IC34.3 (GND), IC35.3 (GND), IC36.3 (GND), IC37.3 (GND), IC51.3 (GND), IC52.3 (GND), IC53.3 (GND), IC54.3 (GND), Q26.1 (S), Q26.2 (S), Q26.3 (S), Q27.1 (S), Q27.2 (S), Q27.3 (S), Q28.1 (S), Q28.2 (S), Q28.3 (S), Q29.1 (S), Q29.2 (S), Q29.3 (S), Q30.1 (S), Q30.2 (S), Q30.3 (S), R264.1, R265.1, R274.1, R275.1, R276.1, R277.1; also elsewhere on the board
unnamed: IC32.7 (OUTA), R247.1
unnamed: IC32.5 (OUTB), R246.1
unnamed: IC33.7 (OUTA), R248.1
unnamed: IC33.5 (OUTB), R249.1
unnamed: IC34.7 (OUTA), R250.1
unnamed: IC34.5 (OUTB), R251.1
unnamed: IC35.7 (OUTA), R252.1
unnamed: IC35.5 (OUTB), R253.1
unnamed: Q23.4 (G), R247.2
unnamed: Q24.4 (G), R246.2
unnamed: Q25.4 (G), R248.2
unnamed: Q26.4 (G), R249.2
unnamed: Q27.4 (G), R250.2
unnamed: Q28.4 (G), R251.2
unnamed: Q29.4 (G), R252.2
unnamed: Q30.4 (G), R253.2
unnamed: D51.C, F12.1, Q30.5 (D), Q30.6 (D), Q30.7 (D), Q30.8 (D)
unnamed: D50.C, F11.1, Q29.5 (D), Q29.6 (D), Q29.7 (D), Q29.8 (D)
unnamed: D49.C, F10.1, Q28.5 (D), Q28.6 (D), Q28.7 (D), Q28.8 (D)
unnamed: D47.C, F9.1, Q26.5 (D), Q26.6 (D), Q26.7 (D), Q26.8 (D)
unnamed: D48.C, F3.1, Q27.5 (D), Q27.6 (D), Q27.7 (D), Q27.8 (D)
unnamed: IC36.4 (O), IC37.1 (I0)
unnamed: D61.A, R279.2
unnamed: D60.C, R278.2
unnamed: C224.1, IC51.1 (I0), R278.1, R279.1
unnamed: D65.A, R281.2
unnamed: D64.C, R280.2
unnamed: C225.1, IC52.1 (I0), R280.1, R281.1
unnamed: IC52.2 (I1), IC53.4 (O)
unnamed: IC53.2 (I1), IC54.4 (O)
unnamed: IC51.4 (O), R282.1
unnamed: IC52.4 (O), R283.1
PRECH_CURRENT: IC54.2 (I); also elsewhere on the board
PRECH_LS: D43.C, Q23.5 (D), Q23.6 (D), Q23.7 (D), Q23.8 (D)
PUMP_LS: F10.2
RELAY_CLOSED: IC37.4 (O); also elsewhere on the board
RELAY_GND: D43.A, D45.A, D46.A, F8.1, Q23.1 (S), Q23.2 (S), Q23.3 (S), Q24.1 (S), Q24.2 (S), Q24.3 (S), Q25.1 (S), Q25.2 (S), Q25.3 (S)
RTDS_LS: F9.2

Notes on the sheet:
TODO: Zeitkonstante für 200ms auslegen!!!

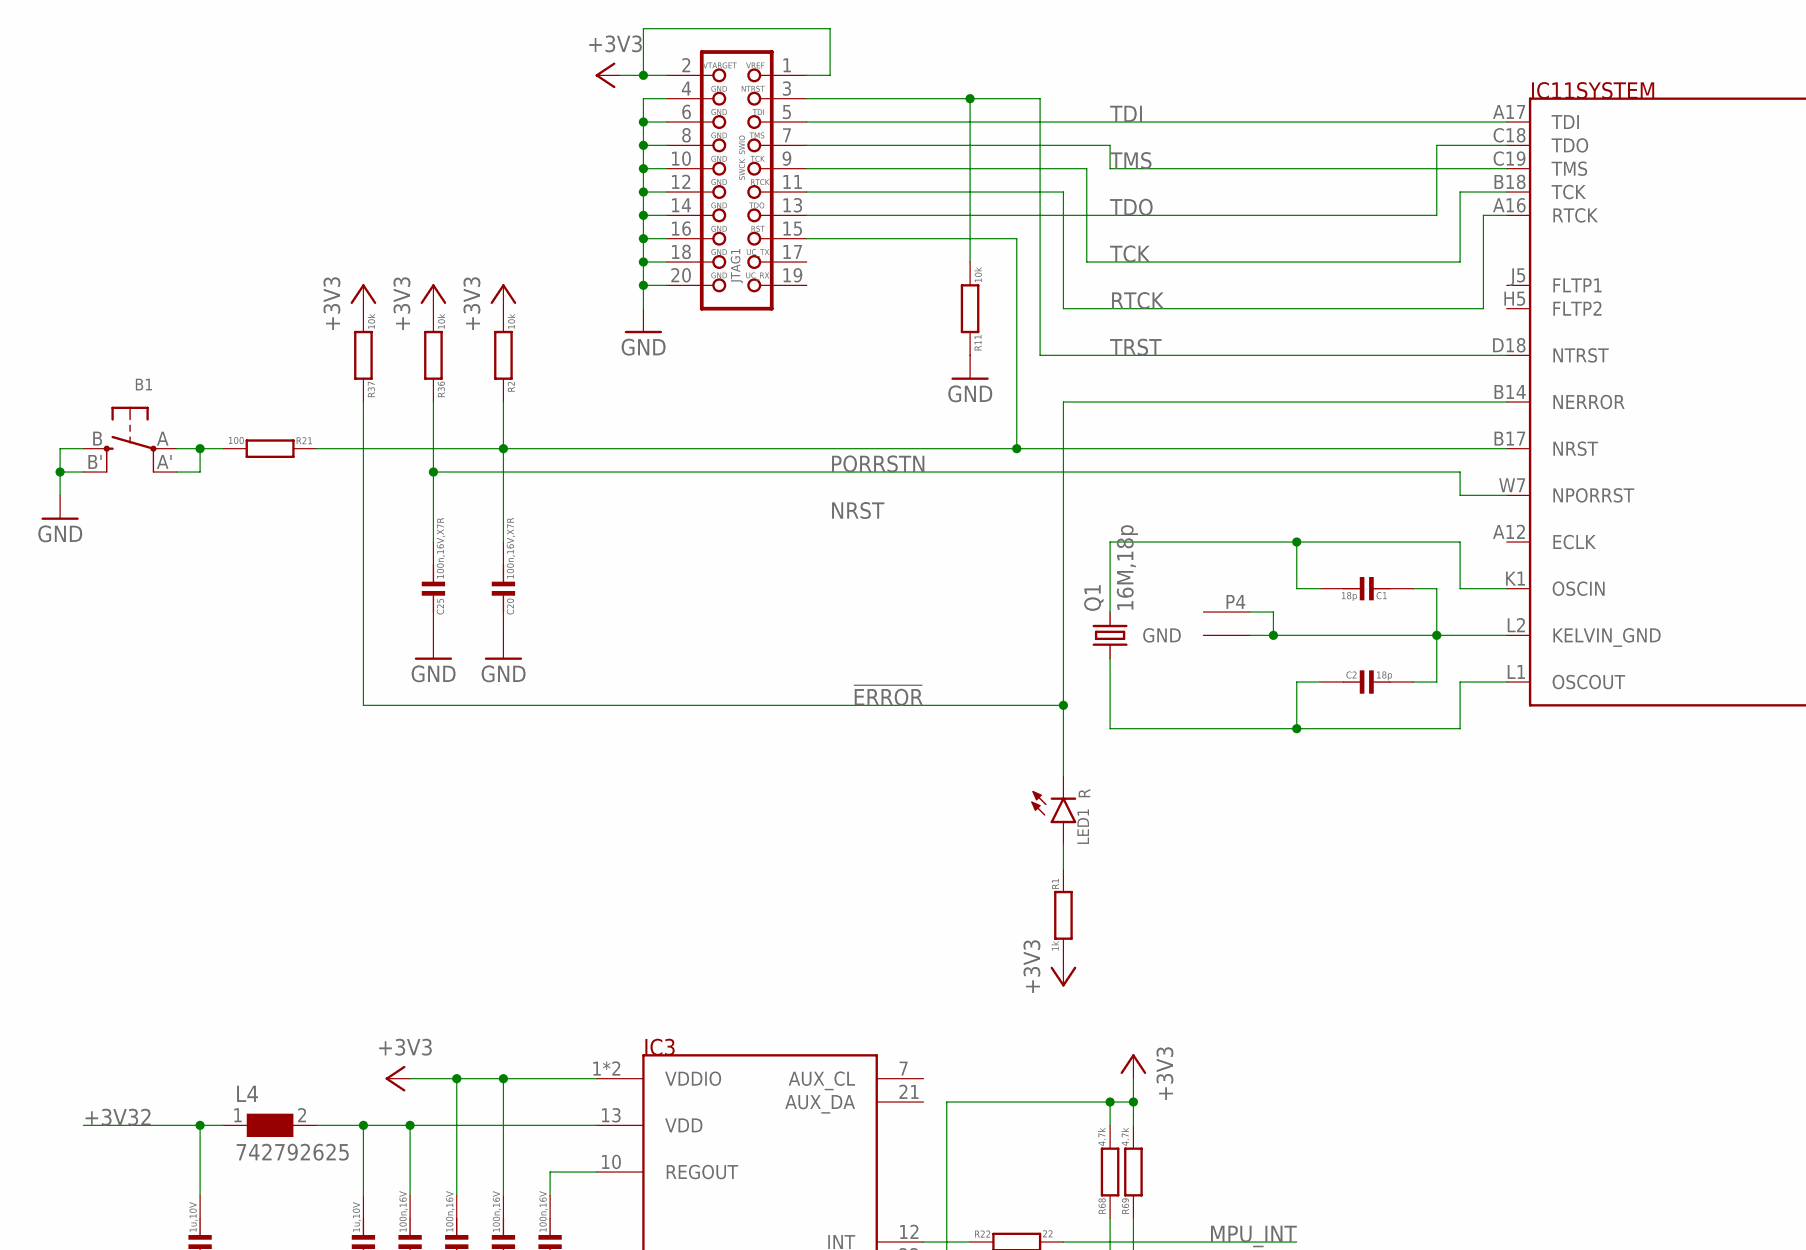
[picture p93: schematic bms_master_V01.sch, sheet 6, part in row 1, column 1]

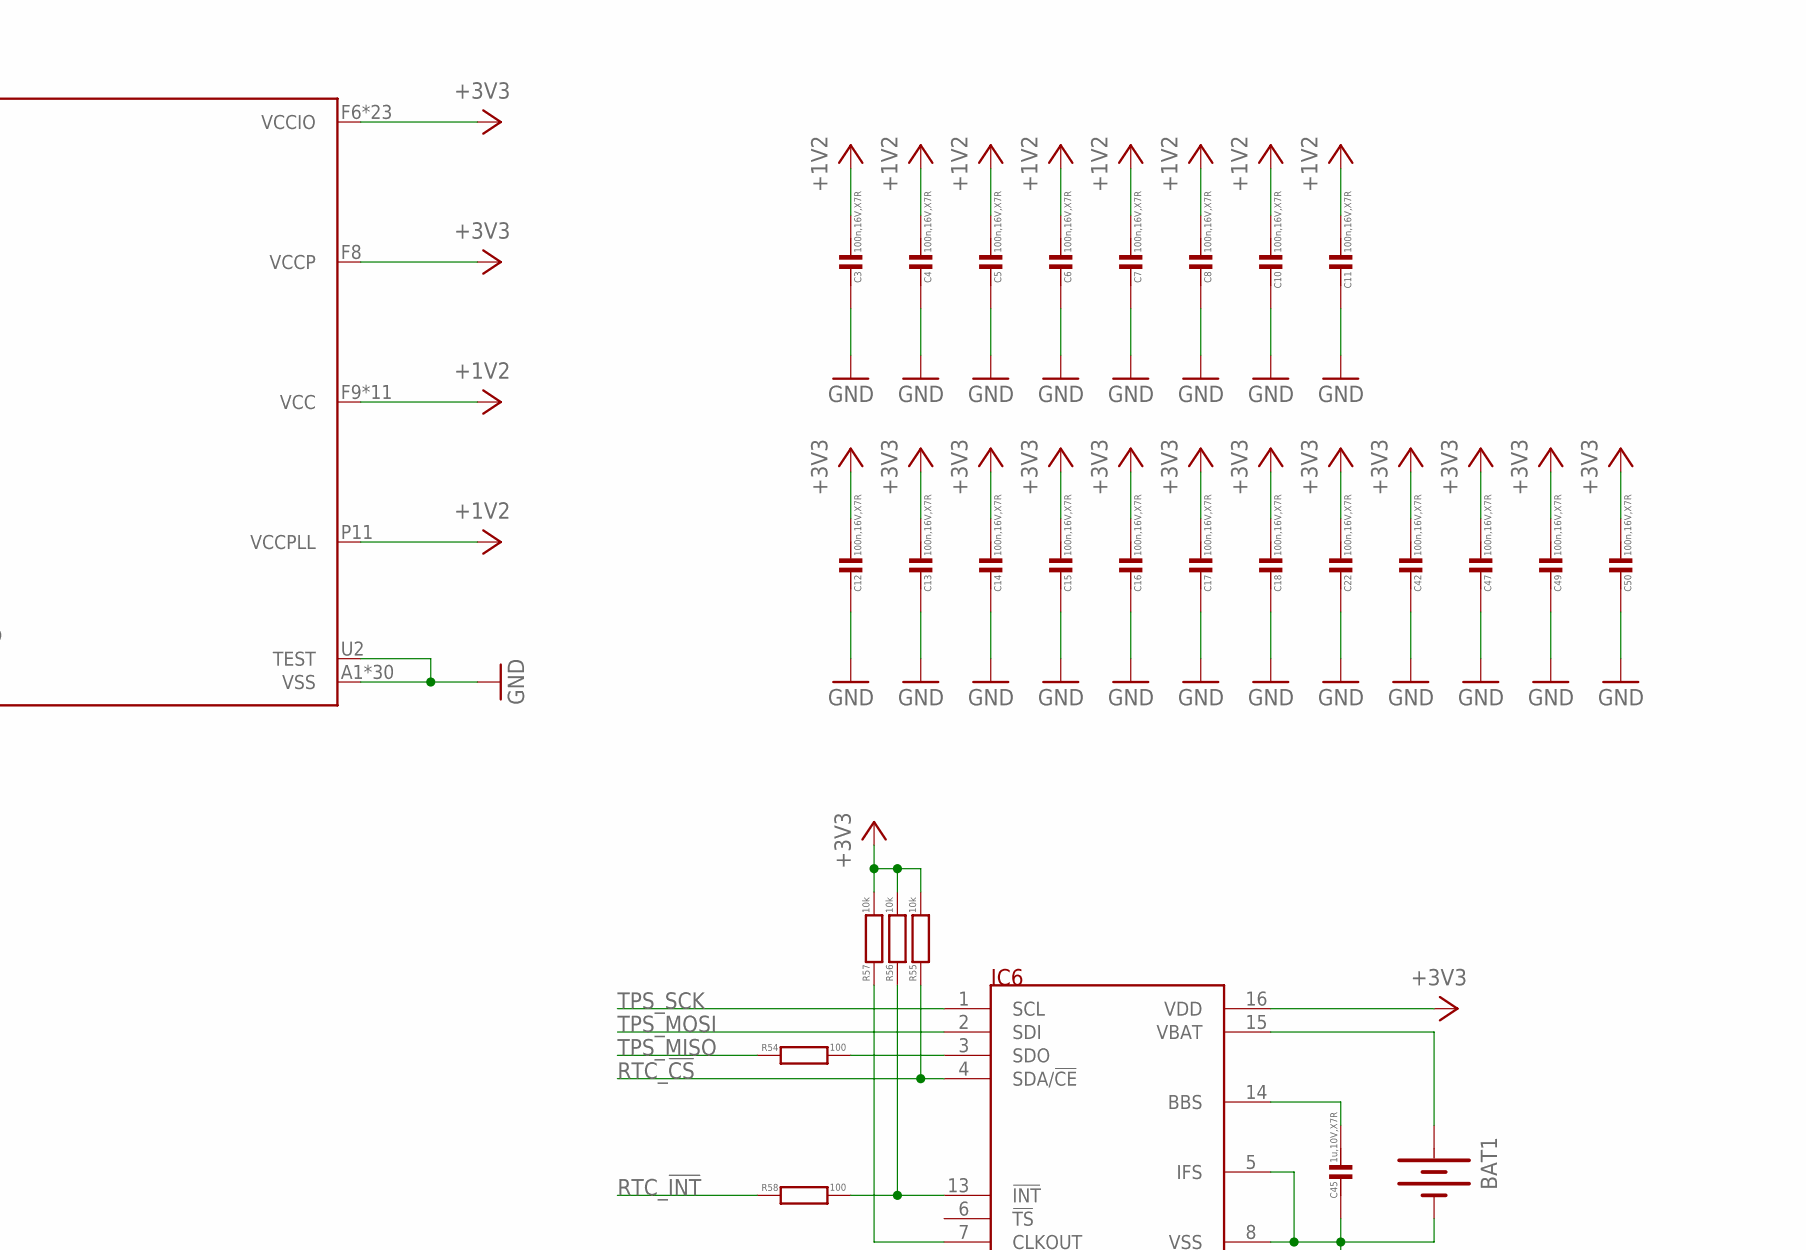
[picture p94: schematic bms_master_V01.sch, sheet 6, part in row 1, column 2]

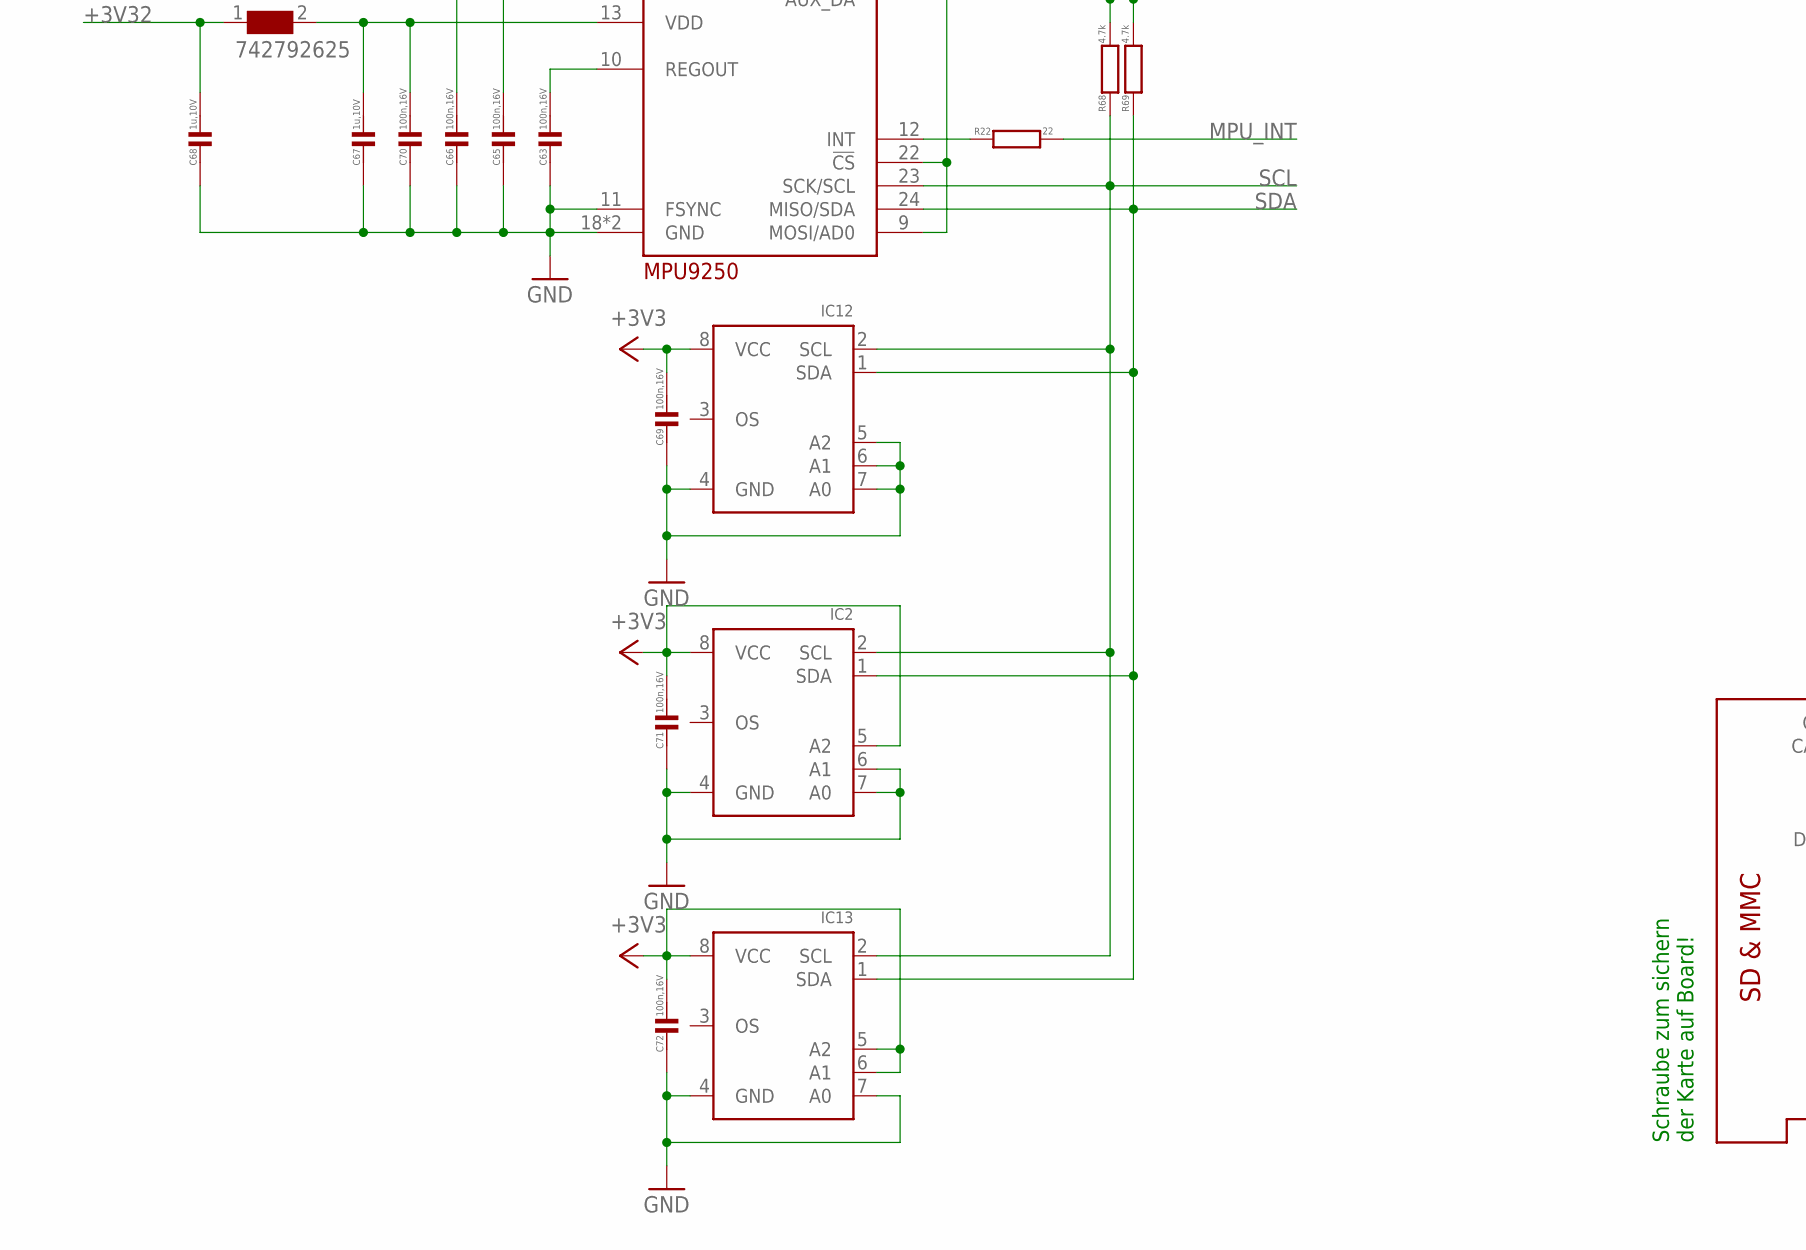
[picture p95: schematic bms_master_V01.sch, sheet 6, part in row 2, column 1]

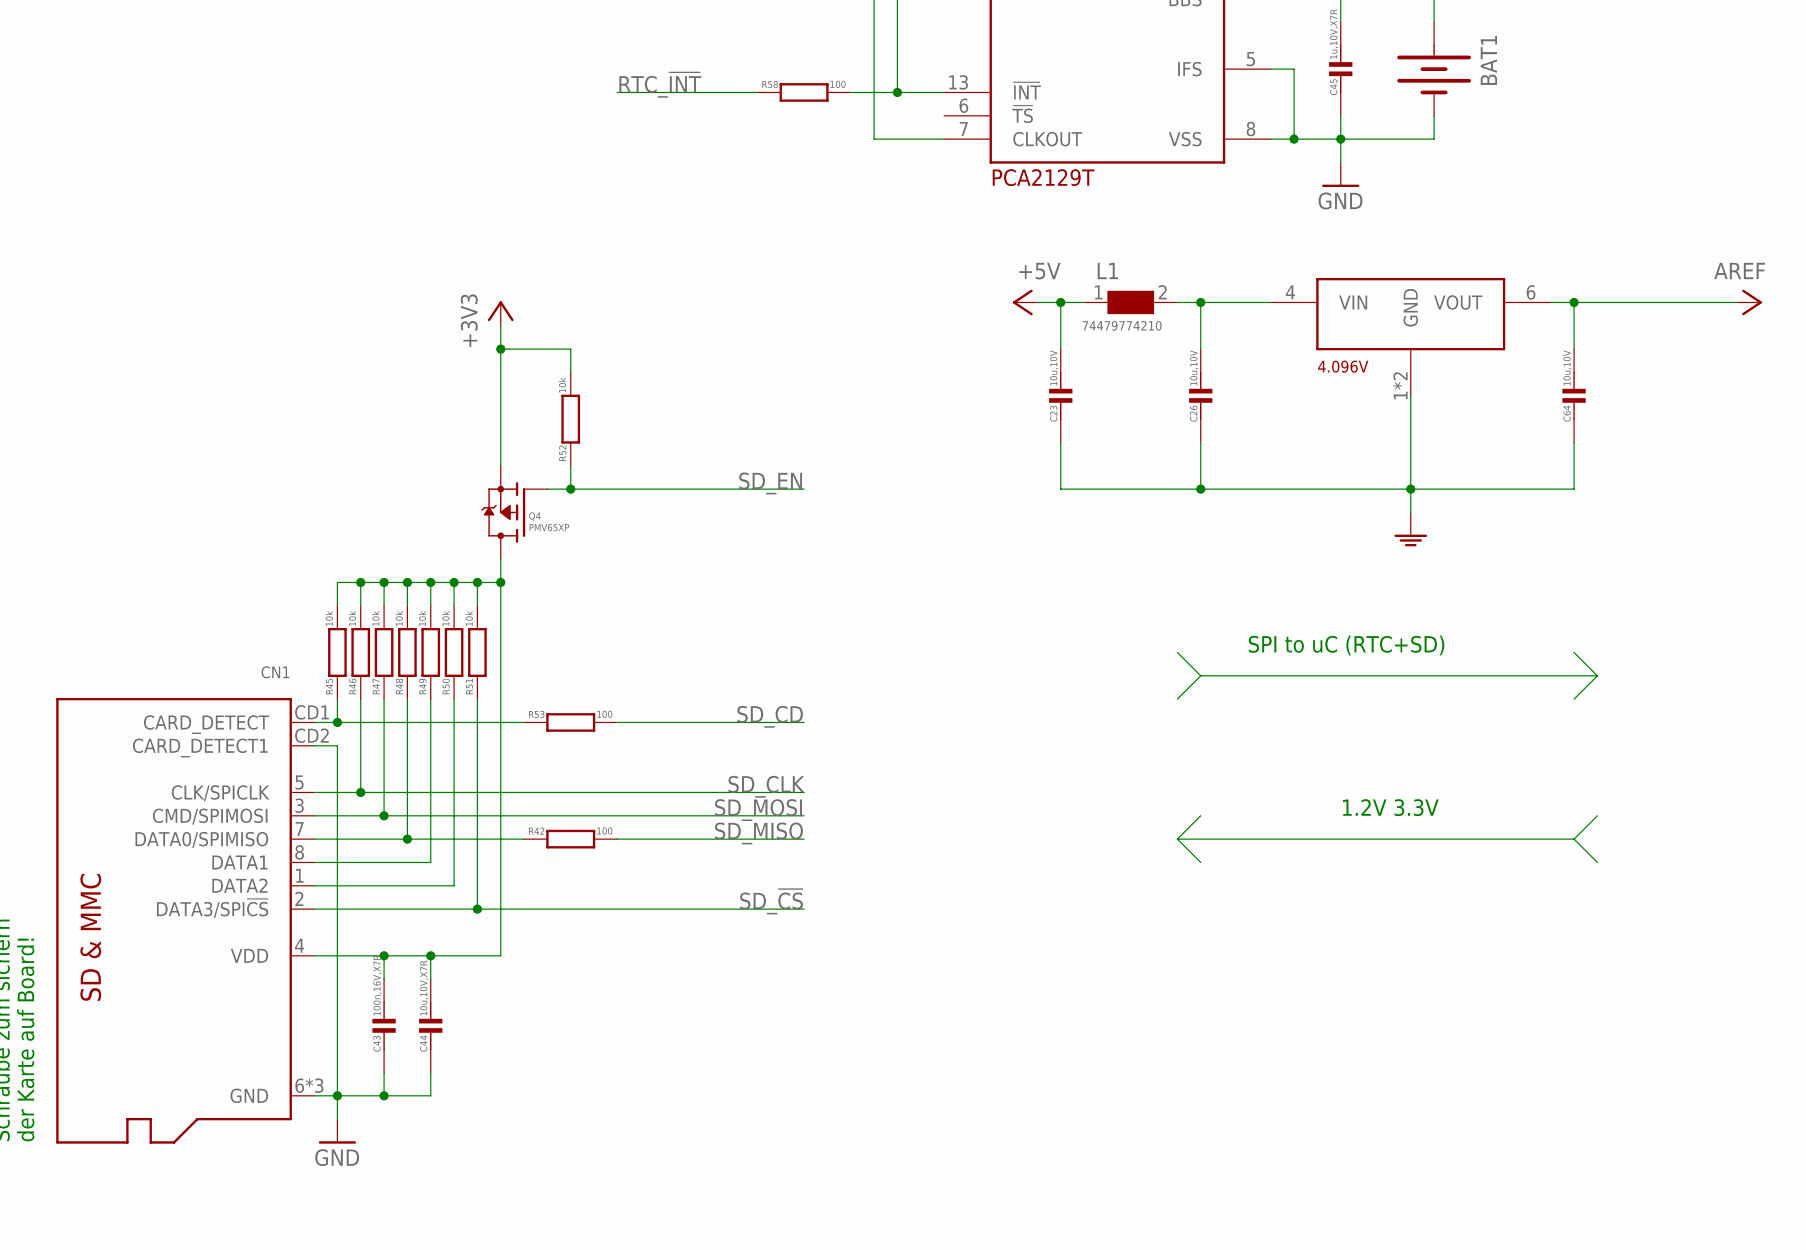
[picture p96: schematic bms_master_V01.sch, sheet 6, part in row 2, column 2]

Parts:
B1: SWITCH_TACT_SMT4.6X2.8; BTN_KMR2_4.6X2.8
BAT1: BATTERY20PTH; BATTCOM_20MM_PTH
C1, C2: 18p; C0402
C3, C4, C5, C6, C7, C8, C10, C11, C12, C13, C14, C15, C16, C17, C18, C20, C22, C25, C42, C43, C47, C49, C50: 100n,16V,X7R; C0402
C23, C26, C64: 10u,10V; C0603
C44: 10u,10V,X7R; C0603
C45: 1u,10V,X7R; C0402
C63, C65, C66, C69, C70, C71, C72: 100n,16V; C0402
C67, C68: 1u,10V; C0402
CN1: MICROSD_3M; MICROSD
IC2, IC12, IC13: TEMP_LM75B; TSSOP8
IC3: MPU9250; QFN-24-NP
IC6: PCA2129T; SO16W
IC11: TMS570LS3137ZWT; S-PBGA-N337
JTAG1: JTAG20-SMT1.27; 2X10_1.27MM_SMT
L1: 74479774210; WE-PMI_0805
L4: 742792625; 0603
LED1: R; CHIPLED_0603
Q1: 16M,18p; MT
Q4: PMV65XP; SOT23
R1: 1k; R0402
R2, R11, R36, R37, R45, R46, R47, R48, R49, R50, R51, R52, R55, R56, R57: 10k; R0402
R21, R42, R53, R54, R58: 100; R0402
R22: 22; R0402
R68, R69: 4.7k; R0402
U$23: 4.096V; SOT23-6

Connections:
5VFILT: C26.1, L1.2, U$23.4 (VIN)
!ERROR: IC11.B14 (NERROR), LED1.C, R37.1; also elsewhere on the board
!INT_OUT: IC6.13 (!INT), R56.1, R58.2
+1V2: C3.1, C4.1, C5.1, C6.1, C7.1, C8.1, C10.1, C11.1, IC11.F9 (VCC), IC11.F10 (VCC), IC11.H10 (VCC), IC11.J14 (VCC), IC11.K6 (VCC), IC11.K8 (VCC), IC11.K12 (VCC), IC11.K14 (VCC), IC11.L6 (VCC), IC11.M10 (VCC), IC11.P10 (VCC), IC11.P11 (VCCPLL); also elsewhere on the board
+3V3: C12.1, C13.1, C14.1, C15.1, C16.1, C17.1, C18.1, C22.1, C42.1, C47.1, C49.1, C50.1, C65.1, C66.1, C69.1, C71.1, C72.1, IC2.5 (A2), IC2.8 (VCC), IC3.1 (VDDIO), IC3.8 (VDDIO), IC3.9 (MOSI/AD0), IC3.22 (!CS), IC6.16 (VDD), IC11.F6 (VCCIO), IC11.F7 (VCCIO), IC11.F8 (VCCP), IC11.F11 (VCCIO), IC11.F12 (VCCIO), IC11.F13 (VCCIO), IC11.F14 (VCCIO), IC11.G6 (VCCIO), IC11.G14 (VCCIO), IC11.H6 (VCCIO), IC11.H14 (VCCIO), IC11.J6 (VCCIO), IC11.L14 (VCCIO), IC11.M6 (VCCIO), IC11.M14 (VCCIO), IC11.N6 (VCCIO), IC11.N14 (VCCIO), IC11.P6 (VCCIO), IC11.P7 (VCCIO), IC11.P8 (VCCIO), IC11.P9 (VCCIO), IC11.P12 (VCCIO), IC11.P13 (VCCIO), IC11.P14 (VCCIO), IC12.8 (VCC), IC13.5 (A2), IC13.6 (A1), IC13.8 (VCC), JTAG1.1, JTAG1.2, Q4.2 (S), R1.2, R2.2, R36.2, R37.2, R52.2, R55.2, R56.2, R57.2, R68.2, R69.2; also elsewhere on the board
+3V32: C68.1, L4.1; also elsewhere on the board
+5V: C23.1, L1.1; also elsewhere on the board
AGND: C23.2, C26.2, C64.2, U$23.1 (GND), U$23.2 (GND); also elsewhere on the board
AREF: C64.1, U$23.6 (VOUT); also elsewhere on the board
BBS: C45.1, IC6.14 (BBS)
CLKOUTOUT: IC6.7 (CLKOUT), R57.1
GND: B1.B (S), B1.B' (S1), BAT1.2 (-), C3.2, C4.2, C5.2, C6.2, C7.2, C8.2, C10.2, C11.2, C12.2, C13.2, C14.2, C15.2, C16.2, C17.2, C18.2, C20.2, C22.2, C25.2, C42.2, C43.2, C44.2, C45.2, C47.2, C49.2, C50.2, C63.2, C65.2, C66.2, C67.2, C68.2, C69.2, C70.2, C71.2, C72.2, CN1.6 (GND), CN1.CD2 (CARD_DETECT1), CN1.MT1 (GND), CN1.MT2 (GND), IC2.4 (GND), IC2.6 (A1), IC2.7 (A0), IC3.11 (FSYNC), IC3.18 (GND), IC3.20 (GND), IC6.5 (IFS), IC6.8 (VSS), IC11.A1 (VSS), IC11.A2 (VSS), IC11.A18 (VSS), IC11.A19 (VSS), IC11.B1 (VSS), IC11.B19 (VSS), IC11.H8 (VSS), IC11.H9 (VSS), IC11.H11 (VSS), IC11.H12 (VSS), IC11.J8 (VSS), IC11.J9 (VSS), IC11.J10 (VSS), IC11.J11 (VSS), IC11.J12 (VSS), IC11.K9 (VSS), IC11.K10 (VSS), IC11.K11 (VSS), IC11.L8 (VSS), IC11.L9 (VSS), IC11.L10 (VSS), IC11.L11 (VSS), IC11.L12 (VSS), IC11.M8 (VSS), IC11.M9 (VSS), IC11.M11 (VSS), IC11.M12 (VSS), IC11.U2 (TEST), IC11.V1 (VSS), IC11.W1 (VSS), IC11.W2 (VSS), IC12.4 (GND), IC12.5 (A2), IC12.6 (A1), IC12.7 (A0), IC13.4 (GND), IC13.7 (A0), JTAG1.4, JTAG1.6, JTAG1.8, JTAG1.10, JTAG1.12, JTAG1.14, JTAG1.16, JTAG1.18, JTAG1.20, R11.1; also elsewhere on the board
KGND: C1.2, C2.1, IC11.L2 (KELVIN_GND), Q1.P2 (GND), Q1.P4 (GND1)
LED1A: LED1.A, R1.1
MPUVCC: C67.1, C70.1, IC3.13 (VDD), L4.2
MPU_INT: R22.2
unnamed: IC3.12 (INT), R22.1
NRST: C20.1, IC11.B17 (NRST), JTAG1.15, R2.1, R21.1
NRSTBTN: B1.A, B1.A' (P1), R21.2
OSCIN: C1.1, IC11.K1 (OSCIN), Q1.P3 (2)
OSCOUT: C2.2, IC11.L1 (OSCOUT), Q1.P1 (1)
PORRSTN: C25.1, IC11.W7 (NPORRST), R36.1; also elsewhere on the board
REGOUT: C63.1, IC3.10 (REGOUT)
RTCK: IC11.A16 (RTCK), JTAG1.11
RTC_!CS: IC6.4 (SDA/!CE), R55.1; also elsewhere on the board
RTC_!INT: R58.1; also elsewhere on the board
RTC_SDO: IC6.3 (SDO), R54.2
SCL: IC2.2 (SCL), IC3.23 (SCK/SCL), IC12.2 (SCL), IC13.2 (SCL), R68.1; also elsewhere on the board
SD1_D2: CN1.1 (DATA2), R50.1
SDA: IC2.1 (SDA), IC3.24 (MISO/SDA), IC12.1 (SDA), IC13.1 (SDA), R69.1; also elsewhere on the board
SD_!CS: CN1.2 (DATA3/SPI!CS), R51.1; also elsewhere on the board
SD_+3V3: C43.1, C44.1, CN1.4 (VDD), Q4.3 (D), R45.2, R46.2, R47.2, R48.2, R49.2, R50.2, R51.2
SD_CD: R53.2; also elsewhere on the board
SD_CDOUT: CN1.CD1 (CARD_DETECT), R45.1, R53.1
SD_CLK: CN1.5 (CLK/SPICLK), R46.1; also elsewhere on the board
SD_D1: CN1.8 (DATA1), R49.1
SD_EN: Q4.1 (G), R52.1; also elsewhere on the board
SD_MISO: R42.2; also elsewhere on the board
SD_MOSI: CN1.3 (CMD/SPIMOSI), R47.1; also elsewhere on the board
SD_SDO_OUT: CN1.7 (DATA0/SPIMISO), R42.1, R48.1
TCK: IC11.B18 (TCK), JTAG1.9
TDI: IC11.A17 (TDI), JTAG1.5
TDO: IC11.C18 (TDO), JTAG1.13
TMS: IC11.C19 (TMS), JTAG1.7
TPS_MISO: R54.1; also elsewhere on the board
TPS_MOSI: IC6.2 (SDI); also elsewhere on the board
TPS_SCK: IC6.1 (SCL); also elsewhere on the board
TRST: IC11.D18 (NTRST), JTAG1.3, R11.2
VBAT: BAT1.1 (+), IC6.15 (VBAT)

Notes on the sheet:
Schraube zum sichern der Karte auf Board!
SPI to uC (RTC+SD)
1.2V 3.3V
