funkobongrip/sprbms/hardware/nextgen_master/bms_master_V01.brd

## EAGLE design hardware/nextgen_master/bms_master_V01.brd (continued)

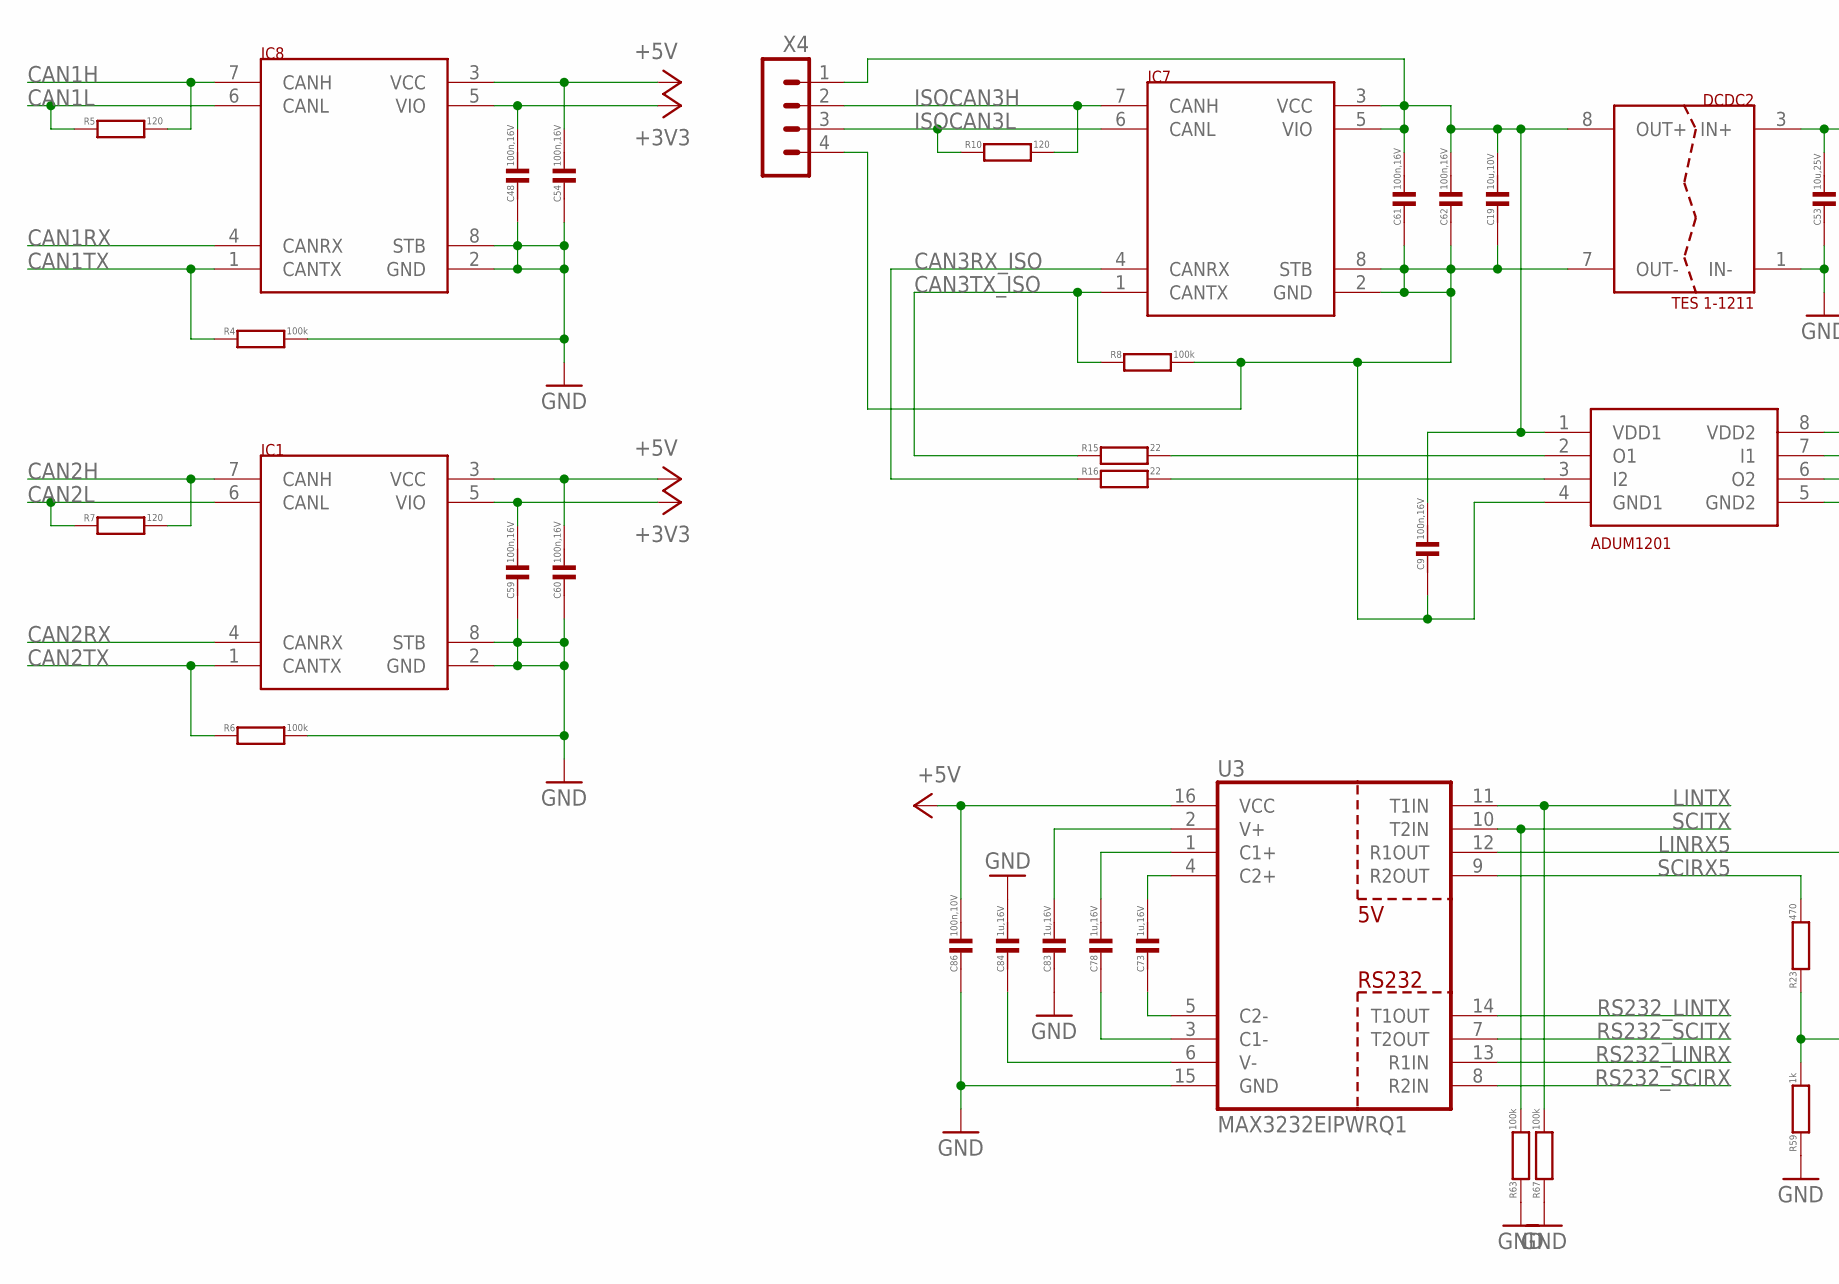
[picture p97: schematic bms_master_V01.sch, sheet 7, part in row 1, column 1]

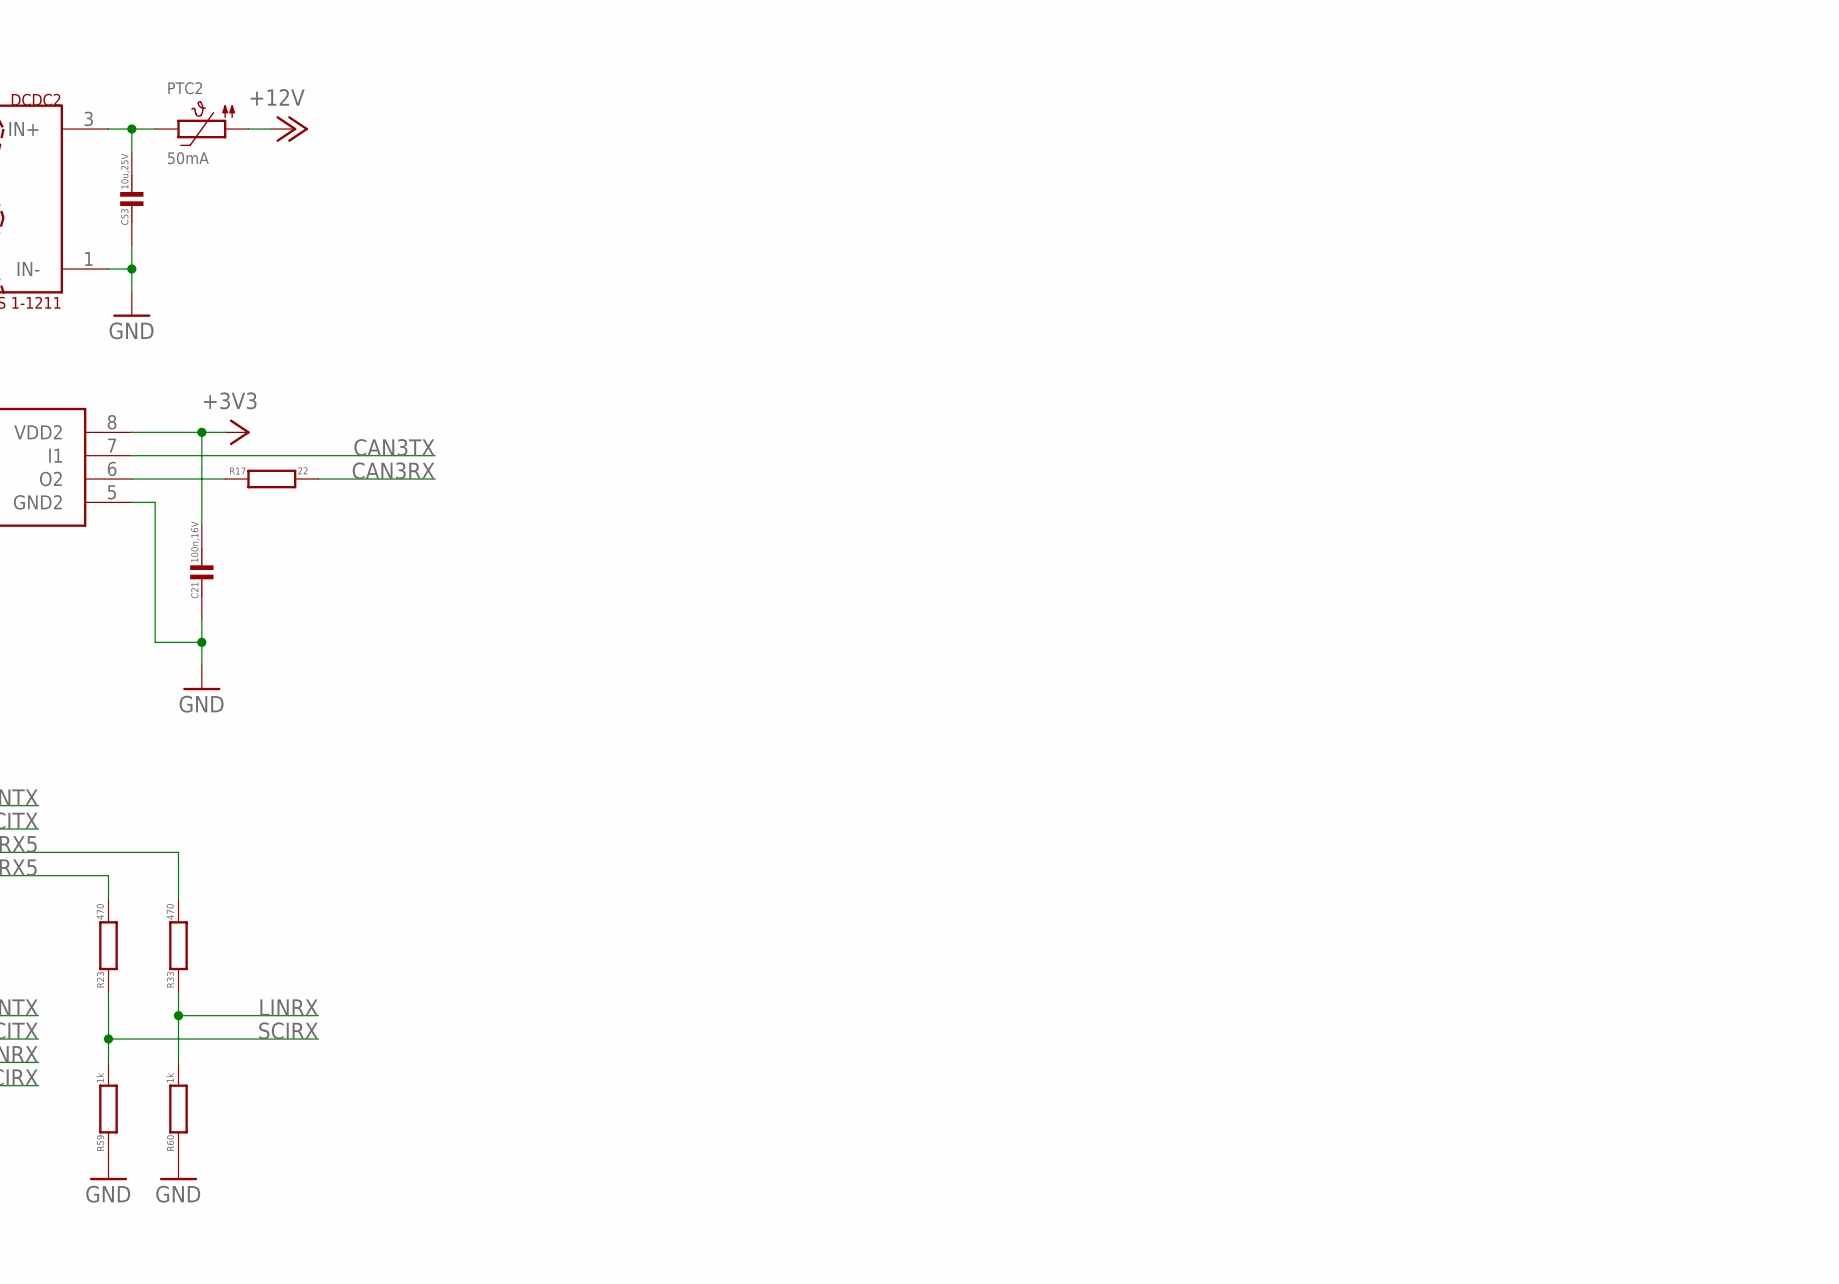
[picture p98: schematic bms_master_V01.sch, sheet 7, part in row 1, column 2]

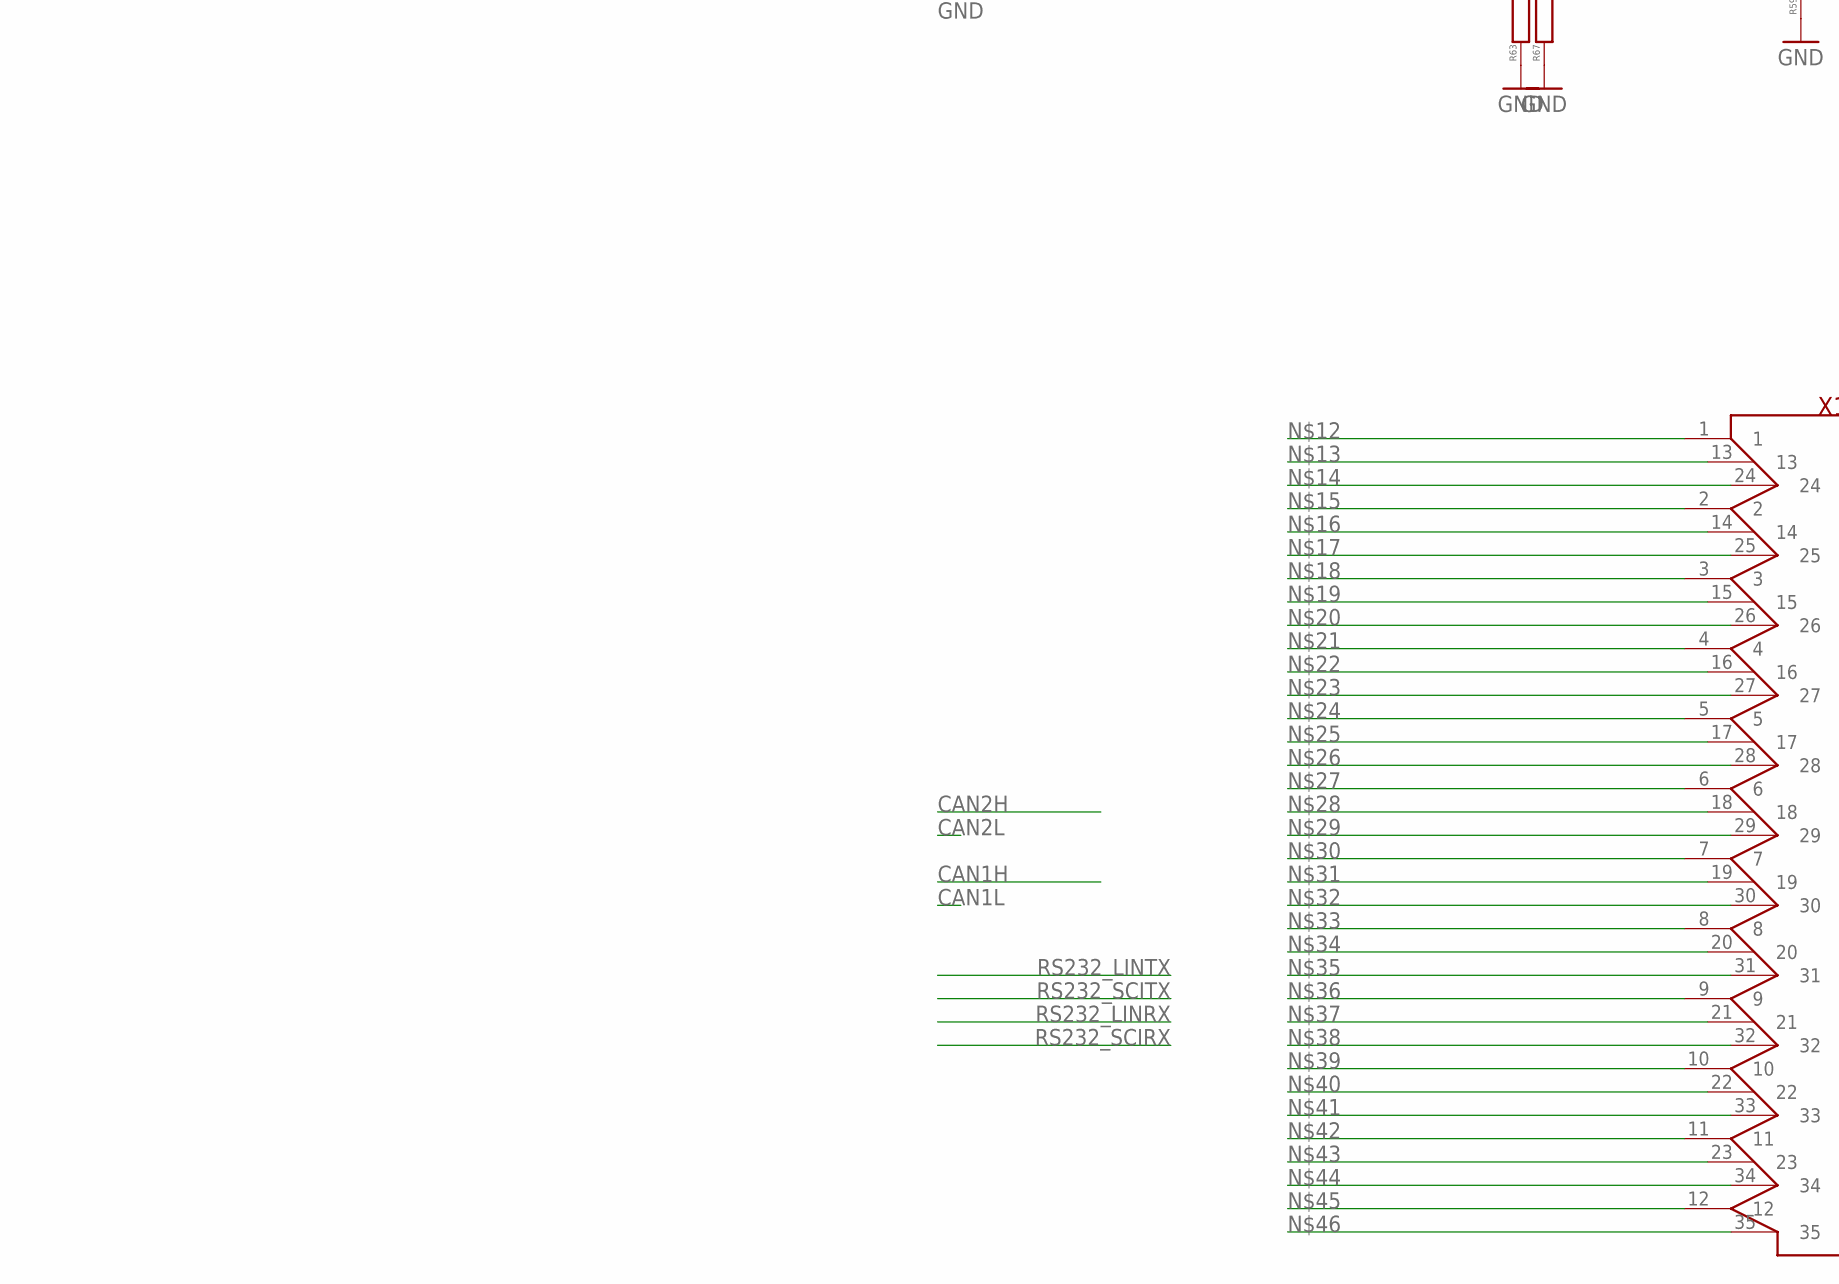
[picture p99: schematic bms_master_V01.sch, sheet 7, part in row 2, column 1]

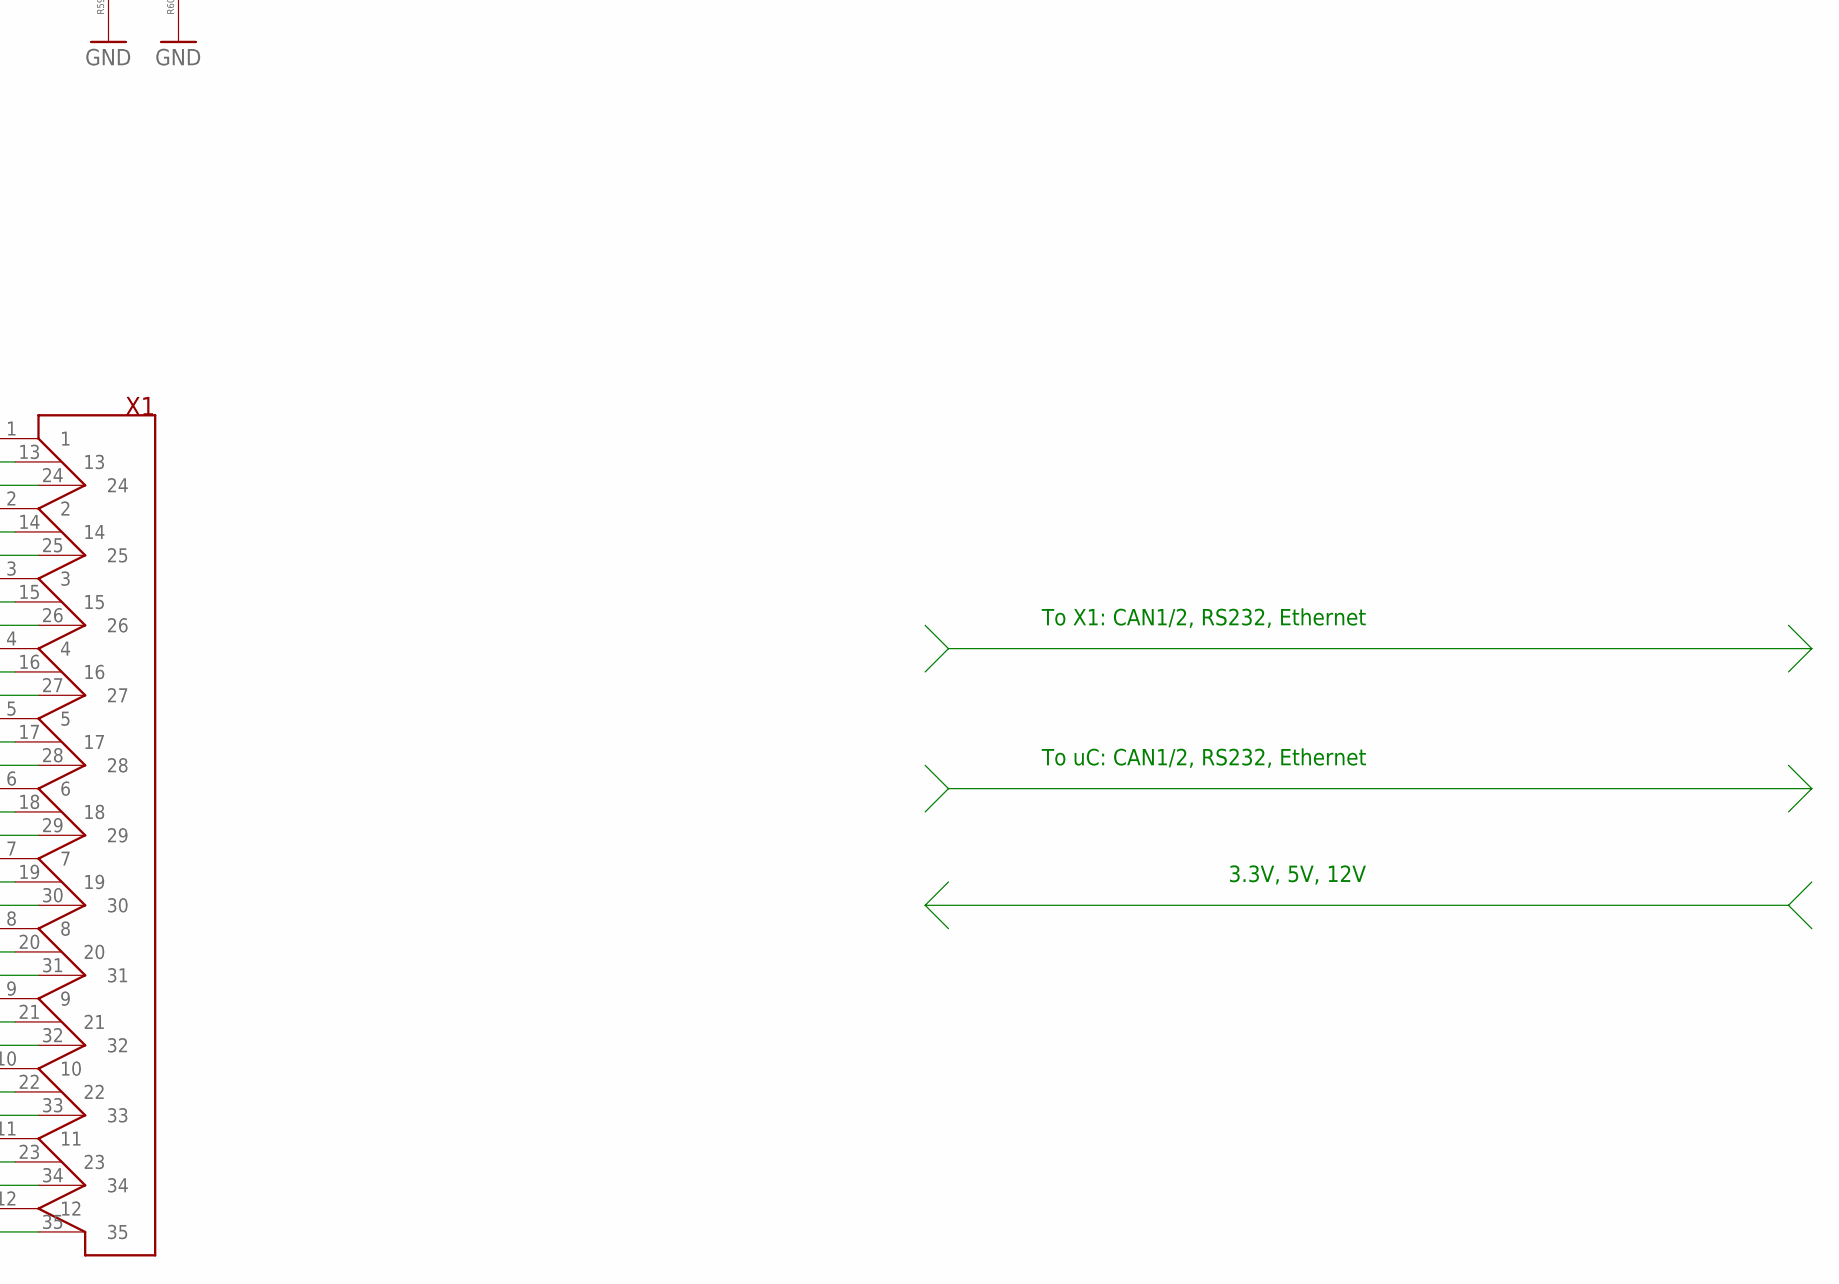
[picture p100: schematic bms_master_V01.sch, sheet 7, part in row 2, column 2]

Parts:
C9, C21, C48, C54, C59, C60, C61, C62: 100n,16V; C0402
C19: 10u,10V; C0603
C53: 10u,25V; C1210
C73, C78, C83, C84: 1u,16V; C0603
C86: 100n,10V; C0402
DCDC2: TES 1-1211; DCDC_SMD_TES1
IC1, IC7, IC8: SN65HVDA540; SO-8
PTC2: 50mA; PTC1210
R4, R6, R8, R63, R67: 100k; R0402
R5, R7, R10: 120; R1206
R15, R16, R17: 22; R1206
R23, R33: 470; R0402
R59, R60: 1k; R0402
U3: MAX3232EIPWRQ1; TSSOP16
U$19: ADUM1201; SO-8
X1: AMPSEAL_35; AMPSEAL_776231-1
X4: HEADER_POS4_43650-0412; 43650-0412

Connections:
+3V3: C21.1, C48.1, C59.1, IC1.5 (VIO), IC8.5 (VIO), U$19.8 (VDD2); also elsewhere on the board
+5V: C54.1, C60.1, C86.1, IC1.3 (VCC), IC8.3 (VCC), U3.16 (VCC); also elsewhere on the board
+12V: PTC2.P$1 (1); also elsewhere on the board
CAN1H: IC8.7 (CANH), R5.2
CAN1L: IC8.6 (CANL), R5.1
CAN1RX: IC8.4 (CANRX); also elsewhere on the board
CAN1TX: IC8.1 (CANTX), R4.1; also elsewhere on the board
CAN2H: IC1.7 (CANH), R7.2
CAN2L: IC1.6 (CANL), R7.1
CAN2RX: IC1.4 (CANRX)
CAN2TX: IC1.1 (CANTX), R6.1; also elsewhere on the board
CAN3RX: R17.2; also elsewhere on the board
CAN3RXR: R17.1, U$19.6 (O2)
CAN3RX_ISO: IC7.4 (CANRX), R16.1
CAN3TX: U$19.7 (I1); also elsewhere on the board
CAN3TX_ISO: IC7.1 (CANTX), R8.1, R15.1
CLV_12V_TES1_FUSED1: C53.1, DCDC2.3 (IN+), PTC2.P$2 (2)
GND: C21.2, C48.2, C53.2, C54.2, C59.2, C60.2, C83.2, C84.1, C86.2, DCDC2.1 (IN-), IC1.2 (GND), IC1.8 (STB), IC8.2 (GND), IC8.8 (STB), R4.2, R6.2, R59.1, R60.1, R63.1, R67.1, U3.15 (GND), U$19.5 (GND2); also elsewhere on the board
ISOCAN3H: IC7.7 (CANH), R10.2, X4.2
ISOCAN3L: IC7.6 (CANL), R10.1, X4.3
ISOCAN_5V: C9.1, C19.1, C61.1, C62.1, DCDC2.8 (OUT+), IC7.3 (VCC), IC7.5 (VIO), U$19.1 (VDD1), X4.1
ISOCAN_GND: C9.2, C19.2, C61.2, C62.2, DCDC2.7 (OUT-), IC7.2 (GND), IC7.8 (STB), R8.2, U$19.4 (GND1), X4.4
LINRX: R33.1, R60.2; also elsewhere on the board
LINRX5: R33.2, U3.12 (R1OUT)
LINTX: R67.2, U3.11 (T1IN); also elsewhere on the board
unnamed: R16.2, U$19.3 (I2)
unnamed: C73.1, U3.4 (C2+)
unnamed: C78.1, U3.1 (C1+)
unnamed: C83.1, U3.2 (V+)
unnamed: C73.2, U3.5 (C2-)
unnamed: R15.2, U$19.2 (O1)
unnamed: C78.2, U3.3 (C1-)
unnamed: C84.2, U3.6 (V-)
RS232_LINRX: U3.13 (R1IN)
RS232_LINTX: U3.14 (T1OUT)
RS232_SCIRX: U3.8 (R2IN)
RS232_SCITX: U3.7 (T2OUT)
SCIRX: R23.1, R59.2; also elsewhere on the board
SCIRX5: R23.2, U3.9 (R2OUT)
SCITX: R63.2, U3.10 (T2IN); also elsewhere on the board

Notes on the sheet:
To X1: CAN1/2, RS232, Ethernet
3.3V, 5V, 12V
To uC: CAN1/2, RS232, Ethernet
