funkobongrip/sprbms/hardware/nextgen_master/bms_master_V01.brd

## EAGLE design hardware/nextgen_master/bms_master_V01.brd (continued)

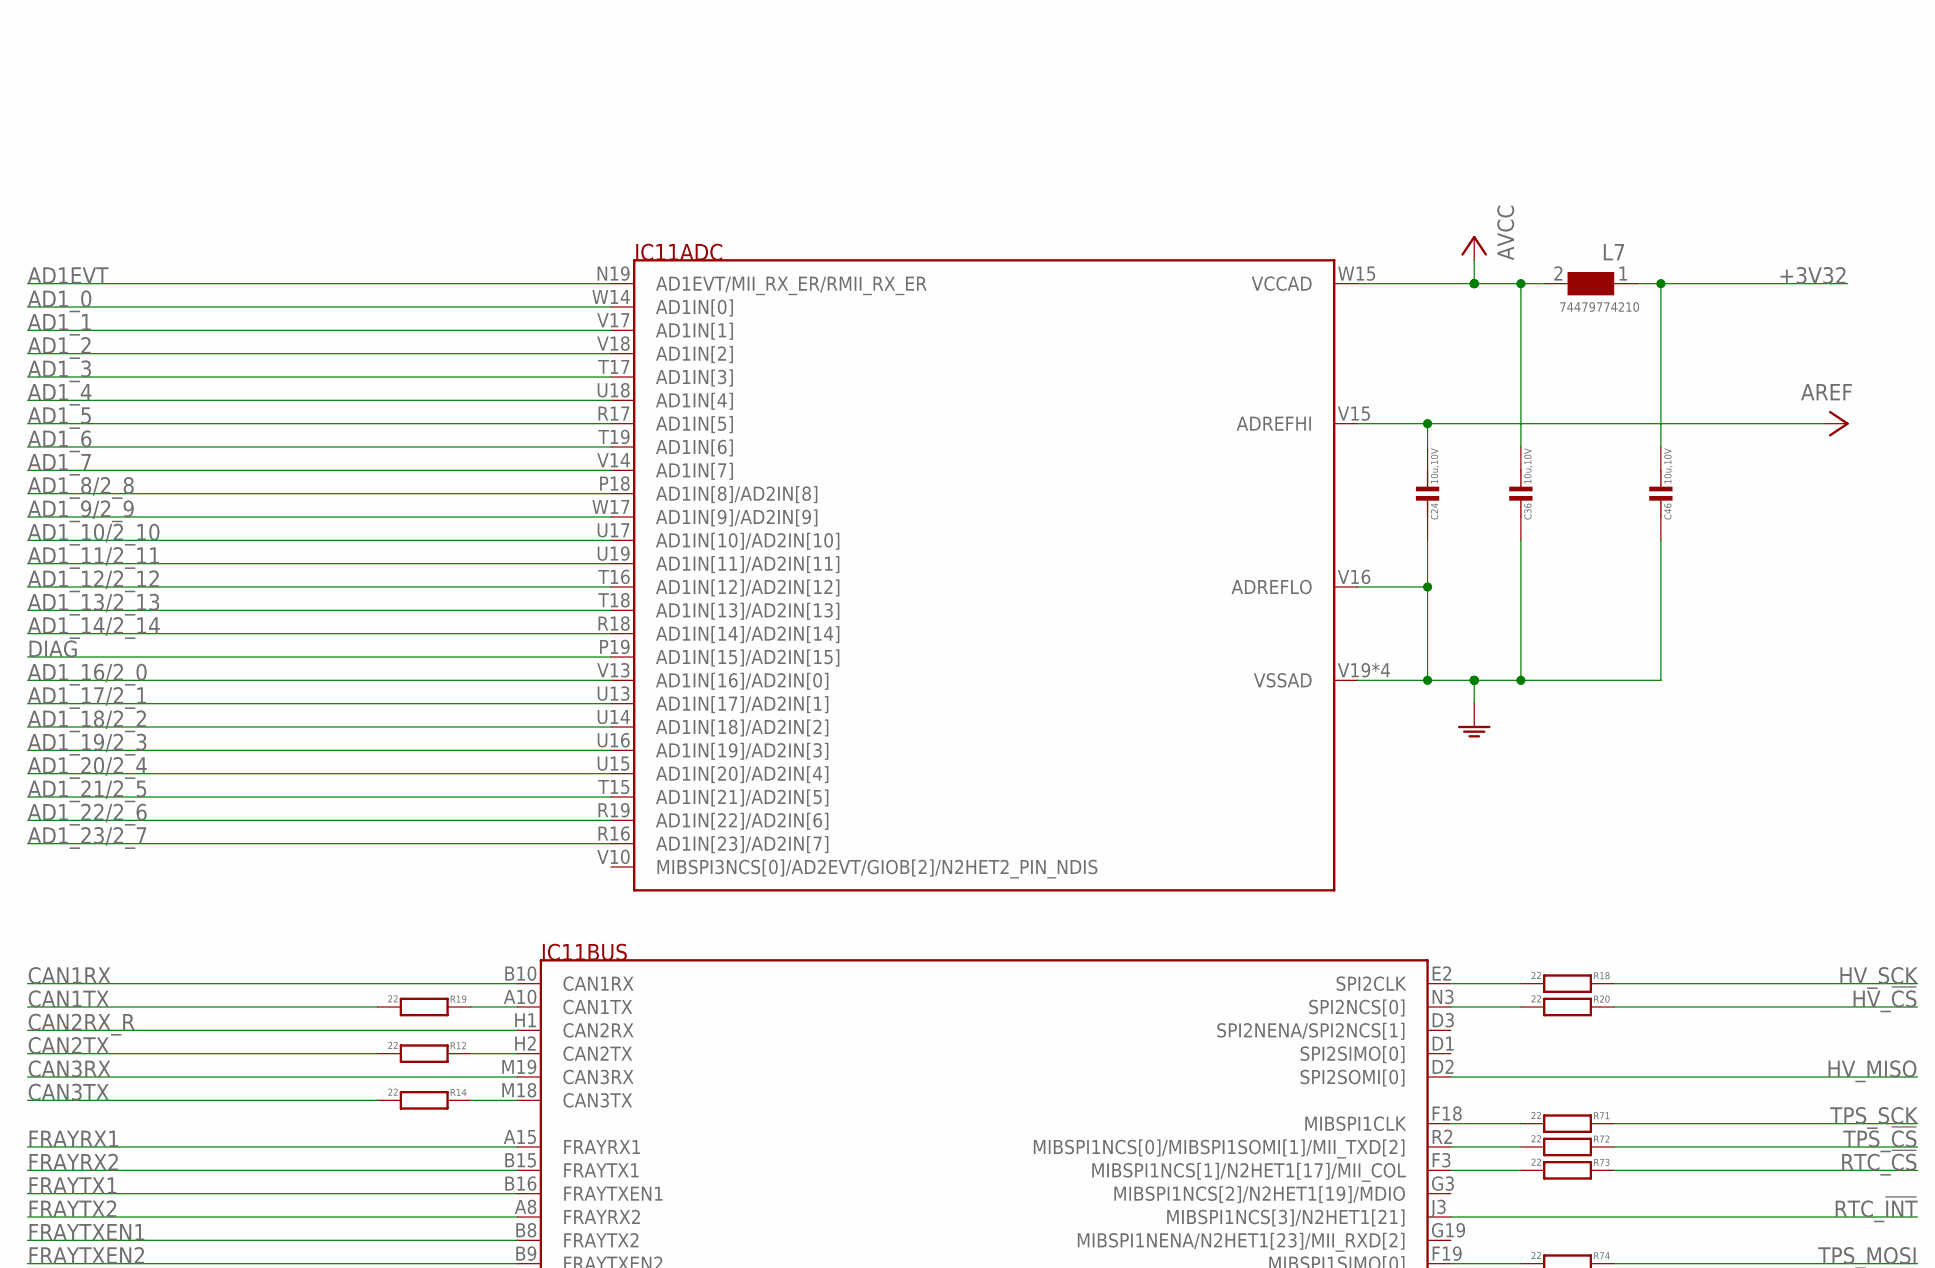
[picture p101: schematic bms_master_V01.sch, sheet 8, part in row 1, column 1]

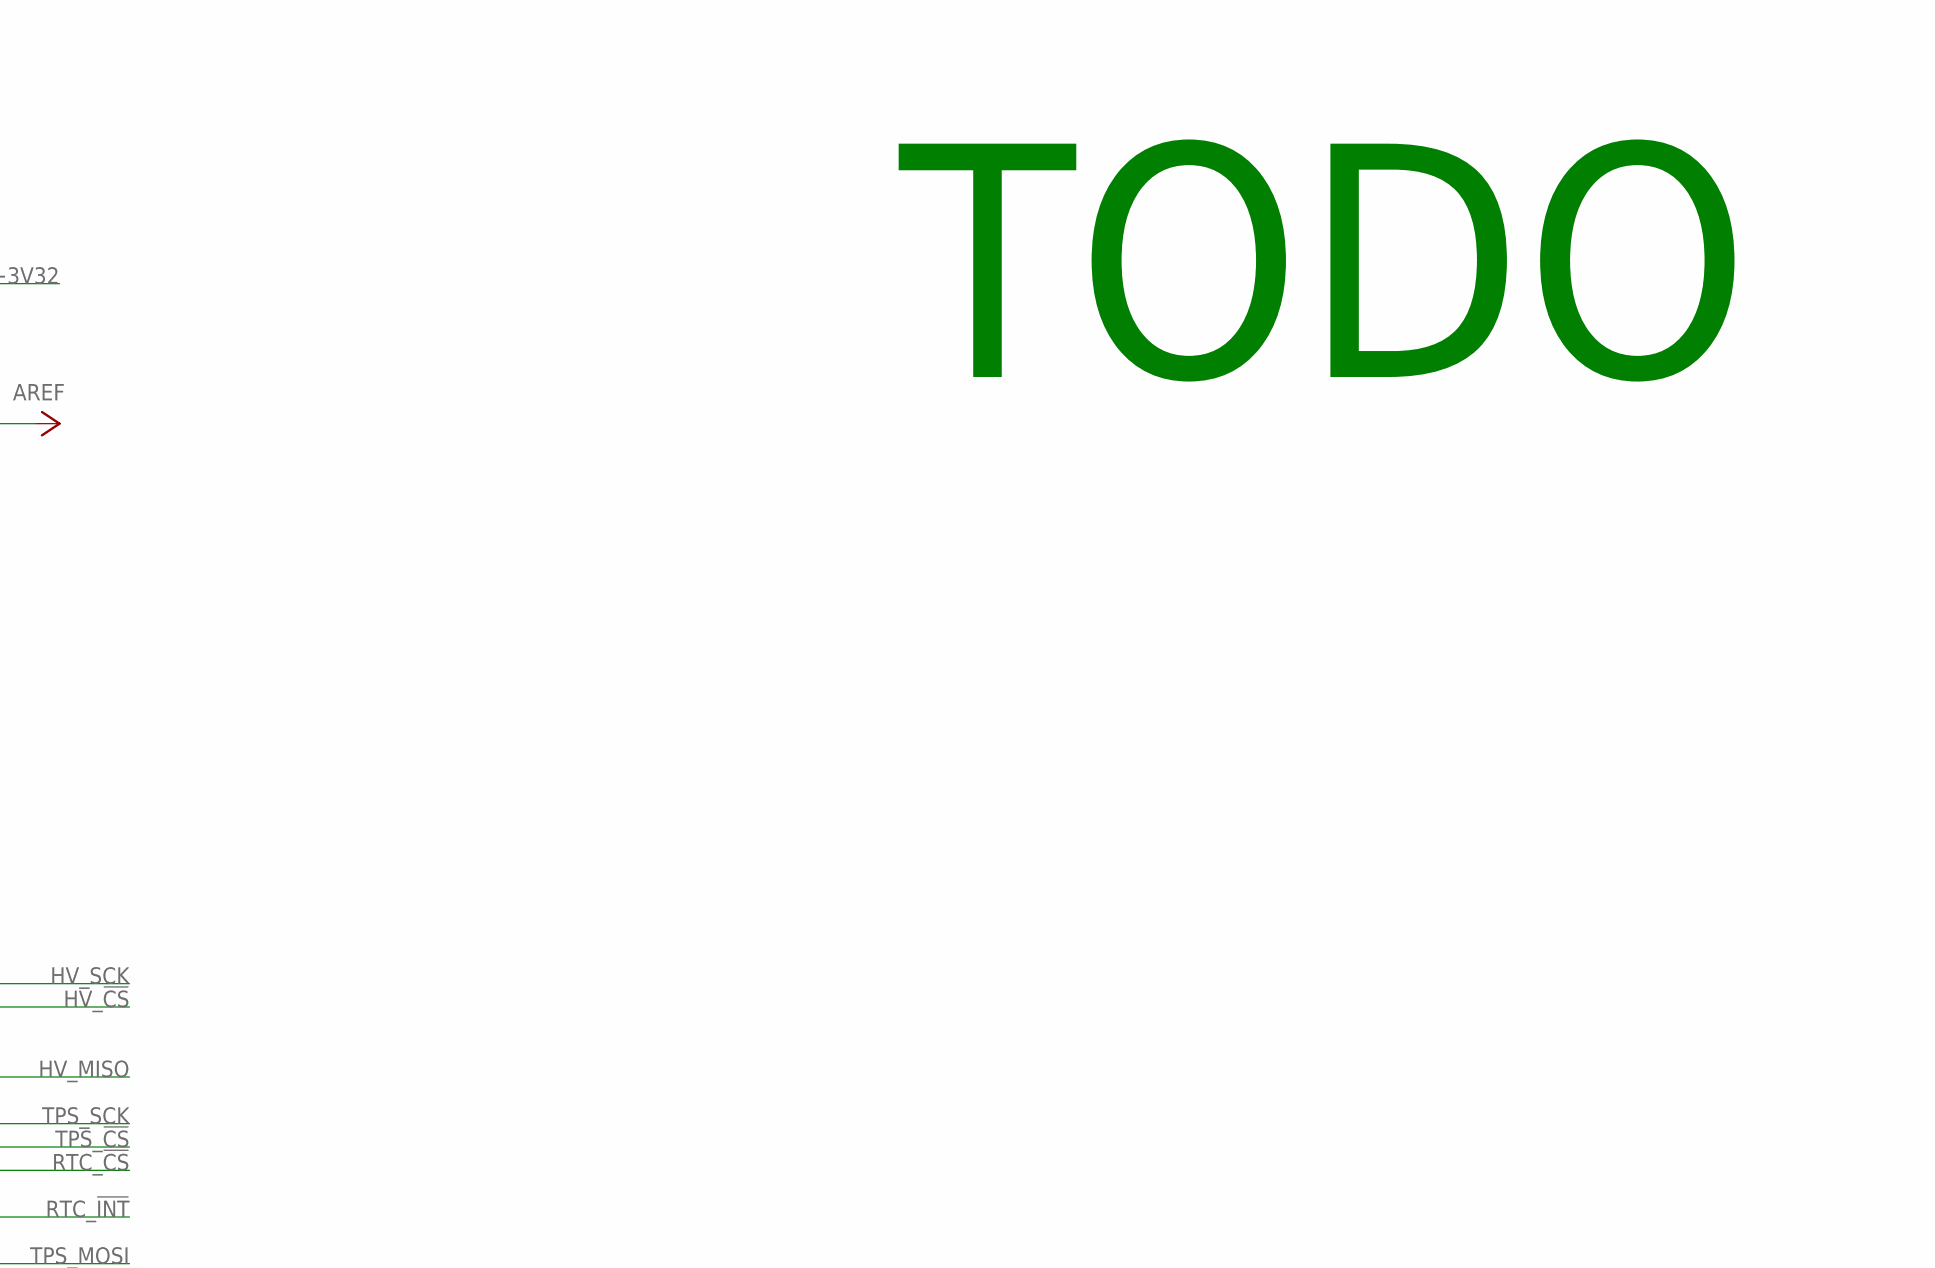
[picture p102: schematic bms_master_V01.sch, sheet 8, part in row 1, column 2]

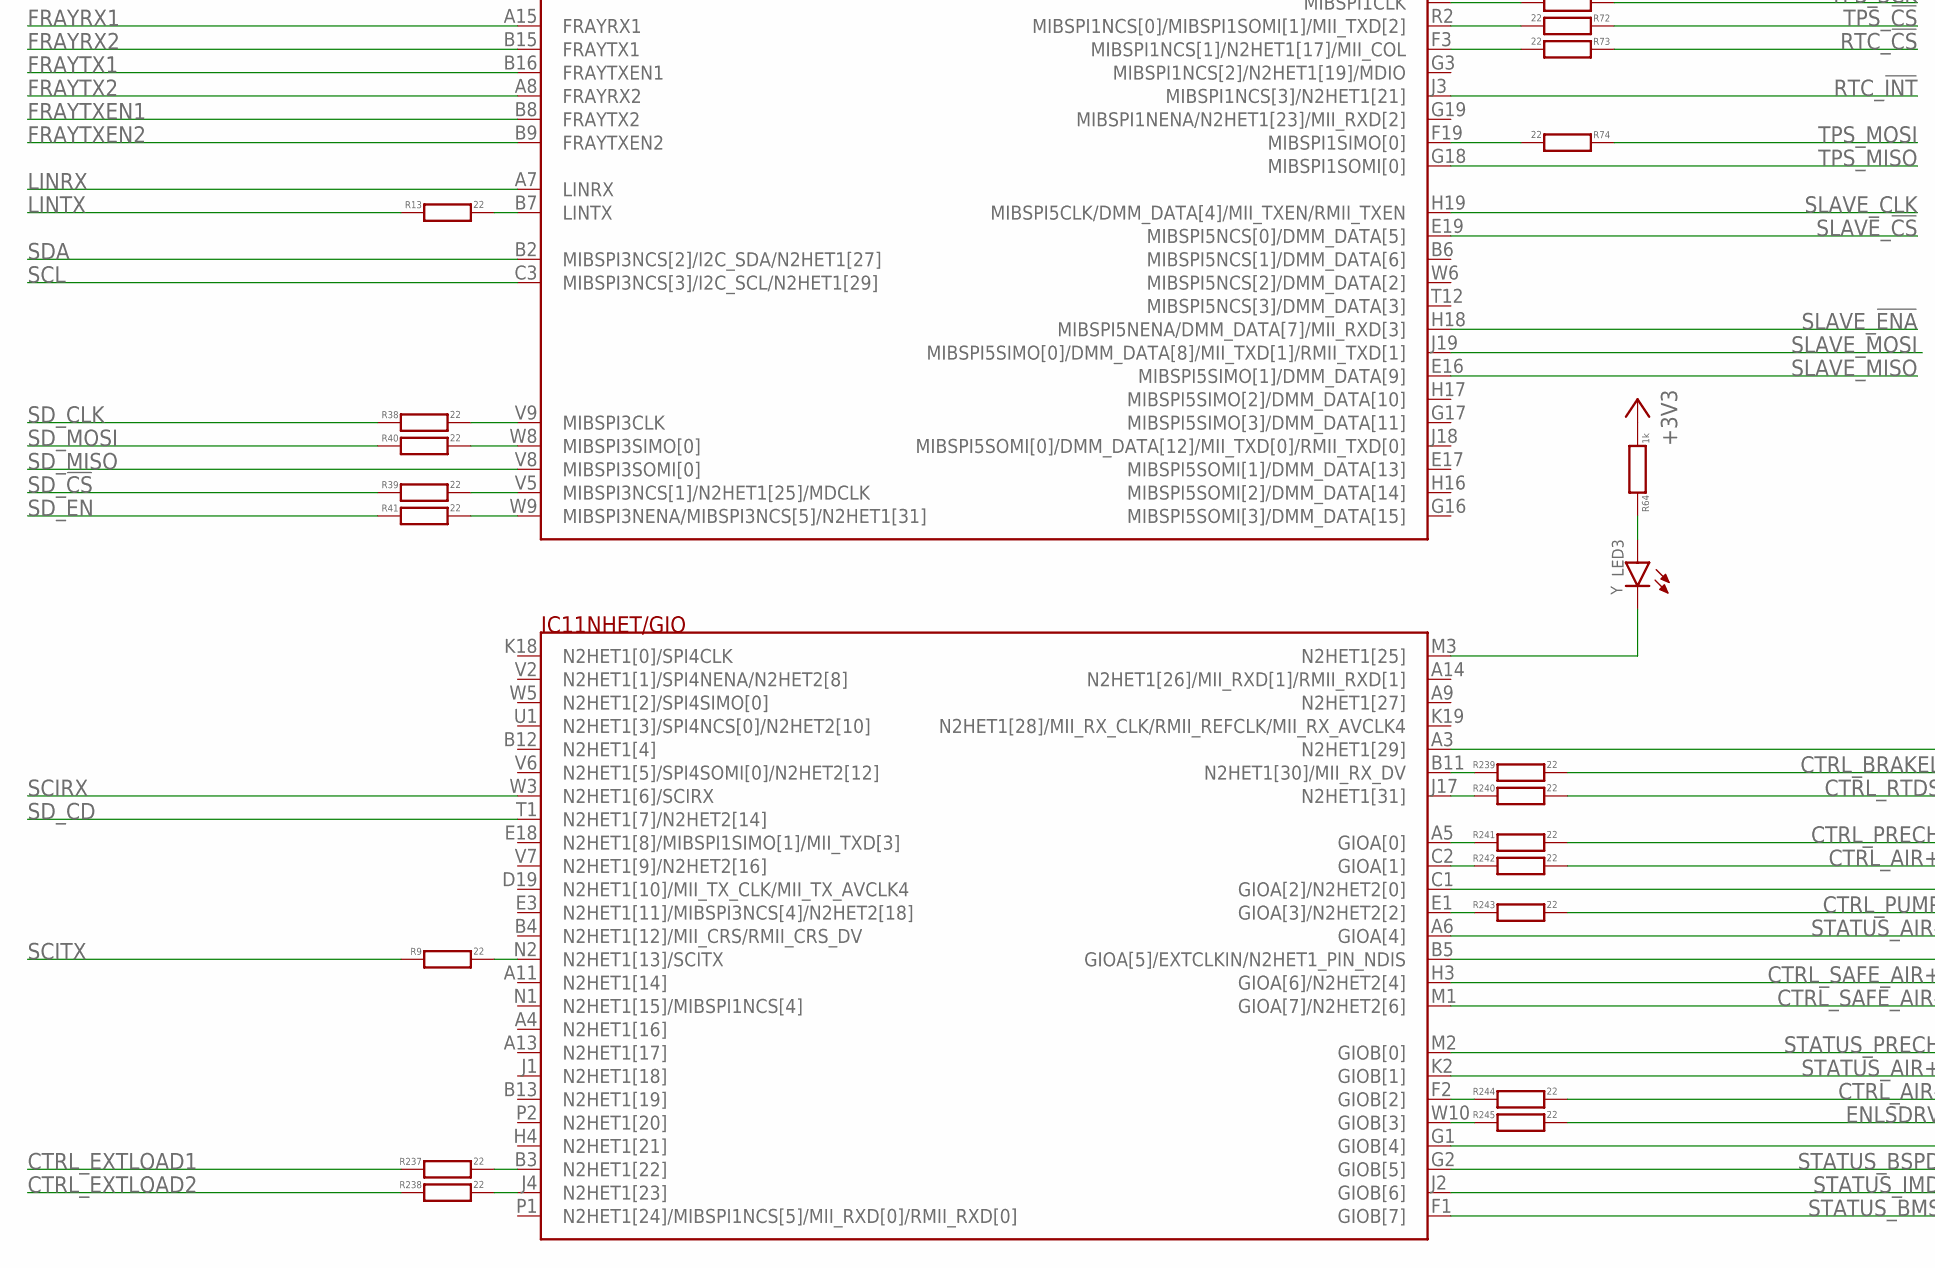
[picture p103: schematic bms_master_V01.sch, sheet 8, part in row 2, column 1]

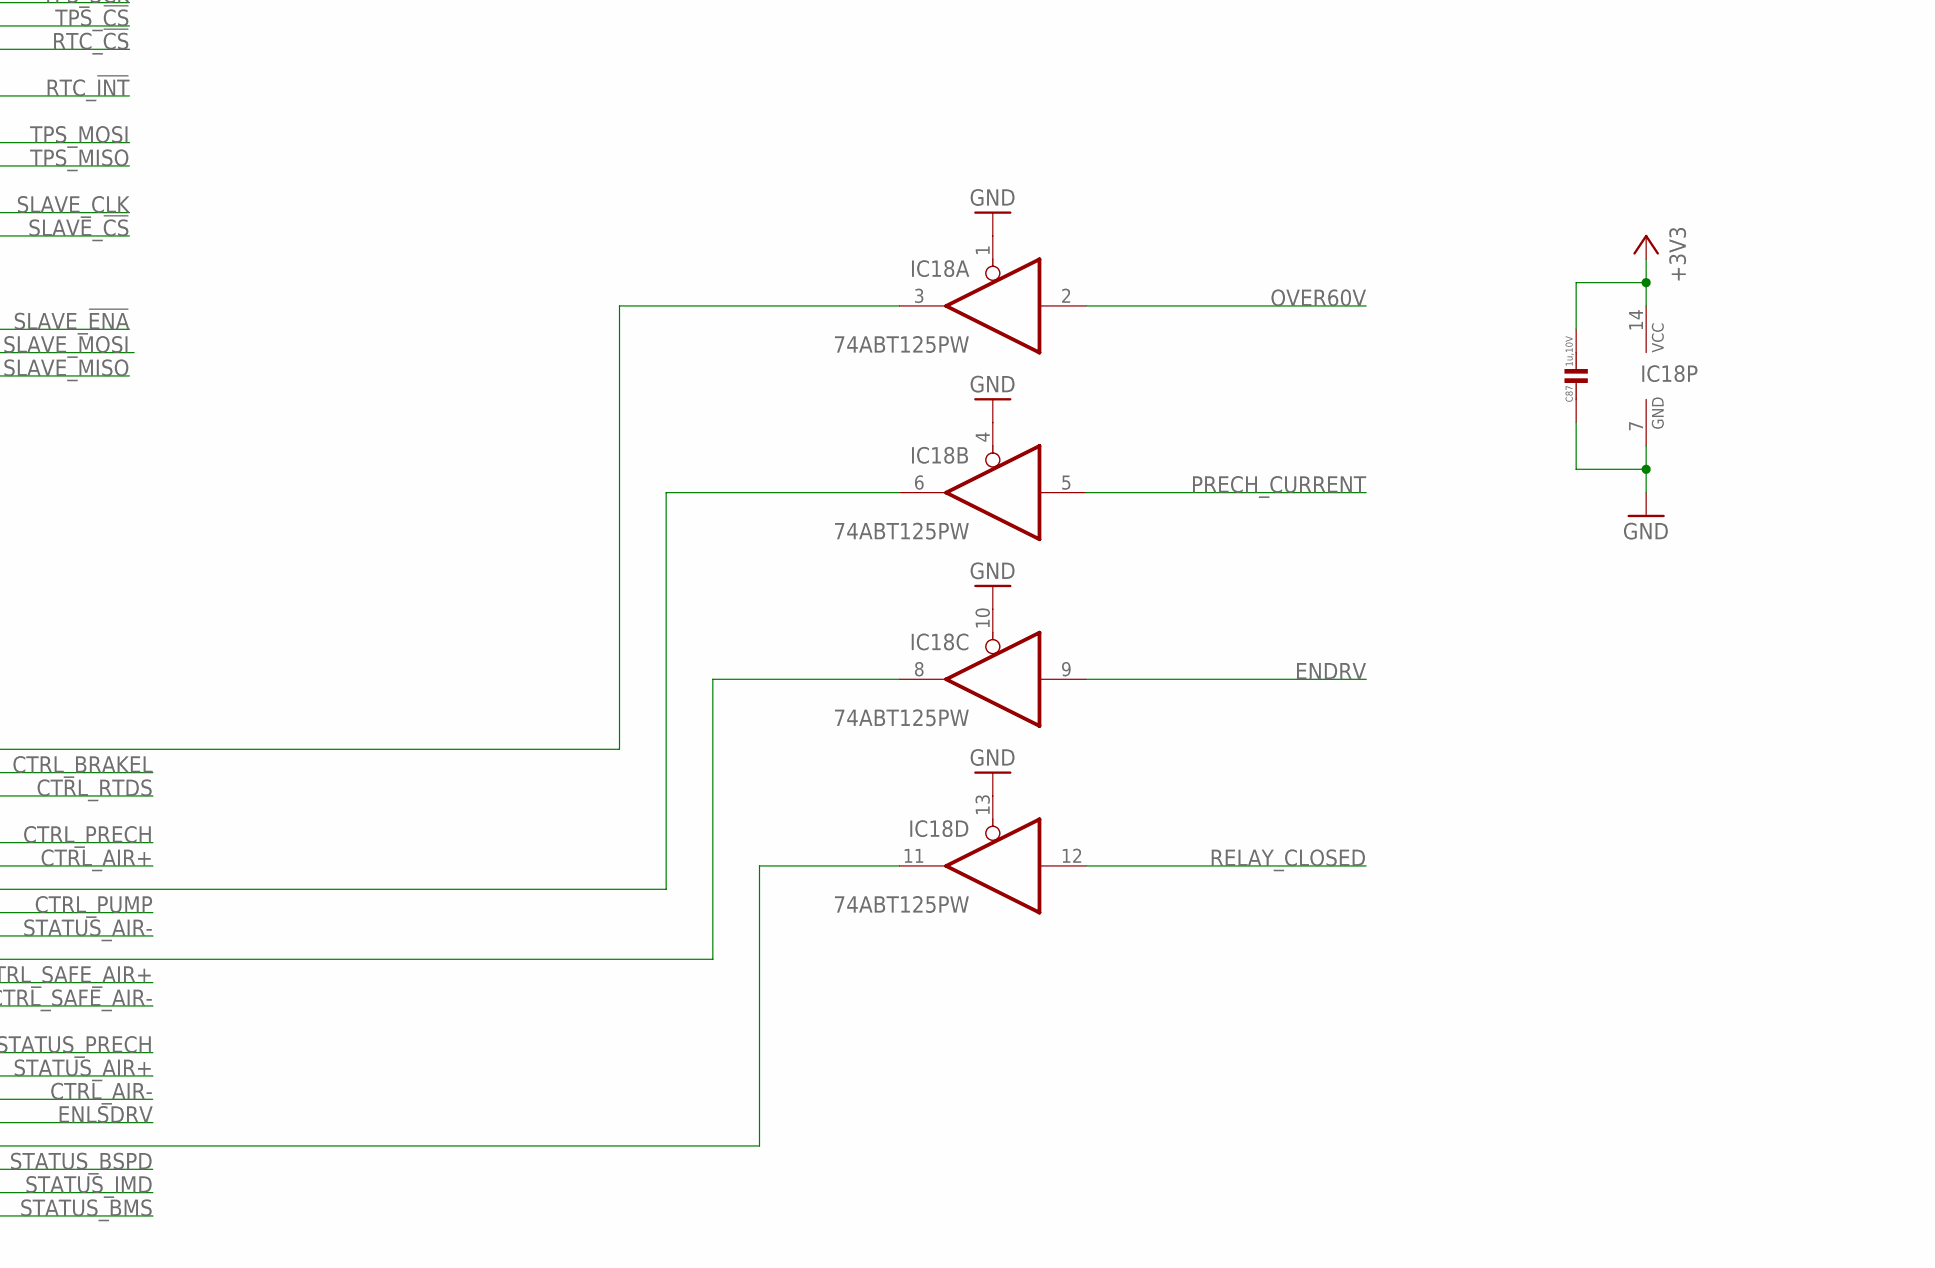
[picture p104: schematic bms_master_V01.sch, sheet 8, part in row 2, column 2]

Parts:
C24, C36, C46: 10u,10V; C0603
C87: 1u,10V; C0402
IC11: TMS570LS3137ZWT; S-PBGA-N337
IC18: 74ABT125PW; TSSOP14
L7: 74479774210; WE-PMI_0805
LED3: Y; CHIPLED_0603
R9, R12, R13, R14, R18, R19, R20, R38, R39, R40, R41, R71, R72, R73, R74, R237, R238, R239, R240, R241, R242, R243, R244, R245: 22; R0402
R64: 1k; R0402

Connections:
+3V3: C87.1, IC18.14 (VCC), R64.2; also elsewhere on the board
+3V32: C46.1, L7.1; also elsewhere on the board
AD1EVT: IC11.N19 (AD1EVT/MII_RX_ER/RMII_RX_ER)
AD1_0: IC11.W14 (AD1IN[0])
AD1_1: IC11.V17 (AD1IN[1])
AD1_2: IC11.V18 (AD1IN[2])
AD1_3: IC11.T17 (AD1IN[3])
AD1_4: IC11.U18 (AD1IN[4])
AD1_5: IC11.R17 (AD1IN[5])
AD1_6: IC11.T19 (AD1IN[6])
AD1_7: IC11.V14 (AD1IN[7])
AD1_8/2_8: IC11.P18 (AD1IN[8]/AD2IN[8])
AD1_9/2_9: IC11.W17 (AD1IN[9]/AD2IN[9])
AD1_10/2_10: IC11.U17 (AD1IN[10]/AD2IN[10])
AD1_11/2_11: IC11.U19 (AD1IN[11]/AD2IN[11])
AD1_12/2_12: IC11.T16 (AD1IN[12]/AD2IN[12])
AD1_13/2_13: IC11.T18 (AD1IN[13]/AD2IN[13])
AD1_14/2_14: IC11.R18 (AD1IN[14]/AD2IN[14])
AD1_16/2_0: IC11.V13 (AD1IN[16]/AD2IN[0])
AD1_17/2_1: IC11.U13 (AD1IN[17]/AD2IN[1])
AD1_18/2_2: IC11.U14 (AD1IN[18]/AD2IN[2])
AD1_19/2_3: IC11.U16 (AD1IN[19]/AD2IN[3])
AD1_20/2_4: IC11.U15 (AD1IN[20]/AD2IN[4])
AD1_21/2_5: IC11.T15 (AD1IN[21]/AD2IN[5])
AD1_22/2_6: IC11.R19 (AD1IN[22]/AD2IN[6])
AD1_23/2_7: IC11.R16 (AD1IN[23]/AD2IN[7])
AGND: C24.2, C36.2, C46.2, IC11.V16 (ADREFLO), IC11.V19 (VSSAD), IC11.W16 (VSSAD), IC11.W18 (VSSAD), IC11.W19 (VSSAD); also elsewhere on the board
AREF: C24.1, IC11.V15 (ADREFHI); also elsewhere on the board
AVCC: C36.1, IC11.W15 (VCCAD), L7.2
CAN1RX: IC11.B10 (CAN1RX); also elsewhere on the board
CAN1TX: R19.2; also elsewhere on the board
CAN1TX_R: IC11.A10 (CAN1TX), R19.1
CAN2RX_R: IC11.H1 (CAN2RX)
CAN2TX: R12.2; also elsewhere on the board
CAN2TX_R: IC11.H2 (CAN2TX), R12.1
CAN3RX: IC11.M19 (CAN3RX); also elsewhere on the board
CAN3TX: R14.2; also elsewhere on the board
CAN3TX_R: IC11.M18 (CAN3TX), R14.1
CTRL_AIR+: R242.2; also elsewhere on the board
CTRL_AIR-: R244.2; also elsewhere on the board
CTRL_BRAKEL: R239.2; also elsewhere on the board
CTRL_EXTLOAD1: R237.1; also elsewhere on the board
CTRL_EXTLOAD2: R238.1; also elsewhere on the board
CTRL_PRECH: R241.2; also elsewhere on the board
CTRL_PUMP: R243.2; also elsewhere on the board
CTRL_RTDS: R240.2; also elsewhere on the board
CTRL_SAFE_AIR+: IC11.H3 (GIOA[6]/N2HET2[4]); also elsewhere on the board
CTRL_SAFE_AIR-: IC11.M1 (GIOA[7]/N2HET2[6]); also elsewhere on the board
DIAG: IC11.P19 (AD1IN[15]/AD2IN[15]); also elsewhere on the board
ENDRV: IC18.9 (I); also elsewhere on the board
ENLSDRV: R245.2; also elsewhere on the board
FRAYRX1: IC11.A15 (FRAYRX1)
FRAYRX2: IC11.B15 (FRAYTX1)
FRAYTX1: IC11.B16 (FRAYTXEN1)
FRAYTX2: IC11.A8 (FRAYRX2)
FRAYTXEN1: IC11.B8 (FRAYTX2)
FRAYTXEN2: IC11.B9 (FRAYTXEN2)
GND: C87.2, IC18.1 (OE), IC18.4 (OE), IC18.7 (GND), IC18.10 (OE), IC18.13 (OE); also elsewhere on the board
HV_!CS: R20.1; also elsewhere on the board
HV_MISO: IC11.D2 (SPI2SOMI[0]); also elsewhere on the board
HV_SCK: R18.1; also elsewhere on the board
LED1A2: LED3.A, R64.1
LINRX: IC11.A7 (LINRX); also elsewhere on the board
LINTX: R13.1; also elsewhere on the board
unnamed: IC11.B7 (LINTX), R13.2
unnamed: IC11.N2 (N2HET1[13]/SCITX), R9.2
unnamed: IC11.E2 (SPI2CLK), R18.2
unnamed: IC11.N3 (SPI2NCS[0]), R20.2
unnamed: IC11.G1 (GIOB[4]), IC18.11 (O)
unnamed: IC11.B3 (N2HET1[22]), R237.2
unnamed: IC11.J4 (N2HET1[23]), R238.2
unnamed: IC11.F2 (GIOB[2]), R244.1
unnamed: IC11.E1 (GIOA[3]/N2HET2[2]), R243.1
unnamed: IC11.C2 (GIOA[1]), R242.1
unnamed: IC11.A5 (GIOA[0]), R241.1
unnamed: IC11.J17 (N2HET1[31]), R240.1
unnamed: IC11.B11 (N2HET1[30]/MII_RX_DV), R239.1
unnamed: IC11.W10 (GIOB[3]), R245.1
unnamed: IC11.M3 (N2HET1[25]), LED3.C
unnamed: IC11.B5 (GIOA[5]/EXTCLKIN/N2HET1_PIN_NDIS), IC18.8 (O)
unnamed: IC11.C1 (GIOA[2]/N2HET2[0]), IC18.6 (O)
unnamed: IC11.A3 (N2HET1[29]), IC18.3 (O)
OVER60V: IC18.2 (I); also elsewhere on the board
PRECH_CURRENT: IC18.5 (I); also elsewhere on the board
RELAY_CLOSED: IC18.12 (I); also elsewhere on the board
RTC_!CS: R73.1; also elsewhere on the board
RTC_!CSR1: IC11.F3 (MIBSPI1NCS[1]/N2HET1[17]/MII_COL), R73.2
RTC_!INT: IC11.J3 (MIBSPI1NCS[3]/N2HET1[21]); also elsewhere on the board
SCIRX: IC11.W3 (N2HET1[6]/SCIRX); also elsewhere on the board
SCITX: R9.1; also elsewhere on the board
SCL: IC11.C3 (MIBSPI3NCS[3]/I2C_SCL/N2HET1[29]); also elsewhere on the board
SDA: IC11.B2 (MIBSPI3NCS[2]/I2C_SDA/N2HET1[27]); also elsewhere on the board
SD_!CS: R39.1; also elsewhere on the board
SD_!CS_R: IC11.V5 (MIBSPI3NCS[1]/N2HET1[25]/MDCLK), R39.2
SD_CD: IC11.T1 (N2HET1[7]/N2HET2[14]); also elsewhere on the board
SD_CLK: R38.1; also elsewhere on the board
SD_CLK_R: IC11.V9 (MIBSPI3CLK), R38.2
SD_EN: R41.1; also elsewhere on the board
SD_EN_R: IC11.W9 (MIBSPI3NENA/MIBSPI3NCS[5]/N2HET1[31]), R41.2
SD_MISO: IC11.V8 (MIBSPI3SOMI[0]); also elsewhere on the board
SD_MOSI: R40.1; also elsewhere on the board
SD_MOSI_R: IC11.W8 (MIBSPI3SIMO[0]), R40.2
SLAVE_!CS: IC11.E19 (MIBSPI5NCS[0]/DMM_DATA[5])
SLAVE_!ENA: IC11.H18 (MIBSPI5NENA/DMM_DATA[7]/MII_RXD[3])
SLAVE_CLK: IC11.H19 (MIBSPI5CLK/DMM_DATA[4]/MII_TXEN/RMII_TX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)
SLAVE_MISO: IC11.E16 (MIBSPI5SIMO[1]/DMM_DATA[9])
SLAVE_MOSI: IC11.J19 (MIBSPI5SIMO[0]/DMM_DATA[8]/MII_TXD[1]/R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)
STATUS_AIR+: IC11.K2 (GIOB[1])
STATUS_AIR-: IC11.A6 (GIOA[4])
STATUS_BMS: IC11.F1 (GIOB[7]); also elsewhere on the board
STATUS_BSPD: IC11.G2 (GIOB[5]); also elsewhere on the board
STATUS_IMD: IC11.J2 (GIOB[6]); also elsewhere on the board
STATUS_PRECH: IC11.M2 (GIOB[0])
TPS_!CS: R72.1; also elsewhere on the board
TPS_!CSR1: IC11.R2 (MIBSPI1NCS[0]/MIBSPI1SOMI[1]/MII_TXD[2]), R72.2
TPS_MISO: IC11.G18 (MIBSPI1SOMI[0]); also elsewhere on the board
TPS_MOSI: R74.1; also elsewhere on the board
TPS_MOSIR1: IC11.F19 (MIBSPI1SIMO[0]), R74.2
TPS_SCK: R71.1; also elsewhere on the board
TPS_SCKR1: IC11.F18 (MIBSPI1CLK), R71.2

Notes on the sheet:
TODO
