funkobongrip/sprbms/hardware/nextgen_master/bms_master_V01.brd

## EAGLE design hardware/nextgen_master/bms_master_V01.brd (continued)

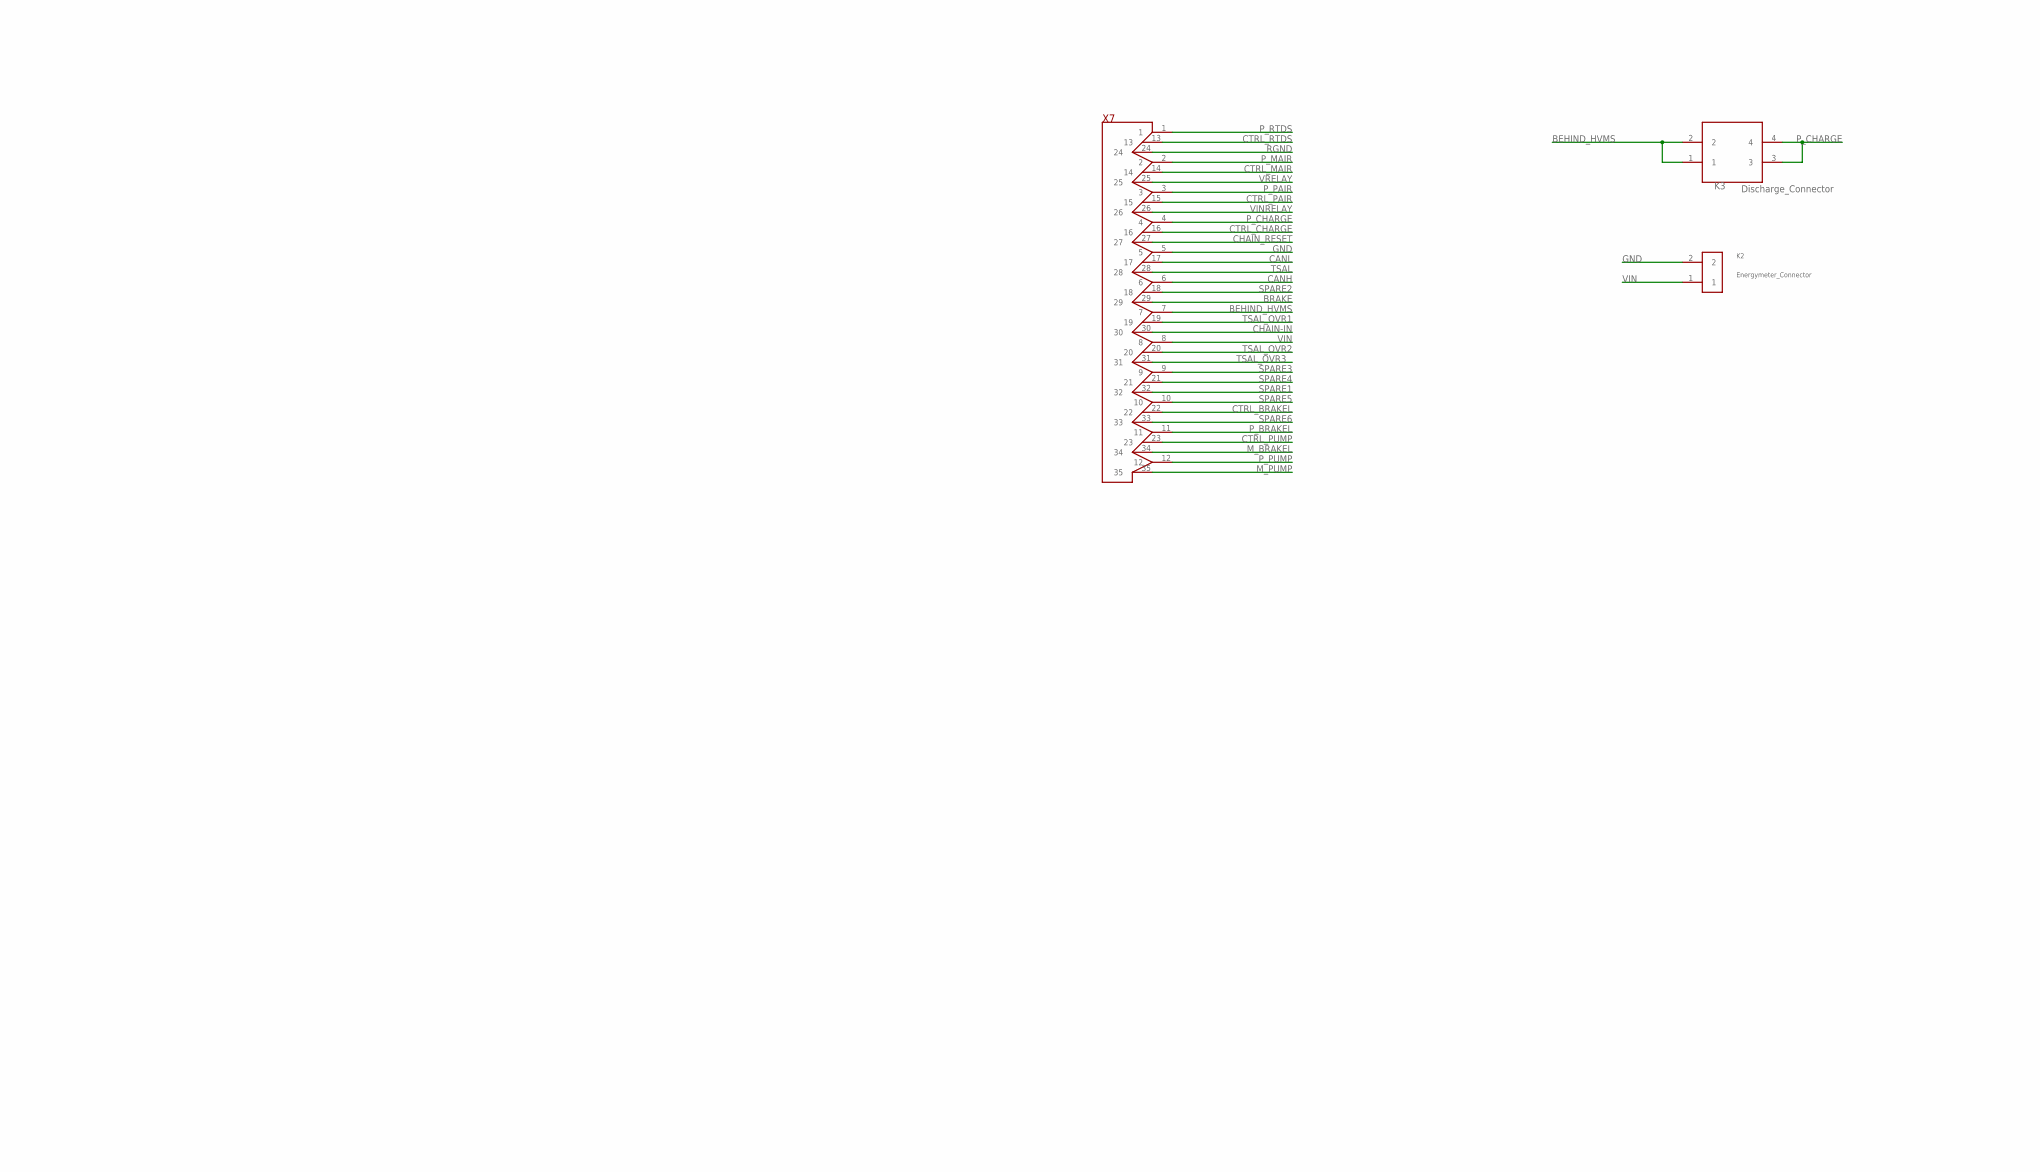
[picture p105: schematic bms_master_V01.sch, sheet 9, part in row 1, column 1]

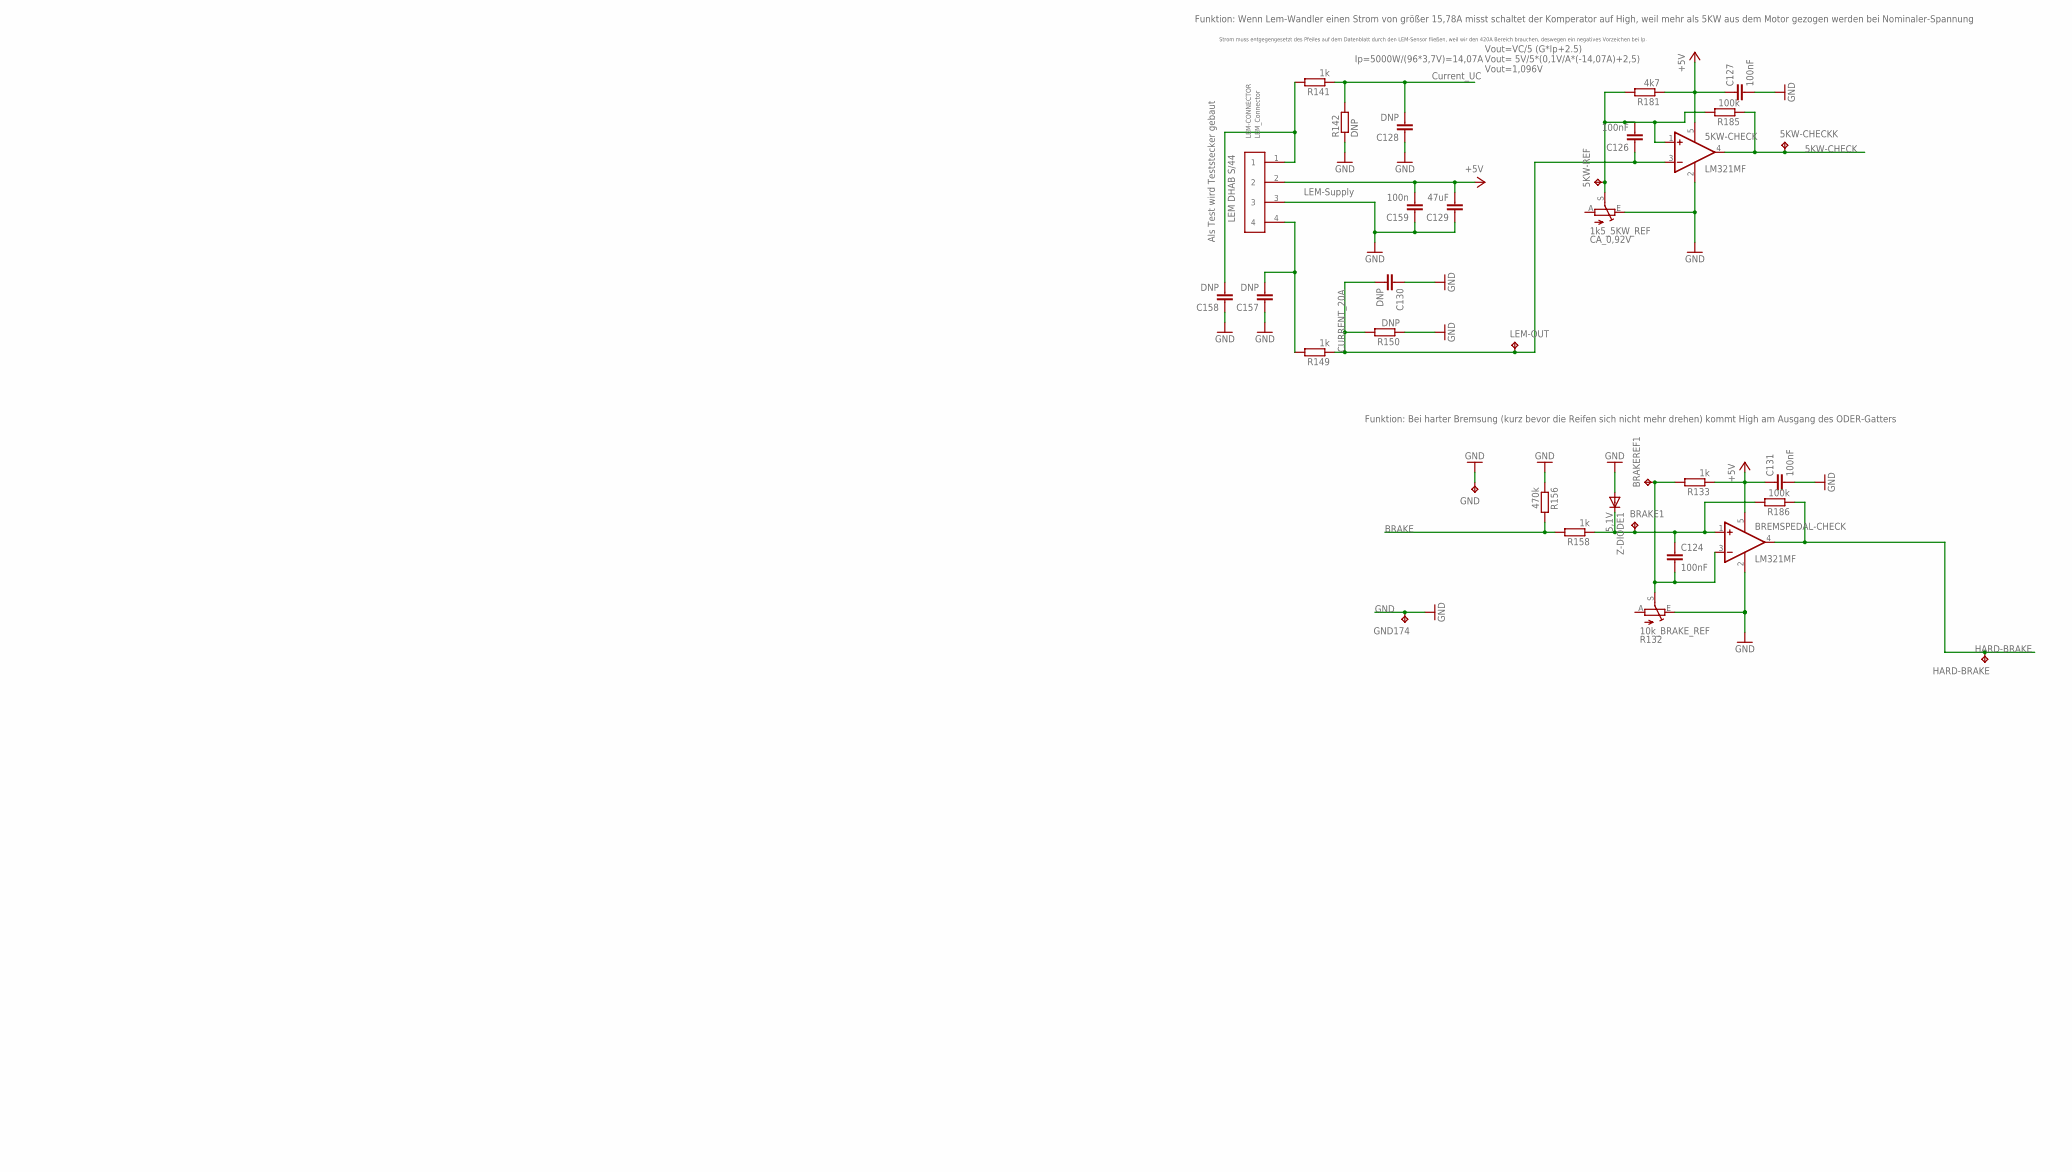
[picture p106: schematic bms_master_V01.sch, sheet 9, part in row 1, column 2]

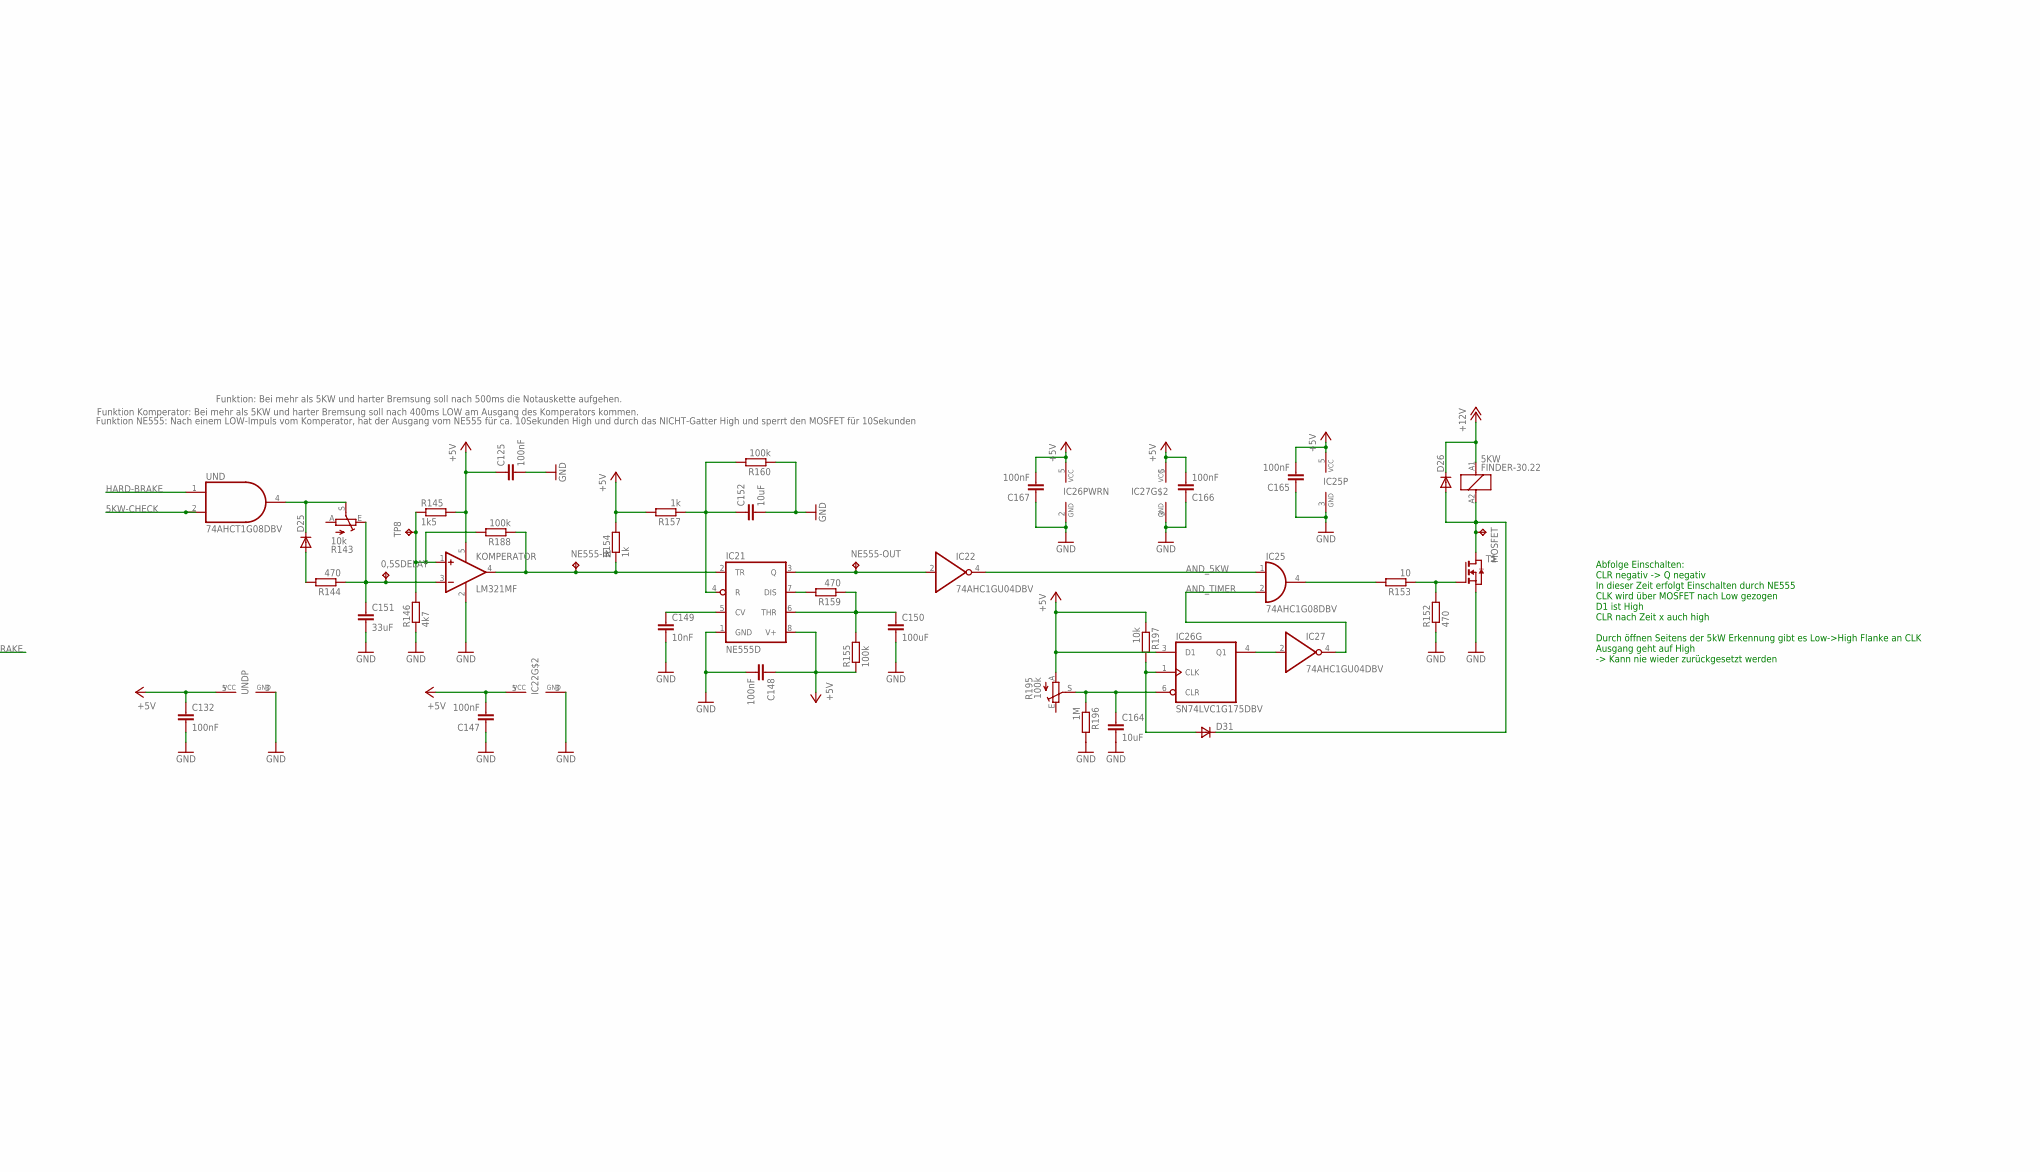
[picture p107: schematic bms_master_V01.sch, sheet 9, part in row 1, column 3]

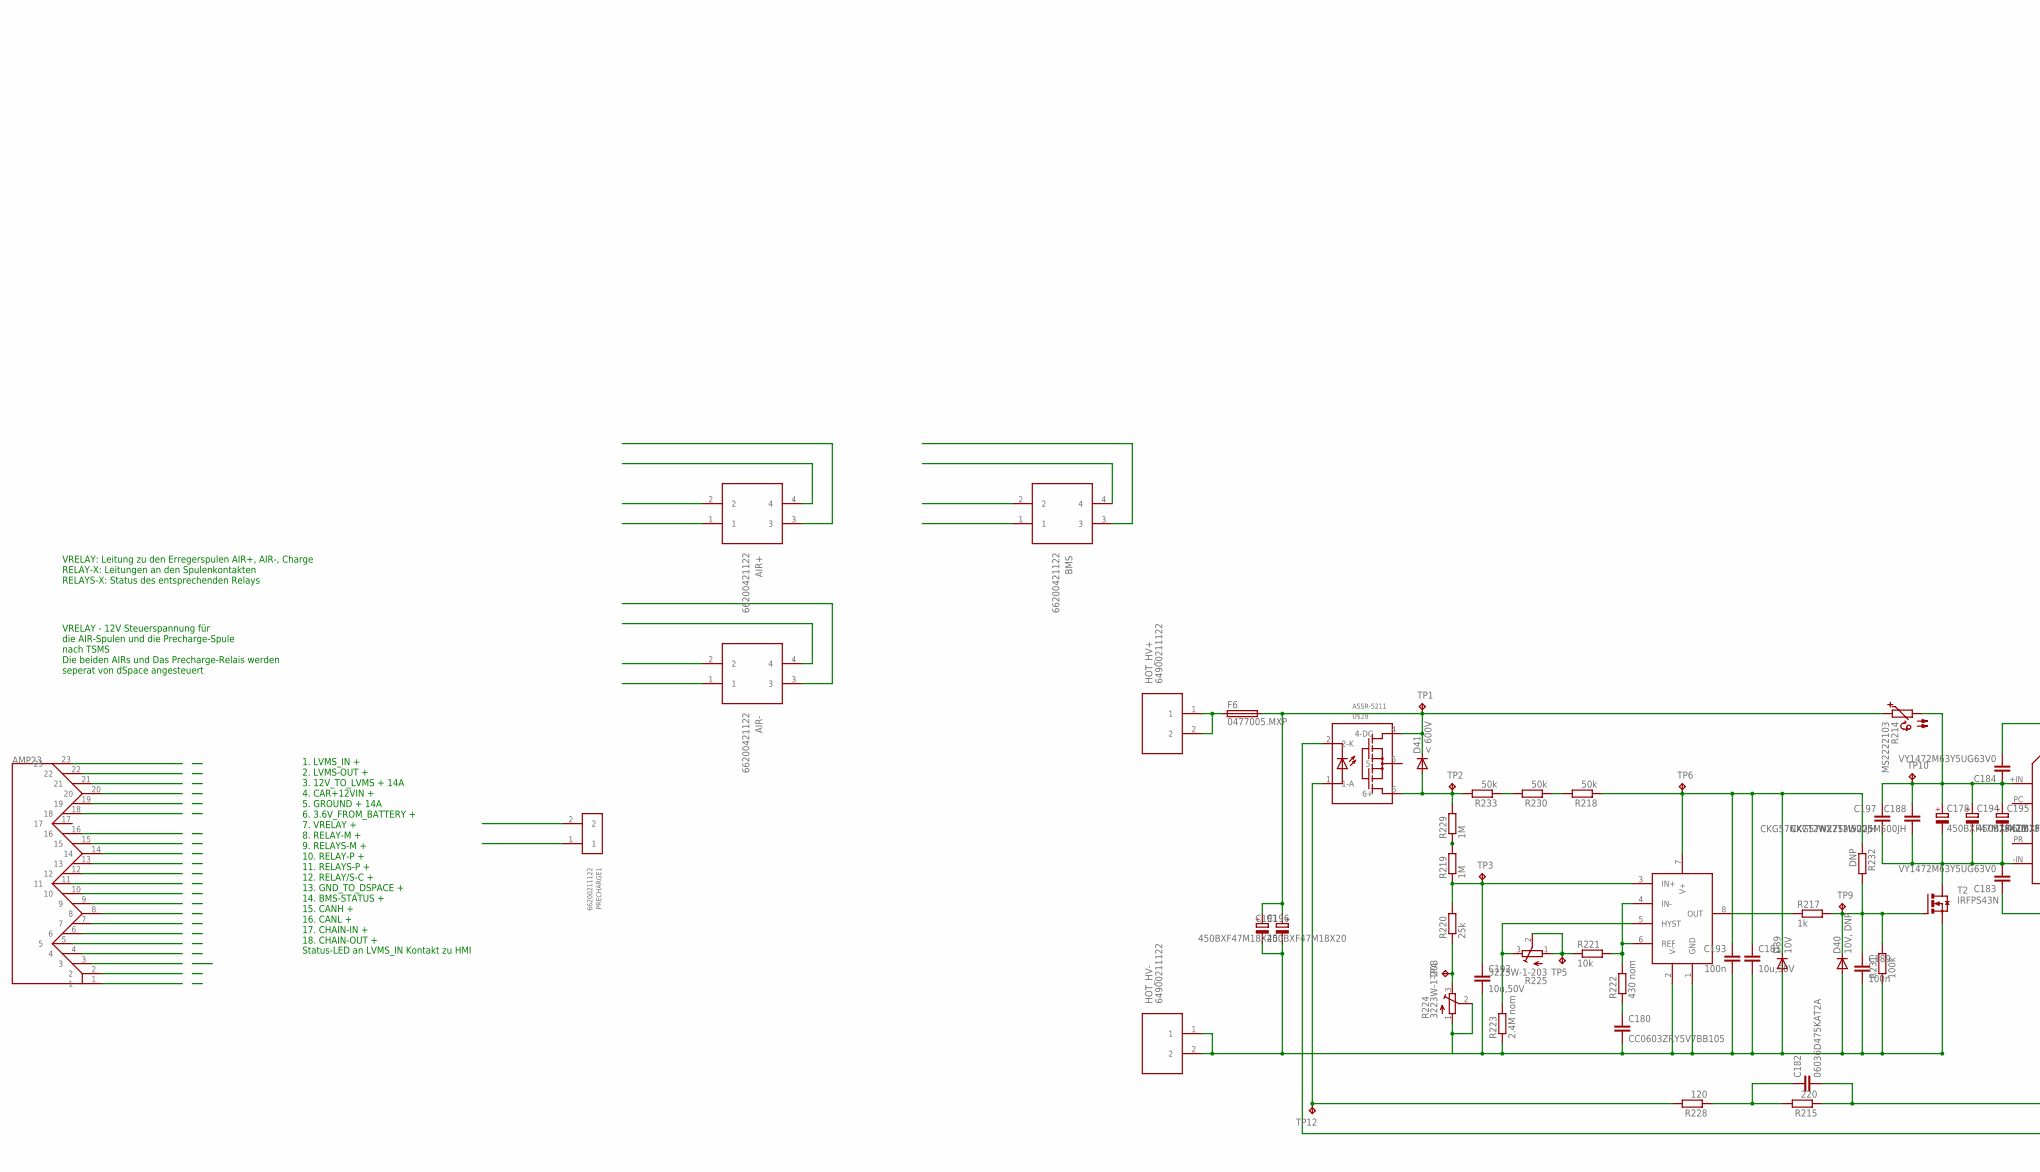
[picture p108: schematic bms_master_V01.sch, sheet 9, part in row 2, column 1]

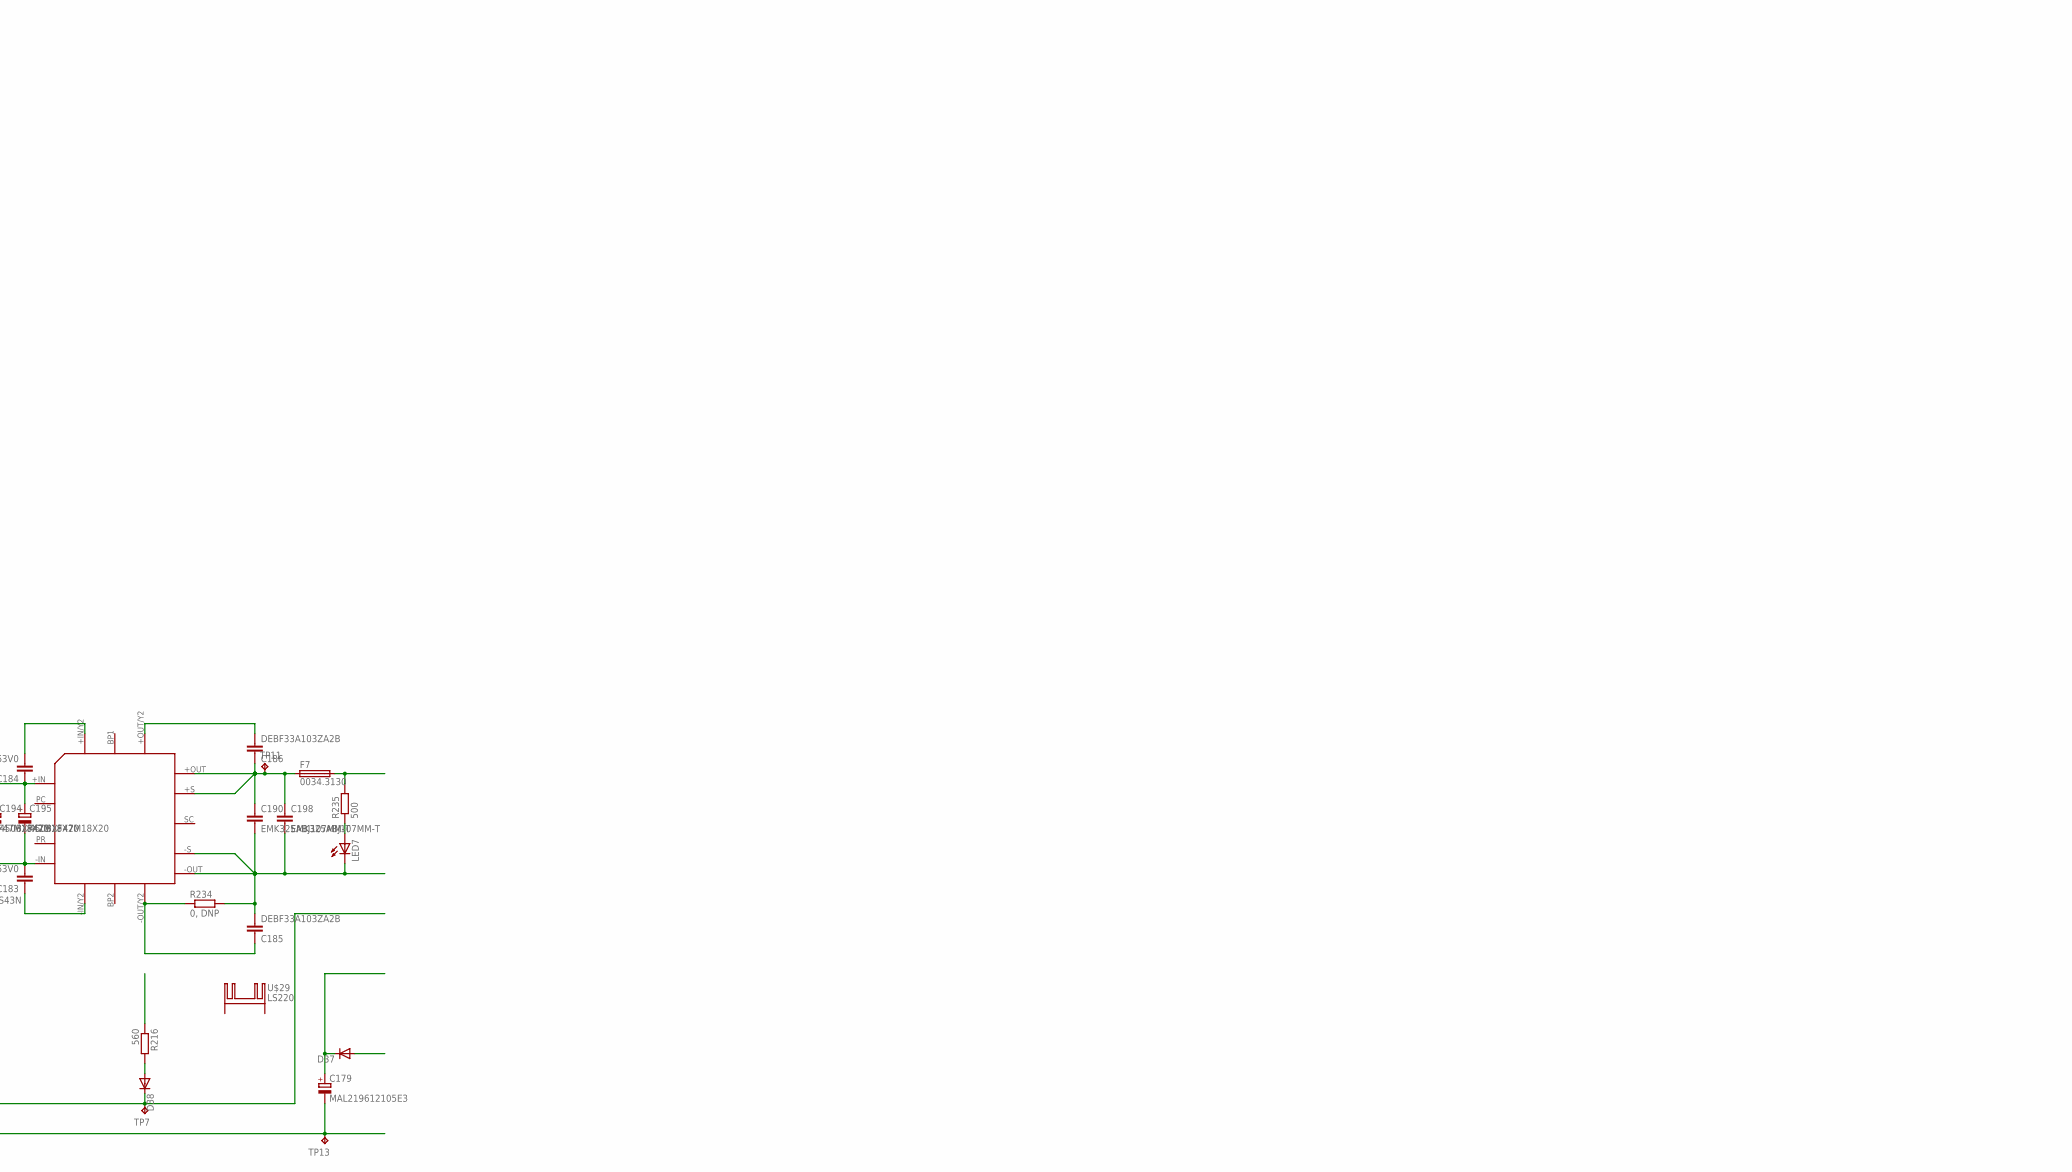
[picture p109: schematic bms_master_V01.sch, sheet 9, part in row 2, column 2]

Parts:
0,5SDELAY: 0.5s_Delay; B1,27
5KW: FINDER-30.22
5KW-CHECK: LM321MF; SOT23-5
5KW-CHECKK: 5KW_Check; B1,27
5KW-REF: 5KW_REF; B1,27
AIR+: 66200421122
AIR-: 66200421122
BMS: 66200421122
BRAKE1: BRAKE; B1,27
BRAKEREF1: BRAKE_REF; B1,27
BREMSPEDAL-CHECK: LM321MF; SOT23-5
C124, C125, C126, C127, C131, C132, C147, C148, C165, C166, C167: 100nF; C0603
C128, C130, C157, C158: DNP; C0603
C129: 47uF; C1206
C149: 10nF; C0603
C150: 100uF; C1206K
C151: 33uF; C1206
C152: 10uF; C0603
C159: 100n; C0603
C164: 10uF; C1206K
C178, C191, C194, C195, C196: 450BXF47M18X20; E7,5-18
C179: MAL219612105E3; E5-13
C180: CC0603ZRY5V7BB105; C0603
C181, C192: 10u,50V; C1206
C182: 06036D475KAT2A; C0603
C183, C184: VY1472M63Y5UG63V0; YC10B5
C185, C186: DEBF33A103ZA2B; C050-040X10
C188, C197: CKG57NX7T2W225M500JH; C2220K
C189, C193: 100n; C1206
C190, C198: EMK325ABJ107MM-T; C1210
CA_0,92V: 1k5_5KW_REF; S64W
D25, D26: DIODE-SOD323-R; SOD323-R
D31: DSOD323; SOD323
D37: DIODE-SOD323-W; SOD323-W
D38: DIODE-SOD123; SOD123
D39: 10V; DO-214AC
D40: 10V, DNP; DO-214AC
D41: < 600V; DO-214AC
F6: 0477005.MXP; SHK20L
F7: 0034.3130; SHK20L
GND, GND174: GND; B1,27
HARD-BRAKE: HARD_BRAKE; B1,27
HOT_HV+: 64900211122
HOT_HV-: 64900211122
IC21: NE555D; SO08
IC22, IC27: 74AHC1GU04DBV; SOT23-5
IC25: 74AHC1G08DBV; SOT23-5
IC26: SN74LVC1G175DBV; SOT23-6
IC31: LTC1440; SO08
K2: Energymeter_Connector; 66200211122
K3: Discharge_Connector; 66200421122
KOMPERATOR: LM321MF; SOT23-5
LED7: LEDCHIPLED_1206; CHIPLED_1206
LEM-CONNECTOR: LEM_Connector; 66200411122
LEM-OUT: LEMC_OUT; B1,27
MOSFET: MOSFET; B1,27
NE555-IN: NE555_IN; B1,27
NE555-OUT: NE555_OUT; B1,27
PRECHARGE1: 66200211122
R132: 10k_BRAKE_REF; S64W
R133, R141, R149, R154, R157, R158: 1k; R0603
R142, R150: DNP; R0603
R143: 10k; S64W
R144, R152, R159: 470; R0603
R145: 1k5; R0603
R146, R181: 4k7; R0603
R153: 10; R0603
R155, R160, R185, R186, R188: 100k; R0603
R156: 470k; R0603
R195: 100k; S64W
R196: 1M; R0603
R197, R221: 10k; R0603
R214: MS2222103
R215: 220; R0603
R216: 560; R0603
R217: 1k; R1206
R218, R230, R233: 50k; WSC2515
R219, R229: 1M; WSC2515
R220: 25k; R1206
R222: 430 nom; R0603
R223: 2.4M nom; R0603
R224, R225: 3223W-1-203; 3223W
R228: 120; R0603
R231: 100k; R1206
R232: DNP; R1206
R234: 0, DNP; R1210
R235: 500; R1206W
T1: NMOSSOT23; SOT-23
T2: IRFPS43N; TO247BV
TP1, TP2, TP3, TP4, TP5, TP6, TP7, TP9, TP10, TP11, TP12, TP13: TPB2,54; B2,54
TP8: TPB1,27; B1,27
U$26: AMSEAL23RW; AMPSEAL23RW
U$27: VICORPOWER_V375B12C300BL2
U$28: ASSR-5211; DIL06
U$29: LS220
UND: 74AHCT1G08DBV; SOT23-5
X7: AMPSEAL_35; AMPSEAL_776231-1
Z-DIODE1: 5,1V; SOD323-R

Connections:
0,5SDELAY: 0,5SDELAY.TP, C151.1, KOMPERATOR.3 (-IN), R143.E, R144.1
3.6V_FROM_BATTERY: D37.A, U$26.10
5KW-CHECK: 5KW-CHECK.4 (OUT), 5KW-CHECKK.TP, R185.1, UND.2 (I1)
5KWOP-: 5KW-CHECK.1 (+IN), 5KW-REF.TP, C126.2, CA_0,92V.S, R181.2, R185.2
10V: C181.1, C193.1, D39.C, IC31.7 (V+), R218.1, R232.1, TP6.TP
12V_TO_LVMS: F7.2A, R235.2, U$26.3, U$26.11, U$26.18
+5V: 5KW-CHECK.5 (V+), BREMSPEDAL-CHECK.5 (V+), C125.1, C127.1, C129.2, C131.1, C132.1, C147.2, C148.1, C159.2, C165.2, C166.2, C167.2, IC21.8 (V+), IC22.5 (VCC), IC25.5 (VCC), IC26.3 (D1), IC26.5 (VCC), IC27.5 (VCC), KOMPERATOR.5 (V+), LEM-CONNECTOR.2, R133.1, R145.2, R154.2, R155.1, R157.2, R181.1, R195.A, R197.1, UND.5 (VCC); also elsewhere on the board
AND_5KW: IC22.4 (O), IC25.1 (I0)
AND_TIMER: IC25.2 (I1), IC27.4 (O)
BEHIND_HVMS: K3.1, K3.2, X7.7
BMS_STATUS: U$26.13
BRAKE: R156.2, R158.2, X7.29
BRAKE1OP+: BRAKE1.TP, BREMSPEDAL-CHECK.1 (+IN), C124.1, R158.1, R186.2, Z-DIODE1.C
BRAKE1OP-: BRAKEREF1.TP, BREMSPEDAL-CHECK.3 (-IN), C124.2, R132.S, R133.2
CANH: X7.6
CANH1: BMS.1, U$26.12
CANL: X7.17
CANL1: BMS.2, U$26.4
CAR+12VIN: BMS.4, R216.1, U$26.6
CHAIN-IN: X7.30
CHAIN-IN1: U$26.7
CHAIN-OUT1: U$26.8
CHAIN_RESET: X7.27
CTRL_BRAKEL: X7.22; also elsewhere on the board
CTRL_CHARGE: X7.16
CTRL_MAIR: X7.14
CTRL_PAIR: X7.15
CTRL_PUMP: X7.23; also elsewhere on the board
CTRL_RTDS: X7.13; also elsewhere on the board
CURRENT_20A: 5KW-CHECK.3 (-IN), C126.1, C130.2, LEM-OUT.TP, R149.1, R150.2
CURRENT_UC: C128.2, R141.1, R142.2
DCDC+: C178.+, C184.1, C188.1, C194.+, C195.+, C197.1, R214.2, TP10.TP, U$27.+IN (1_+IN)
DCDC-: C178.-, C183.2, C188.2, C194.-, C195.-, C197.2, T2.D (D1), U$27.-IN (4_-IN)
DCDCOUT+: C186.1, C190.1, C198.1, F7.1A, TP11.TP, U$27.+OUT (9_+OUT), U$27.+S (8_+S)
DELAYOP+: KOMPERATOR.1 (+IN), R145.1, R146.2, R188.2, TP8.TP
DISCHARGE: IC21.7 (DIS), R159.2
GATE: R152.2, R153.1, T1.3 (G)
GATE1: C189.1, D40.C, R217.2, R231.2, R232.2, T2.G (G1), TP9.TP
GND: 5KW-CHECK.2 (V-), BREMSPEDAL-CHECK.2 (V-), C125.2, C127.2, C128.1, C129.1, C130.1, C131.2, C132.2, C147.1, C148.2, C149.2, C150.2, C151.2, C152.2, C157.1, C158.1, C159.1, C164.2, C165.1, C166.1, C167.1, CA_0,92V.E, GND.TP, GND174.TP, IC21.1 (GND), IC22.3 (GND), IC25.3 (GND), IC26.2 (GND), IC27.3 (GND), K2.2, KOMPERATOR.2 (V-), LEM-CONNECTOR.3, R132.E, R142.1, R146.1, R150.1, R152.1, R156.1, R160.1, R196.2, T1.2 (S), UND.3 (GND), X7.5, Z-DIODE1.A; also elsewhere on the board
GND_TO_DSPACE: BMS.3, U$26.5
GROUND: AIR+.3, AIR-.3, C179.-, C185.2, C190.2, C198.2, LED7.C, R234.2, TP13.TP, U$26.1, U$26.9, U$26.16, U$27.-OUT (5_-OUT), U$27.-S (6_-S), U$28.2 (2-K)
HARD-BRAKE: BREMSPEDAL-CHECK.4 (OUT), HARD-BRAKE.TP, R186.1, UND.1 (I0)
HOT_BF_VH+: F6.1A, HOT_HV+.1, HOT_HV+.2
HV+: C191.+, C196.+, D41.C, F6.2A, R214.1, TP1.TP, U$28.4 (4-DC)
HV+MR: R219.2, R229.1
HV+SW: D41.A, R229.2, R233.2, TP2.TP, U$28.6 (6+)
HV+SW1: R230.2, R233.1
HV+SW2: R218.2, R230.1
HV-1: C180.2, C181.2, C189.2, C191.-, C192.2, C193.2, C196.-, D39.A, D40.A, HOT_HV-.1, HOT_HV-.2, IC31.1 (GND), IC31.2 (V-), R223.1, R224.1 (A), R224.2 (S), R231.1, T2.S (S1)
HYST: IC31.5 (HYST), R223.2, R225.3 (E)
IN+: C192.1, IC31.3 (IN+), R219.1, R220.2, TP3.TP
LVMS_IN: C182.2, D38.C, R215.1, TP7.TP, U$26.19
LVMS_OUT: C179.+, D37.C, U$26.2
M_BRAKEL: X7.34
M_PUMP: X7.35
unnamed: D25.A, R144.2
unnamed: C157.2, LEM-CONNECTOR.4, R149.2
unnamed: C158.2, LEM-CONNECTOR.1, R141.2
unnamed: IC26.4 (Q1), IC27.2 (I)
unnamed: D31.2 (A), IC26.1 (CLK), R197.2
unnamed: D38.A, R216.2
unnamed: R220.1, R224.3 (E), TP4.TP
unnamed: C182.1, R215.2, R228.1
unnamed: LED7.A, R235.1
NE555-CV: C149.1, IC21.5 (CV)
NE555-IN: IC21.2 (TR), KOMPERATOR.4 (OUT), NE555-IN.TP, R154.1, R188.1
NE555-OUT: IC21.3 (Q), IC22.2 (I), NE555-OUT.TP
NE555-RESET: C152.1, IC21.4 (R), R157.1, R160.2
NOT-OUT: IC25.4 (O), R153.2
OPTOA: R228.2, TP12.TP, U$28.1 (1-A)
OUT: IC31.8 (OUT), R217.1
P_BRAKEL: X7.11
P_CHARGE: K3.3, K3.4, X7.4
P_MAIR: X7.2
P_PAIR: X7.3
P_PUMP: X7.12
P_RTDS: X7.1
REF: IC31.4 (IN-), IC31.6 (REF), R221.2, R222.2
REFF: C180.1, R222.1
REFR: R221.1, R225.1 (A), R225.2 (S), TP5.TP
RELAY-M: AIR-.1, U$26.21
RELAY-P: AIR+.2, U$26.23
RELAY/S-C: PRECHARGE1.2, U$26.15
RELAYS-M: AIR-.4, U$26.20
RELAYS-P: AIR+.4, U$26.14
RGND: X7.24
SL: C164.1, IC26.6 (CLR), R195.S, R196.1
SNUBHV+: C184.2, U$27.+IN/Y2
SNUBHV-: C183.1, U$27.-IN/Y2
SNUBLV+: C186.2, U$27.+OUT/Y2
SNUBLV-: C185.1, R234.1, U$27.-OUT/Y2
SOURCE: 5KW.A2 (2), D26.A, D31.1 (C), MOSFET.TP, T1.1 (D)
SPARE1: X7.32
SPARE2: X7.18
SPARE3: X7.9
SPARE4: X7.21
SPARE5: X7.10
SPARE6: X7.33
THRESHOLD: C150.1, IC21.6 (THR), R155.2, R159.1
TSAL: X7.28
TSAL_OVR1: X7.19
TSAL_OVR2: X7.20
TSAL_OVR3: X7.31
UND-OUT: D25.C, R143.S, UND.4 (O)
VIN: 5KW.A1 (1), D26.C, K2.1, X7.8; also elsewhere on the board
VINRELAY: X7.26
VRELAY: X7.25
VRELAY1: AIR+.1, AIR-.2, PRECHARGE1.1, U$26.22

Notes on the sheet:
Vout=VC/5 (G*Ip+2.5)
Vout=1,096V
Current_UC
Vout= 5V/5*(0,1V/A*(-14,07A)+2,5)
Als Test wird Teststecker gebaut
Strom muss entgegengesetzt des Pfeiles auf dem Datenblatt durch den LEM-Sensor fließen, weil wir den 420A Bereich brauchen, deswegen ein negatives Vorzeichen bei Ip.
CURRENT_20A
LEM-Supply
Ip=5000W/(96*3,7V)=14,07A
LEM DHAB S/44
Funktion: Wenn Lem-Wandler einen Strom von größer 15,78A misst schaltet der Komperator auf High, weil mehr als 5KW aus dem Motor gezogen werden bei Nominaler-Spannung
Funktion: Bei harter Bremsung (kurz bevor die Reifen sich nicht mehr drehen) kommt High am Ausgang des ODER-Gatters
Funktion: Bei mehr als 5KW und harter Bremsung soll nach 500ms die Notauskette aufgehen.
Funktion Komperator: Bei mehr als 5KW und harter Bremsung soll nach 400ms LOW am Ausgang des Komperators kommen.
Funktion NE555: Nach einem LOW-Impuls vom Komperator, hat der Ausgang vom NE555 für ca. 10Sekunden High und durch das NICHT-Gatter High und sperrt den MOSFET für 10Sekunden
Abfolge Einschalten: CLR negativ -> Q negativ In dieser Zeit erfolgt Einschalten durch NE555 CLK wird über MOSFET nach Low gezogen D1 ist High CLR nach Zeit x auch high Durch öffnen Seitens der 5kW Erkennung gibt es Low->High Flanke an CLK Ausgang geht auf High -> Kann nie wieder zurückgesetzt werd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
VRELAY - 12V Steuerspannung für die AIR-Spulen und die Precharge-Spule nach TSMS Die beiden AIRs und Das Precharge-Relais werden seperat von dSpace angesteuert
VRELAY: Leitung zu den Erregerspulen AIR+, AIR-, Charge RELAY-X: Leitungen an den Spulenkontakten RELAYS-X: Status des entsprechenden Relays
1. LVMS_IN + 2. LVMS-OUT + 3. 12V_TO_LVMS + 14A 4. CAR+12VIN + 5. GROUND + 14A 6. 3.6V_FROM_BATTERY + 7. VRELAY + 8. RELAY-M + 9. RELAYS-M + 10. RELAY-P + 11. RELAYS-P + 12. RELAY/S-C + 13. GND_TO_DSPACE + 14. BMS-STATUS + 15. CANH + 16. CANL + 17. CHAIN-IN + 18. CHAIN-OUT +
Status-LED an LVMS_IN Kontakt zu HMI

Board: 4 copper layers, 564 parts (36 on the bottom side), 341 nets, no tracks yet.
