funkobongrip/sprbms/hardware/can/canSlaveV06a_nutzen.brd

## EAGLE design hardware/can/canSlaveV06a_nutzen.brd (2016-02-18)

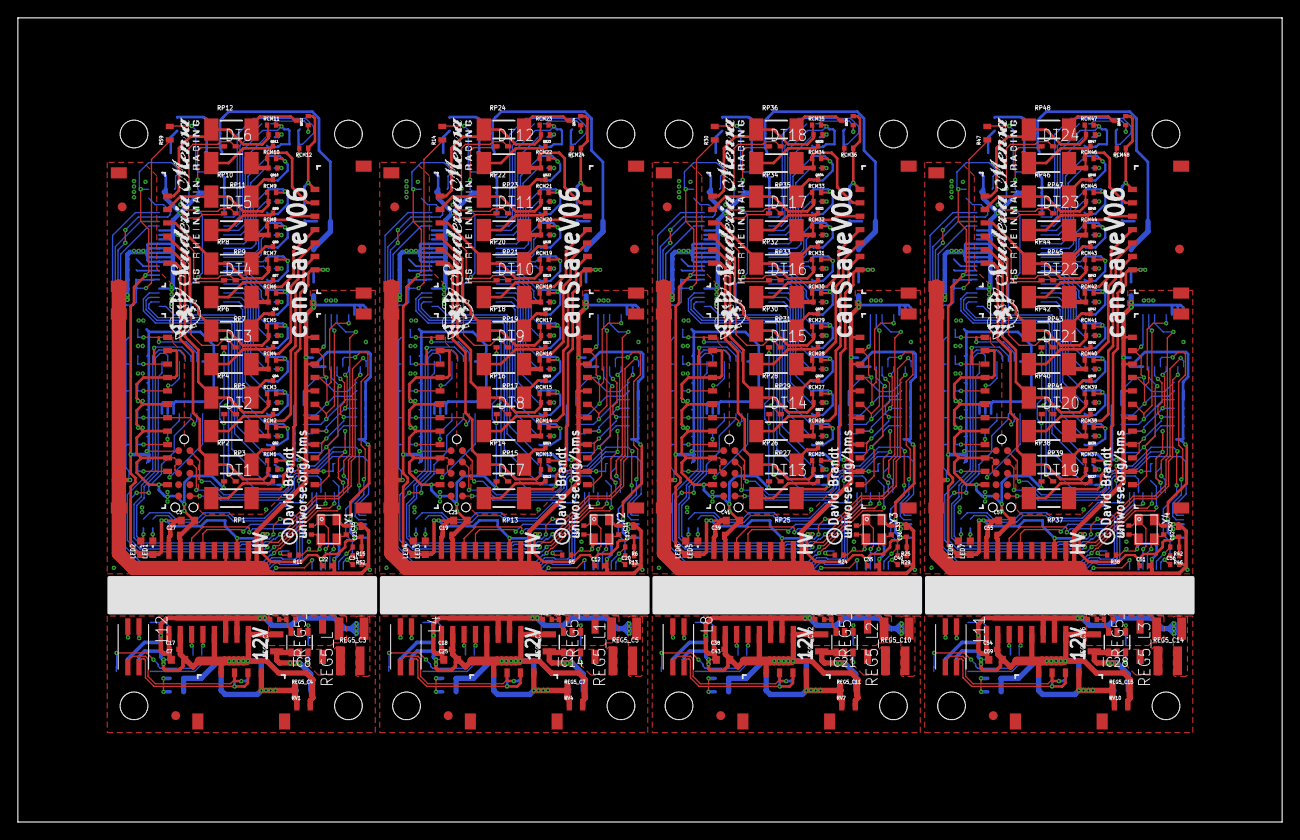
[picture p110: board canSlaveV06a_nutzen.brd from above]

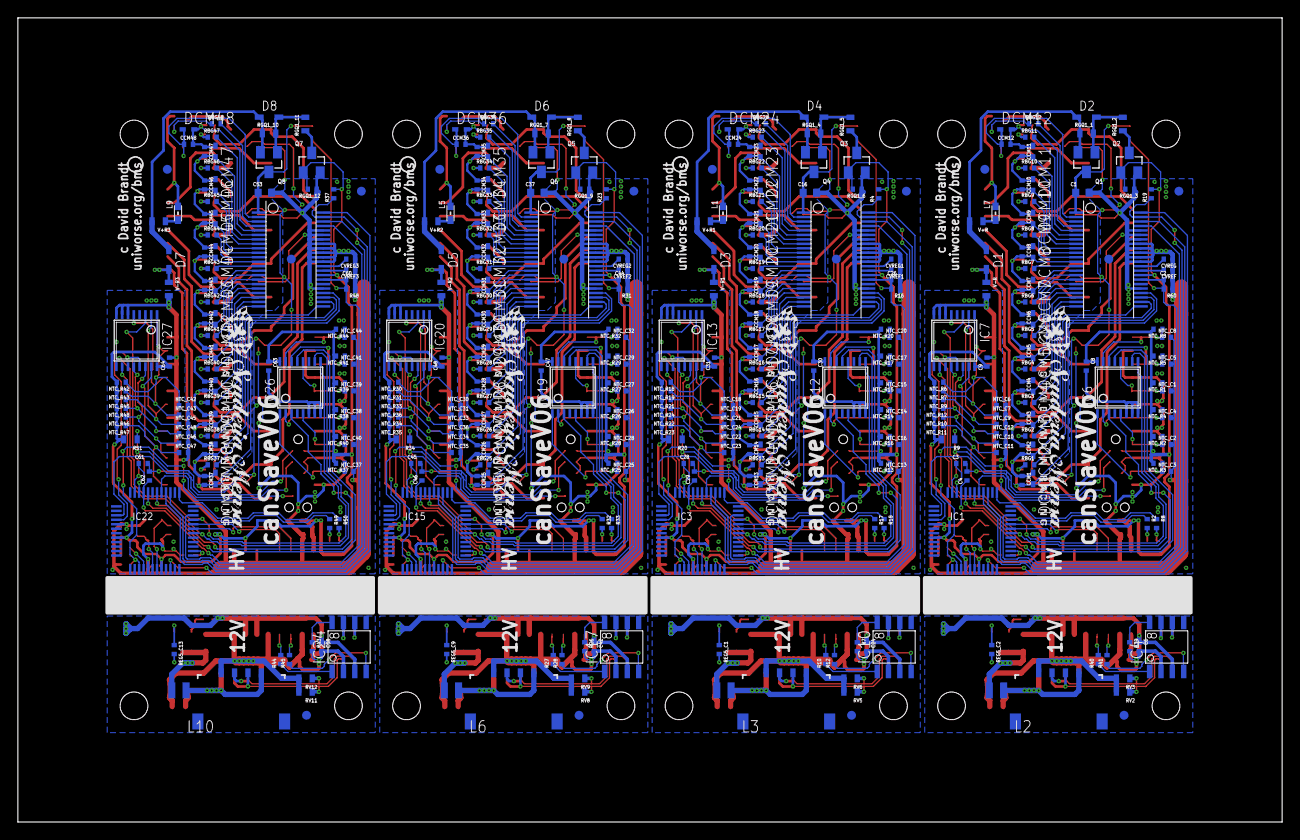
[picture p111: board canSlaveV06a_nutzen.brd from below]

Board: 2 copper layers, 141.5 x 90.0 mm, 724 parts (404 on the bottom side), 492 nets.

Parts:
C1, C16, C37, C53: 100n,100V; C0603
C2, C3, C4, C12, C13, C20, C22, C23, C26, C28, C29, C34, C35, C36, C40, C44, C45, C46, C51, C52, C56, C60, C61, C62: 100n; C0402
C5, C7, C21, C25, C41, C43, C57, C59: 10u,10V,X7R; C0603
C6, C8, C9, C17, C18, C19, C24, C27, C30, C31, C38, C39, C42, C47, C48, C54, C55, C58, C63, C64: 100n,>10V,X7R; C0402
C10, C11, C14, C15, C32, C33, C49, C50: 10p; C0402
CCM1, CCM2, CCM3, CCM4, CCM5, CCM6, CCM7, CCM8, CCM9, CCM10, CCM11, CCM12, CCM13, CCM14, CCM15, CCM16, CCM17, CCM18, CCM19, CCM20, CCM21, CCM22, CCM23, CCM24, CCM25, CCM26, CCM27, CCM28, CCM29, CCM30, CCM31, CCM32, CCM33, CCM34, CCM35, CCM36, CCM37, CCM38, CCM39, CCM40, CCM41, CCM42, CCM43, CCM44, CCM45, CCM46, CCM47, CCM48: 100n; C0402
CVREF, CVREF1, CVREF2, CVREF3: 1u; C0402
CVREG, CVREG1, CVREG2, CVREG3: 1u; C0402
D1, D3, D5, D7: 51V; SOD323-L
D2, D4, D6, D8: 12V; SOD323-L
DBG1, DBG2, DBG3, DBG4: JTAG10-TC2050-NL; TC2050-NL-JTORDER
DCM1, DCM2, DCM3, DCM4, DCM5, DCM6, DCM7, DCM8, DCM9, DCM10, DCM11, DCM12, DCM13, DCM14, DCM15, DCM16, DCM17, DCM18, DCM19, DCM20, DCM21, DCM22, DCM23, DCM24, DCM25, DCM26, DCM27, DCM28, DCM29, DCM30, DCM31, DCM32, DCM33, DCM34, DCM35, DCM36, DCM37, DCM38, DCM39, DCM40, DCM41, DCM42, DCM43, DCM44, DCM45, DCM46, DCM47, DCM48: 7.5; SOD523
DT1, DT2, DT3, DT4, DT5, DT6, DT7, DT8, DT9, DT10, DT11, DT12, DT13, DT14, DT15, DT16, DT17, DT18, DT19, DT20, DT21, DT22, DT23, DT24: 1PS79SB40; SOD523
FID1, FID2, FID3, FID4, FID5, FID6, FID7, FID8, FID9, FID10, FID11, FID12, FID13, FID14, FID15, FID16, FID17, FID18, FID19, FID20, FID21, FID22, FID23, FID24, FID25, FID26, FID27, FID28: FIDUCIAL""; FIDUCIAL_1MM
IC1, IC3, IC15, IC22: LPC11C14; LQFP48
IC2, IC9, IC16, IC23: LTC6803-4; 44SSOP
IC4, IC10, IC17, IC24: PCA82C251; SO-8
IC5, IC11, IC18, IC25: ADUM5201; SO16WB
IC6, IC7, IC12, IC13, IC19, IC20, IC26, IC27: 4052-TSSOP16; TSSOP16
IC8, IC14, IC21, IC28: LMR14203; SOT23-6
L1, L5, L7, L9: WE-CBF,742792664; 0603
L2, L3, L6, L10: WE-PMI/74479776233A; WE-PMI_0806
L4, L8, L11, L12: 744242101; WE-SLM
LED1, LED3, LED5, LED7: GRN; CHIPLED_0603
LED2, LED4, LED6, LED8: RED; CHIPLED_0603
NTC_C1, NTC_C2, NTC_C3, NTC_C4, NTC_C5, NTC_C6, NTC_C7, NTC_C8, NTC_C9, NTC_C10, NTC_C11, NTC_C12, NTC_C13, NTC_C14, NTC_C15, NTC_C16, NTC_C17, NTC_C18, NTC_C19, NTC_C20, NTC_C21, NTC_C22, NTC_C23, NTC_C24, NTC_C25, NTC_C26, NTC_C27, NTC_C28, NTC_C29, NTC_C30, NTC_C31, NTC_C32, NTC_C33, NTC_C34, NTC_C35, NTC_C36, NTC_C37, NTC_C38, NTC_C39, NTC_C40, NTC_C41, NTC_C42, NTC_C43, NTC_C44, NTC_C45, NTC_C46, NTC_C47, NTC_C48: 1u; C0402
NTC_R1, NTC_R2, NTC_R3, NTC_R4, NTC_R5, NTC_R6, NTC_R7, NTC_R8, NTC_R9, NTC_R10, NTC_R11, NTC_R12, NTC_R13, NTC_R14, NTC_R15, NTC_R16, NTC_R17, NTC_R18, NTC_R19, NTC_R20, NTC_R21, NTC_R22, NTC_R23, NTC_R24, NTC_R25, NTC_R26, NTC_R27, NTC_R28, NTC_R29, NTC_R30, NTC_R31, NTC_R32, NTC_R33, NTC_R34, NTC_R35, NTC_R36, NTC_R37, NTC_R38, NTC_R39, NTC_R40, NTC_R41, NTC_R42, NTC_R43, NTC_R44, NTC_R45, NTC_R46, NTC_R47, NTC_R48: 10k; R0402
Q1, Q4, Q6, Q8: BSS84; SOT23
Q2, Q3, Q5, Q7: 2N7002; SOT23
QB1, QB2, QB3, QB4, QB5, QB6, QB7, QB8, QB9, QB10, QB11, QB12, QB13, QB14, QB15, QB16, QB17, QB18, QB19, QB20, QB21, QB22, QB23, QB24, QB25, QB26, QB27, QB28, QB29, QB30, QB31, QB32, QB33, QB34, QB35, QB36, QB37, QB38, QB39, QB40, QB41, QB42, QB43, QB44, QB45, QB46, QB47, QB48: BSS84AKT; SOT416
R1, R21, R35, R53: 5.62k; R0402
R2, R8, R17, R18, R32, R33, R49, R50: 1k; R0402
R3, R22, R36, R54: 1.02k; R0402
R4, R19, R23, R37: 4.7k; R0402
R5, R6, R11, R13, R15, R24, R25, R29, R38, R42, R46, R52: 10k; R0402
R7, R26, R39, R43: 0; R0402
R9, R20, R34, R51: 3.3k; R0603
R10, R12, R27, R28, R40, R41, R44, R45: 100; R0402
R14, R30, R47, R59: 332k0.1%; R0603
R16, R31, R48, R60: 20k0.1%; R0402
RBG1, RBG2, RBG3, RBG4, RBG5, RBG6, RBG7, RBG8, RBG9, RBG10, RBG11, RBG12, RBG13, RBG14, RBG15, RBG16, RBG17, RBG18, RBG19, RBG20, RBG21, RBG22, RBG23, RBG24, RBG25, RBG26, RBG27, RBG28, RBG29, RBG30, RBG31, RBG32, RBG33, RBG34, RBG35, RBG36, RBG37, RBG38, RBG39, RBG40, RBG41, RBG42, RBG43, RBG44, RBG45, RBG46, RBG47, RBG48: 3.3k; R0402
RCM1, RCM2, RCM3, RCM4, RCM5, RCM6, RCM7, RCM8, RCM9, RCM10, RCM11, RCM12, RCM13, RCM14, RCM15, RCM16, RCM17, RCM18, RCM19, RCM20, RCM21, RCM22, RCM23, RCM24, RCM25, RCM26, RCM27, RCM28, RCM29, RCM30, RCM31, RCM32, RCM33, RCM34, RCM35, RCM36, RCM37, RCM38, RCM39, RCM40, RCM41, RCM42, RCM43, RCM44, RCM45, RCM46, RCM47, RCM48: 100; R0402
REG5_C1, REG5_C2, REG5_C9, REG5_C13: 100n,>=25V,>=X5R; C0402
REG5_C3, REG5_C5, REG5_C10, REG5_C14: 47u,10V,X7R; C1210
REG5_C4, REG5_C6, REG5_C7, REG5_C8, REG5_C11, REG5_C12, REG5_C15, REG5_C16: 2.2u,50V,X7R; C0805
REG5_D1, REG5_D2, REG5_D3, REG5_D4: PMEG6010CEH; SOD123
REG5_L, REG5_L1, REG5_L2, REG5_L3: 744025100; WE-TPC_2828
RGQ1_1, RGQ1_4, RGQ1_7, RGQ1_10: 1M,50V; R0603
RGQ1_2, RGQ1_5, RGQ1_8, RGQ1_11: 100k,50V; R0603
RGQ1_3, RGQ1_6, RGQ1_9, RGQ1_12: 1M; R0402
RP1, RP2, RP3, RP4, RP5, RP6, RP7, RP8, RP9, RP10, RP11, RP12, RP13, RP14, RP15, RP16, RP17, RP18, RP19, RP20, RP21, RP22, RP23, RP24, RP25, RP26, RP27, RP28, RP29, RP30, RP31, RP32, RP33, RP34, RP35, RP36, RP37, RP38, RP39, RP40, RP41, RP42, RP43, RP44, RP45, RP46, RP47, RP48: 22; MINI_MELF-0207R
RV1, RV2, RV3, RV4, RV5, RV6, RV7, RV8, RV9, RV10, RV11, RV12: 24V; R0603
U$1, U$3, U$5, U$7: SMLOGOS_BSILK
U$2, U$4, U$6, U$8: SMLOGOS_SILK
V+R, V+R1, V+R2, V+R3: 100; R0603
V-R, V-R1, V-R2, V-R3: 100; R0603
X1, X8, X14, X20: 504050-0791
X2, X7, X13, X19: 504050-0691
X3, X4, X11, X12, X17, X18, X23, X24: 504050-0491
X5, X6, X9, X10, X15, X16, X21, X22: 504050-1291
Y1, Y2, Y3, Y4: 12Mhz; MT

Connections:
!RESET: C34.1, DBG1.10, IC1.3, R52.2
!RESET1: C20.1, DBG2.10, IC3.3, R13.2
!RESET2: C40.1, DBG3.10, IC15.3, R29.2
!RESET3: C56.1, DBG4.10, IC22.3, R46.2
+3V1: C12.1, C13.1, C19.1, C21.1, C30.1, C31.1, DBG2.1, IC3.8, IC3.44, IC9.30, IC11.P$10, IC11.P$16, IC12.16, IC13.16, LED3.A, LED4.A, NTC_R13.2, NTC_R14.2, NTC_R15.2, NTC_R16.2, NTC_R17.2, NTC_R18.2, NTC_R19.2, NTC_R20.2, NTC_R21.2, NTC_R22.2, NTC_R23.2, NTC_R24.2, Q3.1, R4.2, R6.1, R13.1, R20.2, RGQ1_6.2
+3V2: C35.1, C36.1, C39.1, C41.1, C47.1, C48.1, DBG3.1, IC15.8, IC15.44, IC16.30, IC18.P$10, IC18.P$16, IC19.16, IC20.16, LED5.A, LED6.A, NTC_R25.2, NTC_R26.2, NTC_R27.2, NTC_R28.2, NTC_R29.2, NTC_R30.2, NTC_R31.2, NTC_R32.2, NTC_R33.2, NTC_R34.2, NTC_R35.2, NTC_R36.2, Q5.1, R23.2, R25.1, R29.1, R34.2, RGQ1_9.2
+3V3: C5.1, C8.1, C9.1, C22.1, C23.1, C27.1, DBG1.1, IC1.8, IC1.44, IC2.30, IC5.P$10, IC5.P$16, IC6.16, IC7.16, LED1.A, LED2.A, NTC_R1.2, NTC_R2.2, NTC_R3.2, NTC_R4.2, NTC_R5.2, NTC_R6.2, NTC_R7.2, NTC_R8.2, NTC_R9.2, NTC_R10.2, NTC_R11.2, NTC_R12.2, Q2.1, R9.2, R15.1, R19.2, R52.1, RGQ1_3.2
+3V4: C51.1, C52.1, C55.1, C57.1, C63.1, C64.1, DBG4.1, IC22.8, IC22.44, IC23.30, IC25.P$10, IC25.P$16, IC26.16, IC27.16, LED7.A, LED8.A, NTC_R37.2, NTC_R38.2, NTC_R39.2, NTC_R40.2, NTC_R41.2, NTC_R42.2, NTC_R43.2, NTC_R44.2, NTC_R45.2, NTC_R46.2, NTC_R47.2, NTC_R48.2, Q7.1, R37.2, R42.1, R46.1, R51.2, RGQ1_12.2
BAL1: IC2.25, RBG1.2
BAL2: IC2.23, RBG2.2
BAL3: IC2.21, RBG3.2
BAL4: IC2.19, RBG4.2
BAL5: IC2.17, RBG5.2
BAL6: IC2.15, RBG6.2
BAL7: IC2.13, RBG7.2
BAL8: IC2.11, RBG8.2
BAL9: IC2.9, RBG9.2
BAL10: IC2.7, RBG10.2
BAL11: IC2.5, RBG11.2
BAL12: IC2.3, RBG12.2
BAL13: IC9.25, RBG13.2
BAL14: IC9.23, RBG14.2
BAL15: IC9.21, RBG15.2
BAL16: IC9.19, RBG16.2
BAL17: IC9.17, RBG17.2
BAL18: IC9.15, RBG18.2
BAL19: IC9.13, RBG19.2
BAL20: IC9.11, RBG20.2
BAL21: IC9.9, RBG21.2
BAL22: IC9.7, RBG22.2
BAL23: IC9.5, RBG23.2
BAL24: IC9.3, RBG24.2
BAL25: IC16.25, RBG25.2
BAL26: IC16.23, RBG26.2
BAL27: IC16.21, RBG27.2
BAL28: IC16.19, RBG28.2
BAL29: IC16.17, RBG29.2
BAL30: IC16.15, RBG30.2
BAL31: IC16.13, RBG31.2
BAL32: IC16.11, RBG32.2
BAL33: IC16.9, RBG33.2
BAL34: IC16.7, RBG34.2
BAL35: IC16.5, RBG35.2
BAL36: IC16.3, RBG36.2
BAL37: IC23.25, RBG37.2
BAL38: IC23.23, RBG38.2
BAL39: IC23.21, RBG39.2
BAL40: IC23.19, RBG40.2
BAL41: IC23.17, RBG41.2
BAL42: IC23.15, RBG42.2
BAL43: IC23.13, RBG43.2
BAL44: IC23.11, RBG44.2
BAL45: IC23.9, RBG45.2
BAL46: IC23.7, RBG46.2
BAL47: IC23.5, RBG47.2
BAL48: IC23.3, RBG48.2
BOOST1: IC8.1, REG5_C2.1
BOOST2: IC14.1, REG5_C1.1
BOOST3: IC21.1, REG5_C9.1
BOOST4: IC28.1, REG5_C13.1
C0: CCM1.2, D1.A, DCM1.A, IC2.26, RP1.1, V-R.1, X1.7
C1: QB1.2, RCM1.1, RP2.1, X2.1
C1M: CCM1.1, CCM2.2, DCM1.C, DCM2.A, IC2.24, RCM1.2
C1M1: CCM13.1, CCM14.2, DCM13.C, DCM14.A, IC9.24, RCM13.2
C1M2: CCM25.1, CCM26.2, DCM25.C, DCM26.A, IC16.24, RCM25.2
C1M3: CCM37.1, CCM38.2, DCM37.C, DCM38.A, IC23.24, RCM37.2
C2: QB2.2, RCM2.1, RP3.1, X1.6
C2M: CCM2.1, CCM3.2, DCM2.C, DCM3.A, IC2.22, RCM2.2
C2M1: CCM14.1, CCM15.2, DCM14.C, DCM15.A, IC9.22, RCM14.2
C2M2: CCM26.1, CCM27.2, DCM26.C, DCM27.A, IC16.22, RCM26.2
C2M3: CCM38.1, CCM39.2, DCM38.C, DCM39.A, IC23.22, RCM38.2
C3: QB3.2, RCM3.1, RP4.1, X2.2
C3M: CCM3.1, CCM4.2, DCM3.C, DCM4.A, IC2.20, RCM3.2
C3M1: CCM15.1, CCM16.2, DCM15.C, DCM16.A, IC9.20, RCM15.2
C3M2: CCM27.1, CCM28.2, DCM27.C, DCM28.A, IC16.20, RCM27.2
C3M3: CCM39.1, CCM40.2, DCM39.C, DCM40.A, IC23.20, RCM39.2
C4: QB4.2, RCM4.1, RP5.1, X1.5
C4M: CCM4.1, CCM5.2, DCM4.C, DCM5.A, IC2.18, RCM4.2
C4M1: CCM16.1, CCM17.2, DCM16.C, DCM17.A, IC9.18, RCM16.2
C4M2: CCM28.1, CCM29.2, DCM28.C, DCM29.A, IC16.18, RCM28.2
C4M3: CCM40.1, CCM41.2, DCM40.C, DCM41.A, IC23.18, RCM40.2
C5: QB5.2, RCM5.1, RP6.1, X2.3
C5M: CCM5.1, CCM6.2, DCM5.C, DCM6.A, IC2.16, RCM5.2
C5M1: CCM17.1, CCM18.2, DCM17.C, DCM18.A, IC9.16, RCM17.2
C5M2: CCM29.1, CCM30.2, DCM29.C, DCM30.A, IC16.16, RCM29.2
C5M3: CCM41.1, CCM42.2, DCM41.C, DCM42.A, IC23.16, RCM41.2
C6: QB6.2, RCM6.1, RP7.1, X1.4
C6M: CCM6.1, CCM7.2, DCM6.C, DCM7.A, IC2.14, RCM6.2
C6M1: CCM18.1, CCM19.2, DCM18.C, DCM19.A, IC9.14, RCM18.2
C6M2: CCM30.1, CCM31.2, DCM30.C, DCM31.A, IC16.14, RCM30.2
C6M3: CCM42.1, CCM43.2, DCM42.C, DCM43.A, IC23.14, RCM42.2
C7: QB7.2, RCM7.1, RP8.1, X2.4
C7M: CCM7.1, CCM8.2, DCM7.C, DCM8.A, IC2.12, RCM7.2
C7M1: CCM19.1, CCM20.2, DCM19.C, DCM20.A, IC9.12, RCM19.2
C7M2: CCM31.1, CCM32.2, DCM31.C, DCM32.A, IC16.12, RCM31.2
C7M3: CCM43.1, CCM44.2, DCM43.C, DCM44.A, IC23.12, RCM43.2
C8: QB8.2, RCM8.1, RP9.1, X1.3
C8M: CCM8.1, CCM9.2, DCM8.C, DCM9.A, IC2.10, RCM8.2
C8M1: CCM20.1, CCM21.2, DCM20.C, DCM21.A, IC9.10, RCM20.2
C8M2: CCM32.1, CCM33.2, DCM32.C, DCM33.A, IC16.10, RCM32.2
C8M3: CCM44.1, CCM45.2, DCM44.C, DCM45.A, IC23.10, RCM44.2
C9: QB9.2, RCM9.1, RP10.1, X2.5
C9M: CCM9.1, CCM10.2, DCM9.C, DCM10.A, IC2.8, RCM9.2
C9M1: CCM21.1, CCM22.2, DCM21.C, DCM22.A, IC9.8, RCM21.2
C9M2: CCM33.1, CCM34.2, DCM33.C, DCM34.A, IC16.8, RCM33.2
C9M3: CCM45.1, CCM46.2, DCM45.C, DCM46.A, IC23.8, RCM45.2
C10: QB10.2, RCM10.1, RP11.1, X1.2
C10M: CCM10.1, CCM11.2, DCM10.C, DCM11.A, IC2.6, RCM10.2
C10M1: CCM22.1, CCM23.2, DCM22.C, DCM23.A, IC9.6, RCM22.2
C10M2: CCM34.1, CCM35.2, DCM34.C, DCM35.A, IC16.6, RCM34.2
C10M3: CCM46.1, CCM47.2, DCM46.C, DCM47.A, IC23.6, RCM46.2
C11: QB11.2, RCM11.1, RP12.1, X2.6
C11M: CCM11.1, CCM12.2, DCM11.C, DCM12.A, IC2.4, RCM11.2
C11M1: CCM23.1, CCM24.2, DCM23.C, DCM24.A, IC9.4, RCM23.2
C11M2: CCM35.1, CCM36.2, DCM35.C, DCM36.A, IC16.4, RCM35.2
C11M3: CCM47.1, CCM48.2, DCM47.C, DCM48.A, IC23.4, RCM47.2
C12: L7.1, QB12.2, RCM12.1, X1.1
C12FILT: L7.2, V+R.1
C12FILT1: L1.2, V+R1.1
C12FILT2: L5.2, V+R2.1
C12FILT3: L9.2, V+R3.1
C12M: CCM12.1, DCM12.C, IC2.2, RCM12.2
C12M1: CCM24.1, DCM24.C, IC9.2, RCM24.2
C12M2: CCM36.1, DCM36.C, IC16.2, RCM36.2
C12M3: CCM48.1, DCM48.C, IC23.2, RCM48.2
C13: CCM13.2, D3.A, DCM13.A, IC9.26, RP13.1, V-R1.1, X8.7
C14: QB20.2, RCM20.1, RP21.1, X8.3
C15: QB14.2, RCM14.1, RP15.1, X8.6
C16: QB13.2, RCM13.1, RP14.1, X7.1
C17: QB15.2, RCM15.1, RP16.1, X7.2
C18: QB16.2, RCM16.1, RP17.1, X8.5
C19: QB17.2, RCM17.1, RP18.1, X7.3
C20: QB18.2, RCM18.1, RP19.1, X8.4
C21: QB19.2, RCM19.1, RP20.1, X7.4
C22: QB21.2, RCM21.1, RP22.1, X7.5
C23: QB22.2, RCM22.1, RP23.1, X8.2
C24: QB23.2, RCM23.1, RP24.1, X7.6
C25: L1.1, QB24.2, RCM24.1, X8.1
C26: CCM25.2, D5.A, DCM25.A, IC16.26, RP25.1, V-R2.1, X14.7
C27: QB32.2, RCM32.1, RP33.1, X14.3
C28: QB26.2, RCM26.1, RP27.1, X14.6
C29: QB25.2, RCM25.1, RP26.1, X13.1
C30: QB27.2, RCM27.1, RP28.1, X13.2
C31: QB28.2, RCM28.1, RP29.1, X14.5
C32: QB29.2, RCM29.1, RP30.1, X13.3
C33: QB30.2, RCM30.1, RP31.1, X14.4
C34: QB31.2, RCM31.1, RP32.1, X13.4
C35: QB33.2, RCM33.1, RP34.1, X13.5
C36: QB34.2, RCM34.1, RP35.1, X14.2
C37: QB35.2, RCM35.1, RP36.1, X13.6
C38: L5.1, QB36.2, RCM36.1, X14.1
C39: CCM37.2, D7.A, DCM37.A, IC23.26, RP37.1, V-R3.1, X20.7
C40: QB44.2, RCM44.1, RP45.1, X20.3
C41: QB38.2, RCM38.1, RP39.1, X20.6
C42: QB37.2, RCM37.1, RP38.1, X19.1
C43: QB39.2, RCM39.1, RP40.1, X19.2
C44: QB40.2, RCM40.1, RP41.1, X20.5
C45: QB41.2, RCM41.1, RP42.1, X19.3
C46: QB42.2, RCM42.1, RP43.1, X20.4
C47: QB43.2, RCM43.1, RP44.1, X19.4
C48: QB45.2, RCM45.1, RP46.1, X19.5
C49: QB46.2, RCM46.1, RP47.1, X20.2
C50: QB47.2, RCM47.1, RP48.1, X19.6
C51: L9.1, QB48.2, RCM48.1, X20.1
CANH: L12.4, RV2.1, X3.2, X4.2
CANH1: L4.4, RV5.1, X11.2, X12.2
CANH2: L8.4, RV8.1, X17.2, X18.2
CANH3: L11.4, RV11.1, X23.2, X24.2
CANL: L12.3, RV3.1, X3.3, X4.3
CANL1: L4.3, RV6.1, X11.3, X12.3
CANL2: L8.3, RV9.1, X17.3, X18.3
CANL3: L11.3, RV12.1, X23.3, X24.3
CANRX: IC1.19, IC5.P$14
CANRX1: IC3.19, IC11.P$14
CANRX2: IC15.19, IC18.P$14
CANRX3: IC22.19, IC25.P$14
CANTX: IC1.20, IC5.P$13
CANTX1: IC3.20, IC11.P$13
CANTX2: IC15.20, IC18.P$13
CANTX3: IC22.20, IC25.P$13
CAR+5V: C6.1, C7.1, C17.1, IC4.3, IC5.P$1, IC5.P$6, IC5.P$7, R1.1, REG5_C3.1, REG5_L.2
CAR+5V1: C18.1, C24.1, C25.1, IC10.3, IC11.P$1, IC11.P$6, IC11.P$7, R21.1, REG5_C5.1, REG5_L1.2
CAR+5V2: C38.1, C42.1, C43.1, IC17.3, IC18.P$1, IC18.P$6, IC18.P$7, R35.1, REG5_C10.1, REG5_L2.2
CAR+5V3: C54.1, C58.1, C59.1, IC24.3, IC25.P$1, IC25.P$6, IC25.P$7, R53.1, REG5_C14.1, REG5_L3.2
CARGND: C6.2, C7.2, C17.2, IC4.2, IC5.P$2, IC5.P$5, IC5.P$8, IC8.2, R3.2, R39.2, REG5_C3.2, REG5_C4.2, REG5_C6.2, REG5_D2.2, RV1.2, RV2.2, RV3.2, X3.4, X4.4
CARGND1: C18.2, C24.2, C25.2, IC10.2, IC11.P$2, IC11.P$5, IC11.P$8, IC14.2, R7.2, R22.2, REG5_C5.2, REG5_C7.2, REG5_C8.2, REG5_D1.2, RV4.2, RV5.2, RV6.2, X11.4, X12.4
CARGND2: C38.2, C42.2, C43.2, IC17.2, IC18.P$2, IC18.P$5, IC18.P$8, IC21.2, R26.2, R36.2, REG5_C10.2, REG5_C11.2, REG5_C12.2, REG5_D3.2, RV7.2, RV8.2, RV9.2, X17.4, X18.4
CARGND3: C54.2, C58.2, C59.2, IC24.2, IC25.P$2, IC25.P$5, IC25.P$8, IC28.2, R43.2, R54.2, REG5_C14.2, REG5_C15.2, REG5_C16.2, REG5_D4.2, RV10.2, RV11.2, RV12.2, X23.4, X24.4
CARVIN: L2.1, REG5_C4.1, RV1.1, X3.1, X4.1
CARVIN1: L3.1, REG5_C7.1, RV4.1, X11.1, X12.1
CARVIN2: L6.1, REG5_C11.1, RV7.1, X17.1, X18.1
CARVIN3: L10.1, REG5_C15.1, RV10.1, X23.1, X24.1
CARVINFILT: IC8.4, IC8.5, L2.2, REG5_C6.1
CARVINFILT1: IC14.4, IC14.5, L3.2, REG5_C8.1
CARVINFILT2: IC21.4, IC21.5, L6.2, REG5_C12.1
CARVINFILT3: IC28.4, IC28.5, L10.2, REG5_C16.1
CAR_CANRX: IC5.P$3, R41.2
CAR_CANRX1: IC11.P$3, R12.2
CAR_CANRX2: IC18.P$3, R28.2
CAR_CANRX3: IC25.P$3, R45.2
CAR_CANRX_T: IC4.4, R41.1
CAR_CANRX_T1: IC10.4, R12.1
CAR_CANRX_T2: IC17.4, R28.1
CAR_CANRX_T3: IC24.4, R45.1
CAR_CANTX: IC5.P$4, R40.2
CAR_CANTX1: IC11.P$4, R10.2
CAR_CANTX2: IC18.P$4, R27.2
CAR_CANTX3: IC25.P$4, R44.2
CAR_CANTX_T: IC4.1, R40.1
CAR_CANTX_T1: IC10.1, R10.1
CAR_CANTX_T2: IC17.1, R27.1
CAR_CANTX_T3: IC24.1, R44.1
CR1: QB1.3, RP1.2
CR2: QB2.3, RP2.2
CR3: QB3.3, RP3.2
CR4: QB4.3, RP4.2
CR5: QB5.3, RP5.2
CR6: QB6.3, RP6.2
CR7: QB7.3, RP7.2
CR8: QB8.3, RP8.2
CR9: QB9.3, RP9.2
CR10: QB10.3, RP10.2
CR11: QB11.3, RP11.2
CR12: QB12.3, RP12.2
CR13: QB13.3, RP13.2
CR14: QB14.3, RP14.2
CR15: QB15.3, RP15.2
CR16: QB16.3, RP16.2
CR17: QB17.3, RP17.2
CR18: QB18.3, RP18.2
CR19: QB19.3, RP19.2
CR20: QB20.3, RP20.2
CR21: QB21.3, RP21.2
CR22: QB22.3, RP22.2
CR23: QB23.3, RP23.2
CR24: QB24.3, RP24.2
CR25: QB25.3, RP25.2
CR26: QB26.3, RP26.2
CR27: QB27.3, RP27.2
CR28: QB28.3, RP28.2
CR29: QB29.3, RP29.2
CR30: QB30.3, RP30.2
CR31: QB31.3, RP31.2
CR32: QB32.3, RP32.2
CR33: QB33.3, RP33.2
CR34: QB34.3, RP34.2
CR35: QB35.3, RP35.2
CR36: QB36.3, RP36.2
CR37: QB37.3, RP37.2
CR38: QB38.3, RP38.2
CR39: QB39.3, RP39.2
CR40: QB40.3, RP40.2
CR41: QB41.3, RP41.2
CR42: QB42.3, RP42.2
CR43: QB43.3, RP43.2
CR44: QB44.3, RP44.2
CR45: QB45.3, RP45.2
CR46: QB46.3, RP46.2
CR47: QB47.3, RP47.2
CR48: QB48.3, RP48.2
FSM: C2.1, C4.1, IC1.33, IC2.29, R59.1, R60.2
FSM1: C26.1, C29.1, IC3.33, IC9.29, R14.1, R16.2
FSM2: C44.1, C46.1, IC15.33, IC16.29, R30.1, R31.2
FSM3: C60.1, C62.1, IC22.33, IC23.29, R47.1, R48.2
GND: C1.2, C2.2, C3.2, C4.2, C5.2, C8.2, C9.2, C14.1, C15.1, C22.2, C23.2, C27.2, C34.2, CVREF.1, CVREG.1, DBG1.3, DBG1.5, DT1.C, DT2.C, DT3.C, DT4.C, DT5.C, DT6.C, IC1.5, IC1.41, IC2.27, IC2.33, IC2.34, IC2.35, IC2.36, IC2.37, IC2.38, IC2.39, IC2.40, IC5.P$9, IC5.P$11, IC5.P$15, IC6.6, IC6.7, IC6.8, IC7.6, IC7.7, IC7.8, NTC_C1.2, NTC_C2.2, NTC_C3.2, NTC_C4.2, NTC_C5.2, NTC_C6.2, NTC_C7.2, NTC_C8.2, NTC_C9.2, NTC_C10.2, NTC_C11.2, NTC_C12.2, Q2.2, R11.1, R60.1, RGQ1_3.1, V-R.2, X2.P1, X5.1, X5.3, X5.5, X5.7, X5.9, X5.11, X5.P1, X5.P2, X6.1, X6.3, X6.5, X6.7, X6.9, X6.11, Y1.P2, Y1.P4
GND1: C10.1, C11.1, C12.2, C13.2, C16.2, C19.2, C20.2, C21.2, C26.2, C28.2, C29.2, C30.2, C31.2, CVREF1.1, CVREG1.1, DBG2.3, DBG2.5, DT7.C, DT8.C, DT9.C, DT10.C, DT11.C, DT12.C, IC3.5, IC3.41, IC9.27, IC9.33, IC9.34, IC9.35, IC9.36, IC9.37, IC9.38, IC9.39, IC9.40, IC11.P$9, IC11.P$11, IC11.P$15, IC12.6, IC12.7, IC12.8, IC13.6, IC13.7, IC13.8, NTC_C13.2, NTC_C14.2, NTC_C15.2, NTC_C16.2, NTC_C17.2, NTC_C18.2, NTC_C19.2, NTC_C20.2, NTC_C21.2, NTC_C22.2, NTC_C23.2, NTC_C24.2, Q3.2, R5.1, R16.1, RGQ1_6.1, V-R1.2, X7.P1, X9.1, X9.3, X9.5, X9.7, X9.9, X9.11, X9.P1, X9.P2, X10.1, X10.3, X10.5, X10.7, X10.9, X10.11, Y2.P2, Y2.P4
GND2: C32.1, C33.1, C35.2, C36.2, C37.2, C39.2, C40.2, C41.2, C44.2, C45.2, C46.2, C47.2, C48.2, CVREF2.1, CVREG2.1, DBG3.3, DBG3.5, DT13.C, DT14.C, DT15.C, DT16.C, DT17.C, DT18.C, IC15.5, IC15.41, IC16.27, IC16.33, IC16.34, IC16.35, IC16.36, IC16.37, IC16.38, IC16.39, IC16.40, IC18.P$9, IC18.P$11, IC18.P$15, IC19.6, IC19.7, IC19.8, IC20.6, IC20.7, IC20.8, NTC_C25.2, NTC_C26.2, NTC_C27.2, NTC_C28.2, NTC_C29.2, NTC_C30.2, NTC_C31.2, NTC_C32.2, NTC_C33.2, NTC_C34.2, NTC_C35.2, NTC_C36.2, Q5.2, R24.1, R31.1, RGQ1_9.1, V-R2.2, X13.P1, X15.1, X15.3, X15.5, X15.7, X15.9, X15.11, X15.P1, X15.P2, X16.1, X16.3, X16.5, X16.7, X16.9, X16.11, Y3.P2, Y3.P4
GND3: C49.1, C50.1, C51.2, C52.2, C53.2, C55.2, C56.2, C57.2, C60.2, C61.2, C62.2, C63.2, C64.2, CVREF3.1, CVREG3.1, DBG4.3, DBG4.5, DT19.C, DT20.C, DT21.C, DT22.C, DT23.C, DT24.C, IC22.5, IC22.41, IC23.27, IC23.33, IC23.34, IC23.35, IC23.36, IC23.37, IC23.38, IC23.39, IC23.40, IC25.P$9, IC25.P$11, IC25.P$15, IC26.6, IC26.7, IC26.8, IC27.6, IC27.7, IC27.8, NTC_C37.2, NTC_C38.2, NTC_C39.2, NTC_C40.2, NTC_C41.2, NTC_C42.2, NTC_C43.2, NTC_C44.2, NTC_C45.2, NTC_C46.2, NTC_C47.2, NTC_C48.2, Q7.2, R38.1, R48.1, RGQ1_12.1, V-R3.2, X19.P1, X21.1, X21.3, X21.5, X21.7, X21.9, X21.11, X21.P1, X21.P2, X22.1, X22.3, X22.5, X22.7, X22.9, X22.11, Y4.P2, Y4.P4
ISP_CAN: IC1.14, R11.2
ISP_CAN1: IC3.14, R5.2
ISP_CAN2: IC15.14, R24.2
ISP_CAN3: IC22.14, R38.2
ISP_ENTER: IC1.4, R15.2
ISP_ENTER1: IC3.4, R6.2
ISP_ENTER2: IC15.4, R25.2
ISP_ENTER3: IC22.4, R42.2
LED1: IC1.24, R2.1
LED1C: LED1.C, R2.2
LED1C1: LED3.C, R17.2
LED1C2: LED5.C, R32.2
LED1C3: LED7.C, R49.2
LED2: IC1.25, R8.1
LED2C: LED2.C, R8.2
LED2C1: LED4.C, R18.2
LED2C2: LED6.C, R33.2
LED2C3: LED8.C, R50.2
LED3: IC3.24, R17.1
LED4: IC3.25, R18.1
LED5: IC15.24, R32.1
LED6: IC15.25, R33.1
LED7: IC22.24, R49.1
LED8: IC22.25, R50.1
MISO0: IC1.27, IC2.43, R19.1
MISO3: IC3.27, IC9.43, R4.1
MISO5: IC15.27, IC16.43, R23.1
MISO7: IC22.27, IC23.43, R37.1
MOSI0: IC1.28, IC2.42
MOSI3: IC3.28, IC9.42
MOSI5: IC15.28, IC16.42
MOSI7: IC22.28, IC23.42
unnamed: IC8.3, R1.2, R3.1
unnamed: IC4.7, L12.1
unnamed: IC10.7, L4.1
unnamed: IC10.6, L4.2
unnamed: IC14.3, R21.2, R22.1
unnamed: IC4.6, L12.2
unnamed: IC17.7, L8.1
unnamed: IC17.6, L8.2
unnamed: IC21.3, R35.2, R36.1
unnamed: IC24.7, L11.1
unnamed: IC24.6, L11.2
unnamed: IC28.3, R53.2, R54.1
Q1G: D2.A, Q1.1, RGQ1_1.2, RGQ1_2.2
Q1G1: D4.A, Q4.1, RGQ1_4.2, RGQ1_5.2
Q1G2: D6.A, Q6.1, RGQ1_7.2, RGQ1_8.2
Q1G3: D8.A, Q8.1, RGQ1_10.2, RGQ1_11.2
Q1GR: Q2.3, RGQ1_2.1
Q1GR1: Q3.3, RGQ1_5.1
Q1GR2: Q5.3, RGQ1_8.1
Q1GR3: Q7.3, RGQ1_11.1
QBG1: QB1.1, RBG1.1
QBG2: QB2.1, RBG2.1
QBG3: QB3.1, RBG3.1
QBG4: QB4.1, RBG4.1
QBG5: QB5.1, RBG5.1
QBG6: QB6.1, RBG6.1
QBG7: QB7.1, RBG7.1
QBG8: QB8.1, RBG8.1
QBG9: QB9.1, RBG9.1
QBG10: QB10.1, RBG10.1
QBG11: QB11.1, RBG11.1
QBG12: QB12.1, RBG12.1
QBG13: QB13.1, RBG13.1
QBG14: QB14.1, RBG14.1
QBG15: QB15.1, RBG15.1
QBG16: QB16.1, RBG16.1
QBG17: QB17.1, RBG17.1
QBG18: QB18.1, RBG18.1
QBG19: QB19.1, RBG19.1
QBG20: QB20.1, RBG20.1
QBG21: QB21.1, RBG21.1
QBG22: QB22.1, RBG22.1
QBG23: QB23.1, RBG23.1
QBG24: QB24.1, RBG24.1
QBG25: QB25.1, RBG25.1
QBG26: QB26.1, RBG26.1
QBG27: QB27.1, RBG27.1
QBG28: QB28.1, RBG28.1
QBG29: QB29.1, RBG29.1
QBG30: QB30.1, RBG30.1
QBG31: QB31.1, RBG31.1
QBG32: QB32.1, RBG32.1
QBG33: QB33.1, RBG33.1
QBG34: QB34.1, RBG34.1
QBG35: QB35.1, RBG35.1
QBG36: QB36.1, RBG36.1
QBG37: QB37.1, RBG37.1
QBG38: QB38.1, RBG38.1
QBG39: QB39.1, RBG39.1
QBG40: QB40.1, RBG40.1
QBG41: QB41.1, RBG41.1
QBG42: QB42.1, RBG42.1
QBG43: QB43.1, RBG43.1
QBG44: QB44.1, RBG44.1
QBG45: QB45.1, RBG45.1
QBG46: QB46.1, RBG46.1
QBG47: QB47.1, RBG47.1
QBG48: QB48.1, RBG48.1
RS1: IC4.8, R39.1
RS2: IC10.8, R7.1
RS3: IC17.8, R26.1
RS4: IC24.8, R43.1
SCK0: IC1.22, IC2.41
SCK3: IC3.22, IC9.41
SCK5: IC15.22, IC16.41
SCK7: IC22.22, IC23.41
SSEL0: IC1.10, IC2.44
SSEL3: IC3.10, IC9.44
SSEL5: IC15.10, IC16.44
SSEL7: IC22.10, IC23.44
SW1: IC8.6, REG5_C2.2, REG5_D2.1, REG5_L.1
SW2: IC14.6, REG5_C1.2, REG5_D1.1, REG5_L1.1
SW3: IC21.6, REG5_C9.2, REG5_D3.1, REG5_L2.1
SW4: IC28.6, REG5_C13.2, REG5_D4.1, REG5_L3.1
SWCLK: DBG1.4, IC1.29
SWCLK1: DBG2.4, IC3.29
SWCLK2: DBG3.4, IC15.29
SWCLK3: DBG4.4, IC22.29
SWDIO: DBG1.2, IC1.39
SWDIO1: DBG2.2, IC3.39
SWDIO2: DBG3.2, IC15.39
SWDIO3: DBG4.2, IC22.39
TEMP0: IC6.1, NTC_C3.1, NTC_R3.1, X5.2
TEMP1: IC6.5, NTC_C2.1, NTC_R2.1, X5.4
TEMP2: IC6.2, NTC_C4.1, NTC_R4.1, X5.6
TEMP3: IC6.12, NTC_C1.1, NTC_R1.1, X5.8
TEMP4: IC6.14, NTC_C5.1, NTC_R5.1, X5.10
TEMP5: IC6.15, NTC_C8.1, NTC_R8.1, X5.12
TEMP6: IC7.1, NTC_C6.1, NTC_R6.1, X6.2
TEMP7: IC7.5, NTC_C7.1, NTC_R7.1, X6.4
TEMP8: IC7.2, NTC_C9.1, NTC_R9.1, X6.6
TEMP9: IC7.12, NTC_C12.1, NTC_R12.1, X6.8
TEMP10: IC7.14, NTC_C10.1, NTC_R10.1, X6.10
TEMP11: IC7.15, NTC_C11.1, NTC_R11.1, X6.12
TEMP12: IC12.1, NTC_C13.1, NTC_R13.1, X9.2
TEMP13: IC12.2, NTC_C14.1, NTC_R14.1, X9.6
TEMP14: IC12.12, NTC_C15.1, NTC_R15.1, X9.8
TEMP15: IC12.5, NTC_C16.1, NTC_R16.1, X9.4
TEMP16: IC12.14, NTC_C17.1, NTC_R17.1, X9.10
TEMP17: IC12.15, NTC_C20.1, NTC_R20.1, X9.12
TEMP18: IC13.1, NTC_C18.1, NTC_R18.1, X10.2
TEMP19: IC13.5, NTC_C19.1, NTC_R19.1, X10.4
TEMP20: IC13.2, NTC_C21.1, NTC_R21.1, X10.6
TEMP21: IC13.12, NTC_C24.1, NTC_R24.1, X10.8
TEMP22: IC13.14, NTC_C22.1, NTC_R22.1, X10.10
TEMP23: IC13.15, NTC_C23.1, NTC_R23.1, X10.12
TEMP24: IC19.1, NTC_C25.1, NTC_R25.1, X15.2
TEMP25: IC19.2, NTC_C26.1, NTC_R26.1, X15.6
TEMP26: IC19.12, NTC_C27.1, NTC_R27.1, X15.8
TEMP27: IC19.5, NTC_C28.1, NTC_R28.1, X15.4
TEMP28: IC19.14, NTC_C29.1, NTC_R29.1, X15.10
TEMP29: IC19.15, NTC_C32.1, NTC_R32.1, X15.12
TEMP30: IC20.1, NTC_C30.1, NTC_R30.1, X16.2
TEMP31: IC20.5, NTC_C31.1, NTC_R31.1, X16.4
TEMP32: IC20.2, NTC_C33.1, NTC_R33.1, X16.6
TEMP33: IC20.12, NTC_C36.1, NTC_R36.1, X16.8
TEMP34: IC20.14, NTC_C34.1, NTC_R34.1, X16.10
TEMP35: IC20.15, NTC_C35.1, NTC_R35.1, X16.12
TEMP36: IC26.1, NTC_C37.1, NTC_R37.1, X21.2
TEMP37: IC26.2, NTC_C38.1, NTC_R38.1, X21.6
TEMP38: IC26.12, NTC_C39.1, NTC_R39.1, X21.8
TEMP39: IC26.5, NTC_C40.1, NTC_R40.1, X21.4
TEMP40: IC26.14, NTC_C41.1, NTC_R41.1, X21.10
TEMP41: IC26.15, NTC_C44.1, NTC_R44.1, X21.12
TEMP42: IC27.1, NTC_C42.1, NTC_R42.1, X22.2
TEMP43: IC27.5, NTC_C43.1, NTC_R43.1, X22.4
TEMP44: IC27.2, NTC_C45.1, NTC_R45.1, X22.6
TEMP45: IC27.12, NTC_C48.1, NTC_R48.1, X22.8
TEMP46: IC27.14, NTC_C46.1, NTC_R46.1, X22.10
TEMP47: IC27.15, NTC_C47.1, NTC_R47.1, X22.12
TEMPR: C3.1, DT1.A, DT2.A, DT3.A, DT4.A, DT5.A, DT6.A, IC1.34, R9.1
TEMPR1: C28.1, DT7.A, DT8.A, DT9.A, DT10.A, DT11.A, DT12.A, IC3.34, R20.1
TEMPR2: C45.1, DT13.A, DT14.A, DT15.A, DT16.A, DT17.A, DT18.A, IC15.34, R34.1
TEMPR3: C61.1, DT19.A, DT20.A, DT21.A, DT22.A, DT23.A, DT24.A, IC22.34, R51.1
TS0: IC1.18, IC6.10, IC7.10
TS1: IC1.21, IC6.9, IC7.9
TS2: IC3.18, IC12.10, IC13.10
TS3: IC3.21, IC12.9, IC13.9
TS4: IC15.18, IC19.10, IC20.10
TS5: IC15.21, IC19.9, IC20.9
TS6: IC22.18, IC26.10, IC27.10
TS7: IC22.21, IC26.9, IC27.9
UCT1: IC1.30, IC6.3
UCT2: IC1.32, IC6.13
UCT3: IC1.35, IC7.3
UCT4: IC1.40, IC7.13
UCT5: IC3.40, IC13.13
UCT6: IC3.35, IC13.3
UCT7: IC3.32, IC12.13
UCT8: IC3.30, IC12.3
UCT9: IC15.40, IC20.13
UCT10: IC15.35, IC20.3
UCT11: IC15.32, IC19.13
UCT12: IC15.30, IC19.3
UCT13: IC22.40, IC27.13
UCT14: IC22.35, IC27.3
UCT15: IC22.32, IC26.13
UCT16: IC22.30, IC26.3
V+: C1.1, IC2.1, Q1.3, R59.2
V+1: C16.1, IC9.1, Q4.3, R14.2
V+2: C37.1, IC16.1, Q6.3, R30.2
V+3: C53.1, IC23.1, Q8.3, R47.2
V+S: D1.C, D2.C, Q1.2, RGQ1_1.1, V+R.2
V+S1: D3.C, D4.C, Q4.2, RGQ1_4.1, V+R1.2
V+S2: D5.C, D6.C, Q6.2, RGQ1_7.1, V+R2.2
V+S3: D7.C, D8.C, Q8.2, RGQ1_10.1, V+R3.2
VREF: CVREF.2, IC2.31
VREF1: CVREF1.2, IC9.31
VREF2: CVREF2.2, IC16.31
VREF3: CVREF3.2, IC23.31
VREG: CVREG.2, IC2.32
VREG1: CVREG1.2, IC9.32
VREG2: CVREG2.2, IC16.32
VREG3: CVREG3.2, IC23.32
XTALIN: C15.2, IC1.6, Y1.P3
XTALIN1: C11.2, IC3.6, Y2.P3
XTALIN2: C33.2, IC15.6, Y3.P3
XTALIN3: C50.2, IC22.6, Y4.P3
XTALOUT: C14.2, IC1.7, Y1.P1
XTALOUT1: C10.2, IC3.7, Y2.P1
XTALOUT2: C32.2, IC15.7, Y3.P1
XTALOUT3: C49.2, IC22.7, Y4.P1
