funkobongrip/sprbms/hardware/can/canSlaveV05a_nutzen.brd

## EAGLE design hardware/can/canSlaveV05a_nutzen.brd (2016-02-18)

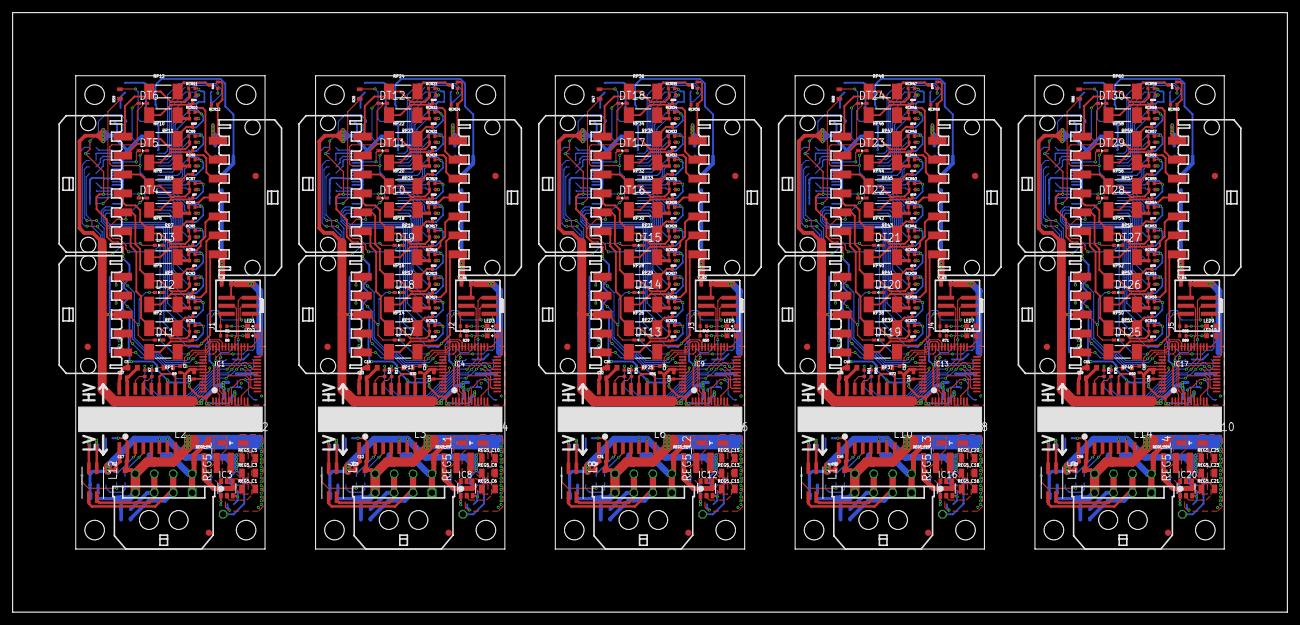
[picture p112: board canSlaveV05a_nutzen.brd from above]

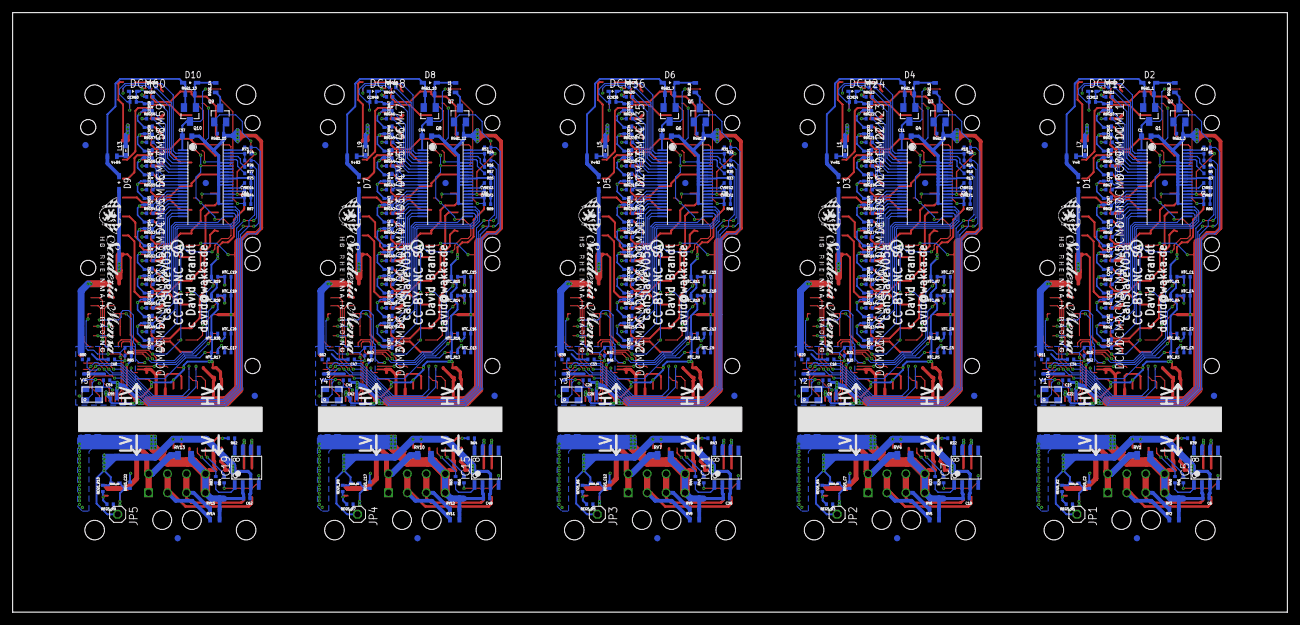
[picture p113: board canSlaveV05a_nutzen.brd from below]

Board: 2 copper layers, 202.0 x 95.0 mm, 830 parts (445 on the bottom side), 575 nets.

Parts:
C1, C11, C30, C44, C57: 100n,100V; C0603
C2, C3, C6, C9, C10, C12, C13, C16, C17, C19, C21, C22, C23, C24, C27, C28, C29, C31, C32, C33, C34, C36, C38, C39, C42, C43, C45, C46, C47, C49, C51, C52, C55, C56, C58, C59, C60, C62, C64, C65: 100n; C0402
C4, C8, C14, C15, C25, C26, C40, C41, C53, C54: 10p; C0402
C5, C7, C18, C20, C35, C37, C48, C50, C61, C63: 10u; C0603
CCM1, CCM2, CCM3, CCM4, CCM5, CCM6, CCM7, CCM8, CCM9, CCM10, CCM11, CCM12, CCM13, CCM14, CCM15, CCM16, CCM17, CCM18, CCM19, CCM20, CCM21, CCM22, CCM23, CCM24, CCM25, CCM26, CCM27, CCM28, CCM29, CCM30, CCM31, CCM32, CCM33, CCM34, CCM35, CCM36, CCM37, CCM38, CCM39, CCM40, CCM41, CCM42, CCM43, CCM44, CCM45, CCM46, CCM47, CCM48, CCM49, CCM50, CCM51, CCM52, CCM53, CCM54, CCM55, CCM56, CCM57, CCM58, CCM59, CCM60: 100n; C0402
CVREF, CVREF1, CVREF2, CVREF3, CVREF4: 1u; C0402
CVREG, CVREG1, CVREG2, CVREG3, CVREG4: 1u; C0402
D1, D3, D5, D7, D9: 51V; SOD323-L
D2, D4, D6, D8, D10: 12V; SOD323-L
DCM1, DCM2, DCM3, DCM4, DCM5, DCM6, DCM7, DCM8, DCM9, DCM10, DCM11, DCM12, DCM13, DCM14, DCM15, DCM16, DCM17, DCM18, DCM19, DCM20, DCM21, DCM22, DCM23, DCM24, DCM25, DCM26, DCM27, DCM28, DCM29, DCM30, DCM31, DCM32, DCM33, DCM34, DCM35, DCM36, DCM37, DCM38, DCM39, DCM40, DCM41, DCM42, DCM43, DCM44, DCM45, DCM46, DCM47, DCM48, DCM49, DCM50, DCM51, DCM52, DCM53, DCM54, DCM55, DCM56, DCM57, DCM58, DCM59, DCM60: 7.5; SOD523
DT1, DT2, DT3, DT4, DT5, DT6, DT7, DT8, DT9, DT10, DT11, DT12, DT13, DT14, DT15, DT16, DT17, DT18, DT19, DT20, DT21, DT22, DT23, DT24, DT25, DT26, DT27, DT28, DT29, DT30: 1PS79SB40; SOD523
FID1, FID2, FID3, FID4, FID5, FID6, FID7, FID8, FID9, FID10, FID11, FID12, FID13, FID14, FID15, FID16, FID17, FID18, FID19, FID20, FID21, FID22, FID23, FID24, FID25, FID26, FID27, FID28, FID29, FID30, FID31, FID32, FID33, FID34, FID35: FIDUCIAL""; FIDUCIAL_1MM
IC1, IC4, IC9, IC13, IC17: LPC11C14; LQFP48
IC2, IC6, IC10, IC14, IC18: LTC6803-4; 44SSOP
IC3, IC8, IC12, IC16, IC20: LT1616; SOT23-6
IC5, IC7, IC11, IC15, IC19: PCA82C251; SO-8
J1, J2, J3, J4, J5: PINHEAD-2X031.27SMT; 2X03_1.27MM_SMT
JP1, JP2, JP3, JP4, JP5: 1X01
L1, L5, L7, L9, L13: WE-CBF,742792664; 0603
L2, L3, L6, L10, L14: WE-PMI/74479776233A; WE-PMI_0806
L4, L8, L11, L12, L15: WE-SLM
LED1, LED3, LED5, LED7, LED9: GRN; CHIPLED_0603
LED2, LED4, LED6, LED8, LED10: RED; CHIPLED_0603
NTC_C1, NTC_C2, NTC_C3, NTC_C4, NTC_C5, NTC_C6, NTC_C7, NTC_C8, NTC_C9, NTC_C10, NTC_C11, NTC_C12, NTC_C13, NTC_C14, NTC_C15, NTC_C16, NTC_C17, NTC_C18, NTC_C19, NTC_C20: 1u; C0402
NTC_R1, NTC_R2, NTC_R3, NTC_R4, NTC_R5, NTC_R6, NTC_R7, NTC_R8, NTC_R9, NTC_R10, NTC_R11, NTC_R12, NTC_R13, NTC_R14, NTC_R15, NTC_R16, NTC_R17, NTC_R18, NTC_R19, NTC_R20: 1k; R0402
Q1, Q4, Q6, Q8, Q10: BSS84; SOT23
Q2, Q3, Q5, Q7, Q9: 2N7002; SOT23
QB1, QB2, QB3, QB4, QB5, QB6, QB7, QB8, QB9, QB10, QB11, QB12, QB13, QB14, QB15, QB16, QB17, QB18, QB19, QB20, QB21, QB22, QB23, QB24, QB25, QB26, QB27, QB28, QB29, QB30, QB31, QB32, QB33, QB34, QB35, QB36, QB37, QB38, QB39, QB40, QB41, QB42, QB43, QB44, QB45, QB46, QB47, QB48, QB49, QB50, QB51, QB52, QB53, QB54, QB55, QB56, QB57, QB58, QB59, QB60: BSS84AKT; SOT416
R1, R3, R4, R5, R6, R7, R12, R13, R14, R16, R17, R18, R23, R24, R32, R33, R34, R35, R36, R37, R40, R41, R44, R45, R54, R55, R56, R57, R58, R61, R65, R66, R74, R75, R76, R77, R78, R79, R83, R84: 100; R0402
R2, R8, R28, R29, R49, R50, R70, R71, R88, R89: 1k; R0402
R9, R30, R51, R72, R90: 3.3k; R0603
R10, R19, R31, R53, R73: 4.7k; R0402
R11, R15, R20, R21, R25, R38, R42, R46, R52, R62, R63, R67, R80, R81, R85: 10k; R0402
R22, R39, R43, R64, R82: 0; R0402
R26, R47, R59, R68, R86: 332k0.1%; R0603
R27, R48, R60, R69, R87: 20k0.1%; R0402
RBG1, RBG2, RBG3, RBG4, RBG5, RBG6, RBG7, RBG8, RBG9, RBG10, RBG11, RBG12, RBG13, RBG14, RBG15, RBG16, RBG17, RBG18, RBG19, RBG20, RBG21, RBG22, RBG23, RBG24, RBG25, RBG26, RBG27, RBG28, RBG29, RBG30, RBG31, RBG32, RBG33, RBG34, RBG35, RBG36, RBG37, RBG38, RBG39, RBG40, RBG41, RBG42, RBG43, RBG44, RBG45, RBG46, RBG47, RBG48, RBG49, RBG50, RBG51, RBG52, RBG53, RBG54, RBG55, RBG56, RBG57, RBG58, RBG59, RBG60: 3.3k; R0402
RCM1, RCM2, RCM3, RCM4, RCM5, RCM6, RCM7, RCM8, RCM9, RCM10, RCM11, RCM12, RCM13, RCM14, RCM15, RCM16, RCM17, RCM18, RCM19, RCM20, RCM21, RCM22, RCM23, RCM24, RCM25, RCM26, RCM27, RCM28, RCM29, RCM30, RCM31, RCM32, RCM33, RCM34, RCM35, RCM36, RCM37, RCM38, RCM39, RCM40, RCM41, RCM42, RCM43, RCM44, RCM45, RCM46, RCM47, RCM48, RCM49, RCM50, RCM51, RCM52, RCM53, RCM54, RCM55, RCM56, RCM57, RCM58, RCM59, RCM60: 100; R0402
REG5_C1, REG5_C4, REG5_C6, REG5_C9, REG5_C11, REG5_C14, REG5_C16, REG5_C19, REG5_C21, REG5_C24: 1u,25V,X7R; C0805
REG5_C2, REG5_C7, REG5_C12, REG5_C17, REG5_C22: 100n,>=25V,>=X5R; C0402
REG5_C3, REG5_C5, REG5_C8, REG5_C10, REG5_C13, REG5_C15, REG5_C18, REG5_C20, REG5_C23, REG5_C25: 10u,10V,X7R; C0805
REG5_D1, REG5_D3, REG5_D5, REG5_D7, REG5_D9: 1PS79SB40; SOD523
REG5_D2, REG5_D4, REG5_D6, REG5_D8, REG5_D10: PMEG6010CEH; SOD123
REG5_L, REG5_L1, REG5_L2, REG5_L3, REG5_L4: 744025100; WE-TPC_2828
REG5_R1, REG5_R3, REG5_R5, REG5_R7, REG5_R9: 10k; R0402
REG5_R2, REG5_R4, REG5_R6, REG5_R8, REG5_R10: 30.1k; R0402
RGQ1_1, RGQ1_4, RGQ1_7, RGQ1_10, RGQ1_13: 1M,50V; R0603
RGQ1_2, RGQ1_5, RGQ1_8, RGQ1_11, RGQ1_14: 100k,50V; R0603
RGQ1_3, RGQ1_6, RGQ1_9, RGQ1_12, RGQ1_15: 1M; R0402
RP1, RP2, RP3, RP4, RP5, RP6, RP7, RP8, RP9, RP10, RP11, RP12, RP13, RP14, RP15, RP16, RP17, RP18, RP19, RP20, RP21, RP22, RP23, RP24, RP25, RP26, RP27, RP28, RP29, RP30, RP31, RP32, RP33, RP34, RP35, RP36, RP37, RP38, RP39, RP40, RP41, RP42, RP43, RP44, RP45, RP46, RP47, RP48, RP49, RP50, RP51, RP52, RP53, RP54, RP55, RP56, RP57, RP58, RP59, RP60: 22; MINI_MELF-0207R
RV1, RV4, RV7, RV10, RV13: 24V; R0805
RV2, RV3, RV5, RV6, RV8, RV9, RV11, RV12, RV14, RV15: 24V; R0603
U$1, U$2, U$5, U$7, U$9: ADUM5201; SO16WB
U$3, U$4, U$6, U$8, U$10: SMLOGOS_BSILK
V+R, V+R1, V+R2, V+R3, V+R4: 100; R0603
V-R, V-R1, V-R2, V-R3, V-R4: 100; R0603
X1, X2, X9, X13, X17: 43650-0509
X3, X4, X10, X14, X18: 43650-0709
X5, X6, X11, X15, X19: 43650-0609
X7, X8, X12, X16, X20: 43045-0800
Y1, Y2, Y3, Y4, Y5: 12Mhz; MT

Connections:
!RESET: C34.1, IC1.3, J1.1, R52.2
!RESET1: C16.1, IC4.3, J2.1, R25.2
!RESET2: C33.1, IC9.3, J3.1, R46.2
!RESET3: C47.1, IC13.3, J4.1, R67.2
!RESET4: C60.1, IC17.3, J5.1, R85.2
+3V1: C9.1, C10.1, C13.1, C18.1, IC4.8, IC4.44, IC6.30, J2.2, NTC_R5.2, NTC_R6.2, NTC_R7.2, NTC_R8.2, Q3.1, R10.2, R21.1, R25.1, R28.2, R29.2, R30.2, RGQ1_6.2, U$1.P$10, U$1.P$16
+3V2: C28.1, C29.1, C32.1, C35.1, IC9.8, IC9.44, IC10.30, J3.2, NTC_R9.2, NTC_R10.2, NTC_R11.2, NTC_R12.2, Q5.1, R31.2, R42.1, R46.1, R49.2, R50.2, R51.2, RGQ1_9.2, U$5.P$10, U$5.P$16
+3V3: C5.1, C22.1, C23.1, C27.1, IC1.8, IC1.44, IC2.30, J1.2, NTC_R1.2, NTC_R2.2, NTC_R3.2, NTC_R4.2, Q2.1, R2.2, R8.2, R9.2, R15.1, R19.2, R52.1, RGQ1_3.2, U$2.P$10, U$2.P$16
+3V4: C42.1, C43.1, C46.1, C48.1, IC13.8, IC13.44, IC14.30, J4.2, NTC_R13.2, NTC_R14.2, NTC_R15.2, NTC_R16.2, Q7.1, R53.2, R63.1, R67.1, R70.2, R71.2, R72.2, RGQ1_12.2, U$7.P$10, U$7.P$16
+3V5: C55.1, C56.1, C59.1, C61.1, IC17.8, IC17.44, IC18.30, J5.2, NTC_R17.2, NTC_R18.2, NTC_R19.2, NTC_R20.2, Q9.1, R73.2, R81.1, R85.1, R88.2, R89.2, R90.2, RGQ1_15.2, U$9.P$10, U$9.P$16
BAL1: IC2.25, RBG1.2
BAL2: IC2.23, RBG2.2
BAL3: IC2.21, RBG3.2
BAL4: IC2.19, RBG4.2
BAL5: IC2.17, RBG5.2
BAL6: IC2.15, RBG6.2
BAL7: IC2.13, RBG7.2
BAL8: IC2.11, RBG8.2
BAL9: IC2.9, RBG9.2
BAL10: IC2.7, RBG10.2
BAL11: IC2.5, RBG11.2
BAL12: IC2.3, RBG12.2
BAL13: IC6.25, RBG13.2
BAL14: IC6.23, RBG14.2
BAL15: IC6.21, RBG15.2
BAL16: IC6.19, RBG16.2
BAL17: IC6.17, RBG17.2
BAL18: IC6.15, RBG18.2
BAL19: IC6.13, RBG19.2
BAL20: IC6.11, RBG20.2
BAL21: IC6.9, RBG21.2
BAL22: IC6.7, RBG22.2
BAL23: IC6.5, RBG23.2
BAL24: IC6.3, RBG24.2
BAL25: IC10.25, RBG25.2
BAL26: IC10.23, RBG26.2
BAL27: IC10.21, RBG27.2
BAL28: IC10.19, RBG28.2
BAL29: IC10.17, RBG29.2
BAL30: IC10.15, RBG30.2
BAL31: IC10.13, RBG31.2
BAL32: IC10.11, RBG32.2
BAL33: IC10.9, RBG33.2
BAL34: IC10.7, RBG34.2
BAL35: IC10.5, RBG35.2
BAL36: IC10.3, RBG36.2
BAL37: IC14.25, RBG37.2
BAL38: IC14.23, RBG38.2
BAL39: IC14.21, RBG39.2
BAL40: IC14.19, RBG40.2
BAL41: IC14.17, RBG41.2
BAL42: IC14.15, RBG42.2
BAL43: IC14.13, RBG43.2
BAL44: IC14.11, RBG44.2
BAL45: IC14.9, RBG45.2
BAL46: IC14.7, RBG46.2
BAL47: IC14.5, RBG47.2
BAL48: IC14.3, RBG48.2
BAL49: IC18.25, RBG49.2
BAL50: IC18.23, RBG50.2
BAL51: IC18.21, RBG51.2
BAL52: IC18.19, RBG52.2
BAL53: IC18.17, RBG53.2
BAL54: IC18.15, RBG54.2
BAL55: IC18.13, RBG55.2
BAL56: IC18.11, RBG56.2
BAL57: IC18.9, RBG57.2
BAL58: IC18.7, RBG58.2
BAL59: IC18.5, RBG59.2
BAL60: IC18.3, RBG60.2
BOOST1: IC3.1, REG5_C2.1, REG5_D1.C
BOOST2: IC8.1, REG5_C7.1, REG5_D3.C
BOOST3: IC12.1, REG5_C12.1, REG5_D5.C
BOOST4: IC16.1, REG5_C17.1, REG5_D7.C
BOOST5: IC20.1, REG5_C22.1, REG5_D9.C
C0: CCM1.2, D1.A, DCM1.A, IC2.26, RP1.1, V-R.1, X3.7
C1: QB1.2, RCM1.1, RP2.1, X6.1
C1M: CCM1.1, CCM2.2, DCM1.C, DCM2.A, IC2.24, RCM1.2
C1M1: CCM13.1, CCM14.2, DCM13.C, DCM14.A, IC6.24, RCM13.2
C1M2: CCM25.1, CCM26.2, DCM25.C, DCM26.A, IC10.24, RCM25.2
C1M3: CCM37.1, CCM38.2, DCM37.C, DCM38.A, IC14.24, RCM37.2
C1M4: CCM49.1, CCM50.2, DCM49.C, DCM50.A, IC18.24, RCM49.2
C2: QB2.2, RCM2.1, RP3.1, X3.6
C2M: CCM2.1, CCM3.2, DCM2.C, DCM3.A, IC2.22, RCM2.2
C2M1: CCM14.1, CCM15.2, DCM14.C, DCM15.A, IC6.22, RCM14.2
C2M2: CCM26.1, CCM27.2, DCM26.C, DCM27.A, IC10.22, RCM26.2
C2M3: CCM38.1, CCM39.2, DCM38.C, DCM39.A, IC14.22, RCM38.2
C2M4: CCM50.1, CCM51.2, DCM50.C, DCM51.A, IC18.22, RCM50.2
C3: QB3.2, RCM3.1, RP4.1, X6.2
C3M: CCM3.1, CCM4.2, DCM3.C, DCM4.A, IC2.20, RCM3.2
C3M1: CCM15.1, CCM16.2, DCM15.C, DCM16.A, IC6.20, RCM15.2
C3M2: CCM27.1, CCM28.2, DCM27.C, DCM28.A, IC10.20, RCM27.2
C3M3: CCM39.1, CCM40.2, DCM39.C, DCM40.A, IC14.20, RCM39.2
C3M4: CCM51.1, CCM52.2, DCM51.C, DCM52.A, IC18.20, RCM51.2
C4: QB4.2, RCM4.1, RP5.1, X3.5
C4M: CCM4.1, CCM5.2, DCM4.C, DCM5.A, IC2.18, RCM4.2
C4M1: CCM16.1, CCM17.2, DCM16.C, DCM17.A, IC6.18, RCM16.2
C4M2: CCM28.1, CCM29.2, DCM28.C, DCM29.A, IC10.18, RCM28.2
C4M3: CCM40.1, CCM41.2, DCM40.C, DCM41.A, IC14.18, RCM40.2
C4M4: CCM52.1, CCM53.2, DCM52.C, DCM53.A, IC18.18, RCM52.2
C5: QB5.2, RCM5.1, RP6.1, X6.3
C5M: CCM5.1, CCM6.2, DCM5.C, DCM6.A, IC2.16, RCM5.2
C5M1: CCM17.1, CCM18.2, DCM17.C, DCM18.A, IC6.16, RCM17.2
C5M2: CCM29.1, CCM30.2, DCM29.C, DCM30.A, IC10.16, RCM29.2
C5M3: CCM41.1, CCM42.2, DCM41.C, DCM42.A, IC14.16, RCM41.2
C5M4: CCM53.1, CCM54.2, DCM53.C, DCM54.A, IC18.16, RCM53.2
C6: QB6.2, RCM6.1, RP7.1, X3.4
C6M: CCM6.1, CCM7.2, DCM6.C, DCM7.A, IC2.14, RCM6.2
C6M1: CCM18.1, CCM19.2, DCM18.C, DCM19.A, IC6.14, RCM18.2
C6M2: CCM30.1, CCM31.2, DCM30.C, DCM31.A, IC10.14, RCM30.2
C6M3: CCM42.1, CCM43.2, DCM42.C, DCM43.A, IC14.14, RCM42.2
C6M4: CCM54.1, CCM55.2, DCM54.C, DCM55.A, IC18.14, RCM54.2
C7: QB7.2, RCM7.1, RP8.1, X6.4
C7M: CCM7.1, CCM8.2, DCM7.C, DCM8.A, IC2.12, RCM7.2
C7M1: CCM19.1, CCM20.2, DCM19.C, DCM20.A, IC6.12, RCM19.2
C7M2: CCM31.1, CCM32.2, DCM31.C, DCM32.A, IC10.12, RCM31.2
C7M3: CCM43.1, CCM44.2, DCM43.C, DCM44.A, IC14.12, RCM43.2
C7M4: CCM55.1, CCM56.2, DCM55.C, DCM56.A, IC18.12, RCM55.2
C8: QB8.2, RCM8.1, RP9.1, X3.3
C8M: CCM8.1, CCM9.2, DCM8.C, DCM9.A, IC2.10, RCM8.2
C8M1: CCM20.1, CCM21.2, DCM20.C, DCM21.A, IC6.10, RCM20.2
C8M2: CCM32.1, CCM33.2, DCM32.C, DCM33.A, IC10.10, RCM32.2
C8M3: CCM44.1, CCM45.2, DCM44.C, DCM45.A, IC14.10, RCM44.2
C8M4: CCM56.1, CCM57.2, DCM56.C, DCM57.A, IC18.10, RCM56.2
C9: QB9.2, RCM9.1, RP10.1, X6.5
C9M: CCM9.1, CCM10.2, DCM9.C, DCM10.A, IC2.8, RCM9.2
C9M1: CCM21.1, CCM22.2, DCM21.C, DCM22.A, IC6.8, RCM21.2
C9M2: CCM33.1, CCM34.2, DCM33.C, DCM34.A, IC10.8, RCM33.2
C9M3: CCM45.1, CCM46.2, DCM45.C, DCM46.A, IC14.8, RCM45.2
C9M4: CCM57.1, CCM58.2, DCM57.C, DCM58.A, IC18.8, RCM57.2
C10: QB10.2, RCM10.1, RP11.1, X3.2
C10M: CCM10.1, CCM11.2, DCM10.C, DCM11.A, IC2.6, RCM10.2
C10M1: CCM22.1, CCM23.2, DCM22.C, DCM23.A, IC6.6, RCM22.2
C10M2: CCM34.1, CCM35.2, DCM34.C, DCM35.A, IC10.6, RCM34.2
C10M3: CCM46.1, CCM47.2, DCM46.C, DCM47.A, IC14.6, RCM46.2
C10M4: CCM58.1, CCM59.2, DCM58.C, DCM59.A, IC18.6, RCM58.2
C11: QB11.2, RCM11.1, RP12.1, X6.6
C11M: CCM11.1, CCM12.2, DCM11.C, DCM12.A, IC2.4, RCM11.2
C11M1: CCM23.1, CCM24.2, DCM23.C, DCM24.A, IC6.4, RCM23.2
C11M2: CCM35.1, CCM36.2, DCM35.C, DCM36.A, IC10.4, RCM35.2
C11M3: CCM47.1, CCM48.2, DCM47.C, DCM48.A, IC14.4, RCM47.2
C11M4: CCM59.1, CCM60.2, DCM59.C, DCM60.A, IC18.4, RCM59.2
C12: L7.1, QB12.2, RCM12.1, X3.1
C12M: CCM12.1, DCM12.C, IC2.2, RCM12.2
C12M1: CCM24.1, DCM24.C, IC6.2, RCM24.2
C12M2: CCM36.1, DCM36.C, IC10.2, RCM36.2
C12M3: CCM48.1, DCM48.C, IC14.2, RCM48.2
C12M4: CCM60.1, DCM60.C, IC18.2, RCM60.2
C13: CCM13.2, D3.A, DCM13.A, IC6.26, RP13.1, V-R1.1, X4.7
C14: QB20.2, RCM20.1, RP21.1, X4.3
C15: QB14.2, RCM14.1, RP15.1, X4.6
C16: QB13.2, RCM13.1, RP14.1, X5.1
C17: QB15.2, RCM15.1, RP16.1, X5.2
C18: QB16.2, RCM16.1, RP17.1, X4.5
C19: QB17.2, RCM17.1, RP18.1, X5.3
C20: QB18.2, RCM18.1, RP19.1, X4.4
C21: QB19.2, RCM19.1, RP20.1, X5.4
C22: QB21.2, RCM21.1, RP22.1, X5.5
C23: QB22.2, RCM22.1, RP23.1, X4.2
C24: QB23.2, RCM23.1, RP24.1, X5.6
C25: L1.1, QB24.2, RCM24.1, X4.1
C26: CCM25.2, D5.A, DCM25.A, IC10.26, RP25.1, V-R2.1, X10.7
C27: QB32.2, RCM32.1, RP33.1, X10.3
C28: QB26.2, RCM26.1, RP27.1, X10.6
C29: QB25.2, RCM25.1, RP26.1, X11.1
C30: QB27.2, RCM27.1, RP28.1, X11.2
C31: QB28.2, RCM28.1, RP29.1, X10.5
C32: QB29.2, RCM29.1, RP30.1, X11.3
C33: QB30.2, RCM30.1, RP31.1, X10.4
C34: QB31.2, RCM31.1, RP32.1, X11.4
C35: QB33.2, RCM33.1, RP34.1, X11.5
C36: QB34.2, RCM34.1, RP35.1, X10.2
C37: QB35.2, RCM35.1, RP36.1, X11.6
C38: L5.1, QB36.2, RCM36.1, X10.1
C39: CCM37.2, D7.A, DCM37.A, IC14.26, RP37.1, V-R3.1, X14.7
C40: QB44.2, RCM44.1, RP45.1, X14.3
C41: QB38.2, RCM38.1, RP39.1, X14.6
C42: QB37.2, RCM37.1, RP38.1, X15.1
C43: QB39.2, RCM39.1, RP40.1, X15.2
C44: QB40.2, RCM40.1, RP41.1, X14.5
C45: QB41.2, RCM41.1, RP42.1, X15.3
C46: QB42.2, RCM42.1, RP43.1, X14.4
C47: QB43.2, RCM43.1, RP44.1, X15.4
C48: QB45.2, RCM45.1, RP46.1, X15.5
C49: QB46.2, RCM46.1, RP47.1, X14.2
C50: QB47.2, RCM47.1, RP48.1, X15.6
C51: L9.1, QB48.2, RCM48.1, X14.1
C52: CCM49.2, D9.A, DCM49.A, IC18.26, RP49.1, V-R4.1, X18.7
C53: QB56.2, RCM56.1, RP57.1, X18.3
C54: QB50.2, RCM50.1, RP51.1, X18.6
C55: QB49.2, RCM49.1, RP50.1, X19.1
C56: QB51.2, RCM51.1, RP52.1, X19.2
C57: QB52.2, RCM52.1, RP53.1, X18.5
C58: QB53.2, RCM53.1, RP54.1, X19.3
C59: QB54.2, RCM54.1, RP55.1, X18.4
C60: QB55.2, RCM55.1, RP56.1, X19.4
C61: QB57.2, RCM57.1, RP58.1, X19.5
C62: QB58.2, RCM58.1, RP59.1, X18.2
C63: QB59.2, RCM59.1, RP60.1, X19.6
C64: L13.1, QB60.2, RCM60.1, X18.1
CANH: L12.4, RV3.1, X7.3, X7.7
CANH1: L4.4, RV6.1, X8.3, X8.7
CANH2: L8.4, RV9.1, X12.3, X12.7
CANH3: L11.4, RV12.1, X16.3, X16.7
CANH4: L15.4, RV15.1, X20.3, X20.7
CANL: L12.3, RV2.1, X7.2, X7.6
CANL1: L4.3, RV5.1, X8.2, X8.6
CANL2: L8.3, RV8.1, X12.2, X12.6
CANL3: L11.3, RV11.1, X16.2, X16.6
CANL4: L15.3, RV14.1, X20.2, X20.6
CANRX: R7.2, U$2.P$14
CANRX1: R18.2, U$1.P$14
CANRX2: R37.2, U$5.P$14
CANRX3: R61.2, U$7.P$14
CANRX4: R79.2, U$9.P$14
CANRX_U_L: IC1.19, R7.1
CANRX_U_L1: IC4.19, R18.1
CANRX_U_L2: IC9.19, R37.1
CANRX_U_L3: IC13.19, R61.1
CANRX_U_L4: IC17.19, R79.1
CANTX: R6.2, U$2.P$13
CANTX1: R17.2, U$1.P$13
CANTX2: R36.2, U$5.P$13
CANTX3: R58.2, U$7.P$13
CANTX4: R78.2, U$9.P$13
CANTX_U_L: IC1.20, R6.1
CANTX_U_L1: IC4.20, R17.1
CANTX_U_L2: IC9.20, R36.1
CANTX_U_L3: IC13.20, R58.1
CANTX_U_L4: IC17.20, R78.1
CAR+5V: C6.1, C7.1, C17.1, IC5.3, JP1.1, REG5_C3.1, REG5_C5.1, REG5_D1.A, REG5_L.2, REG5_R2.2, U$2.P$1, U$2.P$6, U$2.P$7
CAR+5V1: C12.1, C19.1, C20.1, IC7.3, JP2.1, REG5_C8.1, REG5_C10.1, REG5_D3.A, REG5_L1.2, REG5_R4.2, U$1.P$1, U$1.P$6, U$1.P$7
CAR+5V2: C31.1, C36.1, C37.1, IC11.3, JP3.1, REG5_C13.1, REG5_C15.1, REG5_D5.A, REG5_L2.2, REG5_R6.2, U$5.P$1, U$5.P$6, U$5.P$7
CAR+5V3: C45.1, C49.1, C50.1, IC15.3, JP4.1, REG5_C18.1, REG5_C20.1, REG5_D7.A, REG5_L3.2, REG5_R8.2, U$7.P$1, U$7.P$6, U$7.P$7
CAR+5V4: C58.1, C62.1, C63.1, IC19.3, JP5.1, REG5_C23.1, REG5_C25.1, REG5_D9.A, REG5_L4.2, REG5_R10.2, U$9.P$1, U$9.P$6, U$9.P$7
CARGND: C6.2, C7.2, C17.2, IC3.2, IC5.2, R39.2, REG5_C1.2, REG5_C3.2, REG5_C4.2, REG5_C5.2, REG5_D2.2, REG5_R1.1, RV1.2, RV2.2, RV3.2, U$2.P$2, U$2.P$5, U$2.P$8, X7.4, X7.8
CARGND1: C12.2, C19.2, C20.2, IC7.2, IC8.2, R22.2, REG5_C6.2, REG5_C8.2, REG5_C9.2, REG5_C10.2, REG5_D4.2, REG5_R3.1, RV4.2, RV5.2, RV6.2, U$1.P$2, U$1.P$5, U$1.P$8, X8.4, X8.8
CARGND2: C31.2, C36.2, C37.2, IC11.2, IC12.2, R43.2, REG5_C11.2, REG5_C13.2, REG5_C14.2, REG5_C15.2, REG5_D6.2, REG5_R5.1, RV7.2, RV8.2, RV9.2, U$5.P$2, U$5.P$5, U$5.P$8, X12.4, X12.8
CARGND3: C45.2, C49.2, C50.2, IC15.2, IC16.2, R64.2, REG5_C16.2, REG5_C18.2, REG5_C19.2, REG5_C20.2, REG5_D8.2, REG5_R7.1, RV10.2, RV11.2, RV12.2, U$7.P$2, U$7.P$5, U$7.P$8, X16.4, X16.8
CARGND4: C58.2, C62.2, C63.2, IC19.2, IC20.2, R82.2, REG5_C21.2, REG5_C23.2, REG5_C24.2, REG5_C25.2, REG5_D10.2, REG5_R9.1, RV13.2, RV14.2, RV15.2, U$9.P$2, U$9.P$5, U$9.P$8, X20.4, X20.8
CARVIN: L2.1, REG5_C4.1, RV1.1, X7.1, X7.5
CARVIN1: L3.1, REG5_C9.1, RV4.1, X8.1, X8.5
CARVIN2: L6.1, REG5_C14.1, RV7.1, X12.1, X12.5
CARVIN3: L10.1, REG5_C19.1, RV10.1, X16.1, X16.5
CARVIN4: L14.1, REG5_C24.1, RV13.1, X20.1, X20.5
CARVINFILT: IC3.4, IC3.5, L2.2, REG5_C1.1
CARVINFILT1: IC8.4, IC8.5, L3.2, REG5_C6.1
CARVINFILT2: IC12.4, IC12.5, L6.2, REG5_C11.1
CARVINFILT3: IC16.4, IC16.5, L10.2, REG5_C16.1
CARVINFILT4: IC20.4, IC20.5, L14.2, REG5_C21.1
CAR_CANRX: R41.2, U$2.P$3
CAR_CANRX1: R24.2, U$1.P$3
CAR_CANRX2: R45.2, U$5.P$3
CAR_CANRX3: R66.2, U$7.P$3
CAR_CANRX4: R84.2, U$9.P$3
CAR_CANRX_T: IC5.4, R41.1
CAR_CANRX_T1: IC7.4, R24.1
CAR_CANRX_T2: IC11.4, R45.1
CAR_CANRX_T3: IC15.4, R66.1
CAR_CANRX_T4: IC19.4, R84.1
CAR_CANTX: R40.2, U$2.P$4
CAR_CANTX1: R23.2, U$1.P$4
CAR_CANTX2: R44.2, U$5.P$4
CAR_CANTX3: R65.2, U$7.P$4
CAR_CANTX4: R83.2, U$9.P$4
CAR_CANTX_T: IC5.1, R40.1
CAR_CANTX_T1: IC7.1, R23.1
CAR_CANTX_T2: IC11.1, R44.1
CAR_CANTX_T3: IC15.1, R65.1
CAR_CANTX_T4: IC19.1, R83.1
CR1: QB1.3, RP1.2
CR2: QB2.3, RP2.2
CR3: QB3.3, RP3.2
CR4: QB4.3, RP4.2
CR5: QB5.3, RP5.2
CR6: QB6.3, RP6.2
CR7: QB7.3, RP7.2
CR8: QB8.3, RP8.2
CR9: QB9.3, RP9.2
CR10: QB10.3, RP10.2
CR11: QB11.3, RP11.2
CR12: QB12.3, RP12.2
CR13: QB13.3, RP13.2
CR14: QB14.3, RP14.2
CR15: QB15.3, RP15.2
CR16: QB16.3, RP16.2
CR17: QB17.3, RP17.2
CR18: QB18.3, RP18.2
CR19: QB19.3, RP19.2
CR20: QB20.3, RP20.2
CR21: QB21.3, RP21.2
CR22: QB22.3, RP22.2
CR23: QB23.3, RP23.2
CR24: QB24.3, RP24.2
CR25: QB25.3, RP25.2
CR26: QB26.3, RP26.2
CR27: QB27.3, RP27.2
CR28: QB28.3, RP28.2
CR29: QB29.3, RP29.2
CR30: QB30.3, RP30.2
CR31: QB31.3, RP31.2
CR32: QB32.3, RP32.2
CR33: QB33.3, RP33.2
CR34: QB34.3, RP34.2
CR35: QB35.3, RP35.2
CR36: QB36.3, RP36.2
CR37: QB37.3, RP37.2
CR38: QB38.3, RP38.2
CR39: QB39.3, RP39.2
CR40: QB40.3, RP40.2
CR41: QB41.3, RP41.2
CR42: QB42.3, RP42.2
CR43: QB43.3, RP43.2
CR44: QB44.3, RP44.2
CR45: QB45.3, RP45.2
CR46: QB46.3, RP46.2
CR47: QB47.3, RP47.2
CR48: QB48.3, RP48.2
CR49: QB49.3, RP49.2
CR50: QB50.3, RP50.2
CR51: QB51.3, RP51.2
CR52: QB52.3, RP52.2
CR53: QB53.3, RP53.2
CR54: QB54.3, RP54.2
CR55: QB55.3, RP55.2
CR56: QB56.3, RP56.2
CR57: QB57.3, RP57.2
CR58: QB58.3, RP58.2
CR59: QB59.3, RP59.2
CR60: QB60.3, RP60.2
CSB: IC2.44, R1.2
CSB1: IC6.44, R12.2
CSB2: IC10.44, R32.2
CSB3: IC14.44, R54.2
CSB4: IC18.44, R74.2
FB1: IC3.3, REG5_R1.2, REG5_R2.1
FB2: IC8.3, REG5_R3.2, REG5_R4.1
FB3: IC12.3, REG5_R5.2, REG5_R6.1
FB4: IC16.3, REG5_R7.2, REG5_R8.1
FB5: IC20.3, REG5_R9.2, REG5_R10.1
FSM: C2.1, IC2.29, R59.1, R60.2
FSM1: C21.1, IC6.29, R26.1, R27.2
FSM2: C38.1, IC10.29, R47.1, R48.2
FSM3: C51.1, IC14.29, R68.1, R69.2
FSM4: C64.1, IC18.29, R86.1, R87.2
GND: C1.2, C2.2, C3.2, C5.2, C14.1, C15.1, C22.2, C23.2, C27.2, C34.2, CVREF.1, CVREG.1, DT1.C, DT2.C, DT3.C, DT4.C, DT5.C, DT6.C, IC1.5, IC1.41, IC2.27, IC2.33, IC2.34, IC2.35, IC2.36, IC2.37, IC2.38, IC2.39, IC2.40, J1.6, NTC_C1.2, NTC_C2.2, NTC_C3.2, NTC_C4.2, Q2.2, R11.1, R60.1, RGQ1_3.1, U$2.P$9, U$2.P$11, U$2.P$15, V-R.2, X1.3, Y1.P2, Y1.P4
GND1: C4.1, C8.1, C9.2, C10.2, C11.2, C13.2, C16.2, C18.2, C21.2, C24.2, CVREF1.1, CVREG1.1, DT7.C, DT8.C, DT9.C, DT10.C, DT11.C, DT12.C, IC4.5, IC4.41, IC6.27, IC6.33, IC6.34, IC6.35, IC6.36, IC6.37, IC6.38, IC6.39, IC6.40, J2.6, NTC_C5.2, NTC_C6.2, NTC_C7.2, NTC_C8.2, Q3.2, R20.1, R27.1, RGQ1_6.1, U$1.P$9, U$1.P$11, U$1.P$15, V-R1.2, X2.3, Y2.P2, Y2.P4
GND2: C25.1, C26.1, C28.2, C29.2, C30.2, C32.2, C33.2, C35.2, C38.2, C39.2, CVREF2.1, CVREG2.1, DT13.C, DT14.C, DT15.C, DT16.C, DT17.C, DT18.C, IC9.5, IC9.41, IC10.27, IC10.33, IC10.34, IC10.35, IC10.36, IC10.37, IC10.38, IC10.39, IC10.40, J3.6, NTC_C9.2, NTC_C10.2, NTC_C11.2, NTC_C12.2, Q5.2, R38.1, R48.1, RGQ1_9.1, U$5.P$9, U$5.P$11, U$5.P$15, V-R2.2, X9.3, Y3.P2, Y3.P4
GND3: C40.1, C41.1, C42.2, C43.2, C44.2, C46.2, C47.2, C48.2, C51.2, C52.2, CVREF3.1, CVREG3.1, DT19.C, DT20.C, DT21.C, DT22.C, DT23.C, DT24.C, IC13.5, IC13.41, IC14.27, IC14.33, IC14.34, IC14.35, IC14.36, IC14.37, IC14.38, IC14.39, IC14.40, J4.6, NTC_C13.2, NTC_C14.2, NTC_C15.2, NTC_C16.2, Q7.2, R62.1, R69.1, RGQ1_12.1, U$7.P$9, U$7.P$11, U$7.P$15, V-R3.2, X13.3, Y4.P2, Y4.P4
GND4: C53.1, C54.1, C55.2, C56.2, C57.2, C59.2, C60.2, C61.2, C64.2, C65.2, CVREF4.1, CVREG4.1, DT25.C, DT26.C, DT27.C, DT28.C, DT29.C, DT30.C, IC17.5, IC17.41, IC18.27, IC18.33, IC18.34, IC18.35, IC18.36, IC18.37, IC18.38, IC18.39, IC18.40, J5.6, NTC_C17.2, NTC_C18.2, NTC_C19.2, NTC_C20.2, Q9.2, R80.1, R87.1, RGQ1_15.1, U$9.P$9, U$9.P$11, U$9.P$15, V-R4.2, X17.3, Y5.P2, Y5.P4
ISP_CAN: IC1.14, R11.2
ISP_CAN1: IC4.14, R20.2
ISP_CAN2: IC9.14, R38.2
ISP_CAN3: IC13.14, R62.2
ISP_CAN4: IC17.14, R80.2
ISP_ENTER: IC1.4, J1.5, R15.2
ISP_ENTER1: IC4.4, J2.5, R21.2
ISP_ENTER2: IC9.4, J3.5, R42.2
ISP_ENTER3: IC13.4, J4.5, R63.2
ISP_ENTER4: IC17.4, J5.5, R81.2
LED1: IC1.24, LED1.C
LED2: IC1.25, LED2.C
LED3: IC4.24, LED3.C
LED4: IC4.25, LED4.C
LED5: IC9.24, LED5.C
LED6: IC9.25, LED6.C
LED7: IC13.24, LED7.C
LED8: IC13.25, LED8.C
LED9: IC17.24, LED9.C
LED10: IC17.25, LED10.C
MISO0: IC1.27, R4.1
MISO3: IC4.27, R14.1
MISO5: IC9.27, R34.1
MISO7: IC13.27, R56.1
MISO9: IC17.27, R76.1
MOSI0: IC1.28, R5.1
MOSI3: IC4.28, R16.1
MOSI5: IC9.28, R35.1
MOSI7: IC13.28, R57.1
MOSI9: IC17.28, R77.1
unnamed: LED2.A, R8.1
unnamed: IC5.7, L12.1
unnamed: Q2.3, RGQ1_2.1
unnamed: L7.2, V+R.1
unnamed: LED1.A, R2.1
unnamed: IC5.6, L12.2
unnamed: Q3.3, RGQ1_5.1
unnamed: L1.2, V+R1.1
unnamed: LED3.A, R28.1
unnamed: LED4.A, R29.1
unnamed: IC7.7, L4.1
unnamed: IC7.6, L4.2
unnamed: Q5.3, RGQ1_8.1
unnamed: L5.2, V+R2.1
unnamed: LED5.A, R49.1
unnamed: LED6.A, R50.1
unnamed: IC11.7, L8.1
unnamed: IC11.6, L8.2
unnamed: Q7.3, RGQ1_11.1
unnamed: L9.2, V+R3.1
unnamed: LED7.A, R70.1
unnamed: LED8.A, R71.1
unnamed: IC15.7, L11.1
unnamed: IC15.6, L11.2
unnamed: Q9.3, RGQ1_14.1
unnamed: L13.2, V+R4.1
unnamed: LED9.A, R88.1
unnamed: LED10.A, R89.1
unnamed: IC19.7, L15.1
unnamed: IC19.6, L15.2
Q1G: D2.A, Q1.1, RGQ1_1.2, RGQ1_2.2
Q1G1: D4.A, Q4.1, RGQ1_4.2, RGQ1_5.2
Q1G2: D6.A, Q6.1, RGQ1_7.2, RGQ1_8.2
Q1G3: D8.A, Q8.1, RGQ1_10.2, RGQ1_11.2
Q1G4: D10.A, Q10.1, RGQ1_13.2, RGQ1_14.2
QBG1: QB1.1, RBG1.1
QBG2: QB2.1, RBG2.1
QBG3: QB3.1, RBG3.1
QBG4: QB4.1, RBG4.1
QBG5: QB5.1, RBG5.1
QBG6: QB6.1, RBG6.1
QBG7: QB7.1, RBG7.1
QBG8: QB8.1, RBG8.1
QBG9: QB9.1, RBG9.1
QBG10: QB10.1, RBG10.1
QBG11: QB11.1, RBG11.1
QBG12: QB12.1, RBG12.1
QBG13: QB13.1, RBG13.1
QBG14: QB14.1, RBG14.1
QBG15: QB15.1, RBG15.1
QBG16: QB16.1, RBG16.1
QBG17: QB17.1, RBG17.1
QBG18: QB18.1, RBG18.1
QBG19: QB19.1, RBG19.1
QBG20: QB20.1, RBG20.1
QBG21: QB21.1, RBG21.1
QBG22: QB22.1, RBG22.1
QBG23: QB23.1, RBG23.1
QBG24: QB24.1, RBG24.1
QBG25: QB25.1, RBG25.1
QBG26: QB26.1, RBG26.1
QBG27: QB27.1, RBG27.1
QBG28: QB28.1, RBG28.1
QBG29: QB29.1, RBG29.1
QBG30: QB30.1, RBG30.1
QBG31: QB31.1, RBG31.1
QBG32: QB32.1, RBG32.1
QBG33: QB33.1, RBG33.1
QBG34: QB34.1, RBG34.1
QBG35: QB35.1, RBG35.1
QBG36: QB36.1, RBG36.1
QBG37: QB37.1, RBG37.1
QBG38: QB38.1, RBG38.1
QBG39: QB39.1, RBG39.1
QBG40: QB40.1, RBG40.1
QBG41: QB41.1, RBG41.1
QBG42: QB42.1, RBG42.1
QBG43: QB43.1, RBG43.1
QBG44: QB44.1, RBG44.1
QBG45: QB45.1, RBG45.1
QBG46: QB46.1, RBG46.1
QBG47: QB47.1, RBG47.1
QBG48: QB48.1, RBG48.1
QBG49: QB49.1, RBG49.1
QBG50: QB50.1, RBG50.1
QBG51: QB51.1, RBG51.1
QBG52: QB52.1, RBG52.1
QBG53: QB53.1, RBG53.1
QBG54: QB54.1, RBG54.1
QBG55: QB55.1, RBG55.1
QBG56: QB56.1, RBG56.1
QBG57: QB57.1, RBG57.1
QBG58: QB58.1, RBG58.1
QBG59: QB59.1, RBG59.1
QBG60: QB60.1, RBG60.1
RS1: IC5.8, R39.1
RS2: IC7.8, R22.1
RS3: IC11.8, R43.1
RS4: IC15.8, R64.1
RS5: IC19.8, R82.1
SCK: IC2.41, R3.2
SCK0: IC1.22, R3.1
SCK2: IC6.41, R13.2
SCK4: IC4.22, R13.1
SCK5: IC10.41, R33.2
SCK7: IC9.22, R33.1
SCK8: IC14.41, R55.2
SCK10: IC13.22, R55.1
SCK11: IC18.41, R75.2
SCK13: IC17.22, R75.1
SDI: IC2.42, R5.2
SDI1: IC6.42, R16.2
SDI2: IC10.42, R35.2
SDI3: IC14.42, R57.2
SDI4: IC18.42, R77.2
SDO: IC2.43, R4.2, R19.1
SDO1: IC6.43, R10.1, R14.2
SDO2: IC10.43, R31.1, R34.2
SDO3: IC14.43, R53.1, R56.2
SDO4: IC18.43, R73.1, R76.2
SSEL0: IC1.10, R1.1
SSEL3: IC4.10, R12.1
SSEL5: IC9.10, R32.1
SSEL7: IC13.10, R54.1
SSEL9: IC17.10, R74.1
SW1: IC3.6, REG5_C2.2, REG5_D2.1, REG5_L.1
SW2: IC8.6, REG5_C7.2, REG5_D4.1, REG5_L1.1
SW3: IC12.6, REG5_C12.2, REG5_D6.1, REG5_L2.1
SW4: IC16.6, REG5_C17.2, REG5_D8.1, REG5_L3.1
SW5: IC20.6, REG5_C22.2, REG5_D10.1, REG5_L4.1
SWCLK: IC1.29, J1.4
SWCLK1: IC4.29, J2.4
SWCLK2: IC9.29, J3.4
SWCLK3: IC13.29, J4.4
SWCLK4: IC17.29, J5.4
SWDIO: IC1.39, J1.3
SWDIO1: IC4.39, J2.3
SWDIO2: IC9.39, J3.3
SWDIO3: IC13.39, J4.3
SWDIO4: IC17.39, J5.3
TEMP0: IC1.42, NTC_C3.1, NTC_R3.1, X1.1
TEMP1: IC1.40, NTC_C2.1, NTC_R2.1, X1.2
TEMP2: IC1.35, NTC_C4.1, NTC_R4.1, X1.4
TEMP3: IC1.34, NTC_C1.1, NTC_R1.1, X1.5
TEMP4: IC4.42, NTC_C5.1, NTC_R5.1, X2.1
TEMP5: IC4.35, NTC_C6.1, NTC_R6.1, X2.4
TEMP6: IC4.34, NTC_C7.1, NTC_R7.1, X2.5
TEMP7: IC4.40, NTC_C8.1, NTC_R8.1, X2.2
TEMP8: IC9.42, NTC_C9.1, NTC_R9.1, X9.1
TEMP9: IC9.35, NTC_C10.1, NTC_R10.1, X9.4
TEMP10: IC9.34, NTC_C11.1, NTC_R11.1, X9.5
TEMP11: IC9.40, NTC_C12.1, NTC_R12.1, X9.2
TEMP12: IC13.42, NTC_C13.1, NTC_R13.1, X13.1
TEMP13: IC13.35, NTC_C14.1, NTC_R14.1, X13.4
TEMP14: IC13.34, NTC_C15.1, NTC_R15.1, X13.5
TEMP15: IC13.40, NTC_C16.1, NTC_R16.1, X13.2
TEMP16: IC17.42, NTC_C17.1, NTC_R17.1, X17.1
TEMP17: IC17.35, NTC_C18.1, NTC_R18.1, X17.4
TEMP18: IC17.34, NTC_C19.1, NTC_R19.1, X17.5
TEMP19: IC17.40, NTC_C20.1, NTC_R20.1, X17.2
TEMPR: C3.1, DT1.A, DT2.A, DT3.A, DT4.A, DT5.A, DT6.A, IC1.33, R9.1
TEMPR1: C24.1, DT7.A, DT8.A, DT9.A, DT10.A, DT11.A, DT12.A, IC4.33, R30.1
TEMPR2: C39.1, DT13.A, DT14.A, DT15.A, DT16.A, DT17.A, DT18.A, IC9.33, R51.1
TEMPR3: C52.1, DT19.A, DT20.A, DT21.A, DT22.A, DT23.A, DT24.A, IC13.33, R72.1
TEMPR4: C65.1, DT25.A, DT26.A, DT27.A, DT28.A, DT29.A, DT30.A, IC17.33, R90.1
V+: C1.1, IC2.1, Q1.3, R59.2
V+1: C11.1, IC6.1, Q4.3, R26.2
V+2: C30.1, IC10.1, Q6.3, R47.2
V+3: C44.1, IC14.1, Q8.3, R68.2
V+4: C57.1, IC18.1, Q10.3, R86.2
V+S: D1.C, D2.C, Q1.2, RGQ1_1.1, V+R.2
V+S1: D3.C, D4.C, Q4.2, RGQ1_4.1, V+R1.2
V+S2: D5.C, D6.C, Q6.2, RGQ1_7.1, V+R2.2
V+S3: D7.C, D8.C, Q8.2, RGQ1_10.1, V+R3.2
V+S4: D9.C, D10.C, Q10.2, RGQ1_13.1, V+R4.2
VREF: CVREF.2, IC2.31
VREF1: CVREF1.2, IC6.31
VREF2: CVREF2.2, IC10.31
VREF3: CVREF3.2, IC14.31
VREF4: CVREF4.2, IC18.31
VREG: CVREG.2, IC2.32
VREG1: CVREG1.2, IC6.32
VREG2: CVREG2.2, IC10.32
VREG3: CVREG3.2, IC14.32
VREG4: CVREG4.2, IC18.32
XTALIN: C15.2, IC1.6, Y1.P3
XTALIN1: C8.2, IC4.6, Y2.P3
XTALIN2: C26.2, IC9.6, Y3.P3
XTALIN3: C41.2, IC13.6, Y4.P3
XTALIN4: C54.2, IC17.6, Y5.P3
XTALOUT: C14.2, IC1.7, Y1.P1
XTALOUT1: C4.2, IC4.7, Y2.P1
XTALOUT2: C25.2, IC9.7, Y3.P1
XTALOUT3: C40.2, IC13.7, Y4.P1
XTALOUT4: C53.2, IC17.7, Y5.P1
