funkobongrip/sprbms/hardware/can/canSlaveV03_16s_nutzen.brd

## EAGLE design hardware/can/canSlaveV03_16s_nutzen.brd (2016-02-18)

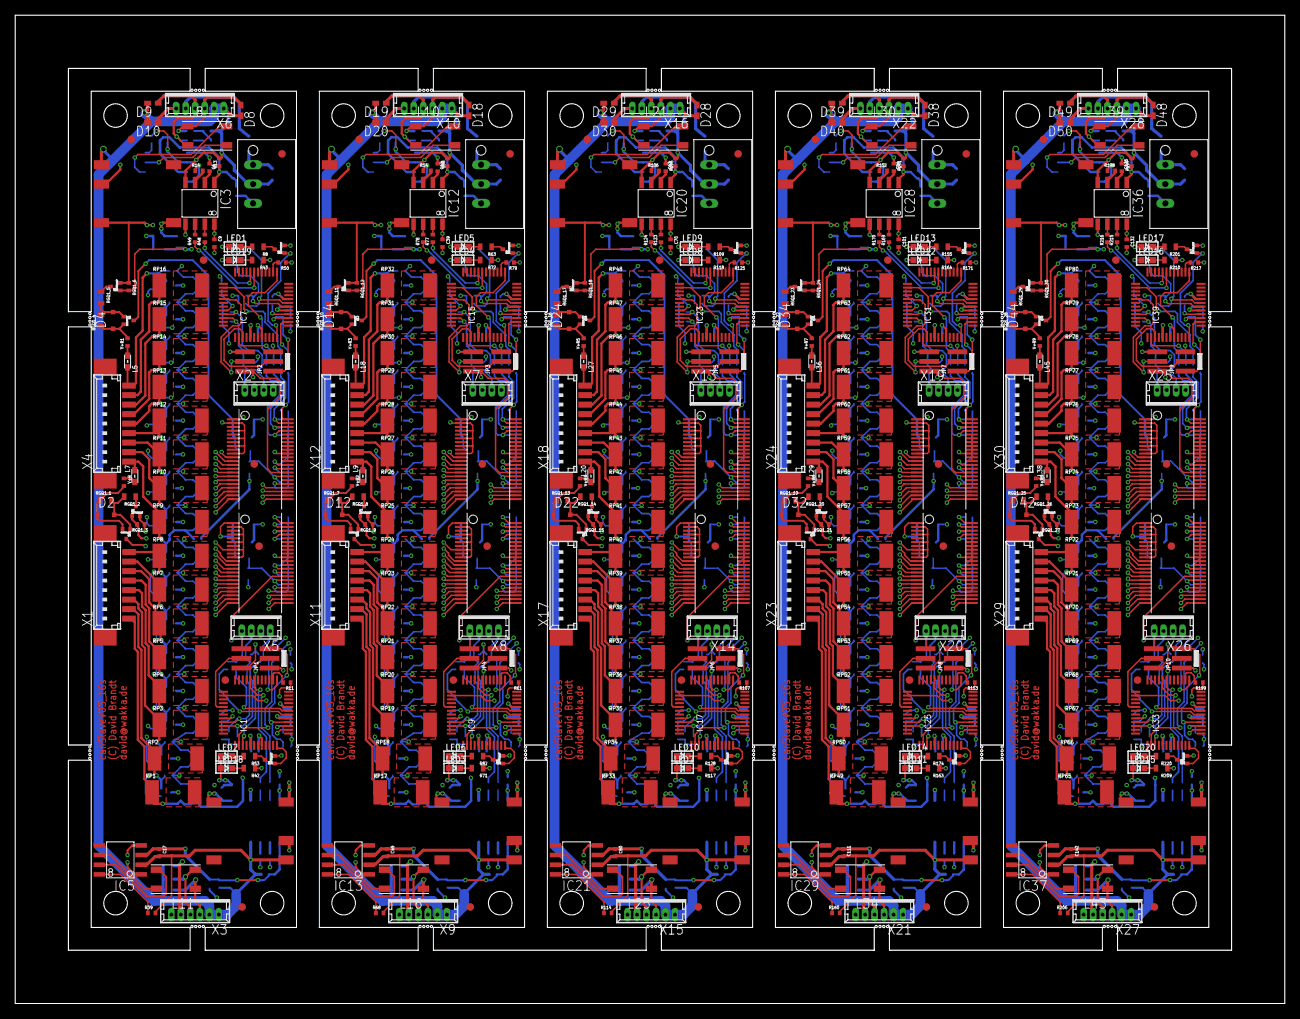
[picture p114: board canSlaveV03_16s_nutzen.brd from above]

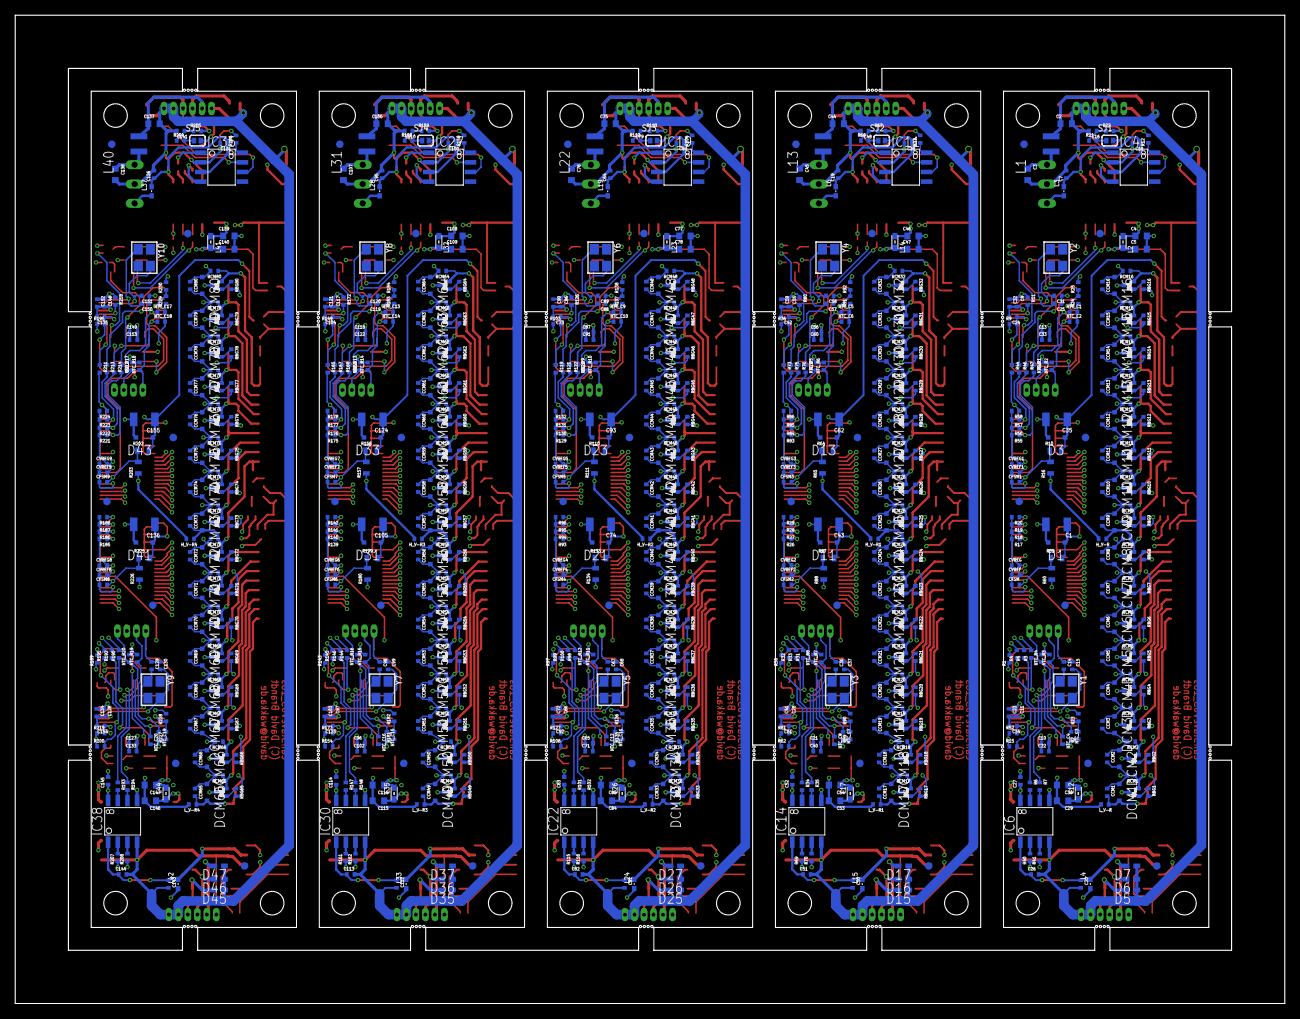
[picture p115: board canSlaveV03_16s_nutzen.brd from below]

Board: 4 copper layers, 167.0 x 130.0 mm, 1310 parts (905 on the bottom side), 895 nets.

Parts:
C1, C35, C43, C62, C74, C93, C105, C124, C136, C155: 10u,50V; C1206
C2, C3, C4, C5, C29, C30, C44, C45, C46, C47, C53, C54, C75, C76, C77, C78, C84, C85, C106, C107, C108, C109, C115, C116, C137, C138, C139, C140, C146, C147: 10u,50V; C0603
C6, C9, C12, C17, C18, C22, C23, C24, C26, C27, C32, C33, C34, C38, C39, C40, C41, C42, C49, C51, C52, C59, C60, C61, C63, C69, C70, C71, C72, C73, C80, C82, C83, C90, C91, C92, C94, C100, C101, C102, C103, C104, C111, C113, C114, C121, C122, C123, C125, C131, C132, C133, C134, C135, C142, C144, C145, C152, C153, C154: 100n; C0402
C7, C19, C20, C50, C64, C81, C95, C112, C126, C143: 1u; C0402
C8, C10, C11, C13, C21, C28, C55, C56, C65, C66, C86, C87, C96, C97, C117, C118, C127, C128, C148, C149: 10n; C0402
C14, C15, C25, C31, C36, C37, C57, C58, C67, C68, C88, C89, C98, C99, C119, C120, C129, C130, C150, C151: 18p; C0402
C16, C48, C79, C110, C141: 47n; C0402
CCM1, CCM2, CCM3, CCM4, CCM5, CCM6, CCM7, CCM8, CCM9, CCM10, CCM11, CCM12, CCM13, CCM14, CCM15, CCM16, CCM17, CCM18, CCM19, CCM20, CCM21, CCM22, CCM23, CCM24, CCM25, CCM26, CCM27, CCM28, CCM29, CCM30, CCM31, CCM32, CCM33, CCM34, CCM35, CCM36, CCM37, CCM38, CCM39, CCM40, CCM41, CCM42, CCM43, CCM44, CCM45, CCM46, CCM47, CCM48, CCM49, CCM50, CCM51, CCM52, CCM53, CCM54, CCM55, CCM56, CCM57, CCM58, CCM59, CCM60, CCM61, CCM62, CCM63, CCM64, CCM65, CCM66, CCM67, CCM68, CCM69, CCM70, CCM71, CCM72, CCM73, CCM74, CCM75, CCM76, CCM77, CCM78, CCM79, CCM80: 100n; C0402
CFSM, CFSM1, CFSM2, CFSM3, CFSM4, CFSM5, CFSM6, CFSM7, CFSM8, CFSM9: 1u; C0402
CVREF, CVREF1, CVREF2, CVREF3, CVREF4, CVREF5, CVREF6, CVREF7, CVREF8, CVREF9: 1u; C0402
CVREG, CVREG1, CVREG2, CVREG3, CVREG4, CVREG5, CVREG6, CVREG7, CVREG8, CVREG9: 1u; C0402
D1, D3, D11, D13, D21, D23, D31, D33, D41, D43: 40V; SOD323-R
D2, D4, D12, D14, D22, D24, D32, D34, D42, D44: 12V; SOD323-R
D5, D6, D7, D8, D9, D10, D15, D16, D17, D18, D19, D20, D25, D26, D27, D28, D29, D30, D35, D36, D37, D38, D39, D40, D45, D46, D47, D48, D49, D50: WE-VE_0402; WESURGE_0402
DCDC1, DCDC2, DCDC3, DCDC4, DCDC5, DCDC6, DCDC7, DCDC8, DCDC9, DCDC10: TES 1-0510; ISF
DCIN, DCIN1, DCIN2, DCIN3, DCIN4: TSR 1-2450; TSR1
DCM1, DCM2, DCM3, DCM4, DCM5, DCM6, DCM7, DCM8, DCM9, DCM10, DCM11, DCM12, DCM13, DCM14, DCM15, DCM16, DCM17, DCM18, DCM19, DCM20, DCM21, DCM22, DCM23, DCM24, DCM25, DCM26, DCM27, DCM28, DCM29, DCM30, DCM31, DCM32, DCM33, DCM34, DCM35, DCM36, DCM37, DCM38, DCM39, DCM40, DCM41, DCM42, DCM43, DCM44, DCM45, DCM46, DCM47, DCM48, DCM49, DCM50, DCM51, DCM52, DCM53, DCM54, DCM55, DCM56, DCM57, DCM58, DCM59, DCM60, DCM61, DCM62, DCM63, DCM64, DCM65, DCM66, DCM67, DCM68, DCM69, DCM70, DCM71, DCM72, DCM73, DCM74, DCM75, DCM76, DCM77, DCM78, DCM79, DCM80: 7.5; SOD323-R
FID1, FID2, FID3, FID4, FID5, FID6, FID7, FID8, FID9, FID10, FID11, FID12, FID13, FID14, FID15, FID16, FID17, FID18, FID19, FID20, FID21, FID22, FID23, FID24, FID25, FID26, FID27, FID28, FID29, FID30, FID31, FID32, FID33, FID34, FID35, FID36, FID37, FID38, FID39, FID40, FID41, FID42, FID43, FID44, FID45, FID46, FID47, FID48, FID49, FID50, FID51, FID52, FID53, FID54, FID55, FID56, FID57, FID58, FID59, FID60, FID61, FID62, FID63, FID64, FID65, FID66, FID67, FID68, FID69, FID70: FIDUCIAL""; FIDUCIAL_1MM
H_V-R, H_V-R1, H_V-R2, H_V-R3, H_V-R4: 100; R0402
IC1, IC7, IC9, IC15, IC17, IC23, IC25, IC31, IC33, IC39: LPC11C1X; LQFP48
IC2, IC8, IC10, IC16, IC18, IC24, IC26, IC32, IC34, IC40: LTC6803-4; 44SSOP
IC3, IC6, IC12, IC14, IC20, IC22, IC28, IC30, IC36, IC38: ADUM1201; SO-8
IC4, IC5, IC11, IC13, IC19, IC21, IC27, IC29, IC35, IC37: MCP2551; SO-8
JP1, JP2, JP3, JP4, JP5, JP6, JP7, JP8, JP9, JP10: 2X03_1.27MM_SMT
L1, L13, L22, L31, L40: WE-PMI_1008
L2, L5, L7, L9, L12, L14, L17, L18, L20, L23, L26, L27, L29, L32, L35, L36, L38, L41, L44, L45: WE-CBF_0603; 0603
L3, L4, L6, L15, L19, L24, L28, L33, L37, L42: WE-CBF_0402; 0402
L8, L10, L11, L16, L21, L25, L30, L34, L39, L43: WE-SL1
LED1, LED2, LED3, LED4, LED5, LED6, LED7, LED8, LED9, LED10, LED11, LED12, LED13, LED14, LED15, LED16, LED17, LED18, LED19, LED20: CHIPLED_0603
L_V-R, L_V-R1, L_V-R2, L_V-R3, L_V-R4: 100; R0402
NTC_C1, NTC_C2, NTC_C3, NTC_C4, NTC_C5, NTC_C6, NTC_C7, NTC_C8, NTC_C9, NTC_C10, NTC_C11, NTC_C12, NTC_C13, NTC_C14, NTC_C15, NTC_C16, NTC_C17, NTC_C18, NTC_C19, NTC_C20: 100n; C0402
NTC_R1, NTC_R2, NTC_R3, NTC_R4, NTC_R5, NTC_R6, NTC_R7, NTC_R8, NTC_R9, NTC_R10, NTC_R11, NTC_R12, NTC_R13, NTC_R14, NTC_R15, NTC_R16, NTC_R17, NTC_R18, NTC_R19, NTC_R20: 1k; R0402
Q1, Q6, Q8, Q12, Q14, Q18, Q20, Q24, Q26, Q30: BSS84AKT; SOT416
Q2, Q3, Q4, Q5, Q7, Q9, Q10, Q11, Q13, Q15, Q16, Q17, Q19, Q21, Q22, Q23, Q25, Q27, Q28, Q29: 2N7002BKT; SOT416
QB1, QB2, QB3, QB4, QB5, QB6, QB7, QB8, QB9, QB10, QB11, QB12, QB13, QB14, QB15, QB16, QB17, QB18, QB19, QB20, QB21, QB22, QB23, QB24, QB25, QB26, QB27, QB28, QB29, QB30, QB31, QB32, QB33, QB34, QB35, QB36, QB37, QB38, QB39, QB40, QB41, QB42, QB43, QB44, QB45, QB46, QB47, QB48, QB49, QB50, QB51, QB52, QB53, QB54, QB55, QB56, QB57, QB58, QB59, QB60, QB61, QB62, QB63, QB64, QB65, QB66, QB67, QB68, QB69, QB70, QB71, QB72, QB73, QB74, QB75, QB76, QB77, QB78, QB79, QB80: PMV65XP; SOT416
R1, R3, R4, R5, R6, R7, R13, R14, R30, R31, R32, R33, R34, R35, R38, R40, R41, R44, R45, R46, R47, R48, R49, R54, R69, R70, R73, R74, R75, R76, R77, R78, R97, R98, R99, R100, R101, R102, R105, R106, R115, R116, R119, R120, R121, R122, R123, R124, R143, R144, R145, R146, R147, R148, R151, R152, R161, R162, R165, R166, R167, R168, R169, R170, R189, R190, R191, R192, R193, R194, R197, R198, R207, R208, R211, R212, R213, R214, R215, R216: 100; R0402
R2, R23, R24, R25, R89, R90, R91, R92, R135, R136, R137, R138, R181, R182, R183, R184, R227, R228, R229, R230: VAR; R0402
R8, R42, R43, R53, R63, R71, R72, R82, R109, R117, R118, R128, R155, R163, R164, R174, R201, R209, R210, R220: 330; R0603
R9, R11, R15, R36, R50, R51, R52, R61, R62, R79, R80, R81, R103, R107, R108, R125, R126, R127, R149, R153, R154, R171, R172, R173, R195, R199, R200, R217, R218, R219: 10k; R0402
R10, R59, R64, R87, R110, R133, R156, R179, R202, R225: 332k0.1%; R0603
R12, R37, R39, R68, R104, R114, R150, R160, R196, R206: 1.5k; R0402
R16, R60, R65, R88, R111, R134, R157, R180, R203, R226: 20k0.1%; R0603
R17, R18, R20, R26, R27, R29, R55, R56, R58, R83, R84, R86, R93, R94, R96, R129, R130, R132, R139, R140, R142, R175, R176, R178, R185, R186, R188, R221, R222, R224: 1M; R0402
R19, R28, R57, R85, R95, R131, R141, R177, R187, R223: 4.7k; R0402
R21, R22, R66, R67, R112, R113, R158, R159, R204, R205: 60; R0402
RBG1, RBG2, RBG3, RBG4, RBG5, RBG6, RBG7, RBG8, RBG9, RBG10, RBG11, RBG12, RBG13, RBG14, RBG15, RBG16, RBG17, RBG18, RBG19, RBG20, RBG21, RBG22, RBG23, RBG24, RBG25, RBG26, RBG27, RBG28, RBG29, RBG30, RBG31, RBG32, RBG33, RBG34, RBG35, RBG36, RBG37, RBG38, RBG39, RBG40, RBG41, RBG42, RBG43, RBG44, RBG45, RBG46, RBG47, RBG48, RBG49, RBG50, RBG51, RBG52, RBG53, RBG54, RBG55, RBG56, RBG57, RBG58, RBG59, RBG60, RBG61, RBG62, RBG63, RBG64, RBG65, RBG66, RBG67, RBG68, RBG69, RBG70, RBG71, RBG72, RBG73, RBG74, RBG75, RBG76, RBG77, RBG78, RBG79, RBG80: 3.3k; R0402
RCM1, RCM2, RCM3, RCM4, RCM5, RCM6, RCM7, RCM8, RCM9, RCM10, RCM11, RCM12, RCM13, RCM14, RCM15, RCM16, RCM17, RCM18, RCM19, RCM20, RCM21, RCM22, RCM23, RCM24, RCM25, RCM26, RCM27, RCM28, RCM29, RCM30, RCM31, RCM32, RCM33, RCM34, RCM35, RCM36, RCM37, RCM38, RCM39, RCM40, RCM41, RCM42, RCM43, RCM44, RCM45, RCM46, RCM47, RCM48, RCM49, RCM50, RCM51, RCM52, RCM53, RCM54, RCM55, RCM56, RCM57, RCM58, RCM59, RCM60, RCM61, RCM62, RCM63, RCM64, RCM65, RCM66, RCM67, RCM68, RCM69, RCM70, RCM71, RCM72, RCM73, RCM74, RCM75, RCM76, RCM77, RCM78, RCM79, RCM80: 100; R0402
RGQ1_1, RGQ1_4, RGQ1_7, RGQ1_10, RGQ1_13, RGQ1_16, RGQ1_19, RGQ1_22, RGQ1_25, RGQ1_28: 1M,50V; R0603
RGQ1_2, RGQ1_5, RGQ1_8, RGQ1_11, RGQ1_14, RGQ1_17, RGQ1_20, RGQ1_23, RGQ1_26, RGQ1_29: 100k,50V; R0603
RGQ1_3, RGQ1_6, RGQ1_9, RGQ1_12, RGQ1_15, RGQ1_18, RGQ1_21, RGQ1_24, RGQ1_27, RGQ1_30: 1M; R0402
RP1, RP2, RP3, RP4, RP5, RP6, RP7, RP8, RP9, RP10, RP11, RP12, RP13, RP14, RP15, RP16, RP17, RP18, RP19, RP20, RP21, RP22, RP23, RP24, RP25, RP26, RP27, RP28, RP29, RP30, RP31, RP32, RP33, RP34, RP35, RP36, RP37, RP38, RP39, RP40, RP41, RP42, RP43, RP44, RP45, RP46, RP47, RP48, RP49, RP50, RP51, RP52, RP53, RP54, RP55, RP56, RP57, RP58, RP59, RP60, RP61, RP62, RP63, RP64, RP65, RP66, RP67, RP68, RP69, RP70, RP71, RP72, RP73, RP74, RP75, RP76, RP77, RP78, RP79, RP80: 22; R2512
SJ1, SJ2, SJ3, SJ4, SJ5: SOLDERJUMPER_REFLOW_NOPASTE_SMALL
V+R, V+R1, V+R2, V+R3, V+R4, V+R5, V+R6, V+R7, V+R8, V+R9: 100; R0402
X1, X11, X17, X23, X29: 53398-08
X2, X5, X7, X8, X13, X14, X19, X20, X25, X26: 53047-04
X3, X6, X9, X10, X15, X16, X21, X22, X27, X28: 53047-06
X4, X12, X18, X24, X30: 53398-09
Y1, Y2, Y3, Y4, Y5, Y6, Y7, Y8, Y9, Y10: CRYSTAL_3.2X2.5

Connections:
+3V3DCOUT: C4.1, DCDC1.5, L2.2
+3V3DCOUT1: C29.1, DCDC2.5, L12.2
+3V3DCOUT2: C46.1, DCDC3.5, L14.2
+3V3DCOUT3: C53.1, DCDC4.5, L17.2
+3V3DCOUT4: C77.1, DCDC5.5, L23.2
+3V3DCOUT5: C84.1, DCDC6.5, L26.2
+3V3DCOUT6: C108.1, DCDC7.5, L32.2
+3V3DCOUT7: C115.1, DCDC8.5, L35.2
+3V3DCOUT8: C139.1, DCDC9.5, L41.2
+3V3DCOUT9: C146.1, DCDC10.5, L44.2
BAL1: IC2.25, RBG1.2
BAL2: IC2.23, RBG2.2
BAL3: IC2.21, RBG3.2
BAL4: IC2.19, RBG4.2
BAL5: IC2.17, RBG5.2
BAL6: IC2.15, RBG6.2
BAL7: IC2.13, RBG7.2
BAL8: IC2.11, RBG8.2
BAL9: IC8.25, RBG9.2
BAL10: IC8.23, RBG10.2
BAL11: IC8.21, RBG11.2
BAL12: IC8.19, RBG12.2
BAL13: IC8.17, RBG13.2
BAL14: IC8.15, RBG14.2
BAL15: IC8.13, RBG15.2
BAL16: IC8.11, RBG16.2
BAL17: IC10.25, RBG17.2
BAL18: IC10.23, RBG18.2
BAL19: IC10.21, RBG19.2
BAL20: IC10.19, RBG20.2
BAL21: IC10.17, RBG21.2
BAL22: IC10.15, RBG22.2
BAL23: IC10.13, RBG23.2
BAL24: IC10.11, RBG24.2
BAL25: IC16.25, RBG25.2
BAL26: IC16.23, RBG26.2
BAL27: IC16.21, RBG27.2
BAL28: IC16.19, RBG28.2
BAL29: IC16.17, RBG29.2
BAL30: IC16.15, RBG30.2
BAL31: IC16.13, RBG31.2
BAL32: IC16.11, RBG32.2
BAL33: IC18.25, RBG33.2
BAL34: IC18.23, RBG34.2
BAL35: IC18.21, RBG35.2
BAL36: IC18.19, RBG36.2
BAL37: IC18.17, RBG37.2
BAL38: IC18.15, RBG38.2
BAL39: IC18.13, RBG39.2
BAL40: IC18.11, RBG40.2
BAL41: IC24.25, RBG41.2
BAL42: IC24.23, RBG42.2
BAL43: IC24.21, RBG43.2
BAL44: IC24.19, RBG44.2
BAL45: IC24.17, RBG45.2
BAL46: IC24.15, RBG46.2
BAL47: IC24.13, RBG47.2
BAL48: IC24.11, RBG48.2
BAL49: IC26.25, RBG49.2
BAL50: IC26.23, RBG50.2
BAL51: IC26.21, RBG51.2
BAL52: IC26.19, RBG52.2
BAL53: IC26.17, RBG53.2
BAL54: IC26.15, RBG54.2
BAL55: IC26.13, RBG55.2
BAL56: IC26.11, RBG56.2
BAL57: IC32.25, RBG57.2
BAL58: IC32.23, RBG58.2
BAL59: IC32.21, RBG59.2
BAL60: IC32.19, RBG60.2
BAL61: IC32.17, RBG61.2
BAL62: IC32.15, RBG62.2
BAL63: IC32.13, RBG63.2
BAL64: IC32.11, RBG64.2
BAL65: IC34.25, RBG65.2
BAL66: IC34.23, RBG66.2
BAL67: IC34.21, RBG67.2
BAL68: IC34.19, RBG68.2
BAL69: IC34.17, RBG69.2
BAL70: IC34.15, RBG70.2
BAL71: IC34.13, RBG71.2
BAL72: IC34.11, RBG72.2
BAL73: IC40.25, RBG73.2
BAL74: IC40.23, RBG74.2
BAL75: IC40.21, RBG75.2
BAL76: IC40.19, RBG76.2
BAL77: IC40.17, RBG77.2
BAL78: IC40.15, RBG78.2
BAL79: IC40.13, RBG79.2
BAL80: IC40.11, RBG80.2
C0: CCM1.2, DCM1.A, IC2.26, L_V-R.1, RP1.1, X1.8
C1: QB1.2, RCM1.1, RP2.1, X1.7
C1M: CCM1.1, CCM2.2, DCM1.C, DCM2.A, IC2.24, RCM1.2
C1M1: CCM17.1, CCM18.2, DCM17.C, DCM18.A, IC10.24, RCM17.2
C1M2: CCM33.1, CCM34.2, DCM33.C, DCM34.A, IC18.24, RCM33.2
C1M3: CCM49.1, CCM50.2, DCM49.C, DCM50.A, IC26.24, RCM49.2
C1M4: CCM65.1, CCM66.2, DCM65.C, DCM66.A, IC34.24, RCM65.2
C2: QB2.2, RCM2.1, RP3.1, X1.6
C2M: CCM2.1, CCM3.2, DCM2.C, DCM3.A, IC2.22, RCM2.2
C2M1: CCM18.1, CCM19.2, DCM18.C, DCM19.A, IC10.22, RCM18.2
C2M2: CCM34.1, CCM35.2, DCM34.C, DCM35.A, IC18.22, RCM34.2
C2M3: CCM50.1, CCM51.2, DCM50.C, DCM51.A, IC26.22, RCM50.2
C2M4: CCM66.1, CCM67.2, DCM66.C, DCM67.A, IC34.22, RCM66.2
C3: QB3.2, RCM3.1, RP4.1, X1.5
C3M: CCM3.1, CCM4.2, DCM3.C, DCM4.A, IC2.20, RCM3.2
C3M1: CCM19.1, CCM20.2, DCM19.C, DCM20.A, IC10.20, RCM19.2
C3M2: CCM35.1, CCM36.2, DCM35.C, DCM36.A, IC18.20, RCM35.2
C3M3: CCM51.1, CCM52.2, DCM51.C, DCM52.A, IC26.20, RCM51.2
C3M4: CCM67.1, CCM68.2, DCM67.C, DCM68.A, IC34.20, RCM67.2
C4: QB4.2, RCM4.1, RP5.1, X1.4
C4M: CCM4.1, CCM5.2, DCM4.C, DCM5.A, IC2.18, RCM4.2
C4M1: CCM20.1, CCM21.2, DCM20.C, DCM21.A, IC10.18, RCM20.2
C4M2: CCM36.1, CCM37.2, DCM36.C, DCM37.A, IC18.18, RCM36.2
C4M3: CCM52.1, CCM53.2, DCM52.C, DCM53.A, IC26.18, RCM52.2
C4M4: CCM68.1, CCM69.2, DCM68.C, DCM69.A, IC34.18, RCM68.2
C5: QB5.2, RCM5.1, RP6.1, X1.3
C5M: CCM5.1, CCM6.2, DCM5.C, DCM6.A, IC2.16, RCM5.2
C5M1: CCM21.1, CCM22.2, DCM21.C, DCM22.A, IC10.16, RCM21.2
C5M2: CCM37.1, CCM38.2, DCM37.C, DCM38.A, IC18.16, RCM37.2
C5M3: CCM53.1, CCM54.2, DCM53.C, DCM54.A, IC26.16, RCM53.2
C5M4: CCM69.1, CCM70.2, DCM69.C, DCM70.A, IC34.16, RCM69.2
C6: QB6.2, RCM6.1, RP7.1, X1.2
C6M: CCM6.1, CCM7.2, DCM6.C, DCM7.A, IC2.14, RCM6.2
C6M1: CCM22.1, CCM23.2, DCM22.C, DCM23.A, IC10.14, RCM22.2
C6M2: CCM38.1, CCM39.2, DCM38.C, DCM39.A, IC18.14, RCM38.2
C6M3: CCM54.1, CCM55.2, DCM54.C, DCM55.A, IC26.14, RCM54.2
C6M4: CCM70.1, CCM71.2, DCM70.C, DCM71.A, IC34.14, RCM70.2
C7: QB7.2, RCM7.1, RP8.1, X1.1
C7M: CCM7.1, CCM8.2, DCM7.C, DCM8.A, IC2.12, RCM7.2
C7M1: CCM23.1, CCM24.2, DCM23.C, DCM24.A, IC10.12, RCM23.2
C7M2: CCM39.1, CCM40.2, DCM39.C, DCM40.A, IC18.12, RCM39.2
C7M3: CCM55.1, CCM56.2, DCM55.C, DCM56.A, IC26.12, RCM55.2
C7M4: CCM71.1, CCM72.2, DCM71.C, DCM72.A, IC34.12, RCM71.2
C8: CCM9.2, DCM9.A, H_V-R.1, IC8.26, L7.1, QB8.2, RCM8.1, RP9.1, X4.9
C8M: CCM8.1, DCM8.C, IC2.2, IC2.4, IC2.6, IC2.8, IC2.10, RCM8.2
C8M1: CCM24.1, DCM24.C, IC10.2, IC10.4, IC10.6, IC10.8, IC10.10, RCM24.2
C8M2: CCM40.1, DCM40.C, IC18.2, IC18.4, IC18.6, IC18.8, IC18.10, RCM40.2
C8M3: CCM56.1, DCM56.C, IC26.2, IC26.4, IC26.6, IC26.8, IC26.10, RCM56.2
C8M4: CCM72.1, DCM72.C, IC34.2, IC34.4, IC34.6, IC34.8, IC34.10, RCM72.2
C9: QB9.2, RCM9.1, RP10.1, X4.8
C9M: CCM9.1, CCM10.2, DCM9.C, DCM10.A, IC8.24, RCM9.2
C9M1: CCM25.1, CCM26.2, DCM25.C, DCM26.A, IC16.24, RCM25.2
C9M2: CCM41.1, CCM42.2, DCM41.C, DCM42.A, IC24.24, RCM41.2
C9M3: CCM57.1, CCM58.2, DCM57.C, DCM58.A, IC32.24, RCM57.2
C9M4: CCM73.1, CCM74.2, DCM73.C, DCM74.A, IC40.24, RCM73.2
C10: QB10.2, RCM10.1, RP11.1, X4.7
C10M: CCM10.1, CCM11.2, DCM10.C, DCM11.A, IC8.22, RCM10.2
C10M1: CCM26.1, CCM27.2, DCM26.C, DCM27.A, IC16.22, RCM26.2
C10M2: CCM42.1, CCM43.2, DCM42.C, DCM43.A, IC24.22, RCM42.2
C10M3: CCM58.1, CCM59.2, DCM58.C, DCM59.A, IC32.22, RCM58.2
C10M4: CCM74.1, CCM75.2, DCM74.C, DCM75.A, IC40.22, RCM74.2
C11: QB11.2, RCM11.1, RP12.1, X4.6
C11M: CCM11.1, CCM12.2, DCM11.C, DCM12.A, IC8.20, RCM11.2
C11M1: CCM27.1, CCM28.2, DCM27.C, DCM28.A, IC16.20, RCM27.2
C11M2: CCM43.1, CCM44.2, DCM43.C, DCM44.A, IC24.20, RCM43.2
C11M3: CCM59.1, CCM60.2, DCM59.C, DCM60.A, IC32.20, RCM59.2
C11M4: CCM75.1, CCM76.2, DCM75.C, DCM76.A, IC40.20, RCM75.2
C12: QB12.2, RCM12.1, RP13.1, X4.5
C12M: CCM12.1, CCM13.2, DCM12.C, DCM13.A, IC8.18, RCM12.2
C12M1: CCM28.1, CCM29.2, DCM28.C, DCM29.A, IC16.18, RCM28.2
C12M2: CCM44.1, CCM45.2, DCM44.C, DCM45.A, IC24.18, RCM44.2
C12M3: CCM60.1, CCM61.2, DCM60.C, DCM61.A, IC32.18, RCM60.2
C12M4: CCM76.1, CCM77.2, DCM76.C, DCM77.A, IC40.18, RCM76.2
C13: QB13.2, RCM13.1, RP14.1, X4.4
C13M: CCM13.1, CCM14.2, DCM13.C, DCM14.A, IC8.16, RCM13.2
C13M1: CCM29.1, CCM30.2, DCM29.C, DCM30.A, IC16.16, RCM29.2
C13M2: CCM45.1, CCM46.2, DCM45.C, DCM46.A, IC24.16, RCM45.2
C13M3: CCM61.1, CCM62.2, DCM61.C, DCM62.A, IC32.16, RCM61.2
C13M4: CCM77.1, CCM78.2, DCM77.C, DCM78.A, IC40.16, RCM77.2
C14: QB14.2, RCM14.1, RP15.1, X4.3
C14M: CCM14.1, CCM15.2, DCM14.C, DCM15.A, IC8.14, RCM14.2
C14M1: CCM30.1, CCM31.2, DCM30.C, DCM31.A, IC16.14, RCM30.2
C14M2: CCM46.1, CCM47.2, DCM46.C, DCM47.A, IC24.14, RCM46.2
C14M3: CCM62.1, CCM63.2, DCM62.C, DCM63.A, IC32.14, RCM62.2
C14M4: CCM78.1, CCM79.2, DCM78.C, DCM79.A, IC40.14, RCM78.2
C15: QB15.2, RCM15.1, RP16.1, X4.2
C15M: CCM15.1, CCM16.2, DCM15.C, DCM16.A, IC8.12, RCM15.2
C15M1: CCM31.1, CCM32.2, DCM31.C, DCM32.A, IC16.12, RCM31.2
C15M2: CCM47.1, CCM48.2, DCM47.C, DCM48.A, IC24.12, RCM47.2
C15M3: CCM63.1, CCM64.2, DCM63.C, DCM64.A, IC32.12, RCM63.2
C15M4: CCM79.1, CCM80.2, DCM79.C, DCM80.A, IC40.12, RCM79.2
C16: L5.1, QB16.2, RCM16.1, X4.1
C16M: CCM16.1, DCM16.C, IC8.2, IC8.4, IC8.6, IC8.8, IC8.10, RCM16.2
C16M1: CCM32.1, DCM32.C, IC16.2, IC16.4, IC16.6, IC16.8, IC16.10, RCM32.2
C16M2: CCM48.1, DCM48.C, IC24.2, IC24.4, IC24.6, IC24.8, IC24.10, RCM48.2
C16M3: CCM64.1, DCM64.C, IC32.2, IC32.4, IC32.6, IC32.8, IC32.10, RCM64.2
C16M4: CCM80.1, DCM80.C, IC40.2, IC40.4, IC40.6, IC40.8, IC40.10, RCM80.2
C17: CCM17.2, DCM17.A, IC10.26, L_V-R1.1, RP17.1, X11.8
C18: CCM25.2, DCM25.A, H_V-R1.1, IC16.26, L9.1, QB24.2, RCM24.1, RP25.1, X12.9
C19: L18.1, QB32.2, RCM32.1, X12.1
C20: QB18.2, RCM18.1, RP19.1, X11.6
C21: QB17.2, RCM17.1, RP18.1, X11.7
C22: QB19.2, RCM19.1, RP20.1, X11.5
C23: QB20.2, RCM20.1, RP21.1, X11.4
C24: QB21.2, RCM21.1, RP22.1, X11.3
C25: QB22.2, RCM22.1, RP23.1, X11.2
C26: QB23.2, RCM23.1, RP24.1, X11.1
C27: QB25.2, RCM25.1, RP26.1, X12.8
C28: QB26.2, RCM26.1, RP27.1, X12.7
C29: QB27.2, RCM27.1, RP28.1, X12.6
C30: QB28.2, RCM28.1, RP29.1, X12.5
C31: QB29.2, RCM29.1, RP30.1, X12.4
C32: QB30.2, RCM30.1, RP31.1, X12.3
C33: QB31.2, RCM31.1, RP32.1, X12.2
C34: CCM33.2, DCM33.A, IC18.26, L_V-R2.1, RP33.1, X17.8
C35: CCM41.2, DCM41.A, H_V-R2.1, IC24.26, L20.1, QB40.2, RCM40.1, RP41.1, X18.9
C36: L27.1, QB48.2, RCM48.1, X18.1
C37: QB34.2, RCM34.1, RP35.1, X17.6
C38: QB33.2, RCM33.1, RP34.1, X17.7
C39: QB35.2, RCM35.1, RP36.1, X17.5
C40: QB36.2, RCM36.1, RP37.1, X17.4
C41: QB37.2, RCM37.1, RP38.1, X17.3
C42: QB38.2, RCM38.1, RP39.1, X17.2
C43: QB39.2, RCM39.1, RP40.1, X17.1
C44: QB41.2, RCM41.1, RP42.1, X18.8
C45: QB42.2, RCM42.1, RP43.1, X18.7
C46: QB43.2, RCM43.1, RP44.1, X18.6
C47: QB44.2, RCM44.1, RP45.1, X18.5
C48: QB45.2, RCM45.1, RP46.1, X18.4
C49: QB46.2, RCM46.1, RP47.1, X18.3
C50: QB47.2, RCM47.1, RP48.1, X18.2
C51: CCM49.2, DCM49.A, IC26.26, L_V-R3.1, RP49.1, X23.8
C52: CCM57.2, DCM57.A, H_V-R3.1, IC32.26, L29.1, QB56.2, RCM56.1, RP57.1, X24.9
C53: L36.1, QB64.2, RCM64.1, X24.1
C54: QB50.2, RCM50.1, RP51.1, X23.6
C55: QB49.2, RCM49.1, RP50.1, X23.7
C56: QB51.2, RCM51.1, RP52.1, X23.5
C57: QB52.2, RCM52.1, RP53.1, X23.4
C58: QB53.2, RCM53.1, RP54.1, X23.3
C59: QB54.2, RCM54.1, RP55.1, X23.2
C60: QB55.2, RCM55.1, RP56.1, X23.1
C61: QB57.2, RCM57.1, RP58.1, X24.8
C62: QB58.2, RCM58.1, RP59.1, X24.7
C63: QB59.2, RCM59.1, RP60.1, X24.6
C64: QB60.2, RCM60.1, RP61.1, X24.5
C65: QB61.2, RCM61.1, RP62.1, X24.4
C66: QB62.2, RCM62.1, RP63.1, X24.3
C67: QB63.2, RCM63.1, RP64.1, X24.2
C68: CCM65.2, DCM65.A, IC34.26, L_V-R4.1, RP65.1, X29.8
C69: CCM73.2, DCM73.A, H_V-R4.1, IC40.26, L38.1, QB72.2, RCM72.1, RP73.1, X30.9
C70: L45.1, QB80.2, RCM80.1, X30.1
C71: QB66.2, RCM66.1, RP67.1, X29.6
C72: QB65.2, RCM65.1, RP66.1, X29.7
C73: QB67.2, RCM67.1, RP68.1, X29.5
C74: QB68.2, RCM68.1, RP69.1, X29.4
C75: QB69.2, RCM69.1, RP70.1, X29.3
C76: QB70.2, RCM70.1, RP71.1, X29.2
C77: QB71.2, RCM71.1, RP72.1, X29.1
C78: QB73.2, RCM73.1, RP74.1, X30.8
C79: QB74.2, RCM74.1, RP75.1, X30.7
C80: QB75.2, RCM75.1, RP76.1, X30.6
C81: QB76.2, RCM76.1, RP77.1, X30.5
C82: QB77.2, RCM77.1, RP78.1, X30.4
C83: QB78.2, RCM78.1, RP79.1, X30.3
C84: QB79.2, RCM79.1, RP80.1, X30.2
CANH: D6.1, D9.2, L8.1, L11.1, SJ1.2, X3.3, X6.3
CANH1: D16.1, D19.2, L10.1, L16.1, SJ2.2, X9.3, X10.3
CANH2: D26.1, D29.2, L21.1, L25.1, SJ3.2, X15.3, X16.3
CANH3: D36.1, D39.2, L30.1, L34.1, SJ4.2, X21.3, X22.3
CANH4: D46.1, D49.2, L39.1, L43.1, SJ5.2, X27.3, X28.3
CANJ: R21.2, SJ1.1
CANJ1: R66.2, SJ2.1
CANJ2: R112.2, SJ3.1
CANJ3: R158.2, SJ4.1
CANJ4: R204.2, SJ5.1
CANL: D5.1, D8.2, L8.3, L11.3, R22.2, X3.4, X6.4
CANL1: D15.1, D18.2, L10.3, L16.3, R67.2, X9.4, X10.4
CANL2: D25.1, D28.2, L21.3, L25.3, R113.2, X15.4, X16.4
CANL3: D35.1, D38.2, L30.3, L34.3, R159.2, X21.4, X22.4
CANL4: D45.1, D48.2, L39.3, L43.3, R205.2, X27.4, X28.4
CANRX_U_H: IC7.19, R49.1
CANRX_U_H1: IC15.19, R78.1
CANRX_U_H2: IC23.19, R124.1
CANRX_U_H3: IC31.19, R170.1
CANRX_U_H4: IC39.19, R216.1
CANRX_U_L: IC1.19, R7.1
CANRX_U_L1: IC9.19, R35.1
CANRX_U_L2: IC17.19, R102.1
CANRX_U_L3: IC25.19, R148.1
CANRX_U_L4: IC33.19, R194.1
CANT: C16.1, R21.1, R22.1
CANT1: C48.1, R66.1, R67.1
CANT2: C79.1, R112.1, R113.1
CANT3: C110.1, R158.1, R159.1
CANT4: C141.1, R204.1, R205.1
CANTX_U_H: IC7.20, R48.1
CANTX_U_H1: IC15.20, R77.1
CANTX_U_H2: IC23.20, R123.1
CANTX_U_H3: IC31.20, R169.1
CANTX_U_H4: IC39.20, R215.1
CANTX_U_L: IC1.20, R6.1
CANTX_U_L1: IC9.20, R34.1
CANTX_U_L2: IC17.20, R101.1
CANTX_U_L3: IC25.20, R147.1
CANTX_U_L4: IC33.20, R193.1
CAR+5V: DCDC1.2, DCDC2.2, DCIN.3, L3.2, L4.2
CAR+5V1: DCDC3.2, DCDC4.2, DCIN1.3, L6.2, L15.2
CAR+5V2: DCDC5.2, DCDC6.2, DCIN2.3, L19.2, L24.2
CAR+5V3: DCDC7.2, DCDC8.2, DCIN3.3, L28.2, L33.2
CAR+5V4: DCDC9.2, DCDC10.2, DCIN4.3, L37.2, L42.2
CAR+5V_H: C6.1, C7.1, C18.1, IC3.1, IC4.3, L3.1
CAR+5V_H1: C12.1, C19.1, C38.1, IC11.3, IC12.1, L6.1
CAR+5V_H2: C63.1, C64.1, C69.1, IC19.3, IC20.1, L19.1
CAR+5V_H3: C94.1, C95.1, C100.1, IC27.3, IC28.1, L28.1
CAR+5V_H4: C125.1, C126.1, C131.1, IC35.3, IC36.1, L37.1
CAR+5V_LFILT: C17.1, C20.1, C26.1, IC5.3, IC6.1, L4.1
CAR+5V_LFILT1: C49.1, C50.1, C51.1, IC13.3, IC14.1, L15.1
CAR+5V_LFILT2: C80.1, C81.1, C82.1, IC21.3, IC22.1, L24.1
CAR+5V_LFILT3: C111.1, C112.1, C113.1, IC29.3, IC30.1, L33.1
CAR+5V_LFILT4: C142.1, C143.1, C144.1, IC37.3, IC38.1, L42.1
CAR+12V: C3.1, DCIN.1, L1.1
CAR+12V1: C45.1, DCIN1.1, L13.1
CAR+12V2: C76.1, DCIN2.1, L22.1
CAR+12V3: C107.1, DCIN3.1, L31.1
CAR+12V4: C138.1, DCIN4.1, L40.1
CAR+12VIN: C2.1, D7.1, D10.2, L1.2, X3.1, X3.2, X6.1, X6.2
CAR+12VIN1: C44.1, D17.1, D20.2, L13.2, X9.1, X9.2, X10.1, X10.2
CAR+12VIN2: C75.1, D27.1, D30.2, L22.2, X15.1, X15.2, X16.1, X16.2
CAR+12VIN3: C106.1, D37.1, D40.2, L31.2, X21.1, X21.2, X22.1, X22.2
CAR+12VIN4: C137.1, D47.1, D50.2, L40.2, X27.1, X27.2, X28.1, X28.2
CARGND: C2.2, C3.2, C6.2, C7.2, C16.2, C17.2, C18.2, C20.2, C26.2, D5.2, D6.2, D7.2, D8.1, D9.1, D10.1, DCDC1.1, DCDC2.1, DCIN.2, IC3.4, IC4.2, IC5.2, IC6.4, R12.2, R39.2, X3.5, X3.6, X6.5, X6.6
CARGND1: C12.2, C19.2, C38.2, C44.2, C45.2, C48.2, C49.2, C50.2, C51.2, D15.2, D16.2, D17.2, D18.1, D19.1, D20.1, DCDC3.1, DCDC4.1, DCIN1.2, IC11.2, IC12.4, IC13.2, IC14.4, R37.2, R68.2, X9.5, X9.6, X10.5, X10.6
CARGND2: C63.2, C64.2, C69.2, C75.2, C76.2, C79.2, C80.2, C81.2, C82.2, D25.2, D26.2, D27.2, D28.1, D29.1, D30.1, DCDC5.1, DCDC6.1, DCIN2.2, IC19.2, IC20.4, IC21.2, IC22.4, R104.2, R114.2, X15.5, X15.6, X16.5, X16.6
CARGND3: C94.2, C95.2, C100.2, C106.2, C107.2, C110.2, C111.2, C112.2, C113.2, D35.2, D36.2, D37.2, D38.1, D39.1, D40.1, DCDC7.1, DCDC8.1, DCIN3.2, IC27.2, IC28.4, IC29.2, IC30.4, R150.2, R160.2, X21.5, X21.6, X22.5, X22.6
CARGND4: C125.2, C126.2, C131.2, C137.2, C138.2, C141.2, C142.2, C143.2, C144.2, D45.2, D46.2, D47.2, D48.1, D49.1, D50.1, DCDC9.1, DCDC10.1, DCIN4.2, IC35.2, IC36.4, IC37.2, IC38.4, R196.2, R206.2, X27.5, X27.6, X28.5, X28.6
CR1: QB1.3, RP1.2
CR2: QB2.3, RP2.2
CR3: QB3.3, RP3.2
CR4: QB4.3, RP4.2
CR5: QB5.3, RP5.2
CR6: QB6.3, RP6.2
CR7: QB7.3, RP7.2
CR8: QB8.3, RP8.2
CR9: QB9.3, RP9.2
CR10: QB10.3, RP10.2
CR11: QB11.3, RP11.2
CR12: QB12.3, RP12.2
CR13: QB13.3, RP13.2
CR14: QB14.3, RP14.2
CR15: QB15.3, RP15.2
CR16: QB16.3, RP16.2
CR17: QB17.3, RP17.2
CR18: QB18.3, RP18.2
CR19: QB19.3, RP19.2
CR20: QB20.3, RP20.2
CR21: QB21.3, RP21.2
CR22: QB22.3, RP22.2
CR23: QB23.3, RP23.2
CR24: QB24.3, RP24.2
CR25: QB25.3, RP25.2
CR26: QB26.3, RP26.2
CR27: QB27.3, RP27.2
CR28: QB28.3, RP28.2
CR29: QB29.3, RP29.2
CR30: QB30.3, RP30.2
CR31: QB31.3, RP31.2
CR32: QB32.3, RP32.2
CR33: QB33.3, RP33.2
CR34: QB34.3, RP34.2
CR35: QB35.3, RP35.2
CR36: QB36.3, RP36.2
CR37: QB37.3, RP37.2
CR38: QB38.3, RP38.2
CR39: QB39.3, RP39.2
CR40: QB40.3, RP40.2
CR41: QB41.3, RP41.2
CR42: QB42.3, RP42.2
CR43: QB43.3, RP43.2
CR44: QB44.3, RP44.2
CR45: QB45.3, RP45.2
CR46: QB46.3, RP46.2
CR47: QB47.3, RP47.2
CR48: QB48.3, RP48.2
CR49: QB49.3, RP49.2
CR50: QB50.3, RP50.2
CR51: QB51.3, RP51.2
CR52: QB52.3, RP52.2
CR53: QB53.3, RP53.2
CR54: QB54.3, RP54.2
CR55: QB55.3, RP55.2
CR56: QB56.3, RP56.2
CR57: QB57.3, RP57.2
CR58: QB58.3, RP58.2
CR59: QB59.3, RP59.2
CR60: QB60.3, RP60.2
CR61: QB61.3, RP61.2
CR62: QB62.3, RP62.2
CR63: QB63.3, RP63.2
CR64: QB64.3, RP64.2
CR65: QB65.3, RP65.2
CR66: QB66.3, RP66.2
CR67: QB67.3, RP67.2
CR68: QB68.3, RP68.2
CR69: QB69.3, RP69.2
CR70: QB70.3, RP70.2
CR71: QB71.3, RP71.2
CR72: QB72.3, RP72.2
CR73: QB73.3, RP73.2
CR74: QB74.3, RP74.2
CR75: QB75.3, RP75.2
CR76: QB76.3, RP76.2
CR77: QB77.3, RP77.2
CR78: QB78.3, RP78.2
CR79: QB79.3, RP79.2
CR80: QB80.3, RP80.2
H+3V1: C39.1, C47.1, C55.1, C56.1, C59.1, C60.1, IC12.8, IC15.8, IC15.44, IC16.30, JP3.2, L14.1, LED4.A, LED5.A, NTC_R5.2, NTC_R6.2, Q11.1, R36.1, R80.1, R92.2, RGQ1_12.2
H+3V2: C70.1, C78.1, C86.1, C87.1, C90.1, C91.1, IC20.8, IC23.8, IC23.44, IC24.30, JP5.2, L23.1, LED8.A, LED9.A, NTC_R9.2, NTC_R10.2, Q17.1, R103.1, R126.1, R138.2, RGQ1_18.2
H+3V3: C5.1, C8.1, C9.1, C13.1, C32.1, C33.1, IC3.8, IC7.8, IC7.44, IC8.30, JP2.2, L2.1, LED1.A, LED19.A, NTC_R1.2, NTC_R2.2, Q5.1, R9.1, R25.2, R51.1, RGQ1_6.2
H+3V4: C101.1, C109.1, C117.1, C118.1, C121.1, C122.1, IC28.8, IC31.8, IC31.44, IC32.30, JP7.2, L32.1, LED12.A, LED13.A, NTC_R13.2, NTC_R14.2, Q23.1, R149.1, R172.1, R184.2, RGQ1_24.2
H+3V5: C132.1, C140.1, C148.1, C149.1, C152.1, C153.1, IC36.8, IC39.8, IC39.44, IC40.30, JP9.2, L41.1, LED16.A, LED17.A, NTC_R17.2, NTC_R18.2, Q29.1, R195.1, R218.1, R230.2, RGQ1_30.2
HCANHL: IC4.7, L8.5
HCANHL1: IC11.7, L10.5
HCANHL2: IC19.7, L21.5
HCANHL3: IC27.7, L30.5
HCANHL4: IC35.7, L39.5
HCANLL: IC4.6, L8.4
HCANLL1: IC11.6, L10.4
HCANLL2: IC19.6, L21.4
HCANLL3: IC27.6, L30.4
HCANLL4: IC35.6, L39.4
HGND: C4.2, C5.2, C8.2, C9.2, C13.2, C24.2, C25.1, C31.1, C32.2, C33.2, C35.2, CFSM1.1, CVREF1.1, CVREG1.1, D3.A, DCDC1.4, H_V-R.2, IC3.5, IC7.5, IC7.41, IC8.27, IC8.33, IC8.34, IC8.35, IC8.36, IC8.37, IC8.38, IC8.39, IC8.40, JP2.6, NTC_C1.2, NTC_C2.2, Q3.2, Q5.2, R16.1, R24.1, R43.1, R50.1, RGQ1_6.1, X2.1, X2.3
HGND1: C39.2, C42.2, C46.2, C47.2, C55.2, C56.2, C57.1, C58.1, C59.2, C60.2, C62.2, CFSM3.1, CVREF3.1, CVREG3.1, D13.A, DCDC3.4, H_V-R1.2, IC12.5, IC15.5, IC15.41, IC16.27, IC16.33, IC16.34, IC16.35, IC16.36, IC16.37, IC16.38, IC16.39, IC16.40, JP3.6, NTC_C5.2, NTC_C6.2, Q9.2, Q11.2, R65.1, R72.1, R79.1, R91.1, RGQ1_12.1, X7.1, X7.3
HGND2: C70.2, C73.2, C77.2, C78.2, C86.2, C87.2, C88.1, C89.1, C90.2, C91.2, C93.2, CFSM5.1, CVREF5.1, CVREG5.1, D23.A, DCDC5.4, H_V-R2.2, IC20.5, IC23.5, IC23.41, IC24.27, IC24.33, IC24.34, IC24.35, IC24.36, IC24.37, IC24.38, IC24.39, IC24.40, JP5.6, NTC_C9.2, NTC_C10.2, Q15.2, Q17.2, R111.1, R118.1, R125.1, R137.1, RGQ1_18.1, X13.1, X13.3
HGND3: C101.2, C104.2, C108.2, C109.2, C117.2, C118.2, C119.1, C120.1, C121.2, C122.2, C124.2, CFSM7.1, CVREF7.1, CVREG7.1, D33.A, DCDC7.4, H_V-R3.2, IC28.5, IC31.5, IC31.41, IC32.27, IC32.33, IC32.34, IC32.35, IC32.36, IC32.37, IC32.38, IC32.39, IC32.40, JP7.6, NTC_C13.2, NTC_C14.2, Q21.2, Q23.2, R157.1, R164.1, R171.1, R183.1, RGQ1_24.1, X19.1, X19.3
HGND4: C132.2, C135.2, C139.2, C140.2, C148.2, C149.2, C150.1, C151.1, C152.2, C153.2, C155.2, CFSM9.1, CVREF9.1, CVREG9.1, D43.A, DCDC9.4, H_V-R4.2, IC36.5, IC39.5, IC39.41, IC40.27, IC40.33, IC40.34, IC40.35, IC40.36, IC40.37, IC40.38, IC40.39, IC40.40, JP9.6, NTC_C17.2, NTC_C18.2, Q27.2, Q29.2, R203.1, R210.1, R217.1, R229.1, RGQ1_30.1, X25.1, X25.3
H_!RESET: C24.1, IC7.3, JP2.1, R9.2
H_!RESET1: C42.1, IC15.3, JP3.1, R36.2
H_!RESET2: C73.1, IC23.3, JP5.1, R103.2
H_!RESET3: C104.1, IC31.3, JP7.1, R149.2
H_!RESET4: C135.1, IC39.3, JP9.1, R195.2
H_AD1: IC7.33, NTC_C1.1, NTC_R1.1, X2.2
H_AD2: IC7.34, NTC_C2.1, NTC_R2.1, X2.4
H_AD3: IC15.33, NTC_C5.1, NTC_R5.1, X7.2
H_AD4: IC15.34, NTC_C6.1, NTC_R6.1, X7.4
H_AD5: IC23.33, NTC_C9.1, NTC_R9.1, X13.2
H_AD6: IC23.34, NTC_C10.1, NTC_R10.1, X13.4
H_AD7: IC31.33, NTC_C13.1, NTC_R13.1, X19.2
H_AD8: IC31.34, NTC_C14.1, NTC_R14.1, X19.4
H_AD9: IC39.33, NTC_C17.1, NTC_R17.1, X25.2
H_AD10: IC39.34, NTC_C18.1, NTC_R18.1, X25.4
H_ADR: IC7.32, R24.2, R25.1
H_ADR1: IC15.32, R91.2, R92.1
H_ADR2: IC23.32, R137.2, R138.1
H_ADR3: IC31.32, R183.2, R184.1
H_ADR4: IC39.32, R229.2, R230.1
H_CANRX: IC3.6, R49.2
H_CANRX1: IC12.6, R78.2
H_CANRX2: IC20.6, R124.2
H_CANRX3: IC28.6, R170.2
H_CANRX4: IC36.6, R216.2
H_CANTX: IC3.7, R48.2
H_CANTX1: IC12.7, R77.2
H_CANTX2: IC20.7, R123.2
H_CANTX3: IC28.7, R169.2
H_CANTX4: IC36.7, R215.2
H_CAR_CANRX: IC3.3, R14.2
H_CAR_CANRX1: IC12.3, R54.2
H_CAR_CANRX2: IC20.3, R106.2
H_CAR_CANRX3: IC28.3, R152.2
H_CAR_CANRX4: IC36.3, R198.2
H_CAR_CANRX_T: IC4.4, R14.1
H_CAR_CANRX_T1: IC11.4, R54.1
H_CAR_CANRX_T2: IC19.4, R106.1
H_CAR_CANRX_T3: IC27.4, R152.1
H_CAR_CANRX_T4: IC35.4, R198.1
H_CAR_CANTX: IC3.2, R13.2
H_CAR_CANTX1: IC12.2, R38.2
H_CAR_CANTX2: IC20.2, R105.2
H_CAR_CANTX3: IC28.2, R151.2
H_CAR_CANTX4: IC36.2, R197.2
H_CAR_CANTX_T: IC4.1, R13.1
H_CAR_CANTX_T1: IC11.1, R38.1
H_CAR_CANTX_T2: IC19.1, R105.1
H_CAR_CANTX_T3: IC27.1, R151.1
H_CAR_CANTX_T4: IC35.1, R197.1
H_CSB: IC8.44, R44.2, R58.1
H_CSB1: IC16.44, R73.2, R86.1
H_CSB2: IC24.44, R119.2, R132.1
H_CSB3: IC32.44, R165.2, R178.1
H_CSB4: IC40.44, R211.2, R224.1
H_FSM: CFSM1.2, IC8.29, R10.1, R16.2
H_FSM1: CFSM3.2, IC16.29, R64.1, R65.2
H_FSM2: CFSM5.2, IC24.29, R110.1, R111.2
H_FSM3: CFSM7.2, IC32.29, R156.1, R157.2
H_FSM4: CFSM9.2, IC40.29, R202.1, R203.2
H_ISP_CAN: IC7.14, R50.2
H_ISP_CAN1: IC15.14, R79.2
H_ISP_CAN2: IC23.14, R125.2
H_ISP_CAN3: IC31.14, R171.2
H_ISP_CAN4: IC39.14, R217.2
H_ISP_ENTER: IC7.4, JP2.5, R51.2
H_ISP_ENTER1: IC15.4, JP3.5, R80.2
H_ISP_ENTER2: IC23.4, JP5.5, R126.2
H_ISP_ENTER3: IC31.4, JP7.5, R172.2
H_ISP_ENTER4: IC39.4, JP9.5, R218.2
H_LED: IC7.48, Q3.1
H_LED1: IC15.48, Q9.1
H_LED2: IC23.48, Q15.1
H_LED3: IC31.48, Q21.1
H_LED4: IC39.48, Q27.1
H_MISO: IC7.26, R46.1
H_MISO1: IC15.26, R75.1
H_MISO2: IC23.26, R121.1
H_MISO3: IC31.26, R167.1
H_MISO4: IC39.26, R213.1
H_MOSI: IC7.38, R47.1
H_MOSI1: IC15.38, R76.1
H_MOSI2: IC23.38, R122.1
H_MOSI3: IC31.38, R168.1
H_MOSI4: IC39.38, R214.1
H_SCK: IC8.41, R45.2, R55.1
H_SCK1: IC7.13, R45.1
H_SCK2: IC16.41, R74.2, R83.1
H_SCK3: IC15.13, R74.1
H_SCK4: IC24.41, R120.2, R129.1
H_SCK5: IC23.13, R120.1
H_SCK6: IC32.41, R166.2, R175.1
H_SCK7: IC31.13, R166.1
H_SCK8: IC40.41, R212.2, R221.1
H_SCK9: IC39.13, R212.1
H_SDI: IC8.42, R47.2, R56.1
H_SDI1: IC16.42, R76.2, R84.1
H_SDI2: IC24.42, R122.2, R130.1
H_SDI3: IC32.42, R168.2, R176.1
H_SDI4: IC40.42, R214.2, R222.1
H_SDO: IC8.43, R46.2, R57.1
H_SDO1: IC16.43, R75.2, R85.1
H_SDO2: IC24.43, R121.2, R131.1
H_SDO3: IC32.43, R167.2, R177.1
H_SDO4: IC40.43, R213.2, R223.1
H_SSEL: IC7.2, R44.1
H_SSEL1: IC15.2, R73.1
H_SSEL2: IC23.2, R119.1
H_SSEL3: IC31.2, R165.1
H_SSEL4: IC39.2, R211.1
H_SWCLK: IC7.29, JP2.4
H_SWCLK1: IC15.29, JP3.4
H_SWCLK2: IC23.29, JP5.4
H_SWCLK3: IC31.29, JP7.4
H_SWCLK4: IC39.29, JP9.4
H_SWDIO: IC7.39, JP2.3
H_SWDIO1: IC15.39, JP3.3
H_SWDIO2: IC23.39, JP5.3
H_SWDIO3: IC31.39, JP7.3
H_SWDIO4: IC39.39, JP9.3
H_V+: C35.1, D3.C, IC8.1, Q6.3, R10.2
H_V+1: C62.1, D13.C, IC16.1, Q12.3, R64.2
H_V+2: C93.1, D23.C, IC24.1, Q18.3, R110.2
H_V+3: C124.1, D33.C, IC32.1, Q24.3, R156.2
H_V+4: C155.1, D43.C, IC40.1, Q30.3, R202.2
H_VREF: CVREF1.2, IC8.31
H_VREF1: CVREF3.2, IC16.31
H_VREF2: CVREF5.2, IC24.31
H_VREF3: CVREF7.2, IC32.31
H_VREF4: CVREF9.2, IC40.31
H_VREG: CVREG1.2, IC8.32, R55.2, R56.2, R57.2, R58.2
H_VREG1: CVREG3.2, IC16.32, R83.2, R84.2, R85.2, R86.2
H_VREG2: CVREG5.2, IC24.32, R129.2, R130.2, R131.2, R132.2
H_VREG3: CVREG7.2, IC32.32, R175.2, R176.2, R177.2, R178.2
H_VREG4: CVREG9.2, IC40.32, R221.2, R222.2, R223.2, R224.2
L+3V1: C21.1, C28.1, C40.1, C41.1, C52.1, C54.1, IC9.8, IC9.44, IC10.30, IC14.8, JP4.2, L17.1, LED3.A, LED6.A, NTC_R7.2, NTC_R8.2, Q7.1, R62.1, R81.1, R90.2, RGQ1_9.2
L+3V2: C65.1, C66.1, C71.1, C72.1, C83.1, C85.1, IC17.8, IC17.44, IC18.30, IC22.8, JP6.2, L26.1, LED7.A, LED10.A, NTC_R11.2, NTC_R12.2, Q13.1, R108.1, R127.1, R136.2, RGQ1_15.2
L+3V3: C10.1, C11.1, C22.1, C23.1, C27.1, C30.1, IC1.8, IC1.44, IC2.30, IC6.8, JP1.2, L12.1, LED2.A, LED18.A, NTC_R3.2, NTC_R4.2, Q2.1, R15.1, R23.2, R52.1, RGQ1_3.2
L+3V4: C96.1, C97.1, C102.1, C103.1, C114.1, C116.1, IC25.8, IC25.44, IC26.30, IC30.8, JP8.2, L35.1, LED11.A, LED14.A, NTC_R15.2, NTC_R16.2, Q19.1, R154.1, R173.1, R182.2, RGQ1_21.2
L+3V5: C127.1, C128.1, C133.1, C134.1, C145.1, C147.1, IC33.8, IC33.44, IC34.30, IC38.8, JP10.2, L44.1, LED15.A, LED20.A, NTC_R19.2, NTC_R20.2, Q25.1, R200.1, R219.1, R228.2, RGQ1_27.2
LCANHL: IC5.7, L11.5
LCANHL1: IC13.7, L16.5
LCANHL2: IC21.7, L25.5
LCANHL3: IC29.7, L34.5
LCANHL4: IC37.7, L43.5
LCANLL: IC5.6, L11.4
LCANLL1: IC13.6, L16.4
LCANLL2: IC21.6, L25.4
LCANLL3: IC29.6, L34.4
LCANLL4: IC37.6, L43.4
LED1C1: LED1.C, R8.2
LED1C2: LED2.C, R53.2
LED1C3: LED5.C, R63.2
LED1C4: LED6.C, R82.2
LED1C5: LED9.C, R109.2
LED1C6: LED10.C, R128.2
LED1C7: LED13.C, R155.2
LED1C8: LED14.C, R174.2
LED1C9: LED17.C, R201.2
LED1C10: LED20.C, R220.2
LGND: C1.2, C10.2, C11.2, C14.1, C15.1, C22.2, C23.2, C27.2, C29.2, C30.2, C34.2, CFSM.1, CVREF.1, CVREG.1, D1.A, DCDC2.4, IC1.5, IC1.41, IC2.27, IC2.33, IC2.34, IC2.35, IC2.36, IC2.37, IC2.38, IC2.39, IC2.40, IC6.5, JP1.6, L_V-R.2, NTC_C3.2, NTC_C4.2, Q2.2, Q4.2, R2.1, R11.1, R42.1, R60.1, RGQ1_3.1, X5.1, X5.3
LGND1: C21.2, C28.2, C36.1, C37.1, C40.2, C41.2, C43.2, C52.2, C53.2, C54.2, C61.2, CFSM2.1, CVREF2.1, CVREG2.1, D11.A, DCDC4.4, IC9.5, IC9.41, IC10.27, IC10.33, IC10.34, IC10.35, IC10.36, IC10.37, IC10.38, IC10.39, IC10.40, IC14.5, JP4.6, L_V-R1.2, NTC_C7.2, NTC_C8.2, Q7.2, Q10.2, R61.1, R71.1, R88.1, R89.1, RGQ1_9.1, X8.1, X8.3
LGND2: C65.2, C66.2, C67.1, C68.1, C71.2, C72.2, C74.2, C83.2, C84.2, C85.2, C92.2, CFSM4.1, CVREF4.1, CVREG4.1, D21.A, DCDC6.4, IC17.5, IC17.41, IC18.27, IC18.33, IC18.34, IC18.35, IC18.36, IC18.37, IC18.38, IC18.39, IC18.40, IC22.5, JP6.6, L_V-R2.2, NTC_C11.2, NTC_C12.2, Q13.2, Q16.2, R107.1, R117.1, R134.1, R135.1, RGQ1_15.1, X14.1, X14.3
LGND3: C96.2, C97.2, C98.1, C99.1, C102.2, C103.2, C105.2, C114.2, C115.2, C116.2, C123.2, CFSM6.1, CVREF6.1, CVREG6.1, D31.A, DCDC8.4, IC25.5, IC25.41, IC26.27, IC26.33, IC26.34, IC26.35, IC26.36, IC26.37, IC26.38, IC26.39, IC26.40, IC30.5, JP8.6, L_V-R3.2, NTC_C15.2, NTC_C16.2, Q19.2, Q22.2, R153.1, R163.1, R180.1, R181.1, RGQ1_21.1, X20.1, X20.3
LGND4: C127.2, C128.2, C129.1, C130.1, C133.2, C134.2, C136.2, C145.2, C146.2, C147.2, C154.2, CFSM8.1, CVREF8.1, CVREG8.1, D41.A, DCDC10.4, IC33.5, IC33.41, IC34.27, IC34.33, IC34.34, IC34.35, IC34.36, IC34.37, IC34.38, IC34.39, IC34.40, IC38.5, JP10.6, L_V-R4.2, NTC_C19.2, NTC_C20.2, Q25.2, Q28.2, R199.1, R209.1, R226.1, R227.1, RGQ1_27.1, X26.1, X26.3
L_!RESET: C34.1, IC1.3, JP1.1, R52.2
L_!RESET1: C61.1, IC9.3, JP4.1, R81.2
L_!RESET2: C92.1, IC17.3, JP6.1, R127.2
L_!RESET3: C123.1, IC25.3, JP8.1, R173.2
L_!RESET4: C154.1, IC33.3, JP10.1, R219.2
L_AD1: IC1.33, NTC_C3.1, NTC_R3.1, X5.2
L_AD2: IC1.34, NTC_C4.1, NTC_R4.1, X5.4
L_AD3: IC9.33, NTC_C7.1, NTC_R7.1, X8.2
L_AD4: IC9.34, NTC_C8.1, NTC_R8.1, X8.4
L_AD5: IC17.33, NTC_C11.1, NTC_R11.1, X14.2
L_AD6: IC17.34, NTC_C12.1, NTC_R12.1, X14.4
L_AD7: IC25.33, NTC_C15.1, NTC_R15.1, X20.2
L_AD8: IC25.34, NTC_C16.1, NTC_R16.1, X20.4
L_AD9: IC33.33, NTC_C19.1, NTC_R19.1, X26.2
L_AD10: IC33.34, NTC_C20.1, NTC_R20.1, X26.4
L_ADR: IC1.32, R2.2, R23.1
L_ADR1: IC9.32, R89.2, R90.1
L_ADR2: IC17.32, R135.2, R136.1
L_ADR3: IC25.32, R181.2, R182.1
L_ADR4: IC33.32, R227.2, R228.1
L_CANRX: IC6.6, R7.2
L_CANRX1: IC14.6, R35.2
L_CANRX2: IC22.6, R102.2
L_CANRX3: IC30.6, R148.2
L_CANRX4: IC38.6, R194.2
L_CANTX: IC6.7, R6.2
L_CANTX1: IC14.7, R34.2
L_CANTX2: IC22.7, R101.2
L_CANTX3: IC30.7, R147.2
L_CANTX4: IC38.7, R193.2
L_CAR_CANRX: IC6.3, R41.2
L_CAR_CANRX1: IC14.3, R70.2
L_CAR_CANRX2: IC22.3, R116.2
L_CAR_CANRX3: IC30.3, R162.2
L_CAR_CANRX4: IC38.3, R208.2
L_CAR_CANRX_T: IC5.4, R41.1
L_CAR_CANRX_T1: IC13.4, R70.1
L_CAR_CANRX_T2: IC21.4, R116.1
L_CAR_CANRX_T3: IC29.4, R162.1
L_CAR_CANRX_T4: IC37.4, R208.1
L_CAR_CANTX: IC6.2, R40.2
L_CAR_CANTX1: IC14.2, R69.2
L_CAR_CANTX2: IC22.2, R115.2
L_CAR_CANTX3: IC30.2, R161.2
L_CAR_CANTX4: IC38.2, R207.2
L_CAR_CANTX_T: IC5.1, R40.1
L_CAR_CANTX_T1: IC13.1, R69.1
L_CAR_CANTX_T2: IC21.1, R115.1
L_CAR_CANTX_T3: IC29.1, R161.1
L_CAR_CANTX_T4: IC37.1, R207.1
L_CSB: IC2.44, R1.2, R20.1
L_CSB1: IC10.44, R29.1, R30.2
L_CSB2: IC18.44, R96.1, R97.2
L_CSB3: IC26.44, R142.1, R143.2
L_CSB4: IC34.44, R188.1, R189.2
L_FSM: CFSM.2, IC2.29, R59.1, R60.2
L_FSM1: CFSM2.2, IC10.29, R87.1, R88.2
L_FSM2: CFSM4.2, IC18.29, R133.1, R134.2
L_FSM3: CFSM6.2, IC26.29, R179.1, R180.2
L_FSM4: CFSM8.2, IC34.29, R225.1, R226.2
L_ISP_CAN: IC1.14, R11.2
L_ISP_CAN1: IC9.14, R61.2
L_ISP_CAN2: IC17.14, R107.2
L_ISP_CAN3: IC25.14, R153.2
L_ISP_CAN4: IC33.14, R199.2
L_ISP_ENTER: IC1.4, JP1.5, R15.2
L_ISP_ENTER1: IC9.4, JP4.5, R62.2
L_ISP_ENTER2: IC17.4, JP6.5, R108.2
L_ISP_ENTER3: IC25.4, JP8.5, R154.2
L_ISP_ENTER4: IC33.4, JP10.5, R200.2
L_LED: IC1.48, Q4.1
L_LED1: IC9.48, Q10.1
L_LED2: IC17.48, Q16.1
L_LED3: IC25.48, Q22.1
L_LED4: IC33.48, Q28.1
L_MISO: IC1.26, R4.1
L_MISO1: IC9.26, R32.1
L_MISO2: IC17.26, R99.1
L_MISO3: IC25.26, R145.1
L_MISO4: IC33.26, R191.1
L_MOSI: IC1.38, R5.1
L_MOSI1: IC9.38, R33.1
L_MOSI2: IC17.38, R100.1
L_MOSI3: IC25.38, R146.1
L_MOSI4: IC33.38, R192.1
L_SCK: IC2.41, R3.2, R17.1
L_SCK1: IC1.13, R3.1
L_SCK2: IC9.13, R31.1
L_SCK3: IC10.41, R26.1, R31.2
L_SCK4: IC17.13, R98.1
L_SCK5: IC18.41, R93.1, R98.2
L_SCK6: IC25.13, R144.1
L_SCK7: IC26.41, R139.1, R144.2
L_SCK8: IC33.13, R190.1
L_SCK9: IC34.41, R185.1, R190.2
L_SDI: IC2.42, R5.2, R18.1
L_SDI1: IC10.42, R27.1, R33.2
L_SDI2: IC18.42, R94.1, R100.2
L_SDI3: IC26.42, R140.1, R146.2
L_SDI4: IC34.42, R186.1, R192.2
L_SDO: IC2.43, R4.2, R19.1
L_SDO1: IC10.43, R28.1, R32.2
L_SDO2: IC18.43, R95.1, R99.2
L_SDO3: IC26.43, R141.1, R145.2
L_SDO4: IC34.43, R187.1, R191.2
L_SSEL: IC1.2, R1.1
L_SSEL1: IC9.2, R30.1
L_SSEL2: IC17.2, R97.1
L_SSEL3: IC25.2, R143.1
L_SSEL4: IC33.2, R189.1
L_SWCLK: IC1.29, JP1.4
L_SWCLK1: IC9.29, JP4.4
L_SWCLK2: IC17.29, JP6.4
L_SWCLK3: IC25.29, JP8.4
L_SWCLK4: IC33.29, JP10.4
L_SWDIO: IC1.39, JP1.3
L_SWDIO1: IC9.39, JP4.3
L_SWDIO2: IC17.39, JP6.3
L_SWDIO3: IC25.39, JP8.3
L_SWDIO4: IC33.39, JP10.3
L_V+: C1.1, D1.C, IC2.1, Q1.3, R59.2
L_V+1: C43.1, D11.C, IC10.1, Q8.3, R87.2
L_V+2: C74.1, D21.C, IC18.1, Q14.3, R133.2
L_V+3: C105.1, D31.C, IC26.1, Q20.3, R179.2
L_V+4: C136.1, D41.C, IC34.1, Q26.3, R225.2
L_VREF: CVREF.2, IC2.31
L_VREF1: CVREF2.2, IC10.31
L_VREF2: CVREF4.2, IC18.31
L_VREF3: CVREF6.2, IC26.31
L_VREF4: CVREF8.2, IC34.31
L_VREG: CVREG.2, IC2.32, R17.2, R18.2, R19.2, R20.2
L_VREG1: CVREG2.2, IC10.32, R26.2, R27.2, R28.2, R29.2
L_VREG2: CVREG4.2, IC18.32, R93.2, R94.2, R95.2, R96.2
L_VREG3: CVREG6.2, IC26.32, R139.2, R140.2, R141.2, R142.2
L_VREG4: CVREG8.2, IC34.32, R185.2, R186.2, R187.2, R188.2
unnamed: LED19.C, R43.2
unnamed: LED18.C, R42.2
unnamed: Q2.3, RGQ1_2.1
unnamed: L7.2, V+R.1
unnamed: Q5.3, RGQ1_5.1
unnamed: L5.2, V+R1.1
unnamed: LED4.C, R72.2
unnamed: LED3.C, R71.2
unnamed: Q7.3, RGQ1_8.1
unnamed: L9.2, V+R2.1
unnamed: Q11.3, RGQ1_11.1
unnamed: L18.2, V+R3.1
unnamed: LED8.C, R118.2
unnamed: LED7.C, R117.2
unnamed: Q13.3, RGQ1_14.1
unnamed: L20.2, V+R4.1
unnamed: Q17.3, RGQ1_17.1
unnamed: L27.2, V+R5.1
unnamed: LED12.C, R164.2
unnamed: LED11.C, R163.2
unnamed: Q19.3, RGQ1_20.1
unnamed: L29.2, V+R6.1
unnamed: Q23.3, RGQ1_23.1
unnamed: L36.2, V+R7.1
unnamed: LED16.C, R210.2
unnamed: LED15.C, R209.2
unnamed: Q25.3, RGQ1_26.1
unnamed: L38.2, V+R8.1
unnamed: Q29.3, RGQ1_29.1
unnamed: L45.2, V+R9.1
Q1G: D2.A, Q1.1, RGQ1_1.2, RGQ1_2.2
Q1G1: D4.A, Q6.1, RGQ1_4.2, RGQ1_5.2
Q1G2: D12.A, Q8.1, RGQ1_7.2, RGQ1_8.2
Q1G3: D14.A, Q12.1, RGQ1_10.2, RGQ1_11.2
Q1G4: D22.A, Q14.1, RGQ1_13.2, RGQ1_14.2
Q1G5: D24.A, Q18.1, RGQ1_16.2, RGQ1_17.2
Q1G6: D32.A, Q20.1, RGQ1_19.2, RGQ1_20.2
Q1G7: D34.A, Q24.1, RGQ1_22.2, RGQ1_23.2
Q1G8: D42.A, Q26.1, RGQ1_25.2, RGQ1_26.2
Q1G9: D44.A, Q30.1, RGQ1_28.2, RGQ1_29.2
Q3_COL: Q3.3, R8.1
Q3_COL1: Q4.3, R53.1
Q3_COL2: Q9.3, R63.1
Q3_COL3: Q10.3, R82.1
Q3_COL4: Q15.3, R109.1
Q3_COL5: Q16.3, R128.1
Q3_COL6: Q21.3, R155.1
Q3_COL7: Q22.3, R174.1
Q3_COL8: Q27.3, R201.1
Q3_COL9: Q28.3, R220.1
QBG1: QB1.1, RBG1.1
QBG2: QB2.1, RBG2.1
QBG3: QB3.1, RBG3.1
QBG4: QB4.1, RBG4.1
QBG5: QB5.1, RBG5.1
QBG6: QB6.1, RBG6.1
QBG7: QB7.1, RBG7.1
QBG8: QB8.1, RBG8.1
QBG9: QB9.1, RBG9.1
QBG10: QB10.1, RBG10.1
QBG11: QB11.1, RBG11.1
QBG12: QB12.1, RBG12.1
QBG13: QB13.1, RBG13.1
QBG14: QB14.1, RBG14.1
QBG15: QB15.1, RBG15.1
QBG16: QB16.1, RBG16.1
QBG17: QB17.1, RBG17.1
QBG18: QB18.1, RBG18.1
QBG19: QB19.1, RBG19.1
QBG20: QB20.1, RBG20.1
QBG21: QB21.1, RBG21.1
QBG22: QB22.1, RBG22.1
QBG23: QB23.1, RBG23.1
QBG24: QB24.1, RBG24.1
QBG25: QB25.1, RBG25.1
QBG26: QB26.1, RBG26.1
QBG27: QB27.1, RBG27.1
QBG28: QB28.1, RBG28.1
QBG29: QB29.1, RBG29.1
QBG30: QB30.1, RBG30.1
QBG31: QB31.1, RBG31.1
QBG32: QB32.1, RBG32.1
QBG33: QB33.1, RBG33.1
QBG34: QB34.1, RBG34.1
QBG35: QB35.1, RBG35.1
QBG36: QB36.1, RBG36.1
QBG37: QB37.1, RBG37.1
QBG38: QB38.1, RBG38.1
QBG39: QB39.1, RBG39.1
QBG40: QB40.1, RBG40.1
QBG41: QB41.1, RBG41.1
QBG42: QB42.1, RBG42.1
QBG43: QB43.1, RBG43.1
QBG44: QB44.1, RBG44.1
QBG45: QB45.1, RBG45.1
QBG46: QB46.1, RBG46.1
QBG47: QB47.1, RBG47.1
QBG48: QB48.1, RBG48.1
QBG49: QB49.1, RBG49.1
QBG50: QB50.1, RBG50.1
QBG51: QB51.1, RBG51.1
QBG52: QB52.1, RBG52.1
QBG53: QB53.1, RBG53.1
QBG54: QB54.1, RBG54.1
QBG55: QB55.1, RBG55.1
QBG56: QB56.1, RBG56.1
QBG57: QB57.1, RBG57.1
QBG58: QB58.1, RBG58.1
QBG59: QB59.1, RBG59.1
QBG60: QB60.1, RBG60.1
QBG61: QB61.1, RBG61.1
QBG62: QB62.1, RBG62.1
QBG63: QB63.1, RBG63.1
QBG64: QB64.1, RBG64.1
QBG65: QB65.1, RBG65.1
QBG66: QB66.1, RBG66.1
QBG67: QB67.1, RBG67.1
QBG68: QB68.1, RBG68.1
QBG69: QB69.1, RBG69.1
QBG70: QB70.1, RBG70.1
QBG71: QB71.1, RBG71.1
QBG72: QB72.1, RBG72.1
QBG73: QB73.1, RBG73.1
QBG74: QB74.1, RBG74.1
QBG75: QB75.1, RBG75.1
QBG76: QB76.1, RBG76.1
QBG77: QB77.1, RBG77.1
QBG78: QB78.1, RBG78.1
QBG79: QB79.1, RBG79.1
QBG80: QB80.1, RBG80.1
RS: IC4.8, R12.1
RS1: IC5.8, R39.1
RS2: IC11.8, R37.1
RS3: IC13.8, R68.1
RS4: IC19.8, R104.1
RS5: IC21.8, R114.1
RS6: IC27.8, R150.1
RS7: IC29.8, R160.1
RS8: IC35.8, R196.1
RS9: IC37.8, R206.1
V+S: D2.C, Q1.2, RGQ1_1.1, V+R.2
V+S1: D4.C, Q6.2, RGQ1_4.1, V+R1.2
V+S2: D12.C, Q8.2, RGQ1_7.1, V+R2.2
V+S3: D14.C, Q12.2, RGQ1_10.1, V+R3.2
V+S4: D22.C, Q14.2, RGQ1_13.1, V+R4.2
V+S5: D24.C, Q18.2, RGQ1_16.1, V+R5.2
V+S6: D32.C, Q20.2, RGQ1_19.1, V+R6.2
V+S7: D34.C, Q24.2, RGQ1_22.1, V+R7.2
V+S8: D42.C, Q26.2, RGQ1_25.1, V+R8.2
V+S9: D44.C, Q30.2, RGQ1_28.1, V+R9.2
XTALIN: C15.2, IC1.6, Y1.2
XTALIN1: C31.2, IC7.6, Y2.2
XTALIN2: C37.2, IC9.6, Y3.2
XTALIN3: C58.2, IC15.6, Y4.2
XTALIN4: C68.2, IC17.6, Y5.2
XTALIN5: C89.2, IC23.6, Y6.2
XTALIN6: C99.2, IC25.6, Y7.2
XTALIN7: C120.2, IC31.6, Y8.2
XTALIN8: C130.2, IC33.6, Y9.2
XTALIN9: C151.2, IC39.6, Y10.2
XTALOUT: C14.2, IC1.7, Y1.1
XTALOUT1: C25.2, IC7.7, Y2.1
XTALOUT2: C36.2, IC9.7, Y3.1
XTALOUT3: C57.2, IC15.7, Y4.1
XTALOUT4: C67.2, IC17.7, Y5.1
XTALOUT5: C88.2, IC23.7, Y6.1
XTALOUT6: C98.2, IC25.7, Y7.1
XTALOUT7: C119.2, IC31.7, Y8.1
XTALOUT8: C129.2, IC33.7, Y9.1
XTALOUT9: C150.2, IC39.7, Y10.1
