funkobongrip/sprbms/code/spi_master/slave.c

/*
 * Copyright (c) 2012 David Brandt
 *  All rights reserved.
 *
 * Licensed under: CC BY-NC-SA 3.0 (full license in file LICENSE)
 * 
 * You are free:
 * - to Share - to copy, distribute and transmit the work
 * - to Remix - to adapt the work
 * 
 * Under the following conditions:
 * - Attribution - You must attribute the work in the manner specified by
 *   the author or licensor (but not in any way that suggests that
 *   they endorse you or your use of the work).
 * 
 * - Noncommercial - You may not use this work for commercial purposes.
 * 
 * - Share Alike - If you alter, transform, or build upon this work, you may
 *   distribute the resulting work only under the same or similar license
 *   to this one.
 */

#include <avr/io.h>
#include <stdio.h>
#include <avr/pgmspace.h>
#include <stdint.h>
#include <avr/io.h>
#include <avr/interrupt.h>
#include <util/delay.h>
#include <stdlib.h>
#include <string.h>

#include "main.h"
#include "config.h"
#include "adc.h"
#include "mcan.h"
#include "pec.h"
#include "slave.h"
#include "spi.h"
#include "spi_adc.h"
#include "uart.h"
#include "timer.h"
#include "charger.h"
#include "relai.h"
#include "intermediate.h"
#include "balancing.h"

volatile unsigned char slave_configs[NUMSLAVES][6];
volatile unsigned char slave_read_configs[NUMSLAVES][6];
volatile unsigned char slave_diags[NUMSLAVES][2];

volatile unsigned int cell_voltages[NUMCELLS];

volatile unsigned int cell_temps[NUMTEMPS];
volatile unsigned int cell_temps_raw[NUMTEMPS];

volatile unsigned int slave_fsm[NUMSLAVES];
volatile unsigned int slave_fsm_raw[NUMSLAVES];

volatile uint32_t batt_fsm_volt_copy;
volatile uint32_t batt_fsm_volt;

volatile unsigned int ltc_temps[NUMSLAVES];

volatile unsigned char slave_sent_cmd;
volatile unsigned char i, j, ii, jj;
volatile unsigned int slave_errors;

volatile unsigned int slave_cycle_ms = 0;
volatile unsigned int slave_adc_time = 0;

volatile unsigned char verify_errors = 0;

/*
This lookup table can be created with this code snippet:
#include <stdio.h>
#include <math.h>
 * 
int main()
{
  float rn = 10000.0f;
  float b = 4100.0f;
  float tn = 298.15f;
  float r1 = 10000.0f;
  int i;

  printf("const PROGMEM unsigned int temp_curve[] = {\n");
  for(i=0; i<255 ;i++)
  {
    float temp = ((float)i/2) + 233.15f;
    float e = (b / temp) - (b / tn);
    float r2 = rn * exp(e);
    float u2 = (3.065f * r2) / (r1 + r2);
    float adc = ((u2*1000) / 1.5) + 512;
    printf("  %d%s // Temp: %fK Rntc: %fOhm Untc: %fmV\n", (int)adc, (i!=254?",":""), temp, r2, u2);
  }
  printf("};\n");
  return 0;
}
*/

const unsigned int temp_curve[] = {
  2512, // Temp: 233.149994K Rntc: 462368.656250Ohm Untc: 3.000114mV
  2510, // Temp: 233.649994K Rntc: 445292.968750Ohm Untc: 2.997681mV
  2508, // Temp: 234.149994K Rntc: 428915.812500Ohm Untc: 2.995169mV
  2507, // Temp: 234.649994K Rntc: 413207.187500Ohm Untc: 2.992577mV
  2505, // Temp: 235.149994K Rntc: 398137.656250Ohm Untc: 2.989903mV
  2503, // Temp: 235.649994K Rntc: 383677.687500Ohm Untc: 2.987144mV
  2501, // Temp: 236.149994K Rntc: 369800.750000Ohm Untc: 2.984300mV
  2499, // Temp: 236.649994K Rntc: 356481.437500Ohm Untc: 2.981367mV
  2497, // Temp: 237.149994K Rntc: 343694.968750Ohm Untc: 2.978343mV
  2495, // Temp: 237.649994K Rntc: 331417.687500Ohm Untc: 2.975227mV
  2493, // Temp: 238.149994K Rntc: 319628.375000Ohm Untc: 2.972017mV
  2491, // Temp: 238.649994K Rntc: 308304.843750Ohm Untc: 2.968709mV
  2488, // Temp: 239.149994K Rntc: 297427.312500Ohm Untc: 2.965302mV
  2486, // Temp: 239.649994K Rntc: 286976.812500Ohm Untc: 2.961793mV
  2484, // Temp: 240.149994K Rntc: 276934.687500Ohm Untc: 2.958181mV
  2481, // Temp: 240.649994K Rntc: 267283.187500Ohm Untc: 2.954463mV
  2479, // Temp: 241.149994K Rntc: 258006.468750Ohm Untc: 2.950637mV
  2476, // Temp: 241.649994K Rntc: 249087.828125Ohm Untc: 2.946700mV
  2473, // Temp: 242.149994K Rntc: 240512.328125Ohm Untc: 2.942651mV
  2470, // Temp: 242.649994K Rntc: 232265.734375Ohm Untc: 2.938486mV
  2468, // Temp: 243.149994K Rntc: 224334.421875Ohm Untc: 2.934204mV
  2465, // Temp: 243.649994K Rntc: 216704.515625Ohm Untc: 2.929802mV
  2462, // Temp: 244.149994K Rntc: 209363.671875Ohm Untc: 2.925278mV
  2459, // Temp: 244.649994K Rntc: 202300.046875Ohm Untc: 2.920629mV
  2455, // Temp: 245.149994K Rntc: 195502.328125Ohm Untc: 2.915853mV
  2452, // Temp: 245.649994K Rntc: 188959.328125Ohm Untc: 2.910949mV
  2449, // Temp: 246.149994K Rntc: 182660.406250Ohm Untc: 2.905912mV
  2445, // Temp: 246.649994K Rntc: 176595.687500Ohm Untc: 2.900741mV
  2442, // Temp: 247.149994K Rntc: 170755.796875Ohm Untc: 2.895434mV
  2438, // Temp: 247.649994K Rntc: 165131.375000Ohm Untc: 2.889989mV
  2434, // Temp: 248.149994K Rntc: 159713.546875Ohm Untc: 2.884402mV
  2431, // Temp: 248.649994K Rntc: 154494.390625Ohm Untc: 2.878671mV
  2427, // Temp: 249.149994K Rntc: 149465.734375Ohm Untc: 2.872796mV
  2423, // Temp: 249.649994K Rntc: 144620.062500Ohm Untc: 2.866772mV
  2419, // Temp: 250.149994K Rntc: 139949.921875Ohm Untc: 2.860599mV
  2414, // Temp: 250.649994K Rntc: 135448.140625Ohm Untc: 2.854272mV
  2410, // Temp: 251.149994K Rntc: 131108.187500Ohm Untc: 2.847791mV
  2406, // Temp: 251.649994K Rntc: 126923.976562Ohm Untc: 2.841153mV
  2401, // Temp: 252.149994K Rntc: 122888.781250Ohm Untc: 2.834356mV
  2396, // Temp: 252.649994K Rntc: 118997.304688Ohm Untc: 2.827398mV
  2392, // Temp: 253.149994K Rntc: 115243.789062Ohm Untc: 2.820277mV
  2387, // Temp: 253.649994K Rntc: 111622.500000Ohm Untc: 2.812991mV
  2382, // Temp: 254.149994K Rntc: 108128.828125Ohm Untc: 2.805538mV
  2377, // Temp: 254.649994K Rntc: 104757.484375Ohm Untc: 2.797915mV
  2372, // Temp: 255.149994K Rntc: 101503.843750Ohm Untc: 2.790122mV
  2366, // Temp: 255.649994K Rntc: 98363.445312Ohm Untc: 2.782156mV
  2361, // Temp: 256.149994K Rntc: 95331.851562Ohm Untc: 2.774015mV
  2355, // Temp: 256.649994K Rntc: 92404.968750Ohm Untc: 2.765698mV
  2350, // Temp: 257.149994K Rntc: 89578.875000Ohm Untc: 2.757204mV
  2344, // Temp: 257.649994K Rntc: 86849.656250Ohm Untc: 2.748530mV
  2338, // Temp: 258.149994K Rntc: 84213.625000Ohm Untc: 2.739676mV
  2332, // Temp: 258.649994K Rntc: 81667.335938Ohm Untc: 2.730639mV
  2326, // Temp: 259.149994K Rntc: 79207.484375Ohm Untc: 2.721419mV
  2320, // Temp: 259.649994K Rntc: 76830.726562Ohm Untc: 2.712014mV
  2313, // Temp: 260.149994K Rntc: 74534.039062Ohm Untc: 2.702424mV
  2307, // Temp: 260.649994K Rntc: 72314.414062Ohm Untc: 2.692647mV
  2300, // Temp: 261.149994K Rntc: 70169.054688Ohm Untc: 2.682683mV
  2293, // Temp: 261.649994K Rntc: 68095.132812Ohm Untc: 2.672530mV
  2286, // Temp: 262.149994K Rntc: 66090.070312Ohm Untc: 2.662188mV
  2279, // Temp: 262.649994K Rntc: 64151.332031Ohm Untc: 2.651656mV
  2272, // Temp: 263.149994K Rntc: 62276.589844Ohm Untc: 2.640934mV
  2265, // Temp: 263.649994K Rntc: 60463.378906Ohm Untc: 2.630023mV
  2257, // Temp: 264.149994K Rntc: 58709.511719Ohm Untc: 2.618919mV
  2250, // Temp: 264.649994K Rntc: 57012.882812Ohm Untc: 2.607625mV
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
  823, // Temp: 340.649994K Rntc: 1798.461670Ohm Untc: 0.467204mV
  818, // Temp: 341.149994K Rntc: 1767.014771Ohm Untc: 0.460261mV
  814, // Temp: 341.649994K Rntc: 1736.207153Ohm Untc: 0.453424mV
  809, // Temp: 342.149994K Rntc: 1706.024536Ohm Untc: 0.446690mV
  805, // Temp: 342.649994K Rntc: 1676.452881Ohm Untc: 0.440059mV
  801, // Temp: 343.149994K Rntc: 1647.477173Ohm Untc: 0.433529mV
  796, // Temp: 343.649994K Rntc: 1619.085571Ohm Untc: 0.427099mV
  792, // Temp: 344.149994K Rntc: 1591.262207Ohm Untc: 0.420767mV
  788, // Temp: 344.649994K Rntc: 1563.996094Ohm Untc: 0.414532mV
  784, // Temp: 345.149994K Rntc: 1537.274780Ohm Untc: 0.408393mV
  780, // Temp: 345.649994K Rntc: 1511.083618Ohm Untc: 0.402349mV
  776, // Temp: 346.149994K Rntc: 1485.413574Ohm Untc: 0.396398mV
  772, // Temp: 346.649994K Rntc: 1460.252197Ohm Untc: 0.390539mV
  768, // Temp: 347.149994K Rntc: 1435.588135Ohm Untc: 0.384771mV
  764, // Temp: 347.649994K Rntc: 1411.407959Ohm Untc: 0.379091mV
  761, // Temp: 348.149994K Rntc: 1387.703857Ohm Untc: 0.373500mV
  757, // Temp: 348.649994K Rntc: 1364.464355Ohm Untc: 0.367997mV
  753, // Temp: 349.149994K Rntc: 1341.679077Ohm Untc: 0.362578mV
  750, // Temp: 349.649994K Rntc: 1319.337402Ohm Untc: 0.357244mV
  746, // Temp: 350.149994K Rntc: 1297.429565Ohm Untc: 0.351993mV
  743, // Temp: 350.649994K Rntc: 1275.946289Ohm Untc: 0.346825mV
  739, // Temp: 351.149994K Rntc: 1254.879761Ohm Untc: 0.341737mV
  736, // Temp: 351.649994K Rntc: 1234.218750Ohm Untc: 0.336728mV
  733, // Temp: 352.149994K Rntc: 1213.954712Ohm Untc: 0.331798mV
  729, // Temp: 352.649994K Rntc: 1194.080322Ohm Untc: 0.326946mV
  726, // Temp: 353.149994K Rntc: 1174.584961Ohm Untc: 0.322169mV
  723, // Temp: 353.649994K Rntc: 1155.463013Ohm Untc: 0.317467mV
  720, // Temp: 354.149994K Rntc: 1136.704468Ohm Untc: 0.312839mV
  717, // Temp: 354.649994K Rntc: 1118.301636Ohm Untc: 0.308284mV
  714, // Temp: 355.149994K Rntc: 1100.248169Ohm Untc: 0.303800mV
  711, // Temp: 355.649994K Rntc: 1082.534546Ohm Untc: 0.299387mV
  708, // Temp: 356.149994K Rntc: 1065.156006Ohm Untc: 0.295044mV
  705, // Temp: 356.649994K Rntc: 1048.103394Ohm Untc: 0.290768mV
  703, // Temp: 357.149994K Rntc: 1031.369995Ohm Untc: 0.286560mV
  700, // Temp: 357.649994K Rntc: 1014.949280Ohm Untc: 0.282418mV
  697, // Temp: 358.149994K Rntc: 998.835754Ohm Untc: 0.278341mV
  694, // Temp: 358.649994K Rntc: 983.021118Ohm Untc: 0.274329mV
  692, // Temp: 359.149994K Rntc: 967.500244Ohm Untc: 0.270380mV
  689, // Temp: 359.649994K Rntc: 952.266235Ohm Untc: 0.266492mV
  687 // Temp: 360.149994K Rntc: 937.314087Ohm Untc: 0.262667mV
};

unsigned char slave_tempfromadc(unsigned int adc)
{
	unsigned char i;
	
	for(i=0; i<0xFF ;i++)
	{
		if( adc > temp_curve[i] )
		{
			return i;
		}
	}
	return 0xFF;
}

#define spi_append(x) spi_buffer[spi_buffer_size++] = x; update_pec(x)
#define spi_pec() spi_buffer[spi_buffer_size++] = pec

void slave_init(void)
{
	slave_errors = 0;
	SET_OUTPUT(SLAVECS);
	SET(SLAVECS);
}

void slave_build_command(char cmd)
{
	_delay_us(5);
	spi_buffer_size = 2;
	slave_sent_cmd = spi_buffer[0] = cmd;
	reset_pec();
	update_pec(cmd);
	spi_buffer[1] = pec;
}

void slave_set_gpios(char gpio)
{
	for(ii=0; ii<NUMSLAVES ;ii++)
	{
		slave_set_gpio(ii, gpio);
	}
}

void slave_set_cdcs(char cdc)
{
	for(ii=0; ii<NUMSLAVES ;ii++)
	{
		slave_set_cdc(ii, cdc);
	}
}

void slave_set_wdts(char wdt)
{
	for(ii=0; ii<NUMSLAVES ;ii++)
	{
		slave_set_wdt(ii, wdt);
	}
}

void slave_set_lvlpls(char lvlpl)
{
	for(ii=0; ii<NUMSLAVES ;ii++)
	{
		slave_set_lvlpl(ii, lvlpl);
	}
}

void slave_set_cell10s(char cell10)
{
	for(ii=0; ii<NUMSLAVES ;ii++)
	{
		slave_set_cell10(ii, cell10);
	}
}

void slave_set_vuvs(char vuv)
{
	for(ii=0; ii<NUMSLAVES ;ii++)
	{
		slave_set_vuv(ii, vuv);
	}
}

void slave_set_vovs(char vov)
{
	for(ii=0; ii<NUMSLAVES ;ii++)
	{
		slave_set_vov(ii, vov);
	}
}

void slave_set_balancings(unsigned int balancing)
{
	for(ii=0; ii<NUMSLAVES ;ii++)
	{
		slave_set_balancing(ii, balancing);
	}
}

void slave_set_maskints(unsigned int maskint)
{
	for(ii=0; ii<NUMSLAVES ;ii++)
	{
		slave_set_maskint(ii, maskint);
	}
}

void slave_set_balance_cell(unsigned char cell, unsigned char balance)
{
	unsigned char slave;
	slave = cell / 12;
	cell %= 12;
	
	if( cell < 8 )
	{
		if( balance )
		{
			slave_configs[slave][1] |= (1 << cell);
		}
		else
		{
			slave_configs[slave][1] &= ~(1 << cell);
		}
	}
	else
	{
		cell -= 8;
		if( balance )
		{
			slave_configs[slave][2] |= (1 << cell);
		}
		else
		{
			slave_configs[slave][2] &= ~(1 << cell);
		}
	}
}

void slave_write_config(void)
{
	static unsigned char i;
	slave_build_command(SLAVE_CMD_WRITE_CONFIG);
	for(i=NUMSLAVES; i>0 ;i--)
	{
		reset_pec();
		spi_append(slave_configs[i-1][0]);
		spi_append(slave_configs[i-1][1]);
		spi_append(slave_configs[i-1][2]);
		spi_append(slave_configs[i-1][3]);
		spi_append(slave_configs[i-1][4]);
		spi_append(slave_configs[i-1][5]);
		spi_pec();
	}
	RESET(SLAVECS);
	spi_start_transfer();
}

void slave_start_diag(void)
{
	slave_build_command(SLAVE_CMD_DIAG);
	RESET(SLAVECS);
	spi_start_transfer();
	slave_adc_time = SLAVE_WAIT_DIAG;
}

void slave_read_diag(void)
{
	slave_build_command(SLAVE_CMD_READ_DIAG);
	spi_buffer_size += 3 * NUMSLAVES; // 2 data + 1 pec
	RESET(SLAVECS);
	spi_start_transfer();
}

void slave_start_cell_conv(char what)
{
	if( what == 0 )
		what = SLAVE_CMD_CONV_CELLS;
	slave_build_command(what);
	RESET(SLAVECS);
	spi_start_transfer();
	slave_adc_time = SLAVE_WAIT_CELL_MEASURE;
}

void slave_start_temp_conv(void)
{
	slave_build_command(SLAVE_CMD_CONV_TEMP);
	RESET(SLAVECS);
	spi_start_transfer();
	slave_adc_time = SLAVE_WAIT_TEMP_MEASURE;
}

void slave_read_temp(void)
{
	slave_build_command(SLAVE_CMD_READ_TEMP);
	spi_buffer_size += 6 * NUMSLAVES; // 5 data + 1 pec
	RESET(SLAVECS);
	spi_start_transfer();
}

void slave_read_flags(void)
{
	slave_build_command(SLAVE_CMD_READ_FLAGS);
	spi_buffer_size += 4 * NUMSLAVES; // 3 data + 1 pec
	RESET(SLAVECS);
	spi_start_transfer();
}

void slave_read_cellvoltages(void)
{
	slave_build_command(SLAVE_CMD_READ_VOLTAGES);
	spi_buffer_size += 19 * NUMSLAVES; // 18 data + 1 pec
	RESET(SLAVECS);
	spi_start_transfer();
}

void slave_read_config(void)
{
	slave_build_command(SLAVE_CMD_READ_CONFIG);
	spi_buffer_size += 7 * NUMSLAVES; // 6 data + 1 pec
	RESET(SLAVECS);
	spi_start_transfer();
}

static inline unsigned char slave_spi_loop(void)
{
	static unsigned char stmp = 0;
	static char etmp[9];
	static unsigned char verified_ok;
	
	if( spi_idle() )
	{
		if( slave_state == 0 )
		{
			for(i=0; i<NUMSLAVES ;i++)
			{
				slave_configs[i][0] = SLAVE_DEFAULT_CONFIG | (stmp << 5);
				slave_configs[i][1] = 0;
				slave_configs[i][2] = 0;
				slave_configs[i][3] = 0;
				slave_configs[i][4] = 0;
				slave_configs[i][5] = 0;
			}
			
			if( (++stmp) == 4 )
			{
				stmp = 0;
			}
			
			if( battery_state & STATE_BALANCING )
				balancing_set();
			
			slave_errors = 0;
			slave_write_config();
			slave_state = 10;
			return 1;
		}
		else if( slave_state == 10 )
		{
			slave_errors = 0;
			slave_read_config();
			slave_state = 15;
		}
		else if( slave_state == 20 )
		{
			slave_errors = 0;
			slave_start_cell_conv(0);
			slave_state = 25;
			return 1;
		}
		else if( slave_state == 30 )
		{
			slave_errors = 0;
			slave_start_temp_conv();
			slave_state = 35;
			return 1;
		}
	}
	else if( spi_done() )
	{
		if(! slave_adc_active() )
		{
			if( slave_parse_command() )
			{
				if( slave_state == 15 )
				{
					//TOGGLE(LED_R);
					verified_ok = 1;
					
					for(i=0; i<NUMSLAVES ;i++)
					{
						// check if WDTB is high and CDC is set to 1
						if( (slave_read_configs[i][0] & 0x81) != 0x81 )
						{
							verified_ok = 0;
						}
					}
					
					if( verified_ok )
					{
						slave_state = 20;
					}
					else
					{
						// debug
						sprintf(etmp, "%02x %02x %02d", slave_configs[i][0], slave_read_configs[i][0], i);
						status(etmp);
						
						// end debug
						if( (verify_errors++) > SLAVE_MAX_ERRORS )
						{
							sprintf(etmp, "SL VC %02d", i);
							error(etmp);
							return 1;
						}
						else
						{
							slave_state = 0;
						}
					}
				}
				else if( slave_state == 25 )
				{
					slave_state = 30;
				}
				else if( slave_state == 35 )
				{
					slave_state = 100;
				}
				return 1;
			}
		}
	}
	return 0;
}

// this variable is used often
volatile unsigned char current_id = 0;

// time (in ms) spent in over/undervoltage
volatile unsigned int slave_uv_time;
volatile unsigned int slave_ov_time;
// helper for uv/ov detection
volatile unsigned char slave_uv_detected = 0;
volatile unsigned char slave_ov_detected = 0;
// min/max/avg variables
volatile unsigned int slave_max_cell_volt = 0;
volatile unsigned char slave_max_cell = 0;
volatile unsigned int slave_min_cell_volt = 0xFFFF;
volatile unsigned char slave_min_cell = 0;
volatile unsigned int slave_avg_cell_volt = 0;
// temporary variables
static uint32_t slave_avg_tmp = 0;
volatile unsigned int slave_max_cell_volt_tmp = 0;
volatile unsigned char slave_max_cell_tmp = 0;
volatile unsigned int slave_min_cell_volt_tmp = 0xFFFF;
volatile unsigned char slave_min_cell_tmp = 0;

static inline void slave_check_cell_voltages_init(void)
{
	// reset all variables for the next step
	current_id = 0;
	slave_uv_detected = 0;
	slave_ov_detected = 0;
	slave_avg_tmp = 0;
	slave_min_cell_volt_tmp = 0xFFFF;
	slave_min_cell_tmp = 0;
	slave_max_cell_volt_tmp = 0;
	slave_max_cell_tmp = 0;
}

static inline void slave_check_cell_voltages(void)
{
	slave_avg_tmp += cell_voltages[current_id];
	
	if( cell_voltages[current_id] < slave_min_cell_volt_tmp )
	{
		slave_min_cell_volt_tmp = cell_voltages[current_id];
		slave_min_cell_tmp = current_id;
	}
	
	if( cell_voltages[current_id] > slave_max_cell_volt_tmp )
	{
		slave_max_cell_volt_tmp = cell_voltages[current_id];
		slave_max_cell_tmp = current_id;
	}
	
	// maximum voltage cutoff
	if( cell_voltages[current_id] > SLAVE_VOLTAGE_MAX )
	{
		slave_ov_detected = 1;
		if( slave_ov_time == 0 )
			slave_ov_time = 1;
		else if( slave_ov_time > SLAVE_OV_TIME )
		{
			sprintf(etmp, "OV  %04d", current_id + 1);
			error(etmp);
		}
	}
	
	if( cell_voltages[current_id] < SLAVE_VOLTAGE_WARN )
	{
		if( (battery_state & STATE_WARNING) == 0 )
		{
			sprintf(etmp, "WRNUV%03d", current_id);
			status(etmp);
		}
		warning_time(SLAVE_VOLTAGE_WARN_TIME);
	}
	
	// minimum voltage cutoff
	if( cell_voltages[current_id] < SLAVE_VOLTAGE_MIN && (battery_state & STATE_TRACTIVE) )
	{
		slave_uv_detected = 1;
		if( slave_uv_time == 0 )
		{
			slave_uv_time = 1;
			current_id++;
			mcan_send_message(CAN_VOLTAGE_WARN, 1, (char *)&current_id);
			current_id--;
		}
		else if( slave_uv_time > SLAVE_UV_TIME )
		{
			sprintf(etmp, "UV  %04d", current_id + 1);
			error(etmp);
		}
	}
	
	current_id++;
	if( current_id == NUMCELLS )
	{
		slave_state = 210;
		
		slave_max_cell = slave_max_cell_tmp;
		slave_max_cell_volt = slave_max_cell_volt_tmp;
		slave_min_cell = slave_min_cell_tmp;
		slave_min_cell_volt = slave_min_cell_volt_tmp;
		slave_avg_tmp /= NUMCELLS;
		slave_avg_cell_volt = slave_avg_tmp;
		
		if( slave_ov_detected == 0 )
		{
			slave_ov_time = 0;
		}
		
		if( slave_uv_detected == 0 )
		{
			slave_uv_time = 0;
		}
	}
}


// helper
volatile unsigned char slave_ot_detected = 0;
volatile unsigned int slave_ot_time;
// temp min/max/avg
volatile unsigned int slave_max_temp_val = 0;
volatile unsigned char slave_max_temp = 0;
volatile unsigned int slave_min_temp_val = 0xFF;
volatile unsigned char slave_min_temp = 0;
volatile unsigned int slave_avg_temp_val = 0;
// temporary variables
volatile unsigned int slave_max_temp_val_tmp = 0;
volatile unsigned char slave_max_temp_tmp = 0;
volatile unsigned int slave_min_temp_val_tmp = 0xFF;
volatile unsigned char slave_min_temp_tmp = 0;

static inline void slave_check_temps_init(void)
{
	// reset all variables for the next step
	current_id = 0;
	slave_ot_detected = 0;
	slave_avg_tmp = 0;
	slave_min_temp_val_tmp = 0xFF;
	slave_min_temp_tmp = 0;
	slave_max_temp_val_tmp = 0;
	slave_max_temp_tmp = 0;
}

static inline void slave_check_temps(void)
{
	slave_avg_tmp += cell_temps[current_id];
	
	if( cell_temps[current_id] < slave_min_temp_val_tmp )
	{
		slave_min_temp_val_tmp = cell_temps[current_id];
		slave_min_temp_tmp = current_id;
	}
	
	if( cell_temps[current_id] > slave_max_temp_val_tmp )
	{
		slave_max_temp_val_tmp = cell_temps[current_id];
		slave_max_temp_tmp = current_id;
	}
	
	if( cell_temps[current_id] > SLAVE_TEMPERATURE_MAX )
	{
		slave_ot_detected = 1;
		if( slave_ot_time == 0 )
			slave_ot_time = 1;
		else if( slave_ot_time > SLAVE_OT_TIME )
		{
			sprintf(etmp, "OT  %04d", current_id + 1);
			error(etmp);
		}
	}
	
	if( cell_temps[current_id] > SLAVE_TEMPERATURE_WARN )
	{
		if( (battery_state & STATE_WARNING) == 0 )
		{
			sprintf(etmp, "WRNOT%03d", current_id);
			status(etmp);
		}
		warning_time(SLAVE_TEMPERATURE_WARN_TIME);
	}
	
	current_id++;
	if( current_id == NUMTEMPS )
	{
		slave_state = 250;
		
		slave_max_temp = slave_max_temp_tmp;
		slave_max_temp_val = slave_max_temp_val_tmp;
		slave_min_temp = slave_min_temp_tmp;
		slave_min_temp_val = slave_min_temp_val_tmp;
		slave_avg_tmp /= NUMTEMPS;
		slave_avg_temp_val = slave_avg_tmp;
		
		if( slave_ot_detected == 0 )
		{
			slave_ot_time = 0;
		}
	}
}

unsigned char slave_loop(void)
{
	static unsigned char current_id = 0;
	
	if( slave_state < 100 )
	{
		return slave_spi_loop();
	}
	else if( slave_state == 100 )
	{
		if( slave_get_gpio(i) == 2 )
		{
			// calculate temperatues for each cell
			cell_temps[current_id] = slave_tempfromadc(cell_temps_raw[current_id]);
			current_id++;
		}
		else
		{
			current_id = 0;
			slave_state = 150;
		}
		
		if( current_id == NUMTEMPS )
		{
			current_id = 0;
			slave_state = 150;
		}
	}
	else if( slave_state == 150 )
	{
		static uint32_t temp32_tmp;
		// calculate full stack measurements
		// k = R2 / (R1+R2)
		// U2 = (A - 512) * 1.5
		// U2 = (U * R2) / (R1 + R2)
		// U2 * 352500 = U * 22500
		// (A - 512) * 1.5 * 352500 / 22500 = U
		// U = (A - 512) * 528750 / 22500
		// U = (A - 512) * 23,5
		// U = (A - 512) * 235 / 10
		temp32_tmp = slave_fsm_raw[current_id];
		temp32_tmp -= 512;
		temp32_tmp *= 258;
		temp32_tmp /= 10;
		slave_fsm[current_id] = temp32_tmp;
		current_id++;
		
		if( current_id == NUMSLAVES )
		{
			slave_state = 160;
			batt_fsm_volt = 0;
			current_id = 0;
		}
	}
	else if( slave_state == 160 )
	{
		batt_fsm_volt += slave_fsm[current_id];
		current_id++;
		if( current_id == NUMSLAVES )
		{
			// all measured data is now in a usable format
			slave_state = 170;
			current_id = 0;
		}
	}
	else if( slave_state == 170 )
	{
		batt_fsm_volt_copy = batt_fsm_volt;
		slave_state = 200;
		
		slave_check_cell_voltages_init();
	}
	else if( slave_state == 200 )
	{
		slave_check_cell_voltages();
	}
	else if( slave_state == 210 )
	{
		slave_check_temps_init();
		slave_state = 220;
	}
	else if( slave_state == 220 )
	{
		slave_check_temps();
	}
	else if( slave_state == 250 )
	{
#ifdef CAN_MEASURE_CYCLE_MS
		mcan_send_message(CAN_MEASURE_CYCLE_MS, 2, (char*)&slave_cycle_ms);
#endif
		if( slave_cycle_ms > SLAVE_STATUS_CYCLE_LENGTH )
		{
			sprintf(etmp, "CYC %04d", slave_cycle_ms);
			status(etmp);
		}
		slave_cycle_ms = 0;
		slave_state = 0;
		verify_errors = 0;
		can_send_data = 1;
		//TOGGLE(LED_B);
	}
	return 0;
}

// return value
// 0 -> nothing happened, continue calling slave_parse_command until 1 returned
// 1 -> this step is done, do next step
unsigned char slave_parse_command(void)
{
	static unsigned char tmp, i;
	static char etmp[9];
	
	SET(SLAVECS);
	_delay_us(500);
	spi_status = SPI_IDLE;
	
	switch(slave_sent_cmd)
	{
		case SLAVE_CMD_WRITE_CONFIG:
		{
			return 1;
		}
		break;
		case SLAVE_CMD_READ_CONFIG:
		{
			j = 2;
			
			for(i=0; i<NUMSLAVES ;i++)
			{
				reset_pec();
				update_pec(spi_buffer[j++]);
				update_pec(spi_buffer[j++]);
				update_pec(spi_buffer[j++]);
				update_pec(spi_buffer[j++]);
				update_pec(spi_buffer[j++]);
				update_pec(spi_buffer[j++]);
				// check for errors
				if( spi_buffer[j++] != pec )
				{
					// fatal error! pec failed
					if( (++slave_errors) > SLAVE_MAX_ERRORS )
					{
						sprintf(etmp, "SE R %03d", i);
						error(etmp);
						return 1;
					}
					else
					{
						slave_read_config();
						return 0;
					}
				}
				else
				{
					j -= 7;
					slave_read_configs[i][0] = spi_buffer[j++];
					slave_read_configs[i][1] = spi_buffer[j++];
					slave_read_configs[i][2] = spi_buffer[j++];
					slave_read_configs[i][3] = spi_buffer[j++];
					slave_read_configs[i][4] = spi_buffer[j++];
					slave_read_configs[i][5] = spi_buffer[j++];
					j++;
				}
			}
			slave_errors = 0;
			return 1;
		}
		break;
		case SLAVE_CMD_DIAG:
		{
			slave_read_diag();
			return 0;
		}
		break;
		case SLAVE_CMD_READ_DIAG:
		{
			j = 2;
			for(i=0; i<NUMSLAVES ;i++)
			{
				reset_pec();
				update_pec(spi_buffer[j++]);
				update_pec(spi_buffer[j++]);
				// check for errors
				if( spi_buffer[j++] != pec )
				{
					// fatal error! pec failed
					if( (++slave_errors) > SLAVE_MAX_ERRORS )
					{
						sprintf(etmp, "SE D %03d", i);
						error(etmp);
						return 1;
					}
					else
					{
						slave_read_diag();
						return 0;
					}
				}
				else
				{
					j -= 3;
					slave_diags[i][0] = spi_buffer[j++];
					slave_diags[i][1] = spi_buffer[j++];
					j++;
				}
			}
			slave_errors = 0;
			return 1;
		}
		break;
/*		case SLAVE_CMD_READ_FLAGS:
		{
			j = 2;
			for(i=0; i<NUMSLAVES ;i++)
			{
				reset_pec();
				update_pec(spi_buffer[j++]);
				update_pec(spi_buffer[j++]);
				update_pec(spi_buffer[j++]);
				// check for errors
				if( spi_buffer[j++] != pec )
				{
					// fatal error! pec failed
					if( (++slave_errors) > SLAVE_MAX_ERRORS )
					{
					 * sprintf(etmp, "SE F %03d", i);
						error(etmp);
						return 1;
					}
					else
					{
						slave_read_flags();
						return 0;
					}
				}
				else
				{
					j -= 4;
					slave_ouv[i] = spi_buffer[j++];
					slave_ouv[i] |= (uint32_t)spi_buffer[j++] << 8;
					slave_ouv[i] |= (uint32_t)spi_buffer[j++] << 16;
					j++;
				}
			}
			slave_errors = 0;
			return 1;
		}
		break;*/
		case SLAVE_CMD_CONV_CELLS:
		case SLAVE_CMD_OWCONV_CELLS:
		{
			slave_read_cellvoltages();
			return 0;
		}
		break;
		case SLAVE_CMD_READ_VOLTAGES:
		{
			j = 2;
			tmp = 0;
			for(i=0; i<NUMSLAVES ;i++)
			{
				reset_pec();
				update_pec(spi_buffer[j++]);
				update_pec(spi_buffer[j++]);
				update_pec(spi_buffer[j++]);
				update_pec(spi_buffer[j++]);
				update_pec(spi_buffer[j++]);
				update_pec(spi_buffer[j++]);
				update_pec(spi_buffer[j++]);
				update_pec(spi_buffer[j++]);
				update_pec(spi_buffer[j++]);
				update_pec(spi_buffer[j++]);
				update_pec(spi_buffer[j++]);
				update_pec(spi_buffer[j++]);
				update_pec(spi_buffer[j++]);
				update_pec(spi_buffer[j++]);
				update_pec(spi_buffer[j++]);
				update_pec(spi_buffer[j++]);
				update_pec(spi_buffer[j++]);
				update_pec(spi_buffer[j++]);
				// check for errors
				if( spi_buffer[j++] != pec )
				{
					// fatal error! pec failed
					if( (++slave_errors) > SLAVE_MAX_ERRORS )
					{
						sprintf(etmp, "SE V %03d", i);
						error(etmp);
						return 1;
					}
					else
					{
						slave_read_cellvoltages();
						return 0;
					}
				}
				else
				{
					j -= 19;
					
					cell_voltages[tmp++] = (spi_buffer[j] | ((spi_buffer[j+1] & 0x0F) << 8));
					cell_voltages[tmp++] = (((spi_buffer[j+1] >> 4) & 0x0F) | (spi_buffer[j+2] << 4));
					
					cell_voltages[tmp++] = (spi_buffer[j+3] | ((spi_buffer[j+4] & 0x0F) << 8));
					cell_voltages[tmp++] = (((spi_buffer[j+4] >> 4) & 0x0F) | (spi_buffer[j+5] << 4));
					
					cell_voltages[tmp++] = (spi_buffer[j+6] | ((spi_buffer[j+7] & 0x0F) << 8));
					cell_voltages[tmp++] = (((spi_buffer[j+7] >> 4) & 0x0F) | (spi_buffer[j+8] << 4));
					
					cell_voltages[tmp++] = (spi_buffer[j+9] | ((spi_buffer[j+10] & 0x0F) << 8));
					cell_voltages[tmp++] = (((spi_buffer[j+10] >> 4) & 0x0F) | (spi_buffer[j+11] << 4));
					
					cell_voltages[tmp++] = (spi_buffer[j+12] | ((spi_buffer[j+13] & 0x0F) << 8));
					cell_voltages[tmp++] = (((spi_buffer[j+13] >> 4) & 0x0F) | (spi_buffer[j+14] << 4));
					
					cell_voltages[tmp++] = (spi_buffer[j+15] | ((spi_buffer[j+16] & 0x0F) << 8));
					cell_voltages[tmp++] = (((spi_buffer[j+16] >> 4) & 0x0F) | (spi_buffer[j+17] << 4));
					j += 19;
				}
			}
			slave_errors = 0;
			return 1;
		}
		break;
		case SLAVE_CMD_CONV_TEMP:
		{
			slave_read_temp();
			return 0;
		}
		break;
		case SLAVE_CMD_READ_TEMP:
		{
			j = 2;
			for(i=0; i<NUMSLAVES ;i++)
			{
				reset_pec();
				update_pec(spi_buffer[j++]);
				update_pec(spi_buffer[j++]);
				update_pec(spi_buffer[j++]);
				update_pec(spi_buffer[j++]);
				update_pec(spi_buffer[j++]);
				// check for errors
				if( spi_buffer[j++] != pec )
				{
					// fatal error! pec failed
					if( (++slave_errors) > SLAVE_MAX_ERRORS )
					{
						sprintf(etmp, "SE T %03d", i);
						error(etmp);
						return 1;
					}
					else
					{
						slave_read_temp();
						return 0;
					}
				}
				else
				{
					j -= 6;
					
					if( slave_get_gpio(i) == 0 )
					{
						tmp = (i * 6);
						cell_temps_raw[tmp+4] = spi_buffer[j+0] | ((spi_buffer[j+1] & 0x0F) << 8);
						cell_temps_raw[tmp+2] = ((spi_buffer[j+1] & 0xF0) >> 4) | (spi_buffer[j+2] << 4);
					}
					else if( slave_get_gpio(i) == 1 )
					{
						tmp = (i * 6);
						cell_temps_raw[tmp+5] = spi_buffer[j+0] | ((spi_buffer[j+1] & 0x0F) << 8);
						cell_temps_raw[tmp] = ((spi_buffer[j+1] & 0xF0) >> 4) | (spi_buffer[j+2] << 4);
					}
					else if( slave_get_gpio(i) == 2 )
					{
						tmp = (i * 6);
						cell_temps_raw[tmp+3] = spi_buffer[j+0] | ((spi_buffer[j+1] & 0x0F) << 8);
						cell_temps_raw[tmp+1] = ((spi_buffer[j+1] & 0xF0) >> 4) | (spi_buffer[j+2] << 4);
					}
					else if( slave_get_gpio(i) == 3 )
					{
						slave_fsm_raw[i] = spi_buffer[j+0] | ((spi_buffer[j+1] & 0x0F) << 8);
					}
					
					ltc_temps[i] = spi_buffer[j+3] | ((spi_buffer[j+4] & 0x0F) << 8);
					j += 6;
				}
			}
			slave_errors = 0;
			
			return 1;
		}
		break;
		default:
		{
			// FATAL ERROR!
			error("SL UNKOW");
			return 1;
		}
		break;
	}
	return 0;
}
