funkobongrip/sprbms/code/canslave/src/ntc.c

#include "main.h"

// from NTCCalc for B=3480
const uint8_t ntc_vals[1024] = {
		255,
		255,
		255,
		255,
		255,
		255,
		255,
		255,
		255,
		255,
		255,
		255,
		255,
		255,
		255,
		255,
		255,
		255,
		255,
		255,
		255,
		255,
		255,
		255,
		255,
		255,
		255,
		255,
		255,
		255,
		255,
		255,
		255,
		255,
		255,
		255,
		255,
		255,
		255,
		255,
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
};
