funkobongrip/sprbms/(commit log)

2013-05-31 Initial Commit from SPR Master Directory
    [masterV05a.brd, masterV05a.sch, master_carconnector.brd, master_carconnector.sch, slaveV10a.brd, slaveV10a.sch, slaveV11.brd, slaveV11.sch]
2016-02-18 Added canslave and next generation master idea based on TMS570
    [bms_master_V01.brd, bms_master_V01.sch, canSlaveV01a0.brd, canSlaveV01a0.sch, canSlaveV02_16s.brd, canSlaveV02_16s.sch, canSlaveV02_8s.brd, canSlaveV02_8s.sch]
