funkobongrip/sprbms/(notices)

Notices in the files:
hardware/spi/slave/slaveV11.brd:
Copyright: David Brandt
hardware/spi/slave/slaveV11.sch:
exercise by You of the rights granted under this License;
You of the rights granted under this License if Your exercise of
by You of the rights granted under this License that is for a
from You under this License, however, will not have their licenses
Work under different license terms or to stop distributing the Work at
required to be, granted under the terms of this License), and this
terms and conditions as the license granted to You under this License.
and the Universal Copyright Convention (as revised on July 24, 1971).
includes additional rights not granted under this License, such
Creative Commons Notice
Creative Commons is not a party to this License, and makes no warranty
whatsoever in connection with the Work. Creative Commons will not be
Work is licensed under the CCPL, Creative Commons does not authorize
the use by either party of the trademark "Creative Commons" or any
related trademark or logo of Creative Commons without the prior
written consent of Creative Commons. Any permitted use will be in
compliance with Creative Commons' then-current trademark usage
Creative Commons may be contacted at http://creativecommons.org/.
hardware/spi/master/masterV05a.brd:
Full License: http://creativecommons.org/licenses/by-nc-sa/3.0/ or on Page 9 of Schematic
hardware/can/canSlaveV04.brd:
canSlaveV04 - CC BY-NC-SA 2.0
parts and their libraries:
microbuilder: This work is placed in the public domain, and may be freely used for commercial and non-commercial work with the following conditions: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
EagleLibrary_Wuerth_Elektronik_eiSos_Ver: Copyright: Würth Elektronik
